reprapperMC/kangaroopaw/production_parts/electronics/chassis_assembly/AS-CB0082_revB_chassis_gnd_extension.pdf

TITLE

FILE NAME | SHEET | REV.

# Chassis GND Extension

Copyright © 2015, 2016 Aleph Objects, Inc.
Permission is granted to copy, distribute and/or modify this document under the terms of the Creative Commons Attribution 4.0 International Public License (CC BY-SA 4.0).

# Hibiscus

DRAWN BY DRAWN BY SAW | DATE 03/01/2018
CHECKED BY | DATE

12

4

14

13

## Length = 100mm

IR

Strip 5mm | Strip 4mm
AS-CB0082 | AS-CB0082_revB_chassis_gnd_extension.odg | 1

### 2x [EL-MS0141]

Term Ring Non Ins 26-22AWG #4 | 2x [EL-WR0119] – 24awg Green Wire
Strip 5mm | Strip 4mm

### 1x [PC-CN0001] Female 2pin Housing

### 2x [EL-MS0059] Female Molex Pin
