reprapperMC/kangaroopaw/production_parts/tool_head/electronics/EL-HR0190_syringe_pump_harness.pdf

TITLE

FILE NAME | SHEET | REV.

Syringe pump harness

Copyright © 2019 Aleph Objects, Inc.
Permission is granted to copy, distribute and/or modify this document under the terms of the Creative Commons Attribution 4.0 International Public License (CC BY-SA 4.0).
IR EL-HR0190_syringe_pump_harness.odg | 1

6x
[EL-MS0480]
CONN TERM MALE
20-24AWG TIN
(Micro-Fit 3.0™)

1x [PC-CN0101]
Molex-CONN PLUG 20POS
3MM VERT DUAL, BLACK

1 11

2

3 | 13
4 | 14
5 | 15
6 | 16
7 | 17
8 | 18

Pin 1

12

| 9 | 19
Length = 110mm | 10 | 20

Pin 4

Strip 2.5mm | [EL-WR0103] – 24awg Red Wire

[EL-WR0105] – 24awg Black Wire

Strip 3mm

Pin 6

[EL-WR0107] – 24awg White Wire

[EL-WR0119] – 24awg Green Wire
Pin 3

Pin 1

Pin 11

Pin 1

Pin 12

Pin 2

4x [EL-MS0564]
Molex, Conn Socket, 24-30AWG Crimp, Tin

kangaroopaw

DRAWN BY DRAWN BY Tutley | DATE 07/02/2019
CHECKED BY | DATE
Rev | Date | Changes | Change by

EL-HR0190

Pin 10
Pin 20

2x [EL-MS0142]
Conn Recept Faston 22-26AWG

Length = 205mm
Strip 6mm | Strip 3mm

1x [EL-MS0563]
Molex, Connector Receptacle, 6 position

2x [EL-WR0120] – 24awg Purple Wire

AO P/n | qty | unit | Supplier | supplier P/n
EL-WR0120 | 410 | mm | allcable allcable | HU1569247VT HU1569247RD
EL-WR0103 | 110 | mm
EL-WR0107 | 110 | mm | allcable allcable | HU1569247WE
EL-WR0119 | 110 | mm | | HU1569247GN
EL-WR0105 | 110 | mm | allcable | HU1569247BK
EL-MS0142 | 2 | pce | TTI | 7-520365-2
EL-MS0563 | 1 | pce | DigiKey Corp | 0510650600
EL-MS0564 | 4 | pce | DigiKey Corp | 0502128000
EL-MS0480 | 6 | pce | TTI | 43031-0001
PC-CN0101 | 1 | pce | TTI | 43020-2001
