reprapperMC/kangaroopaw/production_docs/BoM_7.8.19_purchasing_review.ods

Product Reference | Product Name | Quantity | Unit of Measure | BoM Reference | Manufacturer | Manufacturer Ref. | Distributor | Distributor Ref. | Distr. UOM | Price per Unit | Price per BoM Qty
AS-CB0069 | [AS-CB0069] Z brake power harness | 1 | PCE |  |  |  | CCX Corp.(DO NOT USE) |  | PCE | 15.00 USD/PCE | 15.00 USD
AS-CB0070 | [AS-CB0070] Z brake motor harness- Hibiscus | 1 | PCE |  |  |  | CCX Corp.(DO NOT USE) |  | PCE | 10.00 USD/PCE | 10.00 USD
AS-CB0071 | [AS-CB0071] Bed Harnesses- Hibiscus | 1 | PCE
AS-CB0072 | [AS-CB0072] YZ Harness- Hibiscus | 1 | PCE |  |  |  | CCX Corp.(DO NOT USE) |  | PCE | 30.00 USD/PCE | 30.00 USD
AS-CB0073 | [AS-CB0073] Mini Plug to SW Extension Harness Assembly - Hibiscus | 1 | PCE |  |  |  | CCX Corp.(DO NOT USE) |  | PCE | 40.00 USD/PCE | 40.00 USD
AS-CB0074 | [AS-CB0074] Mini PS to EinsyRetro Red Wire | 2 | PCE |  |  |  | CCX Corp.(DO NOT USE) |  | PCE | 30.00 USD/PCE | 60.00 USD
AS-CB0075 | [AS-CB0075] Earth Ground Extension Wire Harness- Hibiscus | 1 | PCE |  |  |  | CCX Corp.(DO NOT USE) |  | PCE | 10.00 USD/PCE | 10.00 USD
AS-CB0076 | [AS-CB0076] Mini SW to PS - Black Wire Extension Harness Assembly - Hibiscus | 1 | PCE |  |  |  | CCX Corp.(DO NOT USE) |  | PCE | 10.00 USD/PCE | 10.00 USD
AS-CB0077 | [AS-CB0077] Mini SW to PS - White Wire Extension Harness Assembly – Hibiscus | 1 | PCE |  |  |  | CCX Corp.(DO NOT USE) |  | PCE | 10.00 USD/PCE | 10.00 USD
AS-CB0078 | [AS-CB0078] Case Fan Harness- Hibiscus | 1 | PCE |  | Yageo | CC1206JKX7R7BB105
AS-CB0079 | [AS-CB0079] Plug to Ground Post Extension- Hibiscus | 1 | PCE |  |  |  | CCX Corp.(DO NOT USE) |  | PCE | 10.00 USD/PCE | 10.00 USD
AS-CB0080 | [AS-CB0080] PS to Ground Post Extension- Hibiscus | 1 | PCE |  |  |  | CCX Corp.(DO NOT USE) |  | PCE | 10.00 USD/PCE | 10.00 USD
AS-CB0081 | [AS-CB0081] Mini PS to EinsyRetro Black Wire | 2 | PCE |  |  |  | CCX Corp.(DO NOT USE) |  | PCE | 10.00 USD/PCE | 20.00 USD
AS-CB0082 | [AS-CB0082] Chassis Ground Extension Wire Harness | 1 | PCE |  |  |  | CCX Corp.(DO NOT USE) |  | PCE | 10.00 USD/PCE | 10.00 USD
AS-EL0003 | [AS-EL0003] Z-Motor Brake Assembled | 1 | PCE
AS-HB0005 | [AS-HB0005] Mini Etched Modular Print Bed Heater | 1 | PCE |  |  |  | TEMPCO ELECTRIC HEATER CORP | SHS80986 | PCE | 28.35 USD/PCE | 28.35 USD
DC-LB0063 | [DC-LB0063] Modification Warning Insert Modification 2.75 x 8.5 on 100 lb. Astrobright Lift Off Lemon Very Bright | 1 | PCE |  |  |  | Coren Printing Inc. |  | PCE | 0.09 USD/PCE | 0.09 USD
DC-LB0095 | [DC-LB0095] LulzBot Logo Sticker, 3 - Inch | 1 | PCE |  |  |  | Sticker Giant |  | PCE | 0.25 USD/PCE | 0.25 USD
DC-LB0121 | [DC-LB0121] Save your Mini Packaging Sticker | 1 | PCE |  | MaverickLabel |  | MaverickLabel |  | PCE | 0.09 USD/PCE | 0.09 USD
DC-LB0146 | [DC-LB0146] Mini 2 Certification Sticker | 1 | PCE |  |  |  | MyAssetTag.com | Q-MAT-P-00337 | PCE | 5.38 USD/PCE | 5.38 USD
DC-LB0150 | [DC-LB0150] Mini 2 NA Serial Number Sticker, Tamper Evident | 1 | PCE
DC-LB0153 | [DC-LB0153] Electrical Symbol Labels-On-A-Roll - Protective Earth | 1 | PCE |  |  |  | SETON | 78082 | pkg, 500 | 0.13 USD/PCE | 0.13 USD
DC-LB0156 | [DC-LB0156] Mini 2 Electric Warning Sticker | 1 | PCE
DC-LB0174 | [DC-LB0174] P65 Warning Label | 1 | PCE |  |  |  | Amazon | B07G4KF2P2 | PCE | 13.29 USD/PCE | 13.29 USD
DC-MS0066 | [DC-MS0066] Quick Start Quide, Mini 2 | 1 | PCE |  |  |  | Color Pro |  | PCE | 2.13 USD/PCE | 2.13 USD
DC-MS0069 | [DC-MS0069] EC Declaration of Conformity, Mini 2 | 1 | PCE |  |  |  | Coren Printing Inc. |  | PCE | 0.19 USD/PCE | 0.19 USD
DC-MS0070 | [DC-MS0070] Packing List, Mini 2 | 1 | PCE |  |  |  | Coren Printing Inc. |  | PCE | 0.19 USD/PCE | 0.19 USD
DC-MS0071 | [DC-MS0071] Quality Assurance Record, Mini 2 | 1 | PCE |  |  |  | Coren Printing Inc. |  | PCE | 0.31 USD/PCE | 0.31 USD
DC-MS0072 | [DC-MS0072] Safety Warning Sheet, Mini 2 | 1 | PCE |  |  |  | Coren Printing Inc. |  | PCE | 0.11 USD/PCE | 0.11 USD
EL-CA0030 | [EL-CA0030] North American - 6ft 18AWG Power Cord Cable w/ 3 Conductor PC Power Connector Socket (C13/5-15P) - Black, 5279 | 1 | PCE |  |  | 3271V86 | Linvox | 3271V86 | PCE | 1.33 USD/PCE | 1.33 USD
EL-CA0063 | [EL-CA0063] 6ft Tripp Lite - USB 2.0 A/B Gold Device Cable Ferrite Chokes A Male B Male | 1 | PCE |  |  | U023-006 | Electronics Distributors Corp. | U023-006 | PCE | 3.21 USD/PCE | 3.21 USD
EL-CA0078 | rainbow ribbon cable | 620 | mm | May need to add 150mm for noise supression
EL-FA0045 | [EL-FA0045] Pelonis FAN 80x80x15 High flow | 1 | PCE |  | Pelonis Technologies, Inc. | C8015H24BPLP1b-7 | Pelonis Technologies, Inc. | C8015H24BPLP1b-7 | PCE | 3.88 USD/PCE | 3.88 USD
EL-HR0102 | [EL-HR0102] Mini Bed Harness Assembly - revG | 1 | PCE |  | Igus, Inc. |  | Igus, Inc. |  | PCE | 29.58 USD/PCE | 29.58 USD
EL-HR0108 | [EL-HR0108] Mini X Extruder Harnesses Assembly - revG | 1 | PCE |  | Igus, Inc. |  | Igus, Inc. |  | PCE | 73.26 USD/PCE | 73.26 USD
EL-HR0109 | [EL-HR0109] Finger Guard 80mm Plastic | 1 | PCE |  | Qualtek | 09080-G | Digi-Key Corp | CR282-ND | PCE | 0.30 USD/PCE | 0.30 USD
EL-HR0130 | [EL-HR0130] Mini X Extruder Harnesses Assembly | 1 | PCE |  | Igus, Inc. |  | Igus, Inc. |  | PCE | 84.00 USD/PCE | 84.00 USD
EL-HR0135 | [EL-HR0135] Mini 2 Bed Harness Igus | 1 | PCE |  |  |  | Igus, Inc. |  | PCE | 32.00 USD/PCE | 32.00 USD
EL-HR0188 | ribbon cable1 | 1
EL-HR0189 | ribbon cable 2, split | 1
EL-HR0190 | Syringe pump Harness
EL-HR0191 | lcd ground cable | 1
EL-MS0059 | [EL-MS0059] Molex-CONN TERM FEMALE 22-24AWG TIN Reels of 20K | 29 | PCE |  | Molex | 16-02-0086 | TTI Global Distribution | 16-02-0086 | PCE | 0.02 USD/PCE | 0.03 USD
EL-MS0062 | [EL-MS0062] MOLEX-CONN HOUSING 4POS .100 W/LATCH | 5 | PCE |  |  | 050579404 | Sager Electronics | 050579404 | PCE | 0.06 USD/PCE | 0.12 USD
EL-MS0073 | [EL-MS0073] Tubing Corrugated Loom .25", Black, 3200' Box | 95 | cm |  |  | 88-00011 | Electronics Distributors Corp. | 88-00011 | ft, 200 | 0.00 USD/mm | 0.22 USD
EL-MS0141 | [EL-MS0141] Term Ring Non Ins 26-22AWG #4 Order Bulk Only | 12 | PCE |  | Panduit | P22-4R-M | TTI Global Distribution | P22-4R-M | PCE | 0.06 USD/PCE | 0.12 USD
EL-MS0142 | purple fast on connector | 2
EL-MS0143 | [EL-MS0143] Conn Fast Receptacle14-16 AWG .250 - REEL of 2200 Units | 7 | PCE |  | TE Amp | 3-350819-2 | TTI Global Distribution | 3-350820-2 | PCE | 0.07 USD/PCE | 0.28 USD
EL-MS0205 | [EL-MS0205] Molex-CONN TERM MALE 22-24AWG TIN - Reels of 20K | 2 | PCE |  | Molex | 16-02-0107 | TTI Global Distribution | 16-02-0107 | PCE | 0.02 USD/PCE | 0.04 USD
EL-MS0211 | [EL-MS0211] TE- REEL / RING TONGUE CONN 16-22 AWG #10 PIDG | 5 | PCE |  |  |  | Sager Electronics | 2-36154-2 | PCE | 0.09 USD/PCE | 0.09 USD
EL-MS0216 | [EL-MS0216] Steward-Ferrite Tubular Bead 19.00mm | 1 | PCE |  |  |  | Sager Electronics | 28B1142-100 | PCE | 0.30 USD/PCE | 0.30 USD
EL-MS0246 | [EL-MS0246] Conn Ring 16-22 AWG #4 Red PIDG - Reel 5000 | 1 | PCE |  | TE Connectivity | 2-323758-1 | TTI Global Distribution | 2-323758-1 | PCE | 0.41 USD/PCE | 0.41 USD
EL-MS0246 | [EL-MS0246] Conn Ring 16-22 AWG #4 Red PIDG - Reel 5000 | 1 | PCE |  | TE Connectivity | 2-323758-1 | TTI Global Distribution | 2-323758-1 | PCE | 0.41 USD/PCE | 0.41 USD
EL-MS0247 | [EL-MS0247] Heat Shrink Tubing – 0.19-0.09 – Black, 100' | 25 | mm |  | 3M | 88-01870 | Electronics Distributors Corp. | 88-01870 | PCE, 100' | 0.00 USD/mm | 0.02 USD
EL-MS0259 | [EL-MS0259] Heat Shrink DL WL Q53X 3/4" | 7 | cm |  | Qualtek | Q5-3X-3/4-01-QB48IN-5 | Electronics Distributors Corp. | 67-30751 | PCE ft, 4 | 0.00 USD/mm | 0.32 USD
EL-MS0343 | [EL-MS0343] Ferrite Tubular Bead 10.16MM | 1 | PCE |  | Laird Technologies | 28B0735-000 | Sager Electronics | 28B0735-000 | PCE | 0.26 USD/PCE | 0.26 USD
EL-MS0351 | [EL-MS0351] JST - CONN TERM CRIMP PH 24-30AWG - 8,000 Unit Reel | 12 | PCE |  | JST Sales America | SPH-002T-P0.5S | Future Electronics |  | PCE | 0.01 USD/PCE | 0.15 USD
EL-MS0355 | [EL-MS0355] CONN HOUSING PH 6POS 2MM WHITE | 3 | PCE |  | JST Sales America | PHR-6 | Future Electronics | PHR-6 | PCE | 0.04 USD/PCE | 0.12 USD
EL-MS0414 | [EL-MS0414] Cartridge Fuse 250V 3.15A Slo-Blo | 2 | PCE |  | Littelfuse | 02153.15MXP | TTI Global Distribution | 576-02153.15MXP | PCE | 0.39 USD/PCE | 0.77 USD
EL-MS0418 | 10 pos molex | 1
EL-MS0432 | [EL-MS0432] Clip-On EMI Shielding Gasket 150.876mm length | 1 | PCE |  | TECH-ETCH, Inc. | 187RF1C100-5.94-L-08 | Tech Etch AP | 187RF1C100-5.94-L-08 | PCE | 2.36 USD/PCE | 2.36 USD
EL-MS0434 | [EL-MS0434] Heat Shrink Tubing – 0.19-0.09 – Red, 250' | 25 | mm |  |  | 88-01872 | Electronics Distributors Corp. | 88-01872 | ft, 250 | 0.00 USD/mm | 0.02 USD
EL-MS0479 | [EL-MS0479] CONN TERM FEMALE 20-24AWG TIN (Micro-Fit 3.0™) 12K REEL | 16 | PCE |  | Molex | 43030-0001 | TTI Global Distribution | 43030-0001 | PCE | 0.02 USD/PCE | 0.27 USD
EL-MS0480 | molex microfit 3.0 male pin | 6
EL-MS0497 | [EL-MS0497] CONN SPADE TERM 16-22AWG #6 RED | 4 | PCE |  | TE Connectivity | 2-34541-1 | TTI Global Distribution | 2-34541-1 | PCE | 0.10 USD/PCE | 0.21 USD
EL-MS0502 | [EL-MS0502] CONN SPADE TERM 24-26AWG #6 YEL | 2 | PCE |  | TE Connectivity | 53115-2 | TTI Global Distribution | 53115-2 | PCE | 0.51 USD/PCE | 1.01 USD
EL-MS0559 | Lcd 4.3 inch | 1
EL-MS0563 | Molex, Connector Receptacle, 6 position | 1
EL-MS0564 | Molex, Conn Socket, 24-30AWG Crimp, Tin | 4
EL-MT0029 | [EL-MT0029] NEMA 17 Stepper Motor, Moons' - NOT INCLUDING wire harness | 4 | PCE |  |  | MS17HD6P4150-01-B | Moons' Industries (America), Inc. | MS17HD6P4150-01-B | PCE | 8.30 USD/PCE | 8.30 USD
EL-MT0063 | Nema 11 motor | 1 |  |  | needs replaced w/ kangaroopaw specific part
EL-PS0025 | [EL-PS0025] DELTA POWER SUP 150W 24V 6.25A PNL MT | 1 | PCE |  | Delta Electronics (Americas) Ltd. | PMC-24V150W1AA | Delta Electronics (Americas) Ltd. | PMC-24V150W1AA | PCE | 20.65 USD/PCE | 20.65 USD
EL-SW0022 | [EL-SW0022] SWITCH BASIC SPDT 3A .110QC 125V | 2 | PCE |  | Omron | SS-3GPT | TTI Global Distribution | SS-3GPT | PCE | 0.42 USD/PCE | 0.42 USD
EL-SW0049 | [EL-SW0049] Rocker Switch DPST 20A (AC) 125V Panel Mount, Snap-In | 1 | PCE |  | E Switch | R5BBLKREDFF2 | Heilind | R5BBLKREDFF2 | PCE | 1.45 USD/PCE | 1.45 USD
EL-WR0099 | [EL-WR0099] Shielded 22AWG UL2464 4 COND | 179.5 | cm |  |  |  | Allcable | C0762A.41.10 | ft, 1000 | 0.00 USD/mm | 0.10 USD
EL-WR0103 | [EL-WR0103] 24AWG Stranded – Red | 126 | cm |  |  |  | Allcable | HU1569247RD | ft, 1000 | 0.00 USD/mm | 0.01 USD
EL-WR0105 | [EL-WR0105] 24AWG Stranded – Black | 126 | cm |  |  |  | Allcable | HU1569247BK | ft, 1000 | 0.00 USD/mm | 0.01 USD
EL-WR0105 | Black 24 ga wire | ? | mm | need to figure out what mark wants to do here
EL-WR0106 | [EL-WR0106] 16AWG Stranded – Red | 20 | cm |  |  |  | Allcable | HU15691626RD | ft, 1000 | 0.00 USD/mm | 0.06 USD
EL-WR0107 | 24 ga white wire | 110 | mm
EL-WR0119 | [EL-WR0119] 24AWG Stranded Wire – Green | 150 | cm |  |  |  | Allcable | HU1569247GN | ft, 1000 | 0.00 USD/mm | 0.02 USD
EL-WR0120 | 24 ga purple wire | 410 | mm
EL-WR0121 | [EL-WR0121] 16AWG Stranded Wire – Black | 102 | cm |  |  |  | Allcable | HU15691626BK | ft, 1000 | 0.00 USD/mm | 0.16 USD
EL-WR0123 | [EL-WR0123] 16AWG Stranded Wire – White | 82 | cm |  |  |  | Allcable | HU15691626WE | ft, 1000 | 0.00 USD/mm | 0.16 USD
EL-WR0124 | [EL-WR0124] 16AWG Stranded – Green w/ yellow stripe | 130 | mm |  |  |  | Allcable | HU15691626GN | ft, 1000 | 0.00 USD/mm | 0.03 USD
HD-BL0033 | [HD-BL0033] 744-2P06-2MR-744-06 / GT 3 Single Sided Neoprene Belt - 744mm by 6mm belt | 4 | PCE |  |  |  | B & B Manufacturing, Inc | 744-2P06-2MR-744-06 | PCE | 2.06 USD/PCE | 2.06 USD
HD-BT0005 | M3x10mm SHCS black oxide | 3
HD-BT0012 | [HD-BT0012] M3 Set Screw (Grub Screw) | 6 | PCE |  |  | 40818 | Fastenal | 40818 | PCE | 0.03 USD/PCE | 0.05 USD
HD-BT0039 | [HD-BT0039] Metric Class 12.9 Socket Head Cap Screw, Alloy Steel, M3 Thread, 12MM Length, 0.50MM Pitch | 4 | PCE |  |  | 39505 | Hardware Speciality | DIN912-12.9-3-12 | PCE | 0.02 USD/PCE | 0.09 USD
HD-BT0082 | [HD-BT0082] Metric 18-8 SS Flat Head Socket Cap Screw M3 Size, 16mm Length, .50mm Pitch | 11 | PCE |  |  |  | Hardware Speciality | DIN7991A2-3-16 | PCE | 0.02 USD/PCE | 0.10 USD
HD-BT0104 | [HD-BT0104] M3 x 8 Bolt, BHCS, SST | 5 | PCE |  |  | MB2510008A20000 | Hardware Speciality | ISO7380-A2-3-8 | PCE | 0.02 USD/PCE | 0.02 USD
HD-BT0104 | [HD-BT0104] M3 x 8 Bolt, BHCS, SST | 4 | PCE |  |  | MB2510008A20000 | Hardware Speciality | ISO7380-A2-3-8 | PCE | 0.02 USD/PCE | 0.08 USD
HD-BT0107 | [HD-BT0107] Metric Class 12.9 Socket Head Cap Screw Alloy Steel, Black, M2 Thread, 10mm Length, 0.4mm Pitch | 8 | PCE |  |  | 0134599 | Fastenal | 0134599 | PCE | 0.02 USD/PCE | 0.09 USD
HD-BT0116 | [HD-BT0116] Black Alloy Steel Flat-Head Socket Cap Screw, Class 10.9, M3 Size, 10mm Length, .50mm Pitch | 2 | PCE |  |  |  | Hardware Speciality | DIN7991-10.9-3-10 | PCE | 0.03 USD/PCE | 0.05 USD
HD-BT0117 | [HD-BT0117] Black Alloy Steel Flat-Head Socket Cap Screw, Class 10.9, M8 Size, 40mm Length, 1.25mm Pitch | 1 | PCE |  |  | 1139965 | Fastenal | 1139965 | PCE | 0.14 USD/PCE | 0.14 USD
HD-BT0119 | M3x8mm FHCS black oxide | 2
HD-BT0128 | [HD-BT0128] M3 x 6 Bolt, FHCS Black-Oxide | 83 | PCE |  |  | 40921 | Hardware Speciality | DIN7991-10.9-3-6 | PCE | 0.03 USD/PCE | 0.10 USD
HD-BT0130 | [HD-BT0130] M3 x 8 Bolt, FHCS Black-Oxide | 2 | PCE |  |  |  | Hardware Speciality | DIN7991-10.9-3-8 | PCE | 0.03 USD/PCE | 0.06 USD
HD-BT0135 | [HD-BT0135] M3 x 25 Bolt FHCS, Black-Oxide, Partially Threaded | 4 | PCE |  |  | 40929 | Fastenal | 40929 | PCE | 0.03 USD/PCE | 0.14 USD
HD-BT0137 | [HD-BT0137] M3 x 8 Bolt, BHCS, Black-Oxide | 44 | PCE |  |  | 40868 | Hardware Speciality | ISO7380-10.9-3-8 | PCE | 0.03 USD/PCE | 0.08 USD
HD-BT0140 | [HD-BT0140] M3 x 6 Bolt, BHCS Black-Oxide | 14 | PCE |  |  | 408674 | Hardware Speciality | ISO7380-10.9-3-6 | PCE | 0.02 USD/PCE | 0.10 USD
HD-BT0146 | [HD-BT0146] M3 x 12 BHCS, Black Oxide, Class 10.9 Steel | 13 | PCE |  |  |  | Hardware Speciality | ISO7380-10.9-3-12 | PCE | 0.02 USD/PCE | 0.05 USD
HD-BT0157 | M3x8mm SHCS black oxide | 5
HD-BT0204 | [HD-BT0204] Black-Oxide Alloy Steel Hex Drive Flat Head Screw M3 x 0.5 mm Thread, 22 mm Long | 1 | PCE |  |  |  | Hardware Speciality | DIN7991-10.9-3-22 | PCE | 0.05 USD/PCE | 0.05 USD
HD-BT0206 | [HD-BT0206] Black-Oxide Alloy Steel Hex Drive Flat Head Screw M3 x 0.5 mm Thread, 25 mm Long | 2 | PCE |  |  |  | Hardware Speciality | DIN7991-10.9-3-25 | pkg, 50 | 0.00 USD/PCE | 0.00 USD
HD-BT0210 | [HD-BT0210] Blue-Dyed Zinc-Plated Alloy Steel Socket Head Screw M3 x 0.5 mm Thread, 30 mm Long | 1 | PCE |  |  |  | Hardware Speciality | DIN912-12.9-3-30ZPTBLUE | pkg, 50 | 0.00 USD/PCE | 0.00 USD
HD-BT0211 | [HD-BT0211] Blue-Dyed Zinc-Plated Alloy Steel Socket Head Screw M3 x 0.5 mm Thread, 8 mm Long | 2 | PCE |  |  |  | Hardware Speciality | DIN912-12.9-3-8ZPTBLUE | pkg, 100 | 0.00 USD/PCE | 0.00 USD
HD-BT0216 | [HD-BT0216] Black-Oxide Alloy Steel Hex Drive Flat Head Screw M5 x 0.8 mm Thread, 40 mm Long | 1 | PCE |  |  |  | Hardware Speciality |  | PCE | 0.22 USD/PCE | 0.22 USD
HD-BT0244 | M2x6mm FHCS black oxide | 4
HD-BU0046 | [HD-BU0046] Drylin® Precision, Polymer 8 mm Bearing RJMP-01-08 | 12 | PCE |  | Igus, Inc. | RJMP-01-08 | Igus, Inc. | RJMP-01-08 | PCE | 1.26 USD/PCE | 1.26 USD
HD-BU0050 | 6mm sleeve bushing JSM-0607-12.5 | 1
HD-MS0030 | [HD-MS0030] Metric Brass Heat-Set Insert for Plastics Tapered, M3-.5 Internal Thread, 3.8mm Length | 107 | PCE |  |  |  | Aero-Space Fasteners and Hardware (formerly Colorado Electronic Hardware) | PEM IUBB-M3-1 | PCE | 0.04 USD/PCE | 0.14 USD
HD-MS0033 | [HD-MS0033] GT2, 16 Teeth, timing pulley, AL | 4 | PCE |  |  |  | B & B Manufacturing, Inc | 16-2P06M6CA5 | PCE | 2.90 USD/PCE | 2.90 USD
HD-MS0054 | [HD-MS0054] Bumper Square, rubber | 4 | PCE |  |  |  | Hardware Speciality | BS-19/BLACK | PCE | 0.09 USD/PCE | 0.34 USD
HD-MS0058 | [HD-MS0058] Wire Tie, 8" Black, pk 1000 | 19 | PCE |  |  | APU-08-18-0-M | Electronics Distributors Corp. | 17-01125 | pkg, 1000 | 0.02 USD/PCE | 0.08 USD
HD-MS0211-1 | [HD-MS0211-1] Mini - Borosilicate Glass Bed 170mm x 170mm x +/-.76mm (6.693" x 6.693" +/-.030) Edges Ground and Chamfered | 1 | PCE |  |  |  | Allen Scientific Glass, Inc. | ASG3107 | PCE | 7.72 USD/PCE | 7.72 USD
HD-MS0230 | [HD-MS0230] Black Class 12.9 Socket Head Cap Screw, Alloy Steel, M2 Thread, 6mm Length, 0.4mm Pitch | 4 | PCE |  |  | 0134596 | Hardware Speciality | DIN912-12.9-2-6BL | PCE | 0.02 USD/PCE | 0.10 USD
HD-MS0230 | [HD-MS0230] Black Class 12.9 Socket Head Cap Screw, Alloy Steel, M2 Thread, 6mm Length, 0.4mm Pitch | 4 | PCE |  |  | 0134596 | Hardware Speciality | DIN912-12.9-2-6BL | PCE | 0.02 USD/PCE | 0.10 USD
HD-MS0249 | [HD-MS0249] UV-Resistant Cable Tie Holder, Adhesive Back/Screw Mount, 4-Way, for.18" Maximum Tie, Black | 4 | PCE |  |  | 56-07035 | Hardware Speciality | ABM100-AT-D0FTH-7A-RT-UVB-M | pkg, 500 | 0.00 USD/PCE | 0.00 USD
HD-MS0282 | [HD-MS0282] 608-2RS ABEC3/C3 Rubber Sealed Bearing - BLACK | 2 | PCE |  | JSB Great Bearings | 608-2RS ABEC3/C3 | JSB Great Bearings | 608-2RS ABEC3/C3 | PCE | 0.42 USD/PCE | 0.84 USD
HD-MS0287 | [HD-MS0287] Metric 18-8 Stainless Steel Unthreaded Spacer, 8mm OD, 10mm Length, M3 Screw Size | 4 | PCE |  |  |  | Hardware Speciality | M0599-3-SS | PCE | 0.46 USD/PCE | 1.84 USD
HD-MS0411 | [HD-MS0411] 625-2RS Premium Two Side Rubber Sealed Bearing ABEC3 | 2 | PCE |  |  |  | JSB Great Bearings | 625-2RS V2+ | PCE | 0.70 USD/PCE | 1.40 USD
HD-MS0412 | [HD-MS0412] Smooth Idler Pulley Wheel Kit | 2 | PCE |  |  |  | OpenBuilds Part Store | 550 | PCE | 2.81 USD/PCE | 2.81 USD
HD-MS0463 | [HD-MS0463] Insul-Fab Fujipoly Thermal Gap Filler, 70 pc sheet | 2 | PCE |  |  |  | InsulFab | ALEO HD-MS0463 | PCE | 0.62 USD/PCE | 1.24 USD
HD-MS0470 | 623 bearing | 2
HD-MS0550 | [HD-MS0550] Synthetic Felt Plain Backing, 1" Wide, 1/4" Thick - 50 ft | 600 | inch(es) |  |  |  | McMaster-Carr | 88085K311 | ft, 50 | 0.04 USD/inch(es) | 24.00 USD
HD-NT0001 | [HD-NT0001] Metric Zinc-Plated Steel Nylon-Insert Locknut, Class 8, M3 Screw sz, .5MM pitch, 5.5MM W, 4MM H | 2 | PCE |  |  | 40143 | Fastenal | 40143 | PCE | 0.01 USD/PCE | 0.02 USD
HD-NT0002 | [HD-NT0002] M8 Nyloc Nut, Zinc Plated | 14 | PCE |  |  | 40163 | Fastenal | 40163 | PCE | 0.03 USD/PCE | 0.03 USD
HD-NT0057 | [HD-NT0057] 18-8 Stainless Steel Nylon-Insert Locknut M5 x 0.8 mm Thread | 1 | PCE |  |  |  | Fastenal | 1L2540000A20000 | pkg, 100 | 0.12 USD/PCE | 0.12 USD
HD-NT0359 | leadscrew nut, standard, inch flanged, 3/16” x 0.20 | 1
HD-RD0035 | [HD-RD0035] 8mm Smooth rod, 315mm, 300 Series Stainless Steel | 8 | PCE |  | Igus, Inc. | EWMR-08-315X | Igus, Inc. | EWMR-08-315X | PCE | 5.26 USD/PCE | 10.52 USD
HD-RD0068 | [HD-RD0068] 18-8 Stainless Steel Dowel Pin 1mm Diameter, 20mm Long | 6 | PCE |  |  |  | Hardware Speciality | ISO2338-A1M6-1-20 | pkg, 50 | 0.00 USD/PCE | 0.00 USD
HD-RD0076 | 99mm Leadscrew (milled) | 1
HD-RD0077 | 90mm smooth rod (milled) | 1
HD-TB0066 | [HD-TB0066] Flexible Polyolefin Heat Shrink Tubing 1/8" ID Before, 1/16" ID After, 100' L, Black | 535 | mm |  |  |  | Electronics Distributors Corp. | 88-01250 | PCE, 100' | 0.00 USD/mm | 0.34 USD
HD-WA0006 | [HD-WA0006] M8 Washer, Steel, Zinc Plated | 3 | PCE |  |  |  | Hardware Speciality | DIN125A-ST8ZPT | PCE | 0.01 USD/PCE | 0.03 USD
HD-WA0012 | [HD-WA0012] Steel Flat Washer, DIN 125 zinc-plated class 4,M2 screw sz, 5mm OD, .25mm-.35mm thick | 16 | PCE |  |  | 40350 | Hardware Speciality | DIN125A-ST2ZPT | PCE | 0.01 USD/PCE | 0.04 USD
HD-WA0035 | [HD-WA0035] Metric 18-8 Stainless Steel External Serrated Lock Washer, M3 Screw Size, 6mm OD, 0.4mm min Thick | 6 | PCE |  |  | 11511313 | Hardware Speciality | DIN6798A-A2-3 | PCE | 0.01 USD/PCE | 0.05 USD
HD-WA0038 | [HD-WA0038] Black-Oxide 18-8 Steel Flat Washer, M3 Screw Size, 3.2mm ID, 7.0mm OD | 85 | PCE |  |  |  | Hardware Speciality | DIN125A-A2-3BL | PCE | 0.01 USD/PCE | 0.04 USD
PC-AS0054 | [PC-AS0054] Einsy Retro Board | 1 | PCE |  |  |  | Ultimachine | Einsy | PCE | 58.69 USD/PCE | 58.69 USD
PC-BD0096 | [PC-BD0096] Z Brake, Assembly | 1 | PCE |  |  |  | Ultimachine |  | PCE | 9.58 USD/PCE | 9.58 USD
PC-BD0114 | usb board | 1
PC-BD0117 | lcd board | 1
PC-CN0001 | [PC-CN0001] Molex-Conn Housing 2POS .100 W/Latch | 1 | PCE |  | Molex | 050579402 | Sager Electronics | 050579402 | PCE | 0.06 USD/PCE | 0.06 USD
PC-CN0001 | [PC-CN0001] Molex-Conn Housing 2POS .100 W/Latch | 1 | PCE |  | Molex | 050579402 | Sager Electronics | 050579402 | PCE | 0.06 USD/PCE | 0.06 USD
PC-CN0001 | [PC-CN0001] Molex-Conn Housing 2POS .100 W/Latch | 1 | PCE |  | Molex | 050579402 | Sager Electronics | 050579402 | PCE | 0.06 USD/PCE | 0.06 USD
PC-CN0003 | [PC-CN0003] Molex - CONN HOUSING 3POS .100 W/LATCH | 2 | PCE |  | Molex | 50-57-9403 | TTI Global Distribution | 0050579403 | PCE | 0.06 USD/PCE | 0.12 USD
PC-CN0003 | [PC-CN0003] Molex - CONN HOUSING 3POS .100 W/LATCH | 3 | PCE |  | Molex | 50-57-9403 | TTI Global Distribution | 0050579403 | PCE | 0.06 USD/PCE | 0.18 USD
PC-CN0003 | [PC-CN0003] Molex - CONN HOUSING 3POS .100 W/LATCH | 1 | PCE |  | Molex | 50-57-9403 | TTI Global Distribution | 0050579403 | PCE | 0.06 USD/PCE | 0.06 USD
PC-CN0010 | ribbon cable 10pos connector | 2
PC-CN0010 | ribbon cable 10pos connector | 2
PC-CN0099 | [PC-CN0099] CONN RECEPT 20POS 3MM DUAL ROW | 1 | PCE |  | Molex | 0430252000 | TTI Global Distribution | 43025-2000 | PCE | 0.36 USD/PCE | 0.36 USD
PC-CN0101 | molex microfit male housing, 20 pos | 1
PP-FP0138 | [PP-FP0138] Silk Screened Bed Mount Plate, Mini | 1 | PCE |  |  |  | Epocs Manufacturing | PP-FP0138 | PCE | 17.25 USD/PCE | 17.25 USD
PP-FP0167 | [PP-FP0167] Kangaroo Paw, Mini Electronics Case - White | 1 | PCE |  |  |  | Epocs Manufacturing |  | PCE | 21.50 USD/PCE | 21.50 USD
PP-FP0168 | [PP-FP0168] Kangaroo Paw, Mini Top Plate - White | 1 | PCE |  |  |  | Weiser Engineering, Inc. |  | PCE | 19.87 USD/PCE | 19.87 USD
PP-FP0169 | [PP-FP0169] Kangaroo Paw, Mini Right Side – White | 1 | PCE |  |  |  | Weiser Engineering, Inc. |  | PCE | 11.98 USD/PCE | 11.98 USD
PP-FP0170 | [PP-FP0170] Kangaroo Paw, Mini Left Side - White | 1 | PCE |  |  |  | Weiser Engineering, Inc. |  | PCE | 18.52 USD/PCE | 18.52 USD
PP-FP0174 | laser cut hips cover | 1
PP-FP0175 | EMI gasket | 1
PP-FP0183 | polycarb laser cut screen cover | 1
PP-MP0028 | [PP-MP0028] Bulgin-AC Power Entry Modules SC MT FUSED .25" TAB | 1 | PCE |  |  | PF0030/63 | Heilind | PF0030/63 | PCE | 3.10 USD/PCE | 3.10 USD
PP-MP0059 | [PP-MP0059] CONN HOUSING MALE 2POS .100 | 1 | PCE |  |  |  | TTI Global Distribution | 0701070001 | PCE | 0.12 USD/PCE | 0.12 USD
PP-MP0066 | [PP-MP0066] Metric Brass Heat-Set Insert for Plastics, Tapered, M2-.4 Internal Thread, 2.9MM Length | 4 | PCE |  |  |  | Aero-Space Fasteners and Hardware (formerly Colorado Electronic Hardware) | PEM ZZIUB-48213 | PCE | 0.05 USD/PCE | 0.20 USD
PP-MP0066 | [PP-MP0066] Metric Brass Heat-Set Insert for Plastics, Tapered, M2-.4 Internal Thread, 2.9MM Length | 8 | PCE |  |  |  | Aero-Space Fasteners and Hardware (formerly Colorado Electronic Hardware) | PEM ZZIUB-48213 | PCE | 0.05 USD/PCE | 0.40 USD
PP-MP0066 | [PP-MP0066] Metric Brass Heat-Set Insert for Plastics, Tapered, M2-.4 Internal Thread, 2.9MM Length | 4 | PCE |  |  |  | Aero-Space Fasteners and Hardware (formerly Colorado Electronic Hardware) | PEM ZZIUB-48213 | PCE | 0.05 USD/PCE | 0.20 USD
PP-MP0082 | [PP-MP0082] Bed Leveling Washer, 303 SST | 4 | PCE |  |  |  | Precision Metal Manufacturing, LLC |  | PCE | 0.92 USD/PCE | 3.68 USD
PP-MP0210 | [PP-MP0210] Heatsink Einsy | 1 | PCE |  |  |  | Colorado Waterjet |  | PCE | 1.10 USD/PCE | 1.10 USD
PP-MP0252 | KHK SW0 5 R2 worm gear | 1 |  |  | needs removed
PP-MP0253 | KHK BG0 5 30 R2 worm wheel | 1 |  |  | milled part
PP-MP0258 | [PP-MP0258] Kangaroo Paw, Mini Bottom Plate - White | 1 | PCE |  |  |  | Weiser Engineering, Inc. |  | PCE | 29.93 USD/PCE | 29.93 USD
PP-MP0277 | Upper Bearing Holder (milled) | 1 |  | TBD
PP-MP0278 | Lower Bearing Holder (milled) | 1 |  |  | updated KP part number
PP-MP0279 | Motor mount (milled) | 1 |  |  | assembly sub part
PP-MP0280 | Collar Mount flange (milled) | 1 |  |  | harness
PP-MP0281 | Carriage (milled) | 1
SH-BX0496 | [SH-BX0496] Mini 2 Carton 22x17x19 275# 51 ECT White Doublewall RSC Printed | 1 | PCE |  |  |  | Preferred Packaging Products, Inc. |  | PCE | 4.39 USD/PCE | 4.39 USD
SH-PG0002 | [SH-PG0002] 3 x 4" 2 Mil Reclosable Polypropylene Bags | 1 | PCE |  |  | S-1292 | Uline | S-1292 | pkg, 1000 | 0.02 USD/PCE | 0.02 USD
SH-PG0019 | [SH-PG0019] Avery® White Shipping Labels for Laser Printers with TrueBlock Technology, 2 Inches x 4 Inches (5963) | 1 | PCE |  |  | S-3845 | Amazon | B00006HP6D | pkg, 2500 | 0.02 USD/PCE | 0.02 USD
SH-PG0030 | [SH-PG0030] 8X10 2MIL RECLOSABLE BAG 1M/CT | 1 | PCE |  |  |  | Uline | S-1700 | pkg, 1000 | 0.05 USD/PCE | 0.05 USD
SH-PG0031 | [SH-PG0031] 2 x 3" No Print Reclosable Static Shielding Bags (ESD) | 2 | PCE |  |  |  | Uline | S-6509 | pkg, 100 | 0.13 USD/PCE | 0.26 USD
SH-PG0083 | [SH-PG0083] 9 x 12" 8 Mil Reclosable Bags | 1 | PCE |  |  |  | Uline | S-13440 | pkg, 500 | 0.29 USD/PCE | 0.29 USD
SH-PG0084 | [SH-PG0084] 6 x 10" 6 Mil Reclosable Bags | 1 | PCE |  |  |  | Uline | S-17767 | pkg, 1000 | 0.18 USD/PCE | 0.18 USD
SH-PG0131 | [SH-PG0131] #260 White Reinforced Gummed Tape with LulzBot Printed Logo, 10 Pack | 3600 | mm |  | Preferred Packaging Products, Inc. | 0815 | Preferred Packaging Products, Inc. | 0815 | Roll 450' - 10pk | 0.00 USD/mm | 3.46 USD
SH-PG0173 | [SH-PG0173] Mini 2 Print Head Stabilizer, 1.7# Black Polyethylene Foam | 1 | PCE |  |  |  | Preferred Packaging Products, Inc. |  | PCE | 4.15 USD/PCE | 4.15 USD
SH-PG0176 | [SH-PG0176] Mini 2 Top Foam, 1.7# Black Polyethylene | 1 | PCE |  |  |  | Preferred Packaging Products, Inc. |  | PCE | 8.10 USD/PCE | 8.10 USD
SH-PG0177 | [SH-PG0177] Mini 2 Bottom Foam, 1.7# Black Polyethylene | 1 | PCE |  |  |  | Preferred Packaging Products, Inc. |  | PCE | 8.10 USD/PCE | 8.10 USD
TL-HD0008 | [TL-HD0008] Stainless Steel Pocket Rule Semiflexible, Metric Grads, 150 mm Length | 1 | PCE |  |  |  | Image Supply Service, Inc. | 90013A | PCE | 1.99 USD/PCE | 1.99 USD
TL-HD0049 | [TL-HD0049] 6" Deluxe Bent Stainless Steel Tweezers with Serrated Teeth and Safety Cap | 1 | PCE |  |  |  | ROEDER INDUSTRIES INC. | TWE6 6'' Tweezers | PCE | 1.44 USD/PCE | 1.44 USD
TL-HD0050 | [TL-HD0050] 6" Long Nose Pliers | 1 | PCE |  |  |  | Electronics Distributors Corp. |  | PCE | 2.60 USD/PCE | 2.60 USD
TL-HD0468 | [TL-HD0468] 7 pc Long Arm Ball Hex Key Wrench Set (Metric) - Red | 1 | PCE |  | Bondhus | 03-HD468 | Electronics Distributors Corp. | 03-HD0468 | PCE | 5.49 USD/PCE | 5.49 USD
TL-HD0572 | M2x8mm SHCS black oxide | 2
TL-MS0572 | [TL-MS0572] Tool bag / Travel Organizer Case | 1 | PCE |  | Specialty Incentives, Inc | 0011-68 | Specialty Incentives, Inc | 0011-68 | PCE | 10.15 USD/PCE | 10.15 USD
 |  |  |  |  |  |  | TECH-ETCH, Inc. |  | PCE | 2.36 USD/PCE | 2.36 USD
 |  |  |  |  |  |  | Polymaker N. America |  | Reel, 3kg | 30.00 USD/Reel, 3kg | 0.22 USD
 |  |  |  |  |  |  |  |  |  | Total BoM Price: | 789.33 USD
 | LulzBot Goostruder Tool Head | 1
 | M2.5x14mm SHCS black oxide | 3
 | Thumbscrew 6/32 -1/2 knurled | 1
 | LCD Assembly
 | M3x6 SHCS SS | 4
 | M3x 16 BHCS | 5 |  | prototypes build with SHCS, will likely need BHCS for production
 | Additional Items
 | Syringe 81420 | 1 |  |  | https://www.hamiltoncompany.com/laboratory-products/syringes/81420
 | DOW Corning, high vacuum grease, 1oz | 1 |  |  | https://www.amazon.com/Corning-Vacuum-Grease-Lubricant-Container/dp/B00B3O2YW4
 | petri dishes
 | needles
 | FRESH material (life support)
 | sodium alginate powder
