reprapperMC/kangaroopaw/production_docs/BoM.ods

BoM Name | Level | Product Reference | Product Name | Quantity | Unit of Measure | BoM Reference | Manufacturer | Manufacturer Ref. | Distributor | Distributor Ref. | Distr. UOM | Price per Unit | Price per BoM Qty
LulzBot Mini v2.0, Boxed for Retail, NA |  | KT-PR0047NA | LulzBot Mini v2.0, Boxed for Retail, NA | 1 | PCE
 | > | AS-PR0093 | [AS-PR0093] Mini 2, Hibiscus, Calibrated | 1 | PCE
 | > > | AS-PR0092 | [AS-PR0092] Mini, Hibiscus, Final Electrical Assembly | 1 | PCE
 | > > > | AS-CB0069 | [AS-CB0069] Z brake power harness | 1 | PCE |  |  |  | CCX Corp.(DO NOT USE) |  | PCE | 15.00 USD/PCE | 15.00 USD
 | > > > > | EL-MS0059 | [EL-MS0059] Molex-CONN TERM FEMALE 22-24AWG TIN Reels of 20K | 2 | PCE |  | Molex | 16-02-0086 | TTI Global Distribution | 16-02-0086 | PCE | 0.02 USD/PCE | 0.03 USD
 | > > > > | EL-MS0502 | [EL-MS0502] CONN SPADE TERM 24-26AWG #6 YEL | 2 | PCE |  | TE Connectivity | 53115-2 | TTI Global Distribution | 53115-2 | PCE | 0.51 USD/PCE | 1.01 USD
 | > > > > | EL-WR0103 | [EL-WR0103] 24AWG Stranded – Red | 16 | cm |  |  |  | Allcable | HU1569247RD | ft, 1000 | 0.00 USD/mm | 0.01 USD
 | > > > > | EL-WR0105 | [EL-WR0105] 24AWG Stranded – Black | 16 | cm |  |  |  | Allcable | HU1569247BK | ft, 1000 | 0.00 USD/mm | 0.01 USD
 | > > > > | PC-CN0001 | [PC-CN0001] Molex-Conn Housing 2POS .100 W/Latch | 1 | PCE |  | Molex | 050579402 | Sager Electronics | 050579402 | PCE | 0.06 USD/PCE | 0.06 USD
 | > > > | AS-CB0070 | [AS-CB0070] Z brake motor harness- Hibiscus | 1 | PCE |  |  |  | CCX Corp.(DO NOT USE) |  | PCE | 10.00 USD/PCE | 10.00 USD
 | > > > > | EL-MS0059 | [EL-MS0059] Molex-CONN TERM FEMALE 22-24AWG TIN Reels of 20K | 8 | PCE |  | Molex | 16-02-0086 | TTI Global Distribution | 16-02-0086 | PCE | 0.02 USD/PCE | 0.13 USD
 | > > > > | EL-MS0062 | [EL-MS0062] MOLEX-CONN HOUSING 4POS .100 W/LATCH | 2 | PCE |  |  | 050579404 | Sager Electronics | 050579404 | PCE | 0.06 USD/PCE | 0.12 USD
 | > > > > | EL-WR0099 | [EL-WR0099] Shielded 22AWG UL2464 4 COND | 9.5 | cm |  |  |  | Allcable | C0762A.41.10 | ft, 1000 | 0.00 USD/mm | 0.10 USD
 | > > > | AS-CB0082 | [AS-CB0082] Chassis Ground Extension Wire Harness | 1 | PCE |  |  |  | CCX Corp.(DO NOT USE) |  | PCE | 10.00 USD/PCE | 10.00 USD
 | > > > > | EL-MS0059 | [EL-MS0059] Molex-CONN TERM FEMALE 22-24AWG TIN Reels of 20K | 2 | PCE |  | Molex | 16-02-0086 | TTI Global Distribution | 16-02-0086 | PCE | 0.02 USD/PCE | 0.03 USD
 | > > > > | EL-MS0141 | [EL-MS0141] Term Ring Non Ins 26-22AWG #4 Order Bulk Only | 2 | PCE |  | Panduit | P22-4R-M | TTI Global Distribution | P22-4R-M | PCE | 0.06 USD/PCE | 0.12 USD
 | > > > > | EL-WR0119 | [EL-WR0119] 24AWG Stranded Wire – Green | 20 | cm |  |  |  | Allcable | HU1569247GN | ft, 1000 | 0.00 USD/mm | 0.02 USD
 | > > > > | PC-CN0001 | [PC-CN0001] Molex-Conn Housing 2POS .100 W/Latch | 1 | PCE |  | Molex | 050579402 | Sager Electronics | 050579402 | PCE | 0.06 USD/PCE | 0.06 USD
 | > > > | AS-CB0083 | [AS-CB0083] Hibiscus LCD Harness One, Mini 2 | 1 | PCE |  |  |  | CCX Corp.(DO NOT USE) |  | PCE | 10.00 USD/PCE | 10.00 USD
 | > > > > | EL-CA0205 | [EL-CA0205] Flat Cables .050" 10C 10 28AWG STRANDED, BLACK | 720 | mm |  |  |  | TTI Global Distribution | 3319/10-300 | ft, 300 | 0.00 USD/mm | 3.28 USD
 | > > > > | PC-CN0010 | [PC-CN0010] Conn Socket IDC, 10POS DUAL 30AU, | 2 | PCE |  | Amphenol FCI | 71600-010LF | TTI Global Distribution | 71600-010LF | PCE | 0.53 USD/PCE | 1.06 USD
 | > > > | AS-CB0084 | [AS-CB0084] Hibiscus LCD Harness Two, Mini 2 | 1 | PCE |  |  |  | CCX Corp.(DO NOT USE) |  | PCE | 40.00 USD/PCE | 40.00 USD
 | > > > > | DC-LB0094 | [DC-LB0094] Serial number label sheets (blank) 100/pk 105 up - 1.25" x 0.375" | 2 | PCE |  |  |  | Onlinelabels.com | OL910WX | pkg, 10500 | 0.01 USD/PCE | 0.02 USD
 | > > > > | EL-CA0205 | [EL-CA0205] Flat Cables .050" 10C 10 28AWG STRANDED, BLACK | 720 | mm |  |  |  | TTI Global Distribution | 3319/10-300 | ft, 300 | 0.00 USD/mm | 3.28 USD
 | > > > > | PC-CN0010 | [PC-CN0010] Conn Socket IDC, 10POS DUAL 30AU, | 2 | PCE |  | Amphenol FCI | 71600-010LF | TTI Global Distribution | 71600-010LF | PCE | 0.53 USD/PCE | 1.06 USD
 | > > > | AS-EL0002 | [AS-EL0002] Hibiscus LCD Assembly | 1 | PCE
 | > > > > | PP-GP0089 | [PP-GP0089] LCD_spacer_v0.4 | 4 | PCE
 | > > > > > | RM-AB0105 | [RM-AB0105] Chroma Strand ABS Filament, Black 2.85mm, 5 lb reel | 0.0029 | Reel, 5lb |  |  |  | Chroma Strand Labs, LLC |  | Reel, 5lb | 45.00 USD/Reel, 5lb | 0.13 USD
 | > > > > | PP-GP0324 | [PP-GP0324] Mini LCD Bezel | 1 | PCE
 | > > > > > | RM-AB0105 | [RM-AB0105] Chroma Strand ABS Filament, Black 2.85mm, 5 lb reel | 0.0057 | Reel, 5lb |  |  |  | Chroma Strand Labs, LLC |  | Reel, 5lb | 45.00 USD/Reel, 5lb | 0.26 USD
 | > > > > | PP-GP0329 | [PP-GP0329] Mini LCD Bezel Spacer | 1 | PCE
 | > > > > > | RM-AB0105 | [RM-AB0105] Chroma Strand ABS Filament, Black 2.85mm, 5 lb reel | 0.0044 | Reel, 5lb |  |  |  | Chroma Strand Labs, LLC |  | Reel, 5lb | 45.00 USD/Reel, 5lb | 0.20 USD
 | > > > > | PP-GP0435 | [PP-GP0435] Flexy LCD Knob | 1 | PCE
 | > > > > > | RM-TE0002 | [RM-TE0002] Midnight NinjaFlex™ TPE Filament, 3mm, 0.75kg Fenner Drives | 0.01 | Reel, 0.75kg |  | Fenner Drives | 3D3011290 Midnight | Fenner Drives | 3D3011290A | Reel, 0.75kg | 104.06 USD/Reel, 5lb | 0.14 USD
 | > > > > | PP-GP0339 | [PP-GP0339] LCD cover spacer | 1 | PCE
 | > > > > > | RM-AB0105 | [RM-AB0105] Chroma Strand ABS Filament, Black 2.85mm, 5 lb reel | 0.0026 | Reel, 5lb |  |  |  | Chroma Strand Labs, LLC |  | Reel, 5lb | 45.00 USD/Reel, 5lb | 0.12 USD
 | > > > > | PP-IS0043 | [PP-IS0043] Mini LCD Bracket Right V1 with inserts | 1 | PCE
 | > > > > > | PP-GP0325 | [PP-GP0325] LCD Bracket Right V1 | 1 | PCE
 | > > > > > > | RM-AB0105 | [RM-AB0105] Chroma Strand ABS Filament, Black 2.85mm, 5 lb reel | 0.0251 | Reel, 5lb |  |  |  | Chroma Strand Labs, LLC |  | Reel, 5lb | 45.00 USD/Reel, 5lb | 1.13 USD
 | > > > > > | HD-MS0030 | [HD-MS0030] Metric Brass Heat-Set Insert for Plastics Tapered, M3-.5 Internal Thread, 3.8mm Length | 2 | PCE |  |  |  | Aero-Space Fasteners and Hardware (formerly Colorado Electronic Hardware) | PEM IUBB-M3-1 | PCE | 0.04 USD/PCE | 0.07 USD
 | > > > > | PP-IS0056 | [PP-IS0056] Mini LCD Case with inserts | 1 | PCE
 | > > > > > | PP-GP0330 | [PP-GP0330] Mini LCD Case | 1 | PCE
 | > > > > > > | RM-AB0105 | [RM-AB0105] Chroma Strand ABS Filament, Black 2.85mm, 5 lb reel | 0.0304 | Reel, 5lb |  |  |  | Chroma Strand Labs, LLC |  | Reel, 5lb | 45.00 USD/Reel, 5lb | 1.37 USD
 | > > > > > | HD-MS0030 | [HD-MS0030] Metric Brass Heat-Set Insert for Plastics Tapered, M3-.5 Internal Thread, 3.8mm Length | 11 | PCE |  |  |  | Aero-Space Fasteners and Hardware (formerly Colorado Electronic Hardware) | PEM IUBB-M3-1 | PCE | 0.04 USD/PCE | 0.39 USD
 | > > > > | HD-BT0135 | [HD-BT0135] M3 x 25 Bolt FHCS, Black-Oxide, Partially Threaded | 4 | PCE |  |  | 40929 | Fastenal | 40929 | PCE | 0.03 USD/PCE | 0.14 USD
 | > > > > | HD-BT0137 | [HD-BT0137] M3 x 8 Bolt, BHCS, Black-Oxide | 4 | PCE |  |  | 40868 | Hardware Speciality | ISO7380-10.9-3-8 | PCE | 0.03 USD/PCE | 0.10 USD
 | > > > > | HD-BT0171 | [HD-BT0171] Black Oxide Class 10.9 Steel Button-Head Socket Cap Screw M3 Size, 20 mm Length, .5 mm Pitch, pkg 100 | 3 | PCE |  |  |  | Hardware Speciality | ISO7380-10.9-3-20 | PCE | 0.04 USD/PCE | 0.11 USD
 | > > > > | HD-WA0038 | [HD-WA0038] Black-Oxide 18-8 Steel Flat Washer, M3 Screw Size, 3.2mm ID, 7.0mm OD | 7 | PCE |  |  |  | Hardware Speciality | DIN125A-A2-3BL | PCE | 0.01 USD/PCE | 0.07 USD
 | > > > > | PC-AS0056 | [PC-AS0056] LCD LB_GLCD | 1 | PCE |  |  |  | Ultimachine | LB_GLCD | PCE | 23.99 USD/PCE | 23.99 USD
 | > > > > | PC-AS0041 | [PC-AS0041] Plastic Laser Cut LCD Cover | 1 | PCE |  |  |  | Printed Solid, Inc. |  | PCE | 0.80 USD/PCE | 0.80 USD
 | > > > > | PP-MP0215 | [PP-MP0215] LCD Cover, HIPS, Mini 2 | 1 | PCE |  |  |  | Printed Solid, Inc. |  | PCE | 2.00 USD/PCE | 2.00 USD
 | > > > | AS-EL0003 | [AS-EL0003] Z-Motor Brake Assembled | 1 | PCE
 | > > > > | PP-IS0058 | [PP-IS0058] Z-Brake Mount w/ Inserts, Mini 2 | 1 | PCE
 | > > > > > | PP-GP0337 | [PP-GP0337] Z brake board mount, Mini 2 | 1 | PCE
 | > > > > > > | RM-AB0105 | [RM-AB0105] Chroma Strand ABS Filament, Black 2.85mm, 5 lb reel | 0.0026 | Reel, 5lb |  |  |  | Chroma Strand Labs, LLC |  | Reel, 5lb | 45.00 USD/Reel, 5lb | 0.12 USD
 | > > > > > | HD-MS0030 | [HD-MS0030] Metric Brass Heat-Set Insert for Plastics Tapered, M3-.5 Internal Thread, 3.8mm Length | 4 | PCE |  |  |  | Aero-Space Fasteners and Hardware (formerly Colorado Electronic Hardware) | PEM IUBB-M3-1 | PCE | 0.04 USD/PCE | 0.14 USD
 | > > > > | HD-BT0140 | [HD-BT0140] M3 x 6 Bolt, BHCS Black-Oxide | 4 | PCE |  |  | 408674 | Hardware Speciality | ISO7380-10.9-3-6 | PCE | 0.02 USD/PCE | 0.10 USD
 | > > > > | HD-WA0038 | [HD-WA0038] Black-Oxide 18-8 Steel Flat Washer, M3 Screw Size, 3.2mm ID, 7.0mm OD | 4 | PCE |  |  |  | Hardware Speciality | DIN125A-A2-3BL | PCE | 0.01 USD/PCE | 0.04 USD
 | > > > > | PC-BD0096 | [PC-BD0096] Z Brake, Assembly | 1 | PCE |  |  |  | Ultimachine |  | PCE | 9.58 USD/PCE | 9.58 USD
 | > > > | AS-PR0086 | [AS-PR0086] X Carriage Assembly, Mini 2 | 1 | PCE
 | > > > > | AS-PR0114 | [AS-PR0114] X-Axis Single Bearing Holder Assembly, Mini 2 | 1 | PCE
 | > > > > > | PP-GP0334 | [PP-GP0334] Retaining Ring | 2 | PCE
 | > > > > > > | RM-AB0105 | [RM-AB0105] Chroma Strand ABS Filament, Black 2.85mm, 5 lb reel | 0.0024 | Reel, 5lb |  |  |  | Chroma Strand Labs, LLC |  | Reel, 5lb | 45.00 USD/Reel, 5lb | 0.11 USD
 | > > > > > | HD-BU0046 | [HD-BU0046] Drylin® Precision, Polymer 8 mm Bearing RJMP-01-08 | 1 | PCE |  | Igus, Inc. | RJMP-01-08 | Igus, Inc. | RJMP-01-08 | PCE | 1.26 USD/PCE | 1.26 USD
 | > > > > > | RM-AB0105 | [RM-AB0105] Chroma Strand ABS Filament, Black 2.85mm, 5 lb reel | 0.004 | Reel, 5lb |  |  |  | Chroma Strand Labs, LLC |  | Reel, 5lb | 45.00 USD/Reel, 5lb | 0.18 USD
 | > > > > | PP-IS0046 | [PP-IS0046] X Belt Tensioner, Mini 2 with Inserts | 1 | PCE
 | > > > > > | PP-GP0317 | [PP-GP0317] X Belt Tensioner, Mini 2 | 1 | PCE
 | > > > > > > | RM-AB0105 | [RM-AB0105] Chroma Strand ABS Filament, Black 2.85mm, 5 lb reel | 0.002 | Reel, 5lb |  |  |  | Chroma Strand Labs, LLC |  | Reel, 5lb | 45.00 USD/Reel, 5lb | 0.09 USD
 | > > > > > | HD-MS0030 | [HD-MS0030] Metric Brass Heat-Set Insert for Plastics Tapered, M3-.5 Internal Thread, 3.8mm Length | 2 | PCE |  |  |  | Aero-Space Fasteners and Hardware (formerly Colorado Electronic Hardware) | PEM IUBB-M3-1 | PCE | 0.04 USD/PCE | 0.07 USD
 | > > > > | PP-IS0060 | [PP-IS0060] X-Carriage with inserts, Mini 2 | 1 | PCE
 | > > > > > | AS-PR0096 | [AS-PR0096] X Carriage with Bushing Assembly, Mini 2 | 1 | PCE
 | > > > > > > | RM-AB0105 | [RM-AB0105] Chroma Strand ABS Filament, Black 2.85mm, 5 lb reel | 0.0229 | Reel, 5lb |  |  |  | Chroma Strand Labs, LLC |  | Reel, 5lb | 45.00 USD/Reel, 5lb | 1.03 USD
 | > > > > > > | HD-BU0046 | [HD-BU0046] Drylin® Precision, Polymer 8 mm Bearing RJMP-01-08 | 2 | PCE |  | Igus, Inc. | RJMP-01-08 | Igus, Inc. | RJMP-01-08 | PCE | 1.26 USD/PCE | 2.52 USD
 | > > > > > | PP-GP0334 | [PP-GP0334] Retaining Ring | 2 | PCE
 | > > > > > > | RM-AB0105 | [RM-AB0105] Chroma Strand ABS Filament, Black 2.85mm, 5 lb reel | 0.0024 | Reel, 5lb |  |  |  | Chroma Strand Labs, LLC |  | Reel, 5lb | 45.00 USD/Reel, 5lb | 0.11 USD
 | > > > > > | HD-BT0140 | [HD-BT0140] M3 x 6 Bolt, BHCS Black-Oxide | 2 | PCE |  |  | 408674 | Hardware Speciality | ISO7380-10.9-3-6 | PCE | 0.02 USD/PCE | 0.05 USD
 | > > > > > | HD-MS0030 | [HD-MS0030] Metric Brass Heat-Set Insert for Plastics Tapered, M3-.5 Internal Thread, 3.8mm Length | 11 | PCE |  |  |  | Aero-Space Fasteners and Hardware (formerly Colorado Electronic Hardware) | PEM IUBB-M3-1 | PCE | 0.04 USD/PCE | 0.39 USD
 | > > > > | HD-BT0116 | [HD-BT0116] Black Alloy Steel Flat-Head Socket Cap Screw, Class 10.9, M3 Size, 10mm Length, .50mm Pitch | 2 | PCE |  |  |  | Hardware Speciality | DIN7991-10.9-3-10 | PCE | 0.03 USD/PCE | 0.05 USD
 | > > > > | HD-BT0137 | [HD-BT0137] M3 x 8 Bolt, BHCS, Black-Oxide | 3 | PCE |  |  | 40868 | Hardware Speciality | ISO7380-10.9-3-8 | PCE | 0.03 USD/PCE | 0.08 USD
 | > > > > | HD-WA0038 | [HD-WA0038] Black-Oxide 18-8 Steel Flat Washer, M3 Screw Size, 3.2mm ID, 7.0mm OD | 3 | PCE |  |  |  | Hardware Speciality | DIN125A-A2-3BL | PCE | 0.01 USD/PCE | 0.03 USD
 | > > > | AS-PR0089 | [AS-PR0089] Z Axis Right Assembly, Mini 2 | 1 | PCE
 | > > > > | AS-PR0087 | [AS-PR0087] X End Idler Assembly With Inserts and Bushings, Mini 2 | 1 | PCE
 | > > > > > | AS-PR0095 | [AS-PR0095] X End Idler Assembly Mini 2 | 1 | PCE
 | > > > > > > | RM-AB0105 | [RM-AB0105] Chroma Strand ABS Filament, Black 2.85mm, 5 lb reel | 0.0355 | Reel, 5lb |  |  |  | Chroma Strand Labs, LLC |  | Reel, 5lb | 45.00 USD/Reel, 5lb | 1.60 USD
 | > > > > > > | HD-BU0046 | [HD-BU0046] Drylin® Precision, Polymer 8 mm Bearing RJMP-01-08 | 3 | PCE |  | Igus, Inc. | RJMP-01-08 | Igus, Inc. | RJMP-01-08 | PCE | 1.26 USD/PCE | 3.78 USD
 | > > > > > | HD-BT0012 | [HD-BT0012] M3 Set Screw (Grub Screw) | 2 | PCE |  |  | 40818 | Fastenal | 40818 | PCE | 0.03 USD/PCE | 0.05 USD
 | > > > > > | HD-BT0140 | [HD-BT0140] M3 x 6 Bolt, BHCS Black-Oxide | 2 | PCE |  |  | 408674 | Hardware Speciality | ISO7380-10.9-3-6 | PCE | 0.02 USD/PCE | 0.05 USD
 | > > > > > | HD-BT0146 | [HD-BT0146] M3 x 12 BHCS, Black Oxide, Class 10.9 Steel | 2 | PCE |  |  |  | Hardware Speciality | ISO7380-10.9-3-12 | PCE | 0.02 USD/PCE | 0.05 USD
 | > > > > > | HD-BT0216 | [HD-BT0216] Black-Oxide Alloy Steel Hex Drive Flat Head Screw M5 x 0.8 mm Thread, 40 mm Long | 1 | PCE |  |  |  | Hardware Speciality |  | PCE | 0.22 USD/PCE | 0.22 USD
 | > > > > > | HD-MS0030 | [HD-MS0030] Metric Brass Heat-Set Insert for Plastics Tapered, M3-.5 Internal Thread, 3.8mm Length | 4 | PCE |  |  |  | Aero-Space Fasteners and Hardware (formerly Colorado Electronic Hardware) | PEM IUBB-M3-1 | PCE | 0.04 USD/PCE | 0.14 USD
 | > > > > > | HD-MS0411 | [HD-MS0411] 625-2RS Premium Two Side Rubber Sealed Bearing ABEC3 | 2 | PCE |  |  |  | JSB Great Bearings | 625-2RS V2+ | PCE | 0.70 USD/PCE | 1.40 USD
 | > > > > > | HD-NT0001 | [HD-NT0001] Metric Zinc-Plated Steel Nylon-Insert Locknut, Class 8, M3 Screw sz, .5MM pitch, 5.5MM W, 4MM H | 2 | PCE |  |  | 40143 | Fastenal | 40143 | PCE | 0.01 USD/PCE | 0.02 USD
 | > > > > > | HD-NT0057 | [HD-NT0057] 18-8 Stainless Steel Nylon-Insert Locknut M5 x 0.8 mm Thread | 1 | PCE |  |  |  | Fastenal | 1L2540000A20000 | pkg, 100 | 0.12 USD/PCE | 0.12 USD
 | > > > > > | HD-WA0038 | [HD-WA0038] Black-Oxide 18-8 Steel Flat Washer, M3 Screw Size, 3.2mm ID, 7.0mm OD | 2 | PCE |  |  |  | Hardware Speciality | DIN125A-A2-3BL | PCE | 0.01 USD/PCE | 0.02 USD
 | > > > > > | PP-GP0334 | [PP-GP0334] Retaining Ring | 2 | PCE
 | > > > > > > | RM-AB0105 | [RM-AB0105] Chroma Strand ABS Filament, Black 2.85mm, 5 lb reel | 0.0024 | Reel, 5lb |  |  |  | Chroma Strand Labs, LLC |  | Reel, 5lb | 45.00 USD/Reel, 5lb | 0.11 USD
 | > > > > > | PP-MP0066 | [PP-MP0066] Metric Brass Heat-Set Insert for Plastics, Tapered, M2-.4 Internal Thread, 2.9MM Length | 4 | PCE |  |  |  | Aero-Space Fasteners and Hardware (formerly Colorado Electronic Hardware) | PEM ZZIUB-48213 | PCE | 0.05 USD/PCE | 0.20 USD
 | > > > > > | PP-GP0348 | [PP-GP0348] Printed Threaded Spacer | 2 | PCE
 | > > > > > > | RM-AB0105 | [RM-AB0105] Chroma Strand ABS Filament, Black 2.85mm, 5 lb reel | 0.0088 | Reel, 5lb |  |  |  | Chroma Strand Labs, LLC |  | Reel, 5lb | 45.00 USD/Reel, 5lb | 0.40 USD
 | > > > > | AS-PR0088 | [AS-PR0088] Z Upper Right Assembly, Mini 2 | 1 | PCE
 | > > > > > | PP-IS0048 | [PP-IS0048] Z Upper Right With Inserts, Mini 2 | 1 | PCE
 | > > > > > > | PP-GP0312 | [PP-GP0312] Z Upper Right, Mini 2 | 1 | PCE
 | > > > > > > > | RM-AB0105 | [RM-AB0105] Chroma Strand ABS Filament, Black 2.85mm, 5 lb reel | 0.0161 | Reel, 5lb |  |  |  | Chroma Strand Labs, LLC |  | Reel, 5lb | 45.00 USD/Reel, 5lb | 0.72 USD
 | > > > > > > | HD-MS0030 | [HD-MS0030] Metric Brass Heat-Set Insert for Plastics Tapered, M3-.5 Internal Thread, 3.8mm Length | 7 | PCE |  |  |  | Aero-Space Fasteners and Hardware (formerly Colorado Electronic Hardware) | PEM IUBB-M3-1 | PCE | 0.04 USD/PCE | 0.25 USD
 | > > > > > | HD-MS0412 | [HD-MS0412] Smooth Idler Pulley Wheel Kit | 1 | PCE |  |  |  | OpenBuilds Part Store | 550 | PCE | 2.81 USD/PCE | 2.81 USD
 | > > > > | PP-GP0307 | [PP-GP0307] Belt Tensioning Collar | 1 | PCE
 | > > > > > | RM-AB0105 | [RM-AB0105] Chroma Strand ABS Filament, Black 2.85mm, 5 lb reel | 0.0002 | Reel, 5lb |  |  |  | Chroma Strand Labs, LLC |  | Reel, 5lb | 45.00 USD/Reel, 5lb | 0.01 USD
 | > > > > | PP-GP0308 | [PP-GP0308] Z Belt Clamp | 2 | PCE
 | > > > > > | RM-AB0105 | [RM-AB0105] Chroma Strand ABS Filament, Black 2.85mm, 5 lb reel | 0.0001 | Reel, 5lb |  |  |  | Chroma Strand Labs, LLC |  | Reel, 5lb | 45.00 USD/Reel, 5lb | 0.00 USD
 | > > > > | PP-IS0047 | [PP-IS0047] Z-Lower Right w/ inserts, Mini 2 | 1 | PCE
 | > > > > > | PP-GP0313 | [PP-GP0313] Z Lower Right, Mini 2 | 1 | PCE
 | > > > > > > | RM-AB0104 | [RM-AB0104] Chroma Strand ABS Filament, Lulzbot Green 2.85mm, 5 lb reel | 0.0243 | Reel, 5lb |  | Chroma Strand Labs, LLC |  | Chroma Strand Labs, LLC |  | Reel, 5lb | 45.00 USD/Reel, 5lb | 1.09 USD
 | > > > > > | HD-MS0030 | [HD-MS0030] Metric Brass Heat-Set Insert for Plastics Tapered, M3-.5 Internal Thread, 3.8mm Length | 5 | PCE |  |  |  | Aero-Space Fasteners and Hardware (formerly Colorado Electronic Hardware) | PEM IUBB-M3-1 | PCE | 0.04 USD/PCE | 0.18 USD
 | > > > > > | HD-RD0068 | [HD-RD0068] 18-8 Stainless Steel Dowel Pin 1mm Diameter, 20mm Long | 2 | PCE |  |  |  | Hardware Speciality | ISO2338-A1M6-1-20 | pkg, 50 | 0.00 USD/PCE | 0.00 USD
 | > > > > | EL-MT0029 | [EL-MT0029] NEMA 17 Stepper Motor, Moons' - NOT INCLUDING wire harness | 1 | PCE |  |  | MS17HD6P4150-01-B | Moons' Industries (America), Inc. | MS17HD6P4150-01-B | PCE | 8.30 USD/PCE | 8.30 USD
 | > > > > | HD-BL0033 | [HD-BL0033] 744-2P06-2MR-744-06 / GT 3 Single Sided Neoprene Belt - 744mm by 6mm belt | 1 | PCE |  |  |  | B & B Manufacturing, Inc | 744-2P06-2MR-744-06 | PCE | 2.06 USD/PCE | 2.06 USD
 | > > > > | HD-BT0012 | [HD-BT0012] M3 Set Screw (Grub Screw) | 2 | PCE |  |  | 40818 | Fastenal | 40818 | PCE | 0.03 USD/PCE | 0.05 USD
 | > > > > | HD-BT0146 | [HD-BT0146] M3 x 12 BHCS, Black Oxide, Class 10.9 Steel | 4 | PCE |  |  |  | Hardware Speciality | ISO7380-10.9-3-12 | PCE | 0.02 USD/PCE | 0.09 USD
 | > > > > | HD-MS0033 | [HD-MS0033] GT2, 16 Teeth, timing pulley, AL | 1 | PCE |  |  |  | B & B Manufacturing, Inc | 16-2P06M6CA5 | PCE | 2.90 USD/PCE | 2.90 USD
 | > > > > | HD-MS0230 | [HD-MS0230] Black Class 12.9 Socket Head Cap Screw, Alloy Steel, M2 Thread, 6mm Length, 0.4mm Pitch | 4 | PCE |  |  | 0134596 | Hardware Speciality | DIN912-12.9-2-6BL | PCE | 0.02 USD/PCE | 0.10 USD
 | > > > > | HD-RD0035 | [HD-RD0035] 8mm Smooth rod, 315mm, 300 Series Stainless Steel | 2 | PCE |  | Igus, Inc. | EWMR-08-315X | Igus, Inc. | EWMR-08-315X | PCE | 5.26 USD/PCE | 10.52 USD
 | > > > > | HD-WA0012 | [HD-WA0012] Steel Flat Washer, DIN 125 zinc-plated class 4,M2 screw sz, 5mm OD, .25mm-.35mm thick | 4 | PCE |  |  | 40350 | Hardware Speciality | DIN125A-ST2ZPT | PCE | 0.01 USD/PCE | 0.04 USD
 | > > > > | HD-WA0038 | [HD-WA0038] Black-Oxide 18-8 Steel Flat Washer, M3 Screw Size, 3.2mm ID, 7.0mm OD | 4 | PCE |  |  |  | Hardware Speciality | DIN125A-A2-3BL | PCE | 0.01 USD/PCE | 0.04 USD
 | > > > | AS-PR0099 | [AS-PR0099] Z Axis Left Assembly, Mini 2 | 1 | PCE
 | > > > > | AS-PR0090 | [AS-PR0090] X end motor assembly with inserts and bushings, Mini 2 | 1 | PCE
 | > > > > > | AS-PR0094 | [AS-PR0094] X End Motor Assembly, Mini 2 | 1 | PCE
 | > > > > > > | HD-BU0046 | [HD-BU0046] Drylin® Precision, Polymer 8 mm Bearing RJMP-01-08 | 3 | PCE |  | Igus, Inc. | RJMP-01-08 | Igus, Inc. | RJMP-01-08 | PCE | 1.26 USD/PCE | 3.78 USD
 | > > > > > > | RM-AB0105 | [RM-AB0105] Chroma Strand ABS Filament, Black 2.85mm, 5 lb reel | 0.0384 | Reel, 5lb |  |  |  | Chroma Strand Labs, LLC |  | Reel, 5lb | 45.00 USD/Reel, 5lb | 1.73 USD
 | > > > > > | HD-BT0140 | [HD-BT0140] M3 x 6 Bolt, BHCS Black-Oxide | 2 | PCE |  |  | 408674 | Hardware Speciality | ISO7380-10.9-3-6 | PCE | 0.02 USD/PCE | 0.05 USD
 | > > > > > | HD-BT0146 | [HD-BT0146] M3 x 12 BHCS, Black Oxide, Class 10.9 Steel | 2 | PCE |  |  |  | Hardware Speciality | ISO7380-10.9-3-12 | PCE | 0.02 USD/PCE | 0.05 USD
 | > > > > > | HD-MS0030 | [HD-MS0030] Metric Brass Heat-Set Insert for Plastics Tapered, M3-.5 Internal Thread, 3.8mm Length | 6 | PCE |  |  |  | Aero-Space Fasteners and Hardware (formerly Colorado Electronic Hardware) | PEM IUBB-M3-1 | PCE | 0.04 USD/PCE | 0.21 USD
 | > > > > > | HD-NT0001 | [HD-NT0001] Metric Zinc-Plated Steel Nylon-Insert Locknut, Class 8, M3 Screw sz, .5MM pitch, 5.5MM W, 4MM H | 2 | PCE |  |  | 40143 | Fastenal | 40143 | PCE | 0.01 USD/PCE | 0.02 USD
 | > > > > > | HD-WA0038 | [HD-WA0038] Black-Oxide 18-8 Steel Flat Washer, M3 Screw Size, 3.2mm ID, 7.0mm OD | 2 | PCE |  |  |  | Hardware Speciality | DIN125A-A2-3BL | PCE | 0.01 USD/PCE | 0.02 USD
 | > > > > > | PP-GP0334 | [PP-GP0334] Retaining Ring | 2 | PCE
 | > > > > > > | RM-AB0105 | [RM-AB0105] Chroma Strand ABS Filament, Black 2.85mm, 5 lb reel | 0.0024 | Reel, 5lb |  |  |  | Chroma Strand Labs, LLC |  | Reel, 5lb | 45.00 USD/Reel, 5lb | 0.11 USD
 | > > > > > | PP-MP0066 | [PP-MP0066] Metric Brass Heat-Set Insert for Plastics, Tapered, M2-.4 Internal Thread, 2.9MM Length | 8 | PCE |  |  |  | Aero-Space Fasteners and Hardware (formerly Colorado Electronic Hardware) | PEM ZZIUB-48213 | PCE | 0.05 USD/PCE | 0.40 USD
 | > > > > | AS-PR0091 | [AS-PR0091] Z Upper Left Assembly, Mini 2 | 1 | PCE
 | > > > > > | PP-IS0050 | [PP-IS0050] Z Upper Left with Inserts, Mini 2 | 1 | PCE
 | > > > > > > | PP-GP0309 | [PP-GP0309] Z Upper Left, Mini 2 | 1 | PCE
 | > > > > > > > | RM-AB0105 | [RM-AB0105] Chroma Strand ABS Filament, Black 2.85mm, 5 lb reel | 0.0165 | Reel, 5lb |  |  |  | Chroma Strand Labs, LLC |  | Reel, 5lb | 45.00 USD/Reel, 5lb | 0.74 USD
 | > > > > > > | HD-MS0030 | [HD-MS0030] Metric Brass Heat-Set Insert for Plastics Tapered, M3-.5 Internal Thread, 3.8mm Length | 7 | PCE |  |  |  | Aero-Space Fasteners and Hardware (formerly Colorado Electronic Hardware) | PEM IUBB-M3-1 | PCE | 0.04 USD/PCE | 0.25 USD
 | > > > > > | HD-MS0412 | [HD-MS0412] Smooth Idler Pulley Wheel Kit | 1 | PCE |  |  |  | OpenBuilds Part Store | 550 | PCE | 2.81 USD/PCE | 2.81 USD
 | > > > > | PP-GP0307 | [PP-GP0307] Belt Tensioning Collar | 1 | PCE
 | > > > > > | RM-AB0105 | [RM-AB0105] Chroma Strand ABS Filament, Black 2.85mm, 5 lb reel | 0.0002 | Reel, 5lb |  |  |  | Chroma Strand Labs, LLC |  | Reel, 5lb | 45.00 USD/Reel, 5lb | 0.01 USD
 | > > > > | PP-GP0308 | [PP-GP0308] Z Belt Clamp | 2 | PCE
 | > > > > > | RM-AB0105 | [RM-AB0105] Chroma Strand ABS Filament, Black 2.85mm, 5 lb reel | 0.0001 | Reel, 5lb |  |  |  | Chroma Strand Labs, LLC |  | Reel, 5lb | 45.00 USD/Reel, 5lb | 0.00 USD
 | > > > > | PP-GP0332 | [PP-GP0332] Bump Stop | 1 | PCE
 | > > > > > | RM-TE0002 | [RM-TE0002] Midnight NinjaFlex™ TPE Filament, 3mm, 0.75kg Fenner Drives | 0.01 | Reel, 0.75kg |  | Fenner Drives | 3D3011290 Midnight | Fenner Drives | 3D3011290A | Reel, 0.75kg | 0.05 USD/g | 0.07 USD
 | > > > > | PP-IS0049 | [PP-IS0049] Z Lower Left With Inserts, Mini 2 | 1 | PCE
 | > > > > > | PP-GP0310 | [PP-GP0310] Z Lower Left, Mini 2 | 1 | PCE
 | > > > > > > | RM-AB0104 | [RM-AB0104] Chroma Strand ABS Filament, Lulzbot Green 2.85mm, 5 lb reel | 0.0159 | Reel, 5lb |  | Chroma Strand Labs, LLC |  | Chroma Strand Labs, LLC |  | Reel, 5lb | 45.00 USD/Reel, 5lb | 0.72 USD
 | > > > > > | HD-MS0030 | [HD-MS0030] Metric Brass Heat-Set Insert for Plastics Tapered, M3-.5 Internal Thread, 3.8mm Length | 5 | PCE |  |  |  | Aero-Space Fasteners and Hardware (formerly Colorado Electronic Hardware) | PEM IUBB-M3-1 | PCE | 0.04 USD/PCE | 0.18 USD
 | > > > > > | HD-RD0068 | [HD-RD0068] 18-8 Stainless Steel Dowel Pin 1mm Diameter, 20mm Long | 2 | PCE |  |  |  | Hardware Speciality | ISO2338-A1M6-1-20 | pkg, 50 | 0.00 USD/PCE | 0.00 USD
 | > > > > | EL-HR0130 | [EL-HR0130] Mini X Extruder Harnesses Assembly | 1 | PCE |  | Igus, Inc. |  | Igus, Inc. |  | PCE | 84.00 USD/PCE | 84.00 USD
 | > > > > > | EL-HR0108 | [EL-HR0108] Mini X Extruder Harnesses Assembly - revG | 1 | PCE |  | Igus, Inc. |  | Igus, Inc. |  | PCE | 73.26 USD/PCE | 73.26 USD
 | > > > > > | EL-MS0479 | [EL-MS0479] CONN TERM FEMALE 20-24AWG TIN (Micro-Fit 3.0™) 12K REEL | 16 | PCE |  | Molex | 43030-0001 | TTI Global Distribution | 43030-0001 | PCE | 0.02 USD/PCE | 0.27 USD
 | > > > > > | PC-CN0003 | [PC-CN0003] Molex - CONN HOUSING 3POS .100 W/LATCH | 2 | PCE |  | Molex | 50-57-9403 | TTI Global Distribution | 0050579403 | PCE | 0.06 USD/PCE | 0.12 USD
 | > > > > > | PC-CN0099 | [PC-CN0099] CONN RECEPT 20POS 3MM DUAL ROW | 1 | PCE |  | Molex | 0430252000 | TTI Global Distribution | 43025-2000 | PCE | 0.36 USD/PCE | 0.36 USD
 | > > > > | DC-LB0154 | [DC-LB0154] Caution Hot Sticker | 1 | PCE
 | > > > > | EL-MT0029 | [EL-MT0029] NEMA 17 Stepper Motor, Moons' - NOT INCLUDING wire harness | 2 | PCE |  |  | MS17HD6P4150-01-B | Moons' Industries (America), Inc. | MS17HD6P4150-01-B | PCE | 8.30 USD/PCE | 16.60 USD
 | > > > > | EL-SW0022 | [EL-SW0022] SWITCH BASIC SPDT 3A .110QC 125V | 1 | PCE |  | Omron | SS-3GPT | TTI Global Distribution | SS-3GPT | PCE | 0.42 USD/PCE | 0.42 USD
 | > > > > | HD-BL0033 | [HD-BL0033] 744-2P06-2MR-744-06 / GT 3 Single Sided Neoprene Belt - 744mm by 6mm belt | 1 | PCE |  |  |  | B & B Manufacturing, Inc | 744-2P06-2MR-744-06 | PCE | 2.06 USD/PCE | 2.06 USD
 | > > > > | HD-BT0012 | [HD-BT0012] M3 Set Screw (Grub Screw) | 2 | PCE |  |  | 40818 | Fastenal | 40818 | PCE | 0.03 USD/PCE | 0.05 USD
 | > > > > | HD-BT0039 | [HD-BT0039] Metric Class 12.9 Socket Head Cap Screw, Alloy Steel, M3 Thread, 12MM Length, 0.50MM Pitch | 4 | PCE |  |  | 39505 | Hardware Speciality | DIN912-12.9-3-12 | PCE | 0.02 USD/PCE | 0.09 USD
 | > > > > | HD-BT0107 | [HD-BT0107] Metric Class 12.9 Socket Head Cap Screw Alloy Steel, Black, M2 Thread, 10mm Length, 0.4mm Pitch | 4 | PCE |  |  | 0134599 | Fastenal | 0134599 | PCE | 0.02 USD/PCE | 0.09 USD
 | > > > > | HD-BT0128 | [HD-BT0128] M3 x 6 Bolt, FHCS Black-Oxide | 4 | PCE |  |  | 40921 | Hardware Speciality | DIN7991-10.9-3-6 | PCE | 0.03 USD/PCE | 0.10 USD
 | > > > > | HD-BT0146 | [HD-BT0146] M3 x 12 BHCS, Black Oxide, Class 10.9 Steel | 4 | PCE |  |  |  | Hardware Speciality | ISO7380-10.9-3-12 | PCE | 0.02 USD/PCE | 0.09 USD
 | > > > > | HD-MS0033 | [HD-MS0033] GT2, 16 Teeth, timing pulley, AL | 2 | PCE |  |  |  | B & B Manufacturing, Inc | 16-2P06M6CA5 | PCE | 2.90 USD/PCE | 5.80 USD
 | > > > > | HD-MS0058 | [HD-MS0058] Wire Tie, 8" Black, pk 1000 | 4 | PCE |  |  | APU-08-18-0-M | Electronics Distributors Corp. | 17-01125 | pkg, 1000 | 0.02 USD/PCE | 0.08 USD
 | > > > > | HD-MS0230 | [HD-MS0230] Black Class 12.9 Socket Head Cap Screw, Alloy Steel, M2 Thread, 6mm Length, 0.4mm Pitch | 4 | PCE |  |  | 0134596 | Hardware Speciality | DIN912-12.9-2-6BL | PCE | 0.02 USD/PCE | 0.10 USD
 | > > > > | HD-RD0035 | [HD-RD0035] 8mm Smooth rod, 315mm, 300 Series Stainless Steel | 2 | PCE |  | Igus, Inc. | EWMR-08-315X | Igus, Inc. | EWMR-08-315X | PCE | 5.26 USD/PCE | 10.52 USD
 | > > > > | HD-WA0012 | [HD-WA0012] Steel Flat Washer, DIN 125 zinc-plated class 4,M2 screw sz, 5mm OD, .25mm-.35mm thick | 8 | PCE |  |  | 40350 | Hardware Speciality | DIN125A-ST2ZPT | PCE | 0.01 USD/PCE | 0.08 USD
 | > > > > | HD-WA0038 | [HD-WA0038] Black-Oxide 18-8 Steel Flat Washer, M3 Screw Size, 3.2mm ID, 7.0mm OD | 8 | PCE |  |  |  | Hardware Speciality | DIN125A-A2-3BL | PCE | 0.01 USD/PCE | 0.08 USD
 | > > > | AS-PR0101 | [AS-PR0101] Mini 2 Final Frame Assembly | 1 | PCE
 | > > > > | AS-CB0071 | [AS-CB0071] Bed Harnesses- Hibiscus | 1 | PCE
 | > > > > > | AS-CB0072 | [AS-CB0072] YZ Harness- Hibiscus | 1 | PCE |  |  |  | CCX Corp.(DO NOT USE) |  | PCE | 30.00 USD/PCE | 30.00 USD
 | > > > > > > | EL-MS0059 | [EL-MS0059] Molex-CONN TERM FEMALE 22-24AWG TIN Reels of 20K | 12 | PCE |  | Molex | 16-02-0086 | TTI Global Distribution | 16-02-0086 | PCE | 0.02 USD/PCE | 0.19 USD
 | > > > > > > | EL-MS0141 | [EL-MS0141] Term Ring Non Ins 26-22AWG #4 Order Bulk Only | 6 | PCE |  | Panduit | P22-4R-M | TTI Global Distribution | P22-4R-M | PCE | 0.06 USD/PCE | 0.35 USD
 | > > > > > > | EL-MS0351 | [EL-MS0351] JST - CONN TERM CRIMP PH 24-30AWG - 8,000 Unit Reel | 12 | PCE |  | JST Sales America | SPH-002T-P0.5S | Future Electronics |  | PCE | 0.01 USD/PCE | 0.15 USD
 | > > > > > > | EL-MS0355 | [EL-MS0355] CONN HOUSING PH 6POS 2MM WHITE | 3 | PCE |  | JST Sales America | PHR-6 | Future Electronics | PHR-6 | PCE | 0.04 USD/PCE | 0.12 USD
 | > > > > > > | EL-WR0099 | [EL-WR0099] Shielded 22AWG UL2464 4 COND | 170 | cm |  |  |  | Allcable | C0762A.41.10 | ft, 1000 | 0.00 USD/mm | 1.72 USD
 | > > > > > > | HD-TB0066 | [HD-TB0066] Flexible Polyolefin Heat Shrink Tubing 1/8" ID Before, 1/16" ID After, 100' L, Black | 535 | mm |  |  |  | Electronics Distributors Corp. | 88-01250 | PCE, 100' | 0.00 USD/mm | 0.34 USD
 | > > > > > | EL-HR0135 | [EL-HR0135] Mini 2 Bed Harness Igus | 1 | PCE |  |  |  | Igus, Inc. |  | PCE | 32.00 USD/PCE | 32.00 USD
 | > > > > > > | EL-HR0102 | [EL-HR0102] Mini Bed Harness Assembly - revG | 1 | PCE |  | Igus, Inc. |  | Igus, Inc. |  | PCE | 29.58 USD/PCE | 29.58 USD
 | > > > > > > | EL-MS0497 | [EL-MS0497] CONN SPADE TERM 16-22AWG #6 RED | 2 | PCE |  | TE Connectivity | 2-34541-1 | TTI Global Distribution | 2-34541-1 | PCE | 0.10 USD/PCE | 0.21 USD
 | > > > > > | EL-MS0062 | [EL-MS0062] MOLEX-CONN HOUSING 4POS .100 W/LATCH | 3 | PCE |  |  | 050579404 | Sager Electronics | 050579404 | PCE | 0.06 USD/PCE | 0.18 USD
 | > > > > > | EL-MS0073 | [EL-MS0073] Tubing Corrugated Loom .25", Black, 3200' Box | 95 | cm |  |  | 88-00011 | Electronics Distributors Corp. | 88-00011 | ft, 200 | 0.00 USD/mm | 0.22 USD
 | > > > > > | EL-MS0247 | [EL-MS0247] Heat Shrink Tubing – 0.19-0.09 – Black, 100' | 25 | mm |  | 3M | 88-01870 | Electronics Distributors Corp. | 88-01870 | PCE, 100' | 0.00 USD/mm | 0.02 USD
 | > > > > > | EL-MS0259 | [EL-MS0259] Heat Shrink DL WL Q53X 3/4" | 7 | cm |  | Qualtek | Q5-3X-3/4-01-QB48IN-5 | Electronics Distributors Corp. | 67-30751 | PCE ft, 4 | 0.00 USD/mm | 0.32 USD
 | > > > > > | EL-MS0343 | [EL-MS0343] Ferrite Tubular Bead 10.16MM | 1 | PCE |  | Laird Technologies | 28B0735-000 | Sager Electronics | 28B0735-000 | PCE | 0.26 USD/PCE | 0.26 USD
 | > > > > > | EL-MS0434 | [EL-MS0434] Heat Shrink Tubing – 0.19-0.09 – Red, 250' | 25 | mm |  |  | 88-01872 | Electronics Distributors Corp. | 88-01872 | ft, 250 | 0.00 USD/mm | 0.02 USD
 | > > > > > | PC-CN0001 | [PC-CN0001] Molex-Conn Housing 2POS .100 W/Latch | 1 | PCE |  | Molex | 050579402 | Sager Electronics | 050579402 | PCE | 0.06 USD/PCE | 0.06 USD
 | > > > > > | PC-CN0003 | [PC-CN0003] Molex - CONN HOUSING 3POS .100 W/LATCH | 3 | PCE |  | Molex | 50-57-9403 | TTI Global Distribution | 0050579403 | PCE | 0.06 USD/PCE | 0.18 USD
 | > > > > | AS-PR0102 | [AS-PR0102] Mini 2 Y-axis Assembly | 1 | PCE
 | > > > > > | AS-PR0023 | [AS-PR0023] 90mm Cut wiper pad | 1 | PCE, 90mm
 | > > > > > > | HD-MS0550 | [HD-MS0550] Synthetic Felt Plain Backing, 1" Wide, 1/4" Thick - 50 ft | 600 | inch(es) |  |  |  | McMaster-Carr | 88085K311 | ft, 50 | 0.04 USD/inch(es) | 24.00 USD
 | > > > > > > | RM-AB0105 | [RM-AB0105] Chroma Strand ABS Filament, Black 2.85mm, 5 lb reel | 0.0529 | Reel, 5lb |  |  |  | Chroma Strand Labs, LLC |  | Reel, 5lb | 45.00 USD/Reel, 5lb | 2.38 USD
 | > > > > > | AS-PR0069 | [AS-PR0069] Mini 2, Y Axis Mount Idler Insert Assembly | 1 | PCE
 | > > > > > > | PP-GP0264 | [PP-GP0264] y-idler-mini_black_v1.4 | 1 | PCE
 | > > > > > > > | RM-AB0105 | [RM-AB0105] Chroma Strand ABS Filament, Black 2.85mm, 5 lb reel | 0.0121 | Reel, 5lb |  |  |  | Chroma Strand Labs, LLC |  | Reel, 5lb | 45.00 USD/Reel, 5lb | 0.54 USD
 | > > > > > > | HD-BT0117 | [HD-BT0117] Black Alloy Steel Flat-Head Socket Cap Screw, Class 10.9, M8 Size, 40mm Length, 1.25mm Pitch | 1 | PCE |  |  | 1139965 | Fastenal | 1139965 | PCE | 0.14 USD/PCE | 0.14 USD
 | > > > > > > | HD-MS0030 | [HD-MS0030] Metric Brass Heat-Set Insert for Plastics Tapered, M3-.5 Internal Thread, 3.8mm Length | 4 | PCE |  |  |  | Aero-Space Fasteners and Hardware (formerly Colorado Electronic Hardware) | PEM IUBB-M3-1 | PCE | 0.04 USD/PCE | 0.14 USD
 | > > > > > > | HD-MS0282 | [HD-MS0282] 608-2RS ABEC3/C3 Rubber Sealed Bearing - BLACK | 2 | PCE |  | JSB Great Bearings | 608-2RS ABEC3/C3 | JSB Great Bearings | 608-2RS ABEC3/C3 | PCE | 0.42 USD/PCE | 0.84 USD
 | > > > > > > | HD-NT0002 | [HD-NT0002] M8 Nyloc Nut, Zinc Plated | 1 | PCE |  |  | 40163 | Fastenal | 40163 | PCE | 0.03 USD/PCE | 0.03 USD
 | > > > > > > | HD-WA0006 | [HD-WA0006] M8 Washer, Steel, Zinc Plated | 3 | PCE |  |  |  | Hardware Speciality | DIN125A-ST8ZPT | PCE | 0.01 USD/PCE | 0.03 USD
 | > > > > > | PP-GP0231 | [PP-GP0231] Wiper Mount, v1.1 | 1 | PCE
 | > > > > > > | RM-AB0105 | [RM-AB0105] Chroma Strand ABS Filament, Black 2.85mm, 5 lb reel | 0.0054 | Reel, 5lb |  |  |  | Chroma Strand Labs, LLC |  | Reel, 5lb | 45.00 USD/Reel, 5lb | 0.24 USD
 | > > > > > | PP-GP0277 | [PP-GP0277] Belt-clamp Black v1.2 | 1 | PCE
 | > > > > > > | RM-AB0105 | [RM-AB0105] Chroma Strand ABS Filament, Black 2.85mm, 5 lb reel | 0.0004 | Reel, 5lb |  |  |  | Chroma Strand Labs, LLC |  | Reel, 5lb | 45.00 USD/Reel, 5lb | 0.02 USD
 | > > > > > | PP-GP0332 | [PP-GP0332] Bump Stop | 2 | PCE
 | > > > > > > | RM-TE0002 | [RM-TE0002] Midnight NinjaFlex™ TPE Filament, 3mm, 0.75kg Fenner Drives | 0.01 | Reel, 0.75kg |  | Fenner Drives | 3D3011290 Midnight | Fenner Drives | 3D3011290A | Reel, 0.75kg | 0.05 USD/g | 0.07 USD
 | > > > > > | PP-GP0335 | [PP-GP0335] Flexy Bed Corner Mini 1.04+ 2pc Bed v2 | 4 | PCE
 | > > > > > > | RM-TE0002 | [RM-TE0002] Midnight NinjaFlex™ TPE Filament, 3mm, 0.75kg Fenner Drives | 0.01 | Reel, 0.75kg |  | Fenner Drives | 3D3011290 Midnight | Fenner Drives | 3D3011290A | Reel, 0.75kg | 0.05 USD/g | 0.11 USD
 | > > > > > | PP-IS0063 | [PP-IS0063] Printed belt clamp assembly, Mini 2 | 1 | PCE
 | > > > > > > | PP-GP0278 | [PP-GP0278] belt-mount black v1.2 | 1 | PCE
 | > > > > > > > | RM-AB0105 | [RM-AB0105] Chroma Strand ABS Filament, Black 2.85mm, 5 lb reel | 0.0041 | Reel, 5lb |  |  |  | Chroma Strand Labs, LLC |  | Reel, 5lb | 45.00 USD/Reel, 5lb | 0.18 USD
 | > > > > > > | HD-MS0030 | [HD-MS0030] Metric Brass Heat-Set Insert for Plastics Tapered, M3-.5 Internal Thread, 3.8mm Length | 5 | PCE |  |  |  | Aero-Space Fasteners and Hardware (formerly Colorado Electronic Hardware) | PEM IUBB-M3-1 | PCE | 0.04 USD/PCE | 0.18 USD
 | > > > > > | PP-IS0064 | [PP-IS0064] Y Axis Rod Mount, Motor side, Mini 2 | 1 | PCE
 | > > > > > > | PP-GP0263 | [PP-GP0263] y-motor-mount_black_v1.4 | 1 | PCE
 | > > > > > > > | RM-AB0105 | [RM-AB0105] Chroma Strand ABS Filament, Black 2.85mm, 5 lb reel | 0.012 | Reel, 5lb |  |  |  | Chroma Strand Labs, LLC |  | Reel, 5lb | 45.00 USD/Reel, 5lb | 0.54 USD
 | > > > > > > | HD-MS0030 | [HD-MS0030] Metric Brass Heat-Set Insert for Plastics Tapered, M3-.5 Internal Thread, 3.8mm Length | 4 | PCE |  |  |  | Aero-Space Fasteners and Hardware (formerly Colorado Electronic Hardware) | PEM IUBB-M3-1 | PCE | 0.04 USD/PCE | 0.14 USD
 | > > > > > | PP-IS0066 | [PP-IS0066] Double Bearing Holder Non-Switch Side Insert Assembly, Mini 2 | 1 | PCE
 | > > > > > > | AS-PR0104 | [AS-PR0104] Double Bearing Holder, Mini 2 | 1 | PCE
 | > > > > > > > | HD-BU0046 | [HD-BU0046] Drylin® Precision, Polymer 8 mm Bearing RJMP-01-08 | 2 | PCE |  | Igus, Inc. | RJMP-01-08 | Igus, Inc. | RJMP-01-08 | PCE | 1.26 USD/PCE | 2.52 USD
 | > > > > > > > | RM-AB0105 | [RM-AB0105] Chroma Strand ABS Filament, Black 2.85mm, 5 lb reel | 0.0104 | Reel, 5lb |  |  |  | Chroma Strand Labs, LLC |  | Reel, 5lb | 45.00 USD/Reel, 5lb | 0.47 USD
 | > > > > > > | PP-GP0334 | [PP-GP0334] Retaining Ring | 2 | PCE
 | > > > > > > > | RM-AB0105 | [RM-AB0105] Chroma Strand ABS Filament, Black 2.85mm, 5 lb reel | 0.0024 | Reel, 5lb |  |  |  | Chroma Strand Labs, LLC |  | Reel, 5lb | 45.00 USD/Reel, 5lb | 0.11 USD
 | > > > > > > | HD-BT0137 | [HD-BT0137] M3 x 8 Bolt, BHCS, Black-Oxide | 2 | PCE |  |  | 40868 | Hardware Speciality | ISO7380-10.9-3-8 | PCE | 0.03 USD/PCE | 0.05 USD
 | > > > > > > | HD-MS0030 | [HD-MS0030] Metric Brass Heat-Set Insert for Plastics Tapered, M3-.5 Internal Thread, 3.8mm Length | 6 | PCE |  |  |  | Aero-Space Fasteners and Hardware (formerly Colorado Electronic Hardware) | PEM IUBB-M3-1 | PCE | 0.04 USD/PCE | 0.21 USD
 | > > > > > | PP-IS0073 | [PP-IS0073] Single Bearing Holder with Inserts, Mini 2 | 1 | PCE
 | > > > > > > | AS-PR0113 | [AS-PR0113] Single Bearing Holder, Mini 2 | 1 | PCE
 | > > > > > > > | HD-BU0046 | [HD-BU0046] Drylin® Precision, Polymer 8 mm Bearing RJMP-01-08 | 1 | PCE |  | Igus, Inc. | RJMP-01-08 | Igus, Inc. | RJMP-01-08 | PCE | 1.26 USD/PCE | 1.26 USD
 | > > > > > > > | RM-AB0105 | [RM-AB0105] Chroma Strand ABS Filament, Black 2.85mm, 5 lb reel | 0.0095 | Reel, 5lb |  |  |  | Chroma Strand Labs, LLC |  | Reel, 5lb | 45.00 USD/Reel, 5lb | 0.43 USD
 | > > > > > > | HD-MS0030 | [HD-MS0030] Metric Brass Heat-Set Insert for Plastics Tapered, M3-.5 Internal Thread, 3.8mm Length | 4 | PCE |  |  |  | Aero-Space Fasteners and Hardware (formerly Colorado Electronic Hardware) | PEM IUBB-M3-1 | PCE | 0.04 USD/PCE | 0.14 USD
 | > > > > > > | PP-MP0066 | [PP-MP0066] Metric Brass Heat-Set Insert for Plastics, Tapered, M2-.4 Internal Thread, 2.9MM Length | 4 | PCE |  |  |  | Aero-Space Fasteners and Hardware (formerly Colorado Electronic Hardware) | PEM ZZIUB-48213 | PCE | 0.05 USD/PCE | 0.20 USD
 | > > > > > > | PP-GP0334 | [PP-GP0334] Retaining Ring | 1 | PCE
 | > > > > > > > | RM-AB0105 | [RM-AB0105] Chroma Strand ABS Filament, Black 2.85mm, 5 lb reel | 0.0024 | Reel, 5lb |  |  |  | Chroma Strand Labs, LLC |  | Reel, 5lb | 45.00 USD/Reel, 5lb | 0.11 USD
 | > > > > > | PP-FP0138 | [PP-FP0138] Silk Screened Bed Mount Plate, Mini | 1 | PCE |  |  |  | Epocs Manufacturing | PP-FP0138 | PCE | 17.25 USD/PCE | 17.25 USD
 | > > > > > | HD-BT0039 | [HD-BT0039] Metric Class 12.9 Socket Head Cap Screw, Alloy Steel, M3 Thread, 12MM Length, 0.50MM Pitch | 4 | PCE |  |  | 39505 | Hardware Speciality | DIN912-12.9-3-12 | PCE | 0.02 USD/PCE | 0.09 USD
 | > > > > > | HD-BT0104 | [HD-BT0104] M3 x 8 Bolt, BHCS, SST | 1 | PCE |  |  | MB2510008A20000 | Hardware Speciality | ISO7380-A2-3-8 | PCE | 0.02 USD/PCE | 0.02 USD
 | > > > > > | HD-BT0107 | [HD-BT0107] Metric Class 12.9 Socket Head Cap Screw Alloy Steel, Black, M2 Thread, 10mm Length, 0.4mm Pitch | 4 | PCE |  |  | 0134599 | Fastenal | 0134599 | PCE | 0.02 USD/PCE | 0.09 USD
 | > > > > > | HD-BT0128 | [HD-BT0128] M3 x 6 Bolt, FHCS Black-Oxide | 2 | PCE |  |  | 40921 | Hardware Speciality | DIN7991-10.9-3-6 | PCE | 0.03 USD/PCE | 0.05 USD
 | > > > > > | HD-BT0137 | [HD-BT0137] M3 x 8 Bolt, BHCS, Black-Oxide | 19 | PCE |  |  | 40868 | Hardware Speciality | ISO7380-10.9-3-8 | PCE | 0.03 USD/PCE | 0.48 USD
 | > > > > > | HD-NT0001 | [HD-NT0001] Metric Zinc-Plated Steel Nylon-Insert Locknut, Class 8, M3 Screw sz, .5MM pitch, 5.5MM W, 4MM H | 2 | PCE |  |  | 40143 | Fastenal | 40143 | PCE | 0.01 USD/PCE | 0.02 USD
 | > > > > > | HD-RD0035 | [HD-RD0035] 8mm Smooth rod, 315mm, 300 Series Stainless Steel | 2 | PCE |  | Igus, Inc. | EWMR-08-315X | Igus, Inc. | EWMR-08-315X | PCE | 5.26 USD/PCE | 10.52 USD
 | > > > > > | HD-WA0012 | [HD-WA0012] Steel Flat Washer, DIN 125 zinc-plated class 4,M2 screw sz, 5mm OD, .25mm-.35mm thick | 4 | PCE |  |  | 40350 | Hardware Speciality | DIN125A-ST2ZPT | PCE | 0.01 USD/PCE | 0.04 USD
 | > > > > > | HD-WA0038 | [HD-WA0038] Black-Oxide 18-8 Steel Flat Washer, M3 Screw Size, 3.2mm ID, 7.0mm OD | 23 | PCE |  |  |  | Hardware Speciality | DIN125A-A2-3BL | PCE | 0.01 USD/PCE | 0.23 USD
 | > > > > | PP-GP0249 | [PP-GP0249] bed clip v3 | 1 | PCE
 | > > > > > | RM-AB0105 | [RM-AB0105] Chroma Strand ABS Filament, Black 2.85mm, 5 lb reel | 0.0013 | Reel, 5lb |  |  |  | Chroma Strand Labs, LLC |  | Reel, 5lb | 45.00 USD/Reel, 5lb | 0.06 USD
 | > > > > | PP-GP0265 | [PP-GP0265] strain-relief-lower_black_1.2 | 1 | PCE
 | > > > > > | RM-AB0105 | [RM-AB0105] Chroma Strand ABS Filament, Black 2.85mm, 5 lb reel | 0.0012 | Reel, 5lb |  |  |  | Chroma Strand Labs, LLC |  | Reel, 5lb | 45.00 USD/Reel, 5lb | 0.05 USD
 | > > > > | PP-IS0061 | [PP-IS0061] Handle, Mini 2 | 1 | PCE
 | > > > > > | PP-GP0259 | [PP-GP0259] handle-bar_black_v2.5 | 1 | PCE
 | > > > > > > | RM-AB0105 | [RM-AB0105] Chroma Strand ABS Filament, Black 2.85mm, 5 lb reel | 0.0183 | Reel, 5lb |  |  |  | Chroma Strand Labs, LLC |  | Reel, 5lb | 45.00 USD/Reel, 5lb | 0.82 USD
 | > > > > > | HD-MS0030 | [HD-MS0030] Metric Brass Heat-Set Insert for Plastics Tapered, M3-.5 Internal Thread, 3.8mm Length | 3 | PCE |  |  |  | Aero-Space Fasteners and Hardware (formerly Colorado Electronic Hardware) | PEM IUBB-M3-1 | PCE | 0.04 USD/PCE | 0.11 USD
 | > > > > | PP-IS0062 | [PP-IS0062] Upper Relief Mount Assembly, Mini 2 | 1 | PCE
 | > > > > > | PP-GP0266 | [PP-GP0266] strain-relief-upper_black_v3.0 | 1 | PCE
 | > > > > > > | RM-AB0105 | [RM-AB0105] Chroma Strand ABS Filament, Black 2.85mm, 5 lb reel | 0.0064 | Reel, 5lb |  |  |  | Chroma Strand Labs, LLC |  | Reel, 5lb | 45.00 USD/Reel, 5lb | 0.29 USD
 | > > > > > | HD-MS0030 | [HD-MS0030] Metric Brass Heat-Set Insert for Plastics Tapered, M3-.5 Internal Thread, 3.8mm Length | 2 | PCE |  |  |  | Aero-Space Fasteners and Hardware (formerly Colorado Electronic Hardware) | PEM IUBB-M3-1 | PCE | 0.04 USD/PCE | 0.07 USD
 | > > > > | EL-MT0029 | [EL-MT0029] NEMA 17 Stepper Motor, Moons' - NOT INCLUDING wire harness | 1 | PCE |  |  | MS17HD6P4150-01-B | Moons' Industries (America), Inc. | MS17HD6P4150-01-B | PCE | 8.30 USD/PCE | 8.30 USD
 | > > > > | HD-BT0104 | [HD-BT0104] M3 x 8 Bolt, BHCS, SST | 4 | PCE |  |  | MB2510008A20000 | Hardware Speciality | ISO7380-A2-3-8 | PCE | 0.02 USD/PCE | 0.08 USD
 | > > > > | HD-BT0128 | [HD-BT0128] M3 x 6 Bolt, FHCS Black-Oxide | 35 | PCE |  |  | 40921 | Hardware Speciality | DIN7991-10.9-3-6 | PCE | 0.03 USD/PCE | 0.91 USD
 | > > > > | HD-BT0137 | [HD-BT0137] M3 x 8 Bolt, BHCS, Black-Oxide | 12 | PCE |  |  | 40868 | Hardware Speciality | ISO7380-10.9-3-8 | PCE | 0.03 USD/PCE | 0.30 USD
 | > > > > | HD-BT0140 | [HD-BT0140] M3 x 6 Bolt, BHCS Black-Oxide | 4 | PCE |  |  | 408674 | Hardware Speciality | ISO7380-10.9-3-6 | PCE | 0.02 USD/PCE | 0.10 USD
 | > > > > | HD-BT0146 | [HD-BT0146] M3 x 12 BHCS, Black Oxide, Class 10.9 Steel | 1 | PCE |  |  |  | Hardware Speciality | ISO7380-10.9-3-12 | PCE | 0.02 USD/PCE | 0.02 USD
 | > > > > | HD-MS0033 | [HD-MS0033] GT2, 16 Teeth, timing pulley, AL | 1 | PCE |  |  |  | B & B Manufacturing, Inc | 16-2P06M6CA5 | PCE | 2.90 USD/PCE | 2.90 USD
 | > > > > | HD-MS0054 | [HD-MS0054] Bumper Square, rubber | 4 | PCE |  |  |  | Hardware Speciality | BS-19/BLACK | PCE | 0.09 USD/PCE | 0.34 USD
 | > > > > | HD-MS0058 | [HD-MS0058] Wire Tie, 8" Black, pk 1000 | 2 | PCE |  |  | APU-08-18-0-M | Electronics Distributors Corp. | 17-01125 | pkg, 1000 | 0.02 USD/PCE | 0.04 USD
 | > > > > | HD-NT0001 | [HD-NT0001] Metric Zinc-Plated Steel Nylon-Insert Locknut, Class 8, M3 Screw sz, .5MM pitch, 5.5MM W, 4MM H | 1 | PCE |  |  | 40143 | Fastenal | 40143 | PCE | 0.01 USD/PCE | 0.01 USD
 | > > > > | HD-WA0035 | [HD-WA0035] Metric 18-8 Stainless Steel External Serrated Lock Washer, M3 Screw Size, 6mm OD, 0.4mm min Thick | 4 | PCE |  |  | 11511313 | Hardware Speciality | DIN6798A-A2-3 | PCE | 0.01 USD/PCE | 0.05 USD
 | > > > > | HD-WA0038 | [HD-WA0038] Black-Oxide 18-8 Steel Flat Washer, M3 Screw Size, 3.2mm ID, 7.0mm OD | 17 | PCE |  |  |  | Hardware Speciality | DIN125A-A2-3BL | PCE | 0.01 USD/PCE | 0.17 USD
 | > > > > | PP-FP0051 | [PP-FP0051] Top-Plate-Mini_PP-FP0051 | 1 | PCE |  |  |  | Weiser Engineering, Inc. |  | PCE | 19.87 USD/PCE | 19.87 USD
 | > > > > | PP-FP0052 | [PP-FP0052] Right-Side-Mini_PP-FP0052 | 1 | PCE |  |  |  | Weiser Engineering, Inc. |  | PCE | 11.98 USD/PCE | 11.98 USD
 | > > > > | PP-FP0055 | [PP-FP0055] Left-Side-Mini_PP-FP0055 | 1 | PCE |  |  |  | Weiser Engineering, Inc. |  | PCE | 18.52 USD/PCE | 18.52 USD
 | > > > > | PP-MP0149 | [PP-MP0149] Bottom-Plate-Mini_PP-MP0149 | 1 | PCE |  |  |  | Weiser Engineering, Inc. |  | PCE | 29.93 USD/PCE | 29.93 USD
 | > > > | AS-PR0107 | [AS-PR0107] Mini Spool Arm Assembly, v2 | 1 | PCE
 | > > > > | PP-IS0044 | [PP-IS0044] Spool mount A with inserts | 1 | PCE
 | > > > > > | PP-GP0319 | [PP-GP0319] Spool Mount A | 1 | PCE
 | > > > > > > | RM-AB0105 | [RM-AB0105] Chroma Strand ABS Filament, Black 2.85mm, 5 lb reel | 0.0168 | Reel, 5lb |  |  |  | Chroma Strand Labs, LLC |  | Reel, 5lb | 45.00 USD/Reel, 5lb | 0.76 USD
 | > > > > > | HD-MS0158 | [HD-MS0158] Metric Brass Heat-Set Insert For Plastics Tapered, M5-.8 Internal Thread, 6.7mm Length | 2 | PCE |  |  |  | Aero-Space Fasteners and Hardware (formerly Colorado Electronic Hardware) | PEM IUBB-M5-1 | PCE | 0.07 USD/PCE | 0.15 USD
 | > > > > | PP-IS0045 | [PP-IS0045] Spool Mount B with inserts | 1 | PCE
 | > > > > > | PP-GP0318 | [PP-GP0318] Spool Mount B | 1 | PCE
 | > > > > > > | RM-AB0105 | [RM-AB0105] Chroma Strand ABS Filament, Black 2.85mm, 5 lb reel | 0.0141 | Reel, 5lb |  |  |  | Chroma Strand Labs, LLC |  | Reel, 5lb | 45.00 USD/Reel, 5lb | 0.63 USD
 | > > > > > | HD-MS0158 | [HD-MS0158] Metric Brass Heat-Set Insert For Plastics Tapered, M5-.8 Internal Thread, 6.7mm Length | 4 | PCE |  |  |  | Aero-Space Fasteners and Hardware (formerly Colorado Electronic Hardware) | PEM IUBB-M5-1 | PCE | 0.07 USD/PCE | 0.30 USD
 | > > > > | PP-IS0067 | [PP-IS0067] Spool Hinge, Mini 2 | 1 | PCE
 | > > > > > | PP-GP0253 | [PP-GP0253] spool-arm-bracket_black_v1.0 | 1 | PCE
 | > > > > > > | RM-AB0105 | [RM-AB0105] Chroma Strand ABS Filament, Black 2.85mm, 5 lb reel | 0.0047 | Reel, 5lb |  |  |  | Chroma Strand Labs, LLC |  | Reel, 5lb | 45.00 USD/Reel, 5lb | 0.21 USD
 | > > > > > | HD-MS0030 | [HD-MS0030] Metric Brass Heat-Set Insert for Plastics Tapered, M3-.5 Internal Thread, 3.8mm Length | 4 | PCE |  |  |  | Aero-Space Fasteners and Hardware (formerly Colorado Electronic Hardware) | PEM IUBB-M3-1 | PCE | 0.04 USD/PCE | 0.14 USD
 | > > > > | PP-GP0255 | [PP-GP0255] spool-arm_black_v1.4 | 1 | PCE
 | > > > > > | RM-AB0105 | [RM-AB0105] Chroma Strand ABS Filament, Black 2.85mm, 5 lb reel | 0.0072 | Reel, 5lb |  |  |  | Chroma Strand Labs, LLC |  | Reel, 5lb | 45.00 USD/Reel, 5lb | 0.32 USD
 | > > > > | HD-BT0049 | [HD-BT0049] Metric Class 12.9 Socket Head Cap Screw, Alloy Steel, M5 thread, 14MM length, 0.80MM pitch | 2 | PCE |  |  | 1139539 | Fastenal | 1139539 | PCE | 0.02 USD/PCE | 0.05 USD
 | > > > > | HD-BT0120 | [HD-BT0120] Alloy Steel Shoulder Screw, 6mm Diameter x 10mm Long Shoulder, M5 Thread | 2 | PCE |  |  | 40000 | Fastenal | 40000 | PCE | 0.59 USD/PCE | 1.18 USD
 | > > > > | HD-BT0151 | [HD-BT0151] M5 x 20mm SCHS, Black Oxide | 2 | PCE |  |  |  | Hardware Speciality | DIN912-12.9-5-20BL | pkg, 100 | 0.00 USD/PCE | 0.01 USD
 | > > > > | HD-WA0040 | [HD-WA0040] Black-Oxide 18-8 Stainless Steel Flat Washer, M5 Screw Size, 5.3mm ID, 10.0mm OD | 4 | PCE |  |  |  | Hardware Speciality | DIN125A-A2-5BL | PCE | 0.01 USD/PCE | 0.05 USD
 | > > > | AS-PR0112 | [AS-PR0112] Mini 2, Electrical Cover Assembly | 1 | PCE
 | > > > > | AS-CB0073 | [AS-CB0073] Mini Plug to SW Extension Harness Assembly - Hibiscus | 1 | PCE |  |  |  | CCX Corp.(DO NOT USE) |  | PCE | 40.00 USD/PCE | 40.00 USD
 | > > > > > | HD-MS0058 | [HD-MS0058] Wire Tie, 8" Black, pk 1000 | 2 | PCE |  |  | APU-08-18-0-M | Electronics Distributors Corp. | 17-01125 | pkg, 1000 | 0.02 USD/PCE | 0.04 USD
 | > > > > > | EL-MS0143 | [EL-MS0143] Conn Fast Receptacle14-16 AWG .250 - REEL of 2200 Units | 4 | PCE |  | TE Amp | 3-350819-2 | TTI Global Distribution | 3-350820-2 | PCE | 0.07 USD/PCE | 0.28 USD
 | > > > > > | EL-MS0216 | [EL-MS0216] Steward-Ferrite Tubular Bead 19.00mm | 1 | PCE |  |  |  | Sager Electronics | 28B1142-100 | PCE | 0.30 USD/PCE | 0.30 USD
 | > > > > > | EL-WR0121 | [EL-WR0121] 16AWG Stranded Wire – Black | 56 | cm |  |  |  | Allcable | HU15691626BK | ft, 1000 | 0.00 USD/mm | 0.16 USD
 | > > > > > | EL-WR0123 | [EL-WR0123] 16AWG Stranded Wire – White | 56 | cm |  |  |  | Allcable | HU15691626WE | ft, 1000 | 0.00 USD/mm | 0.16 USD
 | > > > > | AS-CB0074 | [AS-CB0074] Mini PS to EinsyRetro Red Wire | 2 | PCE |  |  |  | CCX Corp.(DO NOT USE) |  | PCE | 30.00 USD/PCE | 60.00 USD
 | > > > > > | EL-MS0211 | [EL-MS0211] TE- REEL / RING TONGUE CONN 16-22 AWG #10 PIDG | 1 | PCE |  |  |  | Sager Electronics | 2-36154-2 | PCE | 0.09 USD/PCE | 0.09 USD
 | > > > > > | EL-MS0497 | [EL-MS0497] CONN SPADE TERM 16-22AWG #6 RED | 1 | PCE |  | TE Connectivity | 2-34541-1 | TTI Global Distribution | 2-34541-1 | PCE | 0.10 USD/PCE | 0.10 USD
 | > > > > > | EL-WR0106 | [EL-WR0106] 16AWG Stranded – Red | 20 | cm |  |  |  | Allcable | HU15691626RD | ft, 1000 | 0.00 USD/mm | 0.06 USD
 | > > > > | AS-CB0075 | [AS-CB0075] Earth Ground Extension Wire Harness- Hibiscus | 1 | PCE |  |  |  | CCX Corp.(DO NOT USE) |  | PCE | 10.00 USD/PCE | 10.00 USD
 | > > > > > | EL-MS0141 | [EL-MS0141] Term Ring Non Ins 26-22AWG #4 Order Bulk Only | 2 | PCE |  | Panduit | P22-4R-M | TTI Global Distribution | P22-4R-M | PCE | 0.06 USD/PCE | 0.12 USD
 | > > > > > | EL-MS0205 | [EL-MS0205] Molex-CONN TERM MALE 22-24AWG TIN - Reels of 20K | 2 | PCE |  | Molex | 16-02-0107 | TTI Global Distribution | 16-02-0107 | PCE | 0.02 USD/PCE | 0.04 USD
 | > > > > > | EL-WR0119 | [EL-WR0119] 24AWG Stranded Wire – Green | 20 | cm |  |  |  | Allcable | HU1569247GN | ft, 1000 | 0.00 USD/mm | 0.02 USD
 | > > > > > | PP-MP0059 | [PP-MP0059] CONN HOUSING MALE 2POS .100 | 1 | PCE |  |  |  | TTI Global Distribution | 0701070001 | PCE | 0.12 USD/PCE | 0.12 USD
 | > > > > | AS-CB0076 | [AS-CB0076] Mini SW to PS - Black Wire Extension Harness Assembly - Hibiscus | 1 | PCE |  |  |  | CCX Corp.(DO NOT USE) |  | PCE | 10.00 USD/PCE | 10.00 USD
 | > > > > > | EL-MS0143 | [EL-MS0143] Conn Fast Receptacle14-16 AWG .250 - REEL of 2200 Units | 1 | PCE |  | TE Amp | 3-350819-2 | TTI Global Distribution | 3-350820-2 | PCE | 0.07 USD/PCE | 0.07 USD
 | > > > > > | EL-MS0211 | [EL-MS0211] TE- REEL / RING TONGUE CONN 16-22 AWG #10 PIDG | 1 | PCE |  |  |  | Sager Electronics | 2-36154-2 | PCE | 0.09 USD/PCE | 0.09 USD
 | > > > > > | EL-WR0121 | [EL-WR0121] 16AWG Stranded Wire – Black | 26 | cm |  |  |  | Allcable | HU15691626BK | ft, 1000 | 0.00 USD/mm | 0.08 USD
 | > > > > | AS-CB0077 | [AS-CB0077] Mini SW to PS - White Wire Extension Harness Assembly – Hibiscus | 1 | PCE |  |  |  | CCX Corp.(DO NOT USE) |  | PCE | 10.00 USD/PCE | 10.00 USD
 | > > > > > | EL-MS0143 | [EL-MS0143] Conn Fast Receptacle14-16 AWG .250 - REEL of 2200 Units | 1 | PCE |  | TE Amp | 3-350819-2 | TTI Global Distribution | 3-350820-2 | PCE | 0.07 USD/PCE | 0.07 USD
 | > > > > > | EL-MS0211 | [EL-MS0211] TE- REEL / RING TONGUE CONN 16-22 AWG #10 PIDG | 1 | PCE |  |  |  | Sager Electronics | 2-36154-2 | PCE | 0.09 USD/PCE | 0.09 USD
 | > > > > > | EL-WR0123 | [EL-WR0123] 16AWG Stranded Wire – White | 26 | cm |  |  |  | Allcable | HU15691626WE | ft, 1000 | 0.00 USD/mm | 0.08 USD
 | > > > > | AS-CB0078 | [AS-CB0078] Case Fan Harness- Hibiscus | 1 | PCE |  | Yageo | CC1206JKX7R7BB105
 | > > > > > | EL-FA0045 | [EL-FA0045] Pelonis FAN 80x80x15 High flow | 1 | PCE |  | Pelonis Technologies, Inc. | C8015H24BPLP1b-7 | Pelonis Technologies, Inc. | C8015H24BPLP1b-7 | PCE | 3.88 USD/PCE | 3.88 USD
 | > > > > > | EL-MS0059 | [EL-MS0059] Molex-CONN TERM FEMALE 22-24AWG TIN Reels of 20K | 2 | PCE |  | Molex | 16-02-0086 | TTI Global Distribution | 16-02-0086 | PCE | 0.02 USD/PCE | 0.03 USD
 | > > > > > | PC-CN0003 | [PC-CN0003] Molex - CONN HOUSING 3POS .100 W/LATCH | 1 | PCE |  | Molex | 50-57-9403 | TTI Global Distribution | 0050579403 | PCE | 0.06 USD/PCE | 0.06 USD
 | > > > > | AS-CB0079 | [AS-CB0079] Plug to Ground Post Extension- Hibiscus | 1 | PCE |  |  |  | CCX Corp.(DO NOT USE) |  | PCE | 10.00 USD/PCE | 10.00 USD
 | > > > > > | EL-MS0143 | [EL-MS0143] Conn Fast Receptacle14-16 AWG .250 - REEL of 2200 Units | 1 | PCE |  | TE Amp | 3-350819-2 | TTI Global Distribution | 3-350820-2 | PCE | 0.07 USD/PCE | 0.07 USD
 | > > > > > | EL-MS0246 | [EL-MS0246] Conn Ring 16-22 AWG #4 Red PIDG - Reel 5000 | 1 | PCE |  | TE Connectivity | 2-323758-1 | TTI Global Distribution | 2-323758-1 | PCE | 0.41 USD/PCE | 0.41 USD
 | > > > > > | EL-WR0124 | [EL-WR0124] 16AWG Stranded – Green w/ yellow stripe | 80 | mm |  |  |  | Allcable | HU15691626GN | ft, 1000 | 0.00 USD/mm | 0.03 USD
 | > > > > | AS-CB0080 | [AS-CB0080] PS to Ground Post Extension- Hibiscus | 1 | PCE |  |  |  | CCX Corp.(DO NOT USE) |  | PCE | 10.00 USD/PCE | 10.00 USD
 | > > > > > | EL-MS0211 | [EL-MS0211] TE- REEL / RING TONGUE CONN 16-22 AWG #10 PIDG | 1 | PCE |  |  |  | Sager Electronics | 2-36154-2 | PCE | 0.09 USD/PCE | 0.09 USD
 | > > > > > | EL-MS0246 | [EL-MS0246] Conn Ring 16-22 AWG #4 Red PIDG - Reel 5000 | 1 | PCE |  | TE Connectivity | 2-323758-1 | TTI Global Distribution | 2-323758-1 | PCE | 0.41 USD/PCE | 0.41 USD
 | > > > > > | EL-WR0124 | [EL-WR0124] 16AWG Stranded – Green w/ yellow stripe | 50 | mm |  |  |  | Allcable | HU15691626GN | ft, 1000 | 0.00 USD/mm | 0.02 USD
 | > > > > | AS-CB0081 | [AS-CB0081] Mini PS to EinsyRetro Black Wire | 2 | PCE |  |  |  | CCX Corp.(DO NOT USE) |  | PCE | 10.00 USD/PCE | 20.00 USD
 | > > > > > | EL-MS0211 | [EL-MS0211] TE- REEL / RING TONGUE CONN 16-22 AWG #10 PIDG | 1 | PCE |  |  |  | Sager Electronics | 2-36154-2 | PCE | 0.09 USD/PCE | 0.09 USD
 | > > > > > | EL-MS0497 | [EL-MS0497] CONN SPADE TERM 16-22AWG #6 RED | 1 | PCE |  | TE Connectivity | 2-34541-1 | TTI Global Distribution | 2-34541-1 | PCE | 0.10 USD/PCE | 0.10 USD
 | > > > > > | EL-WR0121 | [EL-WR0121] 16AWG Stranded Wire – Black | 20 | cm |  |  |  | Allcable | HU15691626BK | ft, 1000 | 0.00 USD/mm | 0.06 USD
 | > > > > | DC-LB0153 | [DC-LB0153] Electrical Symbol Labels-On-A-Roll - Protective Earth | 1 | PCE |  |  |  | SETON | 78082 | pkg, 500 | 0.13 USD/PCE | 0.13 USD
 | > > > > | DC-LB0156 | [DC-LB0156] Mini 2 Electric Warning Sticker | 1 | PCE
 | > > > > | EL-HR0109 | [EL-HR0109] Finger Guard 80mm Plastic | 1 | PCE |  | Qualtek | 09080-G | Digi-Key Corp | CR282-ND | PCE | 0.30 USD/PCE | 0.30 USD
 | > > > > | EL-MS0414 | [EL-MS0414] Cartridge Fuse 250V 3.15A Slo-Blo | 2 | PCE |  | Littelfuse | 02153.15MXP | TTI Global Distribution | 576-02153.15MXP | PCE | 0.39 USD/PCE | 0.77 USD
 | > > > > | EL-MS0432 | [EL-MS0432] Clip-On EMI Shielding Gasket 150.876mm length | 1 | PCE |  | TECH-ETCH, Inc. | 187RF1C100-5.94-L-08 | Tech Etch AP | 187RF1C100-5.94-L-08 | PCE | 2.36 USD/PCE | 2.36 USD
 |  |  |  |  |  |  |  |  | TECH-ETCH, Inc. |  | PCE | 2.36 USD/PCE | 2.36 USD
 | > > > > | EL-PS0025 | [EL-PS0025] DELTA POWER SUP 150W 24V 6.25A PNL MT | 1 | PCE |  | Delta Electronics (Americas) Ltd. | PMC-24V150W1AA | Delta Electronics (Americas) Ltd. | PMC-24V150W1AA | PCE | 20.65 USD/PCE | 20.65 USD
 | > > > > | EL-SW0023 | [EL-SW0023] SWITCH ROCKER DPST 20A 250V, Illuminated Red | 1 | PCE |  | E Switch | R5BBLKREDFF2 | Heilind | R5BBLKREDFF2 | PCE | 1.45 USD/PCE | 1.45 USD
 | > > > > | HD-BT0128 | [HD-BT0128] M3 x 6 Bolt, FHCS Black-Oxide | 4 | PCE |  |  | 40921 | Hardware Speciality | DIN7991-10.9-3-6 | PCE | 0.03 USD/PCE | 0.10 USD
 | > > > > | HD-BT0130 | [HD-BT0130] M3 x 8 Bolt, FHCS Black-Oxide | 2 | PCE |  |  |  | Hardware Speciality | DIN7991-10.9-3-8 | PCE | 0.03 USD/PCE | 0.06 USD
 | > > > > | HD-BT0135 | [HD-BT0135] M3 x 25 Bolt FHCS, Black-Oxide, Partially Threaded | 4 | PCE |  |  | 40929 | Fastenal | 40929 | PCE | 0.03 USD/PCE | 0.14 USD
 | > > > > | HD-MS0058 | [HD-MS0058] Wire Tie, 8" Black, pk 1000 | 2 | PCE |  |  | APU-08-18-0-M | Electronics Distributors Corp. | 17-01125 | pkg, 1000 | 0.02 USD/PCE | 0.04 USD
 | > > > > | HD-MS0249 | [HD-MS0249] UV-Resistant Cable Tie Holder, Adhesive Back/Screw Mount, 4-Way, for.18" Maximum Tie, Black | 2 | PCE |  |  | 56-07035 | Hardware Speciality | ABM100-AT-D0FTH-7A-RT-UVB-M | pkg, 500 | 0.00 USD/PCE | 0.00 USD
 | > > > > | HD-NT0001 | [HD-NT0001] Metric Zinc-Plated Steel Nylon-Insert Locknut, Class 8, M3 Screw sz, .5MM pitch, 5.5MM W, 4MM H | 5 | PCE |  |  | 40143 | Fastenal | 40143 | PCE | 0.01 USD/PCE | 0.06 USD
 | > > > > | HD-WA0035 | [HD-WA0035] Metric 18-8 Stainless Steel External Serrated Lock Washer, M3 Screw Size, 6mm OD, 0.4mm min Thick | 1 | PCE |  |  | 11511313 | Hardware Speciality | DIN6798A-A2-3 | PCE | 0.01 USD/PCE | 0.01 USD
 | > > > > | HD-WA0038 | [HD-WA0038] Black-Oxide 18-8 Steel Flat Washer, M3 Screw Size, 3.2mm ID, 7.0mm OD | 4 | PCE |  |  |  | Hardware Speciality | DIN125A-A2-3BL | PCE | 0.01 USD/PCE | 0.04 USD
 | > > > > | PP-FP0147 | [PP-FP0147] Electronics Case, Mini (without back screening) | 1 | PCE |  |  |  | Epocs Manufacturing |  | PCE | 21.50 USD/PCE | 21.50 USD
 | > > > > | PP-MP0028 | [PP-MP0028] Bulgin-AC Power Entry Modules SC MT FUSED .25" TAB | 1 | PCE |  |  | PF0030/63 | Heilind | PF0030/63 | PCE | 3.10 USD/PCE | 3.10 USD
 |  |  |  |  |  |  |  |  | Heilind Electronics | PF0030/63 | PCE | 3.10 USD/PCE | 3.10 USD
 | > > > | AS-TH0066 | [AS-TH0066] Titan Aero Assembly, Mini 2 | 1 | PCE
 | > > > > | AS-CB0061 | [AS-CB0061] Extruder Motor Harness v2Aero | 1 | PCE |  |  |  | CCX Corp.(DO NOT USE) |  | PCE | 10.00 USD/PCE | 10.00 USD
 | > > > > > | EL-MS0351 | [EL-MS0351] JST - CONN TERM CRIMP PH 24-30AWG - 8,000 Unit Reel | 4 | PCE |  | JST Sales America | SPH-002T-P0.5S | Future Electronics |  | PCE | 0.01 USD/PCE | 0.05 USD
 | > > > > > | EL-MS0355 | [EL-MS0355] CONN HOUSING PH 6POS 2MM WHITE | 1 | PCE |  | JST Sales America | PHR-6 | Future Electronics | PHR-6 | PCE | 0.04 USD/PCE | 0.04 USD
 | > > > > > | EL-MS0480 | [EL-MS0480] CONN TERM MALE 20-24AWG TIN (Micro-Fit 3.0™) 12K REEL | 4 | PCE |  | Molex | 0430310001 | TTI Global Distribution | 43031-0001 | PCE | 0.02 USD/PCE | 0.07 USD
 | > > > > > | EL-WR0103 | [EL-WR0103] 24AWG Stranded – Red | 18 | cm |  |  |  | Allcable | HU1569247RD | ft, 1000 | 0.00 USD/mm | 0.01 USD
 | > > > > > | EL-WR0105 | [EL-WR0105] 24AWG Stranded – Black | 18 | cm |  |  |  | Allcable | HU1569247BK | ft, 1000 | 0.00 USD/mm | 0.01 USD
 | > > > > > | EL-WR0107 | [EL-WR0107] 24AWG Stranded – White | 18 | cm |  |  |  | Allcable | HU1569247WE | ft, 1000 | 0.00 USD/mm | 0.01 USD
 | > > > > > | EL-WR0119 | [EL-WR0119] 24AWG Stranded Wire – Green | 18 | cm |  |  |  | Allcable | HU1569247GN | ft, 1000 | 0.00 USD/mm | 0.01 USD
 | > > > > > | PC-CN0101 | [PC-CN0101] CONN PLUG 20POS 3MM VERT DUAL | 1 | PCE |  | Molex | 43020-2001 | TTI Global Distribution | 43020-2001 | PCE | 0.59 USD/PCE | 0.59 USD
 | > > > > | AS-CB0062 | [AS-CB0062] v2Aero Extruder Blower Harness | 1 | PCE |  |  |  | CCX Corp.(DO NOT USE) |  | PCE | 40.00 USD/PCE | 40.00 USD
 | > > > > > | EL-FA0047 | [EL-FA0047] RB5015 Series DC Blower, 51 x 51 x 15mm, 24V | 1 | PCE |  | Pelonis Technologies, Inc. | RBH5015B2 | Pelonis Technologies, Inc. | RBH5015B2 | PCE | 6.45 USD/PCE | 6.45 USD
 | > > > > > | EL-MS0480 | [EL-MS0480] CONN TERM MALE 20-24AWG TIN (Micro-Fit 3.0™) 12K REEL | 2 | PCE |  | Molex | 0430310001 | TTI Global Distribution | 43031-0001 | PCE | 0.02 USD/PCE | 0.04 USD
 | > > > > | AS-CB0063 | [AS-CB0063] v2 Aero Zero Sense Harness | 1 | PCE |  |  |  | CCX Corp.(DO NOT USE) |  | PCE | 10.00 USD/PCE | 10.00 USD
 | > > > > > | EL-MS0480 | [EL-MS0480] CONN TERM MALE 20-24AWG TIN (Micro-Fit 3.0™) 12K REEL | 1 | PCE |  | Molex | 0430310001 | TTI Global Distribution | 43031-0001 | PCE | 0.02 USD/PCE | 0.02 USD
 | > > > > > | EL-MS0141 | [EL-MS0141] Term Ring Non Ins 26-22AWG #4 Order Bulk Only | 1 | PCE |  | Panduit | P22-4R-M | TTI Global Distribution | P22-4R-M | PCE | 0.06 USD/PCE | 0.06 USD
 | > > > > > | EL-WR0040 | [EL-WR0040] Wire - Single Conductor 20AWG SOLID PTFE, RED | 24 | cm |  | Thermax | M16878/4BGA-2 | Hardware Speciality |  | ft, 500 | 0.00 USD/mm | 0.24 USD
 | > > > > | AS-CB0064 | [AS-CB0064] v2Aero Heatsink Fan Harness | 1 | PCE |  |  |  | CCX Corp.(DO NOT USE) |  | PCE | 20.00 USD/PCE | 20.00 USD
 | > > > > > | EL-FA0034 | [EL-FA0034] Pelonis FAN 5V 40x40x10mm Low flow | 1 | PCE |  | Pelonis Technologies, Inc. | C4010L05BPLB1b-7 | Pelonis Technologies, Inc. | C4010L05BPLB1b-7 | PCE | 3.92 USD/PCE | 3.92 USD
 | > > > > > | EL-MS0480 | [EL-MS0480] CONN TERM MALE 20-24AWG TIN (Micro-Fit 3.0™) 12K REEL | 2 | PCE |  | Molex | 0430310001 | TTI Global Distribution | 43031-0001 | PCE | 0.02 USD/PCE | 0.04 USD
 | > > > > | AS-CB0066 | [AS-CB0066] v2Aero Thermistor Harness | 1 | PCE |  |  |  | CCX Corp.(DO NOT USE) |  | PCE | 10.00 USD/PCE | 10.00 USD
 | > > > > > | EL-MS0059 | [EL-MS0059] Molex-CONN TERM FEMALE 22-24AWG TIN Reels of 20K | 2 | PCE |  | Molex | 16-02-0086 | TTI Global Distribution | 16-02-0086 | PCE | 0.02 USD/PCE | 0.03 USD
 | > > > > > | EL-MS0480 | [EL-MS0480] CONN TERM MALE 20-24AWG TIN (Micro-Fit 3.0™) 12K REEL | 2 | PCE |  | Molex | 0430310001 | TTI Global Distribution | 43031-0001 | PCE | 0.02 USD/PCE | 0.04 USD
 | > > > > > | EL-WR0103 | [EL-WR0103] 24AWG Stranded – Red | 12 | cm |  |  |  | Allcable | HU1569247RD | ft, 1000 | 0.00 USD/mm | 0.01 USD
 | > > > > > | EL-WR0105 | [EL-WR0105] 24AWG Stranded – Black | 12 | cm |  |  |  | Allcable | HU1569247BK | ft, 1000 | 0.00 USD/mm | 0.01 USD
 | > > > > > | PC-CN0001 | [PC-CN0001] Molex-Conn Housing 2POS .100 W/Latch | 1 | PCE |  | Molex | 050579402 | Sager Electronics | 050579402 | PCE | 0.06 USD/PCE | 0.06 USD
 | > > > > | AS-HE0025 | [AS-HE0025] v2Aero Hotend Assembly | 1 | PCE
 | > > > > > | AS-HE0026 | [AS-HE0026] Universal E3D Aero Hot End 3.0mm, 0.5mm Nozzle, Hot-Tightened, Pre-Assembled | 1 | PCE |  | E3D-online | CC-AO-TITAN-AERO-UNI-500-AS | E3D-online | CC-AO-TITAN-AERO-UNI-500-AS | PCE | 42.89 USD/PCE | 42.89 USD
 | > > > > > | EL-MS0480 | [EL-MS0480] CONN TERM MALE 20-24AWG TIN (Micro-Fit 3.0™) 12K REEL | 2 | PCE |  | Molex | 0430310001 | TTI Global Distribution | 43031-0001 | PCE | 0.02 USD/PCE | 0.04 USD
 | > > > > | PP-IS0053 | [PP-IS0053] Extruder Mount With Inserts, Mini 2 | 1 | PCE
 | > > > > > | PP-GP0341 | [PP-GP0341] Extruder Mount, Mini 2 | 1 | PCE
 | > > > > > > | RM-AB0104 | [RM-AB0104] Chroma Strand ABS Filament, Lulzbot Green 2.85mm, 5 lb reel | 0.0137 | Reel, 5lb |  | Chroma Strand Labs, LLC |  | Chroma Strand Labs, LLC |  | Reel, 5lb | 45.00 USD/Reel, 5lb | 0.62 USD
 | > > > > > | HD-MS0030 | [HD-MS0030] Metric Brass Heat-Set Insert for Plastics Tapered, M3-.5 Internal Thread, 3.8mm Length | 3 | PCE |  |  |  | Aero-Space Fasteners and Hardware (formerly Colorado Electronic Hardware) | PEM IUBB-M3-1 | PCE | 0.04 USD/PCE | 0.11 USD
 | > > > > | PP-IS0057 | [PP-IS0057] Universal Blower shroud w/ inserts | 1 | PCE
 | > > > > > | PP-GP0342 | [PP-GP0342] Universal Blower Duct | 1 | PCE
 | > > > > > > | RM-AB0105 | [RM-AB0105] Chroma Strand ABS Filament, Black 2.85mm, 5 lb reel | 0.0121 | Reel, 5lb |  |  |  | Chroma Strand Labs, LLC |  | Reel, 5lb | 45.00 USD/Reel, 5lb | 0.54 USD
 | > > > > > | HD-MS0030 | [HD-MS0030] Metric Brass Heat-Set Insert for Plastics Tapered, M3-.5 Internal Thread, 3.8mm Length | 1 | PCE |  |  |  | Aero-Space Fasteners and Hardware (formerly Colorado Electronic Hardware) | PEM IUBB-M3-1 | PCE | 0.04 USD/PCE | 0.04 USD
 | > > > > | DC-LB0155 | [DC-LB0155] Caution Hot Symbol Size, 0.5mm | 1 | PCE
 | > > > > | EL-MT0040 | [EL-MT0040] NEMA 17 Half Height Stepper Motor, Moons | 1 | PCE |  | Moons' Industries (America), Inc. | MS17HD4P4150-07 | Moons' Industries (America), Inc. |  | PCE | 7.74 USD/PCE | 7.74 USD
 | > > > > | HD-BT0039 | [HD-BT0039] Metric Class 12.9 Socket Head Cap Screw, Alloy Steel, M3 Thread, 12MM Length, 0.50MM Pitch | 4 | PCE |  |  | 39505 | Hardware Speciality | DIN912-12.9-3-12 | PCE | 0.02 USD/PCE | 0.09 USD
 | > > > > | HD-BT0042 | [HD-BT0042] Metric Class 12.9 Socket Head Cap Screw, Alloy Steel, M3 Thread, 30MM Length, 0.50MM Pitch | 1 | PCE |  |  |  | Hardware Speciality | DIN912-12.9-3-30 | PCE | 0.03 USD/PCE | 0.03 USD
 | > > > > | HD-BT0043 | [HD-BT0043] Metric Class 12.9 Socket Head Cap Screw, Alloy Steel, M3 Thread, 35MM Length, 0.50MM Pitch | 3 | PCE |  |  |  | Hardware Speciality | DIN912-12.9-3-35 | PCE | 0.04 USD/PCE | 0.13 USD
 | > > > > | HD-BT0146 | [HD-BT0146] M3 x 12 BHCS, Black Oxide, Class 10.9 Steel | 2 | PCE |  |  |  | Hardware Speciality | ISO7380-10.9-3-12 | PCE | 0.02 USD/PCE | 0.05 USD
 | > > > > | HD-BT0171 | [HD-BT0171] Black Oxide Class 10.9 Steel Button-Head Socket Cap Screw M3 Size, 20 mm Length, .5 mm Pitch, pkg 100 | 2 | PCE |  |  |  | Hardware Speciality | ISO7380-10.9-3-20 | PCE | 0.04 USD/PCE | 0.08 USD
 | > > > > | HD-BT0197 | [HD-BT0197] M4 Thumb Screw for Aero | 1 | PCE |  | E3D-online | TITAN-THUMBWHEEL | E3D-online | TITAN-THUMBWHEEL | PCE | 1.82 USD/PCE | 1.82 USD
 | > > > > | HD-MS0430 | [HD-MS0430] E3D, Idler Spring for Aero | 1 | PCE |  | E3D-online | TITAN-Spring | E3D-online | TITAN-SPRING | PCE | 0.25 USD/PCE | 0.25 USD
 | > > > > | HD-MS0446 | [HD-MS0446] MR95-2RS Radial Ball Bearing Double Sealed Bore Dia. 5mm OD 9mm Width 3mm | 2 | PCE |  |  |  | JSB Great Bearings |  | PCE | 0.45 USD/PCE | 0.90 USD
 | > > > > | HD-NT0011 | [HD-NT0011] M4 Nut, Steel, Zinc Plated | 1 | PCE |  |  | 40303 | Fastenal | 40303 | PCE | 0.01 USD/PCE | 0.01 USD
 | > > > > | HD-WA0027 | [HD-WA0027] Metric 18-8 Stainless Steel Internal-Tooth Lock Washer, M3 Screw Size, 6MM OD, .4MM Min Thick | 1 | PCE |  |  | WF6330000A20000 | Fastenal | WF6330000A20000 | PCE | 0.01 USD/PCE | 0.01 USD
 | > > > > | HD-WA0038 | [HD-WA0038] Black-Oxide 18-8 Steel Flat Washer, M3 Screw Size, 3.2mm ID, 7.0mm OD | 2 | PCE |  |  |  | Hardware Speciality | DIN125A-A2-3BL | PCE | 0.01 USD/PCE | 0.02 USD
 | > > > > | PP-FP0135 | [PP-FP0135] E3D Mirrored Aero Idler Lever | 1 | PCE |  | E3D-online | TITAN-IDLER-2.2 | E3D-online | TITAN-IDLER-LH | PCE | 4.36 USD/PCE | 4.36 USD
 | > > > > | PP-FP0136 | [PP-FP0136] E3D Mirrored Aero 2.85mm Filament Guide | 1 | PCE |  | E3D-online | TITAN-PTFE-HOLDER-300-LH | E3D-online | TITAN-PTFE-HOLDER-300-LH | PCE | 0.16 USD/PCE | 0.16 USD
 | > > > > | PP-FP0137 | [PP-FP0137] E3D Aero Acetal Gear w/ Filament Drive Shaft - Shiny | 1 | PCE |  | E3D-online | TITAN-HOBB-SS | E3D-online | TITAN-HOBB-SS | PCE | 8.22 USD/PCE | 8.22 USD
 | > > > > | PP-MP0204 | [PP-MP0204] Aero Mirrored Body w/ Threaded Insert | 1 | PCE |  | E3D-online | TITAN-BODY-LH | E3D-online | TITAN-BODY-LH | PCE | 0.74 USD/PCE | 0.74 USD
 | > > > > | PP-MP0205 | [PP-MP0205] E3D Aero Steel Pinion Gear w/ set screw | 1 | PCE |  | E3D-online | TITAN-GEAR-SMALL | E3D-online | TITAN-GEAR-SMALL | PCE | 0.98 USD/PCE | 0.98 USD
 | > > > | PP-GP0247 | [PP-GP0247] USB support mini v1.5 | 1 | PCE
 | > > > > | RM-AB0105 | [RM-AB0105] Chroma Strand ABS Filament, Black 2.85mm, 5 lb reel | 0.0009 | Reel, 5lb |  |  |  | Chroma Strand Labs, LLC |  | Reel, 5lb | 45.00 USD/Reel, 5lb | 0.04 USD
 | > > > | PP-GP0307 | [PP-GP0307] Belt Tensioning Collar | 2 | PCE
 | > > > > | RM-AB0105 | [RM-AB0105] Chroma Strand ABS Filament, Black 2.85mm, 5 lb reel | 0.0002 | Reel, 5lb |  |  |  | Chroma Strand Labs, LLC |  | Reel, 5lb | 45.00 USD/Reel, 5lb | 0.01 USD
 | > > > | PP-GP0320 | [PP-GP0320] X Carriage Cap, Mini 2 | 1 | PCE
 | > > > > | RM-AB0105 | [RM-AB0105] Chroma Strand ABS Filament, Black 2.85mm, 5 lb reel | 0.0123 | Reel, 5lb |  |  |  | Chroma Strand Labs, LLC |  | Reel, 5lb | 45.00 USD/Reel, 5lb | 0.55 USD
 | > > > | PP-GP0333 | [PP-GP0333] X Belt Tensioner Post | 1 | PCE
 | > > > > | RM-AB0105 | [RM-AB0105] Chroma Strand ABS Filament, Black 2.85mm, 5 lb reel | 0.0004 | Reel, 5lb |  |  |  | Chroma Strand Labs, LLC |  | Reel, 5lb | 45.00 USD/Reel, 5lb | 0.02 USD
 | > > > | PP-GP0338 | [PP-GP0338] Heatsink frame, einsy | 1 | PCE
 | > > > > | RM-AB0105 | [RM-AB0105] Chroma Strand ABS Filament, Black 2.85mm, 5 lb reel | 0.0007 | Reel, 5lb |  |  |  | Chroma Strand Labs, LLC |  | Reel, 5lb | 45.00 USD/Reel, 5lb | 0.03 USD
 | > > > | PP-IS0054 | [PP-IS0054] Top Cable Bracket with inserts, Mini 2 | 2 | PCE
 | > > > > | PP-GP0326 | [PP-GP0326] Top Cable Bracket | 1 | PCE
 | > > > > > | RM-AB0105 | [RM-AB0105] Chroma Strand ABS Filament, Black 2.85mm, 5 lb reel | 0.0018 | Reel, 5lb |  |  |  | Chroma Strand Labs, LLC |  | Reel, 5lb | 45.00 USD/Reel, 5lb | 0.08 USD
 | > > > > | HD-MS0030 | [HD-MS0030] Metric Brass Heat-Set Insert for Plastics Tapered, M3-.5 Internal Thread, 3.8mm Length | 2 | PCE |  |  |  | Aero-Space Fasteners and Hardware (formerly Colorado Electronic Hardware) | PEM IUBB-M3-1 | PCE | 0.04 USD/PCE | 0.07 USD
 | > > > | PP-IS0055 | [PP-IS0055] Side Cable Bracket with inserts, Mini 2 | 1 | PCE
 | > > > > | PP-GP0327 | [PP-GP0327] Side Cable Bracket | 1 | PCE
 | > > > > > | RM-AB0105 | [RM-AB0105] Chroma Strand ABS Filament, Black 2.85mm, 5 lb reel | 0.0018 | Reel, 5lb |  |  |  | Chroma Strand Labs, LLC |  | Reel, 5lb | 45.00 USD/Reel, 5lb | 0.08 USD
 | > > > > | HD-MS0030 | [HD-MS0030] Metric Brass Heat-Set Insert for Plastics Tapered, M3-.5 Internal Thread, 3.8mm Length | 2 | PCE |  |  |  | Aero-Space Fasteners and Hardware (formerly Colorado Electronic Hardware) | PEM IUBB-M3-1 | PCE | 0.04 USD/PCE | 0.07 USD
 | > > > | HD-BL0033 | [HD-BL0033] 744-2P06-2MR-744-06 / GT 3 Single Sided Neoprene Belt - 744mm by 6mm belt | 2 | PCE |  |  |  | B & B Manufacturing, Inc | 744-2P06-2MR-744-06 | PCE | 2.06 USD/PCE | 4.12 USD
 | > > > | HD-BT0039 | [HD-BT0039] Metric Class 12.9 Socket Head Cap Screw, Alloy Steel, M3 Thread, 12MM Length, 0.50MM Pitch | 3 | PCE |  |  | 39505 | Hardware Speciality | DIN912-12.9-3-12 | PCE | 0.02 USD/PCE | 0.07 USD
 | > > > | HD-BT0104 | [HD-BT0104] M3 x 8 Bolt, BHCS, SST | 4 | PCE |  |  | MB2510008A20000 | Hardware Speciality | ISO7380-A2-3-8 | PCE | 0.02 USD/PCE | 0.08 USD
 | > > > | HD-BT0128 | [HD-BT0128] M3 x 6 Bolt, FHCS Black-Oxide | 36 | PCE |  |  | 40921 | Hardware Speciality | DIN7991-10.9-3-6 | PCE | 0.03 USD/PCE | 0.94 USD
 | > > > | HD-BT0137 | [HD-BT0137] M3 x 8 Bolt, BHCS, Black-Oxide | 4 | PCE |  |  | 40868 | Hardware Speciality | ISO7380-10.9-3-8 | PCE | 0.03 USD/PCE | 0.10 USD
 | > > > | HD-BT0204 | [HD-BT0204] Black-Oxide Alloy Steel Hex Drive Flat Head Screw M3 x 0.5 mm Thread, 22 mm Long | 1 | PCE |  |  |  | Hardware Speciality | DIN7991-10.9-3-22 | PCE | 0.05 USD/PCE | 0.05 USD
 | > > > | HD-BT0206 | [HD-BT0206] Black-Oxide Alloy Steel Hex Drive Flat Head Screw M3 x 0.5 mm Thread, 25 mm Long | 2 | PCE |  |  |  | Hardware Speciality | DIN7991-10.9-3-25 | pkg, 50 | 0.00 USD/PCE | 0.00 USD
 | > > > | HD-BT0210 | [HD-BT0210] Blue-Dyed Zinc-Plated Alloy Steel Socket Head Screw M3 x 0.5 mm Thread, 30 mm Long | 1 | PCE |  |  |  | Hardware Speciality | DIN912-12.9-3-30ZPTBLUE | pkg, 50 | 0.00 USD/PCE | 0.00 USD
 | > > > | HD-BT0211 | [HD-BT0211] Blue-Dyed Zinc-Plated Alloy Steel Socket Head Screw M3 x 0.5 mm Thread, 8 mm Long | 2 | PCE |  |  |  | Hardware Speciality | DIN912-12.9-3-8ZPTBLUE | pkg, 100 | 0.00 USD/PCE | 0.00 USD
 | > > > | HD-MS0058 | [HD-MS0058] Wire Tie, 8" Black, pk 1000 | 9 | PCE |  |  | APU-08-18-0-M | Electronics Distributors Corp. | 17-01125 | pkg, 1000 | 0.02 USD/PCE | 0.17 USD
 | > > > | HD-MS0249 | [HD-MS0249] UV-Resistant Cable Tie Holder, Adhesive Back/Screw Mount, 4-Way, for.18" Maximum Tie, Black | 2 | PCE |  |  | 56-07035 | Hardware Speciality | ABM100-AT-D0FTH-7A-RT-UVB-M | pkg, 500 | 0.00 USD/PCE | 0.00 USD
 | > > > | HD-MS0463 | [HD-MS0463] Insul-Fab Fujipoly Thermal Gap Filler, 70 pc sheet | 2 | PCE |  |  |  | InsulFab | ALEO HD-MS0463 | PCE | 0.62 USD/PCE | 1.24 USD
 | > > > | HD-NT0001 | [HD-NT0001] Metric Zinc-Plated Steel Nylon-Insert Locknut, Class 8, M3 Screw sz, .5MM pitch, 5.5MM W, 4MM H | 2 | PCE |  |  | 40143 | Fastenal | 40143 | PCE | 0.01 USD/PCE | 0.02 USD
 | > > > | HD-RD0035 | [HD-RD0035] 8mm Smooth rod, 315mm, 300 Series Stainless Steel | 2 | PCE |  | Igus, Inc. | EWMR-08-315X | Igus, Inc. | EWMR-08-315X | PCE | 5.26 USD/PCE | 10.52 USD
 | > > > | HD-WA0035 | [HD-WA0035] Metric 18-8 Stainless Steel External Serrated Lock Washer, M3 Screw Size, 6mm OD, 0.4mm min Thick | 1 | PCE |  |  | 11511313 | Hardware Speciality | DIN6798A-A2-3 | PCE | 0.01 USD/PCE | 0.01 USD
 | > > > | HD-WA0038 | [HD-WA0038] Black-Oxide 18-8 Steel Flat Washer, M3 Screw Size, 3.2mm ID, 7.0mm OD | 8 | PCE |  |  |  | Hardware Speciality | DIN125A-A2-3BL | PCE | 0.01 USD/PCE | 0.08 USD
 | > > > | PC-AS0054 | [PC-AS0054] Einsy Retro Board | 1 | PCE |  |  |  | Ultimachine | Einsy | PCE | 58.69 USD/PCE | 58.69 USD
 | > > > | PP-MP0210 | [PP-MP0210] Heatsink Einsy | 1 | PCE |  |  |  | Colorado Waterjet |  | PCE | 1.10 USD/PCE | 1.10 USD
 | > > | AS-HB0001 | [AS-HB0001] Mini Glass/PEI Print Surface | 1 | PCE
 | > > > | HD-MS0350 | [HD-MS0350] PEI (10mil) with 3M 468 adhesive attached, heat-treated, Mini | 1 | PCE
 | > > > > | HD-MS0310 | [HD-MS0310] TAPE3M468MP.005X26.000X60YD .005" THK 3M ADHESIVE 468MP 26" WIDE X 60 YARDS | 420.25 | cm² |  |  |  | HBM Supply | 3M 468MP | Roll, 26" x 2160" | 0.00 USD/cm² | 0.53 USD
 | > > > > | HD-MS0311 | [HD-MS0311] SULT1000NA.010X26.000X90FT - 0.010 X 26.000 WIDE X 90 FT NAT ULTEM 1000 FILM | 420.25 | cm² |  |  |  | Polymershapes LLC | 70325327 | Roll, 26" x 1080" | 0.00 USD/cm² | 2.00 USD
 | > > > | HD-MS0211-1 | [HD-MS0211-1] Mini - Borosilicate Glass Bed 170mm x 170mm x +/-.76mm (6.693" x 6.693" +/-.030) Edges Ground and Chamfered | 1 | PCE |  |  |  | Allen Scientific Glass, Inc. | ASG3107 | PCE | 7.72 USD/PCE | 7.72 USD
 | > > | AS-HB0005 | [AS-HB0005] Mini Etched Modular Print Bed Heater | 1 | PCE |  |  |  | TEMPCO ELECTRIC HEATER CORP | SHS80986 | PCE | 28.35 USD/PCE | 28.35 USD
 | > > | DC-LB0146 | [DC-LB0146] Mini 2 Certification Sticker | 1 | PCE |  |  |  | MyAssetTag.com | Q-MAT-P-00337 | PCE | 5.38 USD/PCE | 5.38 USD
 | > > | DC-MS0071 | [DC-MS0071] Quality Assurance Record, Mini 2 | 1 | PCE |  |  |  | Coren Printing Inc. |  | PCE | 0.31 USD/PCE | 0.31 USD
 | > > | EL-CA0030 | [EL-CA0030] North American - 6ft 18AWG Power Cord Cable w/ 3 Conductor PC Power Connector Socket (C13/5-15P) - Black, 5279 | 1 | PCE |  |  | 3271V86 | Linvox | 3271V86 | PCE | 1.33 USD/PCE | 1.33 USD
 | > > | EL-CA0063 | [EL-CA0063] 6ft Tripp Lite - USB 2.0 A/B Gold Device Cable Ferrite Chokes A Male B Male | 1 | PCE |  |  | U023-006 | Electronics Distributors Corp. | U023-006 | PCE | 3.21 USD/PCE | 3.21 USD
 | > > | EL-MS0385 | [EL-MS0385] Verbatim 8GB SDHC Class 10 UHS-I / Bulk | 1 | PCE |  |  | 99197 – 8GB SDHC Memory Card Class 10 UHS-1 | Verbatim Americas, LLC | 99197 | PCE | 4.45 USD/PCE | 4.45 USD
 | > > | HD-BT0082 | [HD-BT0082] Metric 18-8 SS Flat Head Socket Cap Screw M3 Size, 16mm Length, .50mm Pitch | 4 | PCE |  |  |  | Hardware Speciality | DIN7991A2-3-16 | PCE | 0.02 USD/PCE | 0.10 USD
 | > > | HD-MS0287 | [HD-MS0287] Metric 18-8 Stainless Steel Unthreaded Spacer, 8mm OD, 10mm Length, M3 Screw Size | 4 | PCE |  |  |  | Hardware Speciality | M0599-3-SS | PCE | 0.46 USD/PCE | 1.84 USD
 | > > | PP-MP0082 | [PP-MP0082] Bed Leveling Washer, 303 SST | 4 | PCE |  |  |  | Precision Metal Manufacturing, LLC |  | PCE | 0.92 USD/PCE | 3.68 USD
 | > | DC-LB0174 | [DC-LB0174] P65 Warning Label | 1 | PCE |  |  |  | Amazon | B07G4KF2P2 | PCE | 13.29 USD/PCE | 13.29 USD
 | > | AS-PK0028 | [AS-PK0028] Mini 2 Documentation Bag | 1 | PCE
 | > > | AS-PK0032 | [AS-PK0032] Polylite Sample Filament Kit, Mini 2 | 1 | PCE
 | > > > | DC-LB0111 | [DC-LB0111] Filament Samples Bag Label - Mini | 1 | PCE |  |  |  | Sticker Giant |  | PCE | 0.13 USD/PCE | 0.13 USD
 | > > > | RM-PL0134 | [RM-PL0134] PolyLite PLA LulzBot Green, 2.85mm 3kg Reel – Polymaker | 0.01 | Reel, 3kg |  | JF Polymers (Suzhou) Co. Ltd |  | JF Polymers (Suzhou) Co. Ltd |  | Reel, 3kg | 30.00 USD/Reel, 3kg | 0.22 USD
 |  |  |  |  |  |  |  |  | Polymaker N. America |  | Reel, 3kg | 30.00 USD/Reel, 3kg | 0.22 USD
 | > > > | SH-PG0030 | [SH-PG0030] 8X10 2MIL RECLOSABLE BAG 1M/CT | 1 | PCE |  |  |  | Uline | S-1700 | pkg, 1000 | 0.05 USD/PCE | 0.05 USD
 | > > | DC-LB0095 | [DC-LB0095] LulzBot Logo Sticker, 3 - Inch | 1 | PCE |  |  |  | Sticker Giant |  | PCE | 0.25 USD/PCE | 0.25 USD
 | > > | DC-MS0066 | [DC-MS0066] Quick Start Quide, Mini 2 | 1 | PCE |  |  |  | Color Pro |  | PCE | 2.13 USD/PCE | 2.13 USD
 | > > | SH-PG0083 | [SH-PG0083] 9 x 12" 8 Mil Reclosable Bags | 1 | PCE |  |  |  | Uline | S-13440 | pkg, 500 | 0.29 USD/PCE | 0.29 USD
 | > | AS-PK0029 | [AS-PK0029] Universal Tool Kit | 1 | PCE
 | > > | AS-PK0010 | [AS-PK0010] 90 mm wiper pad set | 1 | PCE, 90mm, 5 pack
 | > > > | AS-PR0023 | [AS-PR0023] 90mm Cut wiper pad | 5 | PCE, 90mm
 | > > > > | HD-MS0550 | [HD-MS0550] Synthetic Felt Plain Backing, 1" Wide, 1/4" Thick - 50 ft | 600 | inch(es) |  |  |  | McMaster-Carr | 88085K311 | ft, 50 | 0.04 USD/inch(es) | 24.00 USD
 | > > > > | RM-AB0105 | [RM-AB0105] Chroma Strand ABS Filament, Black 2.85mm, 5 lb reel | 0.0529 | Reel, 5lb |  |  |  | Chroma Strand Labs, LLC |  | Reel, 5lb | 45.00 USD/Reel, 5lb | 2.38 USD
 | > > > | SH-PG0002 | [SH-PG0002] 3 x 4" 2 Mil Reclosable Polypropylene Bags | 1 | PCE |  |  | S-1292 | Uline | S-1292 | pkg, 1000 | 0.02 USD/PCE | 0.02 USD
 | > > | AS-PK0027 | [AS-PK0027] Clam knife with label | 1 | PCE
 | > > > | DC-LB0062 | [DC-LB0062] Clam Knife Sheath Sticker - Caution Sharp Blade! (1"x2.5" Rectangle) | 1 | PCE |  |  |  | Sticker Giant |  | PCE | 0.04 USD/PCE | 0.04 USD
 | > > > | TL-HD0359 | [TL-HD0359] 7 1/2" Nylon Handle Clam Knife - Laser Etched with "Sharp" Icon | 1 | PCE |  |  |  | Printed Solid, Inc. |  | PCE | 0.65 USD/PCE | 0.65 USD
 | > > > > | SR-MN0010 | [SR-MN0010] Laser Etching Service for Clam Knive, TL-HD0009 | 1 | PCE |  |  |  | Laser Engraving Design |  | PCE | 0.51 USD/PCE | 0.51 USD
 | > > > > | TL-HD0009 | [TL-HD0009] 7 1/2" Nylon Handle Clam Knife | 1 | PCE |  |  |  | WEBstaurant Store | 35340592 | PCE | 2.03 USD/PCE | 2.03 USD
 | > > | AS-PK0030 | [AS-PK0030] Tool Sub Kit, Universal | 1 | PCE
 | > > > | TL-HD0008 | [TL-HD0008] Stainless Steel Pocket Rule Semiflexible, Metric Grads, 150 mm Length | 1 | PCE |  |  |  | Image Supply Service, Inc. | 90013A | PCE | 1.99 USD/PCE | 1.99 USD
 | > > > | TL-HD0046 | [TL-HD0046] PRO DENTAL PICK (PROBE) (DP-19) M S V - in a protective sleeve or with a safety cap | 1 | PCE |  |  |  | PRECISION PRODUCTS.US | J1031S | PCE | 1.19 USD/PCE | 1.19 USD
 | > > > | TL-HD0049 | [TL-HD0049] 6" Deluxe Bent Stainless Steel Tweezers with Serrated Teeth and Safety Cap | 1 | PCE |  |  |  | ROEDER INDUSTRIES INC. | TWE6 6'' Tweezers | PCE | 1.44 USD/PCE | 1.44 USD
 | > > | TL-CS0117 | [TL-CS0117] Elmer's Glue Sticks, .77oz | 1 | PCE |  |  |  | Amazon | B000U6FJQE | PCE | 0.66 USD/PCE | 0.66 USD
 | > > | TL-CS0255 | [TL-CS0255] Scotch Brite Maroon Pad, 2"X 3" | 2 | PCE
 | > > > | TL-MS0568 | [TL-MS0568] Abrasive Roll, 2" W x 30 ft. L Roll - Maroon | 76.2 | mm |  |  |  | Zoro Tools | G1446654 | ft, 30 | 0.00 USD/mm | 0.25 USD
 | > > | TL-HD0048 | [TL-HD0048] Elmer's X-Acto No. 1 Precision Knife - Aluminum | 1 | PCE |  |  |  | Amazon |  | PCE | 2.00 USD/PCE | 2.00 USD
 | > > | TL-HD0050 | [TL-HD0050] 6" Long Nose Pliers | 1 | PCE |  |  |  | Electronics Distributors Corp. |  | PCE | 2.60 USD/PCE | 2.60 USD
 | > > | TL-HD0468 | [TL-HD0468] 7 pc Long Arm Ball Hex Key Wrench Set (Metric) - Red | 1 | PCE |  | Bondhus | 03-HD468 | Electronics Distributors Corp. | 03-HD0468 | PCE | 5.49 USD/PCE | 5.49 USD
 | > > | TL-MS0572 | [TL-MS0572] Tool bag / Travel Organizer Case | 1 | PCE |  | Specialty Incentives, Inc | 0011-68 | Specialty Incentives, Inc | 0011-68 | PCE | 10.15 USD/PCE | 10.15 USD
 | > | DC-LB0063 | [DC-LB0063] Modification Warning Insert Modification 2.75 x 8.5 on 100 lb. Astrobright Lift Off Lemon Very Bright | 1 | PCE |  |  |  | Coren Printing Inc. |  | PCE | 0.09 USD/PCE | 0.09 USD
 | > | DC-LB0121 | [DC-LB0121] Save your Mini Packaging Sticker | 1 | PCE |  | MaverickLabel |  | MaverickLabel |  | PCE | 0.09 USD/PCE | 0.09 USD
 | > | DC-LB0150 | [DC-LB0150] Mini 2 NA Serial Number Sticker, Tamper Evident | 1 | PCE
 | > | DC-MS0069 | [DC-MS0069] EC Declaration of Conformity, Mini 2 | 1 | PCE |  |  |  | Coren Printing Inc. |  | PCE | 0.19 USD/PCE | 0.19 USD
 | > | DC-MS0070 | [DC-MS0070] Packing List, Mini 2 | 1 | PCE |  |  |  | Coren Printing Inc. |  | PCE | 0.19 USD/PCE | 0.19 USD
 | > | DC-MS0072 | [DC-MS0072] Safety Warning Sheet, Mini 2 | 1 | PCE |  |  |  | Coren Printing Inc. |  | PCE | 0.11 USD/PCE | 0.11 USD
 | > | SH-BX0496 | [SH-BX0496] Mini 2 Carton 22x17x19 275# 51 ECT White Doublewall RSC Printed | 1 | PCE |  |  |  | Preferred Packaging Products, Inc. |  | PCE | 4.39 USD/PCE | 4.39 USD
 | > | SH-PG0019 | [SH-PG0019] Avery® White Shipping Labels for Laser Printers with TrueBlock Technology, 2 Inches x 4 Inches (5963) | 1 | PCE |  |  | S-3845 | Amazon | B00006HP6D | pkg, 2500 | 0.02 USD/PCE | 0.02 USD
 | > | SH-PG0031 | [SH-PG0031] 2 x 3" No Print Reclosable Static Shielding Bags (ESD) | 2 | PCE |  |  |  | Uline | S-6509 | pkg, 100 | 0.13 USD/PCE | 0.26 USD
 | > | SH-PG0084 | [SH-PG0084] 6 x 10" 6 Mil Reclosable Bags | 1 | PCE |  |  |  | Uline | S-17767 | pkg, 1000 | 0.18 USD/PCE | 0.18 USD
 | > | SH-PG0131 | [SH-PG0131] #260 White Reinforced Gummed Tape with LulzBot Printed Logo, 10 Pack | 3600 | mm |  | Preferred Packaging Products, Inc. | 0815 | Preferred Packaging Products, Inc. | 0815 | Roll 450' - 10pk | 0.00 USD/mm | 3.46 USD
 | > | SH-PG0173 | [SH-PG0173] Mini 2 Print Head Stabilizer, 1.7# Black Polyethylene Foam | 1 | PCE |  |  |  | Preferred Packaging Products, Inc. |  | PCE | 4.15 USD/PCE | 4.15 USD
 | > | SH-PG0176 | [SH-PG0176] Mini 2 Top Foam, 1.7# Black Polyethylene | 1 | PCE |  |  |  | Preferred Packaging Products, Inc. |  | PCE | 8.10 USD/PCE | 8.10 USD
 | > | SH-PG0177 | [SH-PG0177] Mini 2 Bottom Foam, 1.7# Black Polyethylene | 1 | PCE |  |  |  | Preferred Packaging Products, Inc. |  | PCE | 8.10 USD/PCE | 8.10 USD
 |  |  |  |  |  |  |  |  |  |  |  | Total BoM Price: | 789.33 USD
 | NEW FOR KANGAROOPAW
 |  |  | LulzBot Goostruder Tool Head | 1
 |  | EL-MT0063 | Nema 11 motor | 1 |  |  | needs replaced w/ kangaroopaw specific part
 |  | PP-MP0252 | KHK SW0 5 R2 worm gear | 1 |  |  | needs removed
 |  | PP-MP0253 | KHK BG0 5 30 R2 worm wheel | 1 |  |  | milled part
 |  | EL-SW0022 | Endstop Switch | 1 |  |  | printed part
 |  | PP-MP0279 | Motor mount (milled) | 1 |  |  | assembly sub part
 |  | PP-MP0280 | Collar Mount flange (milled) | 1 |  |  | harness
 |  | PP-MP0277 | Upper Bearing Holder (milled) | 1
 |  | PP-MP0278 | Lower Bearing Holder (milled) | 1
 |  | PP-MP0281 | Carriage (milled) | 1
 |  | HD-BU0050 | 6mm sleeve bushing JSM-0607-12.5 | 1
 |  | HD-NT0359 | leadscrew nut, standard, inch flanged, 3/16” x 0.20 | 1
 |  | HD-RD0076 | 99mm Leadscrew (milled) | 1
 |  | HD-RD0077 | 90mm smooth rod (milled) | 1
 |  | PP-GP0453 | syringe collar mount (printed) | 1
 |  | PP-GP0454 | syringe collar 81420 (printed) | 1
 |  | PP-GP0455 | syringe collar 81520 (printed) | 1
 |  | PP-GP0456 | syringe collar 81620 (printed) | 1
 |  | PP-GP0451 | extruder mount (printed) | 1
 |  | HD-MS0030 | M3 brass insert | 4
 |  | PP-GP0457 | carriage cover (printed) | 1
 |  | PP-GP0452 | cover (printed) | 1
 |  | HD-MS0030 | M3 brass insert | 2
 |  | HD-MS0470 | 623 bearing | 2
 |  | HD-BT0255 | M2.5x14mm SHCS black oxide | 3
 |  | HD-BT0005 | M3x10mm SHCS black oxide | 3
 |  | TL-HD0572 | M2x8mm SHCS black oxide | 2
 |  | HD-BT0244 | M2x6mm FHCS black oxide | 4
 |  | HD-WA0038 | M3 washer | 3
 |  | HD-BT0157 | M3x8mm SHCS black oxide | 5
 |  | HD-BT0119 | M3x8mm FHCS black oxide | 2
 |  | HD-BT0137 | M3x8mm BHCS black oxide | 2
 |  | EL-HR0190 | Syringe pump Harness
 |  | EL-WR0120 | 24 ga purple wire | 410 | mm
 |  | EL-MS0142 | purple fast on connector | 2
 |  | EL-WR0103 | 24 ga red wire | 110 | mm
 |  | EL-WR0107 | 24 ga white wire | 110 | mm
 |  | EL-WR0119 | 24ga green wire | 110 | mm
 |  | EL-WR0105 | 24 ga black wire | 110 | mm
 |  | EL-MS0564 | Molex, Conn Socket, 24-30AWG Crimp, Tin | 4
 |  | EL-MS0563 | Molex, Connector Receptacle, 6 position | 1
 |  | EL-MS0480 | molex microfit 3.0 male pin | 6
 |  | PC-CN0101 | molex microfit male housing, 20 pos | 1
 |  | HD-BT0258 | Thumbscrew 6/32 -1/2 knurled | 1
 |  |  | LCD Assembly
 |  | PP-FP0183 | polycarb laser cut screen cover | 1
 |  | PC-BD0114 | usb board | 1
 |  |  | M3x6 SHCS SS | 4
 |  | PC-BD0117 | lcd board | 1
 |  | EL-MS0559 | Lcd 4.3 inch | 1
 |  | PP-FP0175 | EMI gasket | 1
 |  | PP-GP0458 | case (printed) | 1
 |  | HD-MS0030 | M3 brass insert | 14
 |  | HD-BT0128 | M3X6 FHCS | 2
 |  | HD-BT0137 | M3X8 BHCS | 2
 |  | HD-WA0038 | M3 WASHER, black oxide | 7
 |  | PP-GP0459 | usb cover (printed) | 1
 |  | HD-BT0082 | M3X 16 FHCS SS | 4
 |  | PP-GP0460 | lcd center (printed) | 1
 |  | HD-MS0030 | M3 brass insert | 4
 |  | PP-FP0174 | laser cut hips cover | 1
 |  |  | M3x 16 BHCS | 5 |  | prototypes build with SHCS, will likely need BHCS for production
 |  | EL-HR0188 | ribbon cable1 | 1
 |  | EL-CA0078 | rainbow ribbon cable | 290 | mm | May need to add 150mm for noise supression
 |  | PC-CN0010 | ribbon cable 10pos connector | 2
 |  | EL-HR0189 | ribbon cable 2, split | 1
 |  | EL-CA0078 | rainbow ribbon cable | 330 | mm
 |  | PC-CN0010 | ribbon cable 10pos connector | 2
 |  | EL-MS0418 | 10 pos molex | 1
 |  | EL-MS0059 | molex pin female | 3
 |  | EL-HR0191 | lcd ground cable | 1
 |  | EL-MS0141 | ring terminal | 2
 |  | EL-WR0105 | Black 24 ga wire | ? | mm | need to figure out what mark wants to do here
 |  |  | Additional Items
 |  |  | Syringe 81420 | 1 |  |  | https://www.hamiltoncompany.com/laboratory-products/syringes/81420
 |  |  | DOW Corning, high vacuum grease, 1oz | 1 |  |  | https://www.amazon.com/Corning-Vacuum-Grease-Lubricant-Container/dp/B00B3O2YW4
 |  |  | petri dishes
 |  |  | needles
 |  |  | FRESH material (life support)
 |  |  | sodium alginate powder
