reprapperMC/kangaroopaw/production_parts/assembly/assembly_subs/kpaw_frame_assembled.fcstd

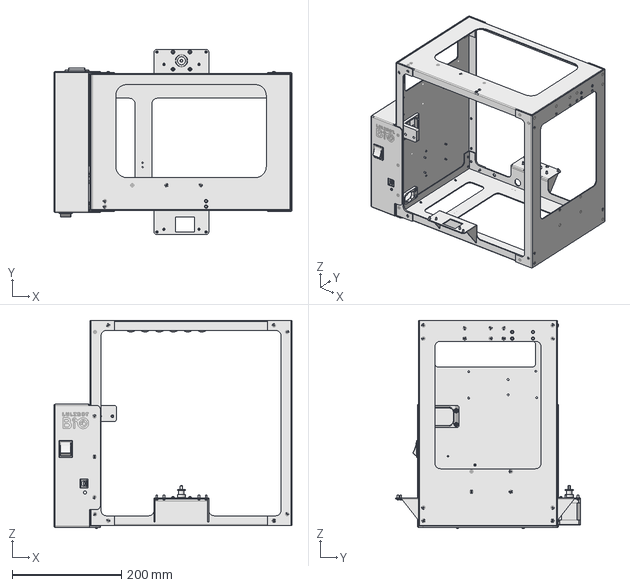
[picture p1: CAD file, 2019-07-19]
production_parts/assembly/assembly_subs/kpaw_frame_assembled.fcstd
435.0 x 339.0 x 380.2 mm
