reprapperMC/kangaroopaw/production_parts/assembly/LCD_assembly/LCD_assembly.fcstd

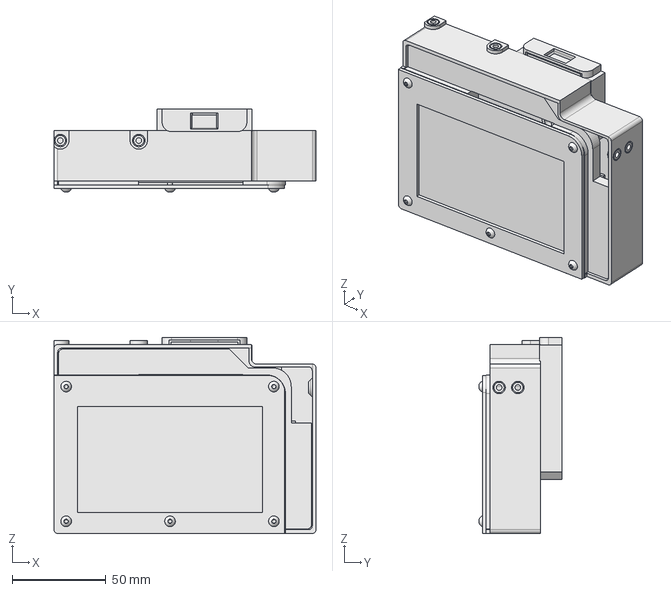
[picture p2: CAD file, 2019-07-19]
production_parts/assembly/LCD_assembly/LCD_assembly.fcstd
140.0 x 44.2 x 104.8 mm
