reprapperMC/kangaroopaw/production_parts/tooling/syringe-pump_test-stand/assembly/assembly.fcstd

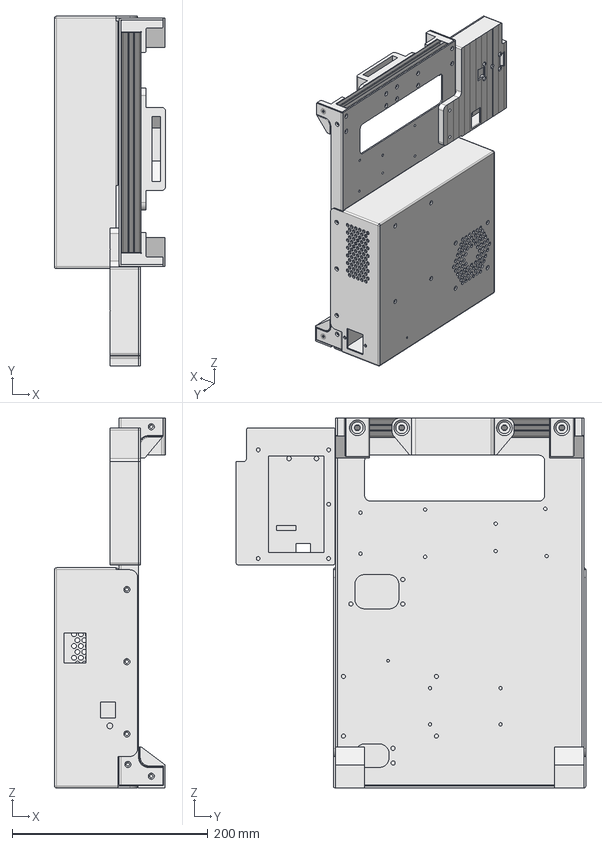
[picture p3: CAD file, 2019-09-04]
production_parts/tooling/syringe-pump_test-stand/assembly/assembly.fcstd
113.5 x 357.2 x 378.0 mm
left_side_mini
electronics_case_mini
top_right_corner
top_left_corner
225mm_extrusion_01
syringe-pump-hanger
bottom_left_corner
bottom_right_corner
touchscreen_case_for_stand_01
touchscreen_center_for_stand
touchscreen_cover_for_stand
