reprapperMC/kangaroopaw/production_parts/assembly/assembly_parts/80MM_FAN.fcstd

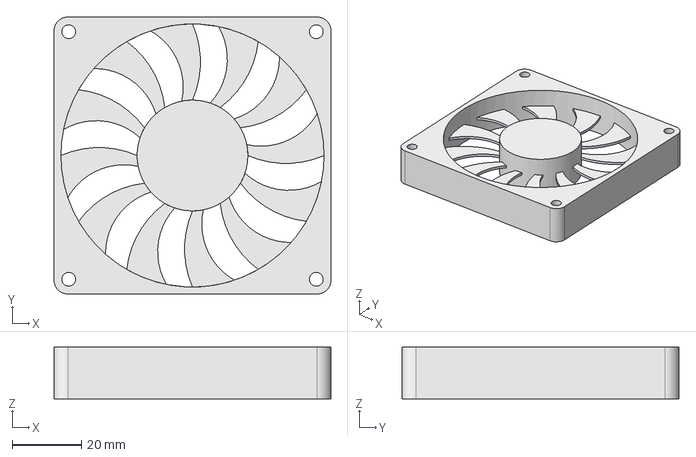
[picture p4: CAD file, 2019-07-19]
production_parts/assembly/assembly_parts/80MM_FAN.fcstd
80.0 x 80.0 x 15.0 mm
