reprapperMC/kangaroopaw/production_parts/assembly/assembly_subs/PEM/PEM_assem.fcstd

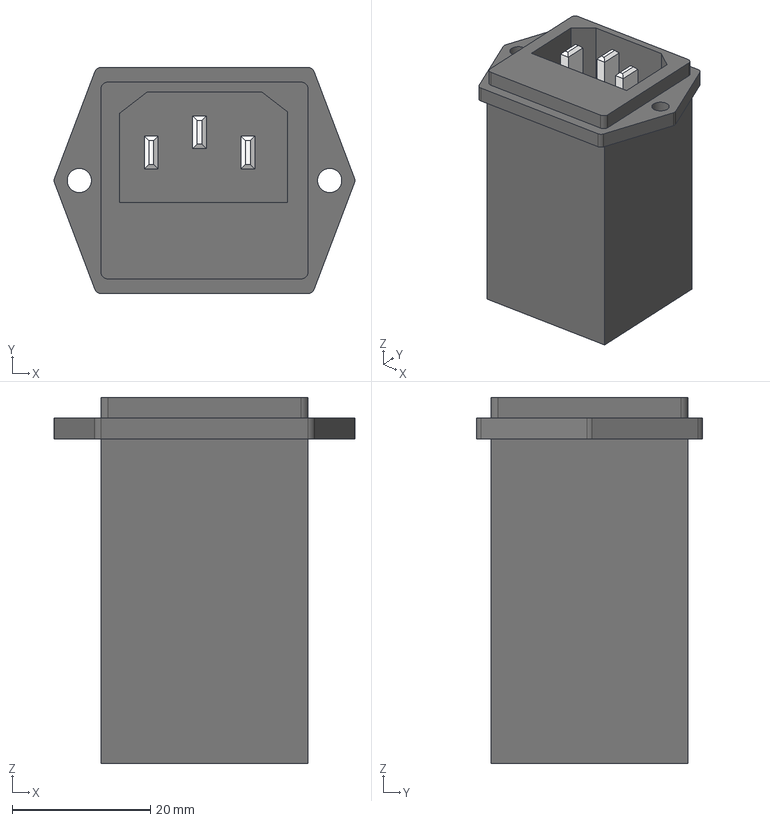
[picture p5: CAD file, 2019-07-19]
production_parts/assembly/assembly_subs/PEM/PEM_assem.fcstd
43.6 x 32.8 x 53.0 mm
pem_case_01
pem_pins_01
