reprapperMC/kangaroopaw/production_parts/assembly/assembly_subs/RAMBO/USB.fcstd

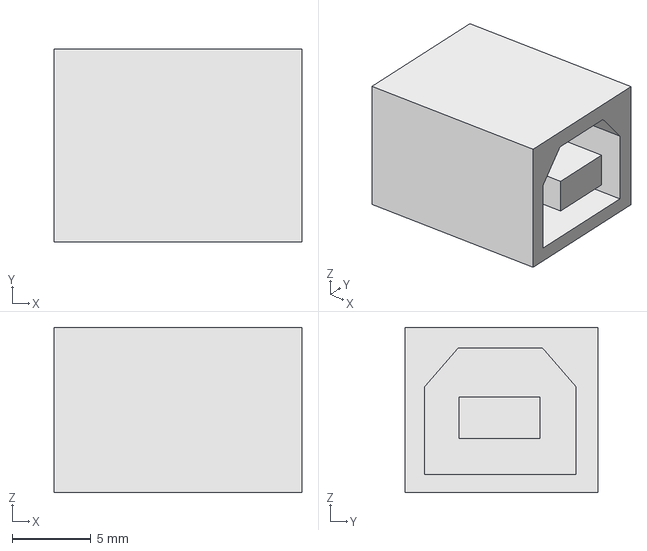
[picture p6: CAD file, 2019-07-19]
production_parts/assembly/assembly_subs/RAMBO/USB.fcstd
15.8 x 12.2 x 10.5 mm
