reprapperMC/kangaroopaw/production_parts/assembly/inserts_assemblies/y_belt_mount_inserts.fcstd

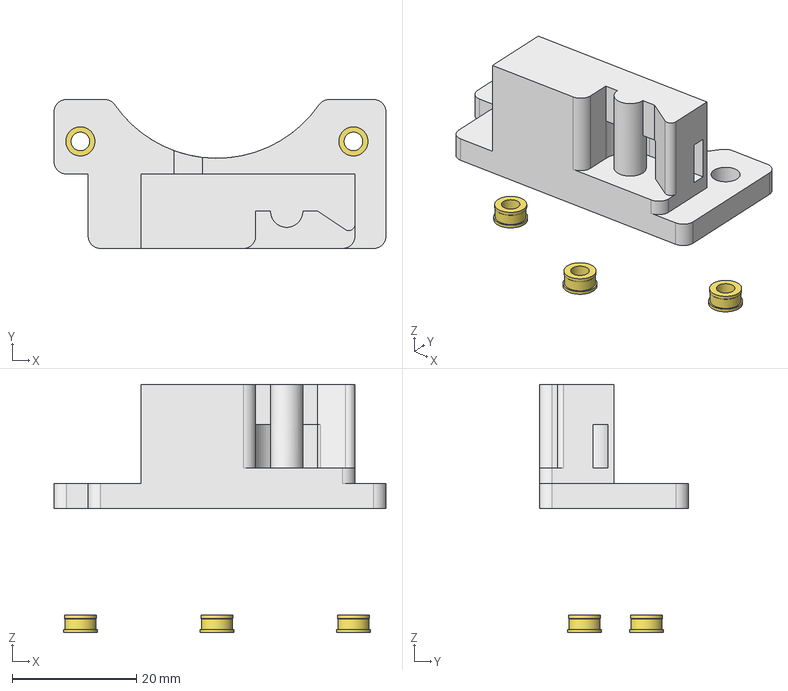
[picture p7: CAD file, 2019-10-07]
production_parts/assembly/inserts_assemblies/y_belt_mount_inserts.fcstd
53.5 x 24.0 x 40.0 mm
y_belt_mount_v6_1_01
M3_insert_01
M3_insert_02
M3_insert_03
