reprapperMC/kangaroopaw/production_parts/assembly/LCD_assembly/touchscreen.fcstd

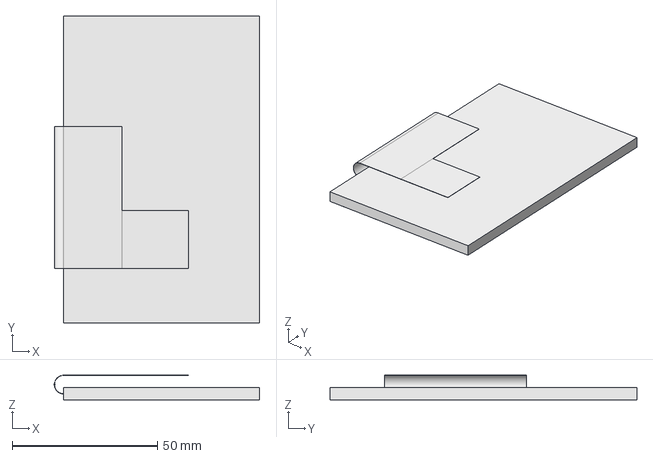
[picture p8: CAD file, 2019-07-19]
production_parts/assembly/LCD_assembly/touchscreen.fcstd
70.8 x 105.8 x 8.50 mm
