reprapperMC/kangaroopaw/production_parts/assembly/lulzbio.fcstd

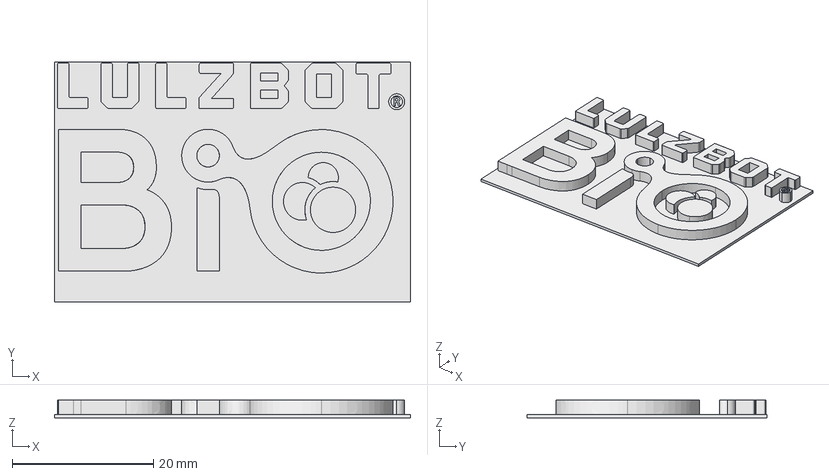
[picture p9: CAD file, 2019-07-19]
production_parts/assembly/lulzbio.fcstd
50.4 x 33.9 x 2.50 mm
