reprapperMC/kangaroopaw/production_parts/machined_parts/35mmx6_dish_plate/35mmx6_dish_plate.step

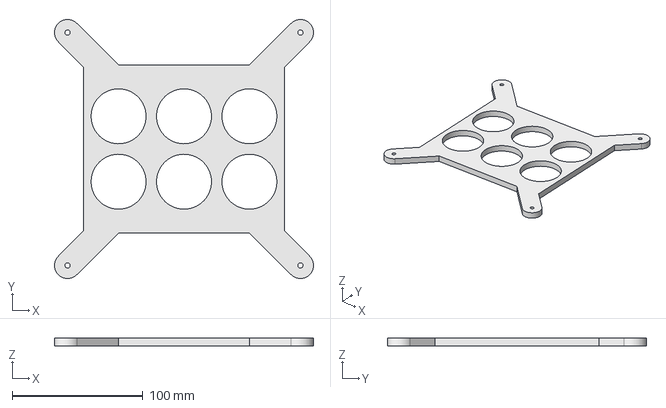
[picture p10: CAD file, 2019-04-22]
production_parts/machined_parts/35mmx6_dish_plate/35mmx6_dish_plate.step
198.0 x 198.0 x 6.35 mm
