reprapperMC/kangaroopaw/production_parts/machined_parts/55mmx4_dish_plate/55mmx4_dish_plate.step

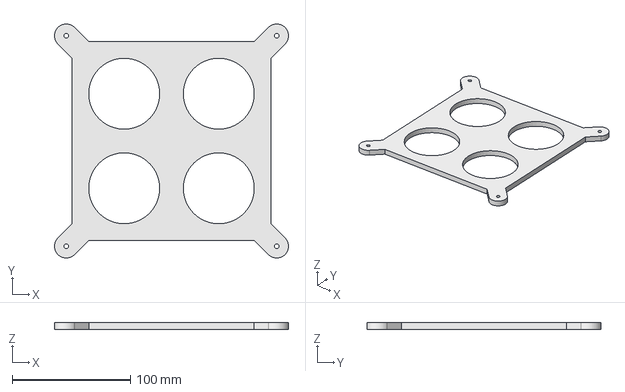
[picture p11: CAD file, 2019-05-09]
production_parts/machined_parts/55mmx4_dish_plate/55mmx4_dish_plate.step
198.0 x 198.0 x 6.00 mm
