reprapperMC/kangaroopaw/production_parts/machined_parts/bed_mount_plate/bed-mount-plate-mini-white_PP-FP0171_revB.fcstd

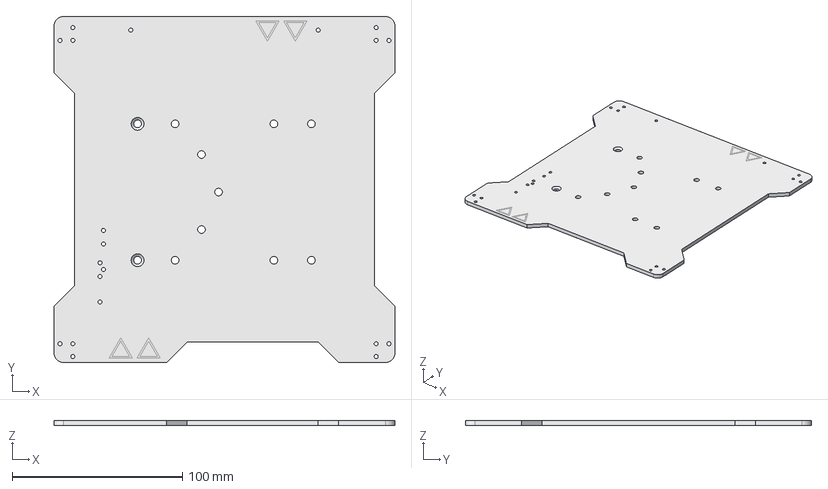
[picture p12: CAD file, 2019-07-09]
production_parts/machined_parts/bed_mount_plate/bed-mount-plate-mini-white_PP-FP0171_revB.fcstd
200.0 x 203.0 x 3.17 mm
