reprapperMC/kangaroopaw/production_parts/machined_parts/bed_standoff/bed_standoff.step

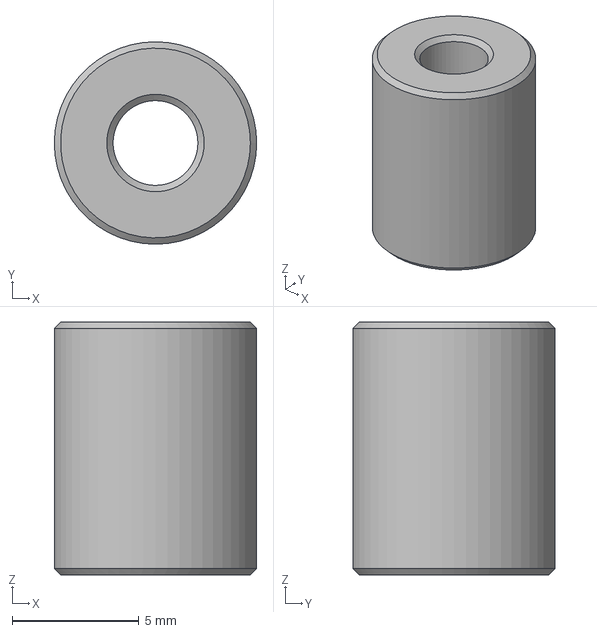
[picture p13: CAD file, 2019-03-19]
production_parts/machined_parts/bed_standoff/bed_standoff.step
8.00 x 8.00 x 10.0 mm
