reprapperMC/kangaroopaw/production_parts/machined_parts/blank_dish_plate/PP-FP00185_blank_dish_plate.step

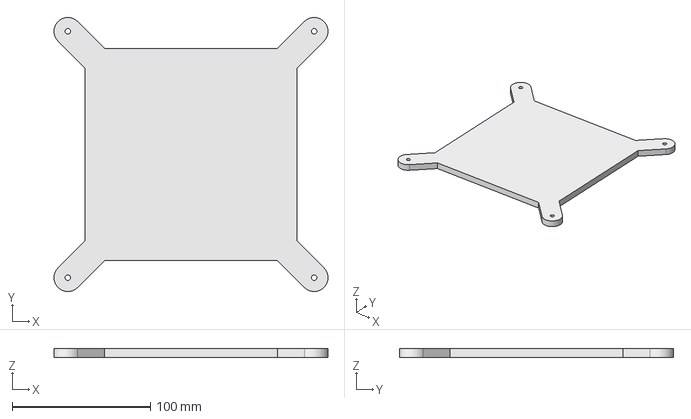
[picture p14: CAD file, 2019-06-18]
production_parts/machined_parts/blank_dish_plate/PP-FP00185_blank_dish_plate.step
198.0 x 198.0 x 6.35 mm
