reprapperMC/kangaroopaw/production_parts/machined_parts/bottom_plate_mini/bottom-plate-mini-white_PP-MP0258_revA.fcstd

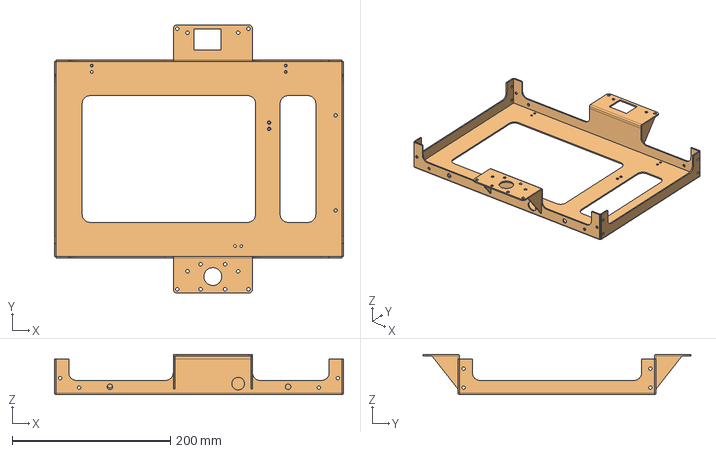
[picture p15: CAD file, 2019-07-08]
production_parts/machined_parts/bottom_plate_mini/bottom-plate-mini-white_PP-MP0258_revA.fcstd
365.0 x 339.0 x 51.0 mm
