reprapperMC/kangaroopaw/production_parts/machined_parts/electronics_case/electronics-case-mini-white_PP-FP0167_revD.fcstd

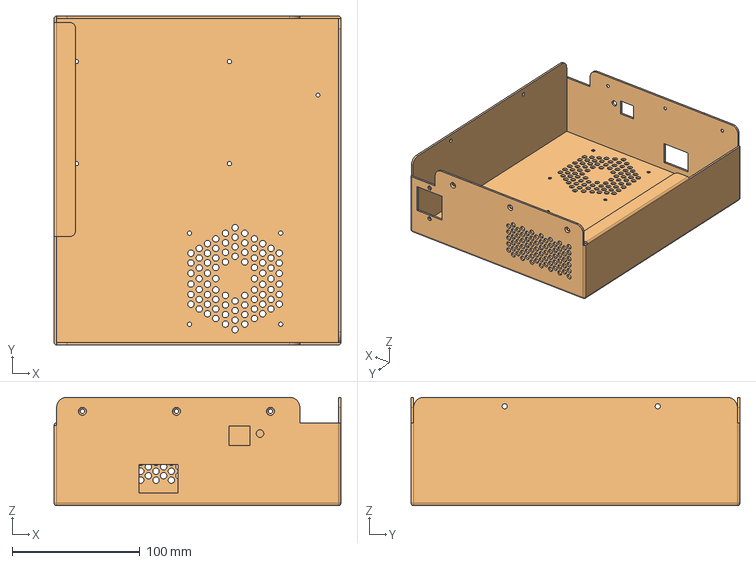
[picture p16: CAD file, 2019-09-30]
production_parts/machined_parts/electronics_case/electronics-case-mini-white_PP-FP0167_revD.fcstd
225.0 x 258.0 x 85.0 mm
