reprapperMC/kangaroopaw/production_parts/machined_parts/heatsink_einsy/heatsink_einsy_PP-MP0210.step

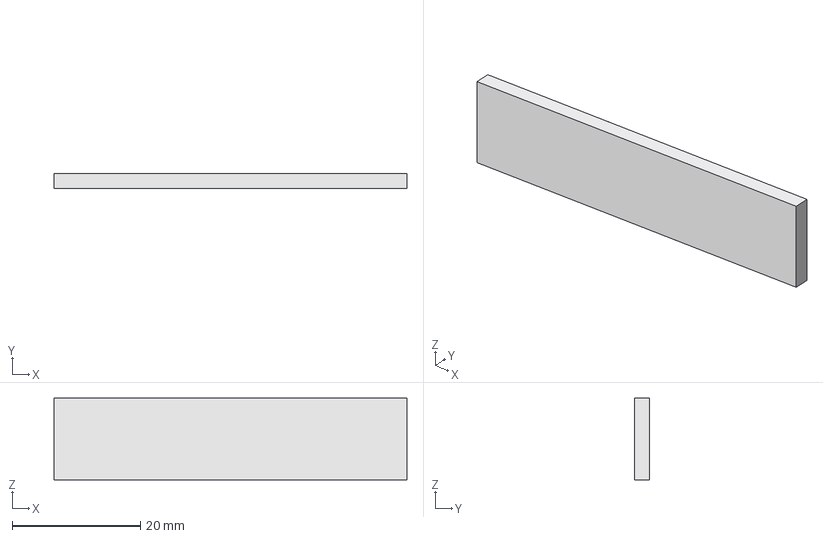
[picture p17: CAD file, 2019-03-19]
production_parts/machined_parts/heatsink_einsy/heatsink_einsy_PP-MP0210.step
55.0 x 2.38 x 12.7 mm
