reprapperMC/kangaroopaw/production_parts/machined_parts/left_side/left-side-mini-white_PP-FP0170_revA.fcstd

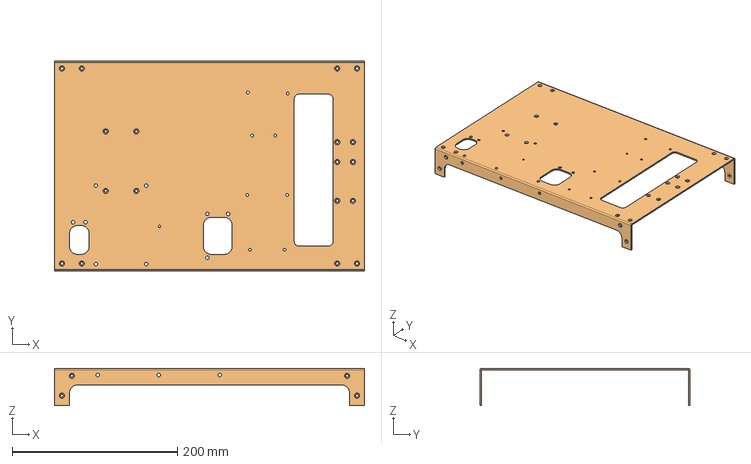
[picture p18: CAD file, 2019-07-09]
production_parts/machined_parts/left_side/left-side-mini-white_PP-FP0170_revA.fcstd
375.0 x 254.0 x 45.0 mm
