reprapperMC/kangaroopaw/production_parts/machined_parts/polycarb_LCD_cover/PP-FP0183_polycarb_LCD_cover_revA.fcstd

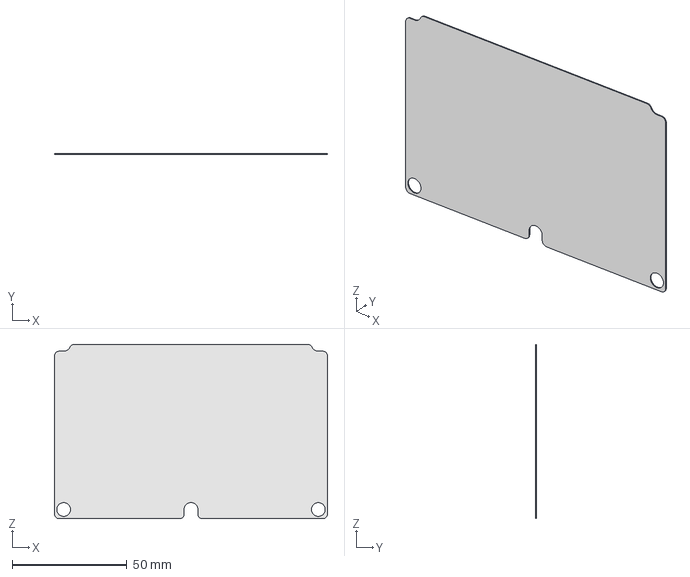
[picture p19: CAD file, 2019-09-30]
production_parts/machined_parts/polycarb_LCD_cover/PP-FP0183_polycarb_LCD_cover_revA.fcstd
119.0 x 0.381 x 76.0 mm
