reprapperMC/kangaroopaw/production_parts/machined_parts/pulley/pulley.fcstd

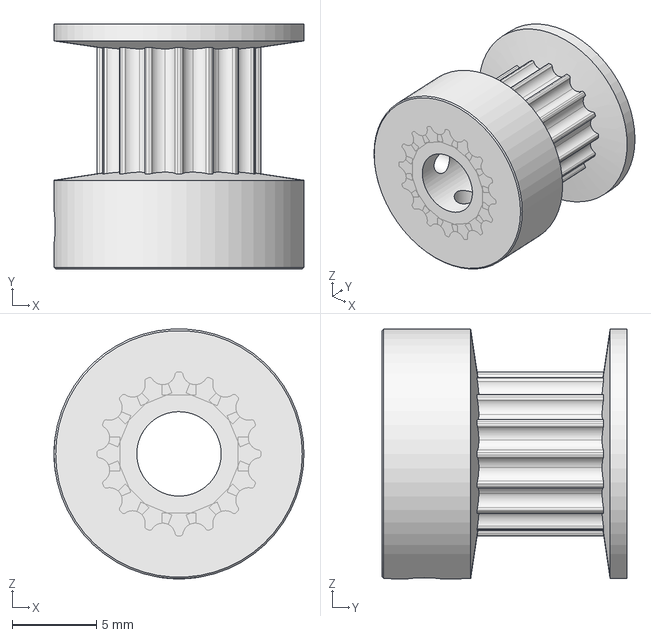
[picture p20: CAD file, 2019-03-19]
production_parts/machined_parts/pulley/pulley.fcstd
14.8 x 14.5 x 14.8 mm
