reprapperMC/kangaroopaw/production_parts/machined_parts/right_side/right-side-mini-white_PP-FP0169.step

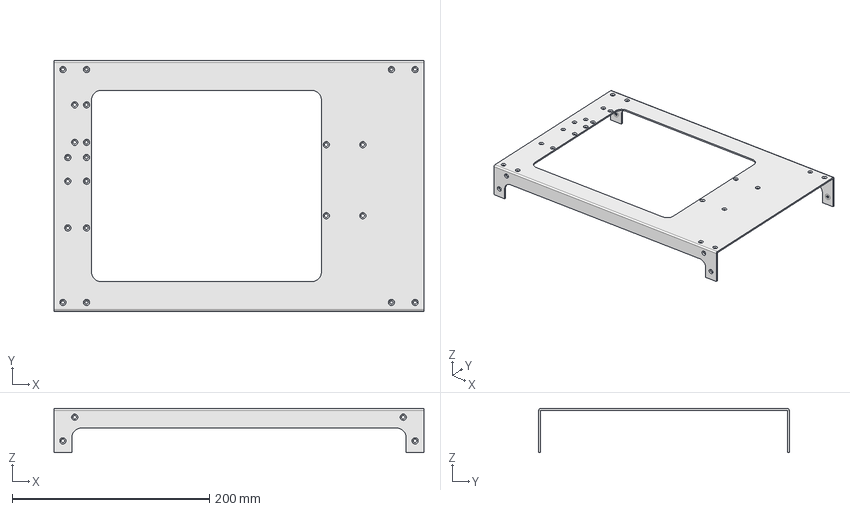
[picture p21: CAD file, 2019-03-19]
production_parts/machined_parts/right_side/right-side-mini-white_PP-FP0169.step
375.0 x 254.0 x 45.0 mm
