reprapperMC/kangaroopaw/production_parts/machined_parts/smooth_idler_pully_wheel/smooth_idler_pully_wheel_HD-MS0412.fcstd

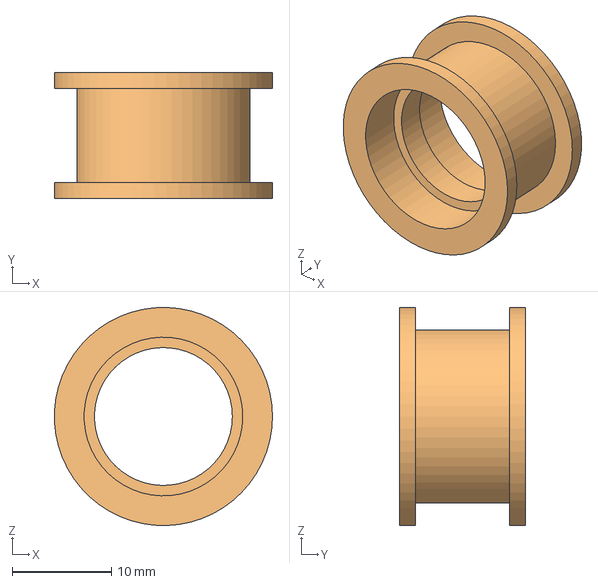
[picture p22: CAD file, 2019-03-19]
production_parts/machined_parts/smooth_idler_pully_wheel/smooth_idler_pully_wheel_HD-MS0412.fcstd
22.0 x 12.7 x 22.0 mm
