reprapperMC/kangaroopaw/production_parts/machined_parts/smooth_rod_mini/8mmx315_rod_v1.0_revA.step

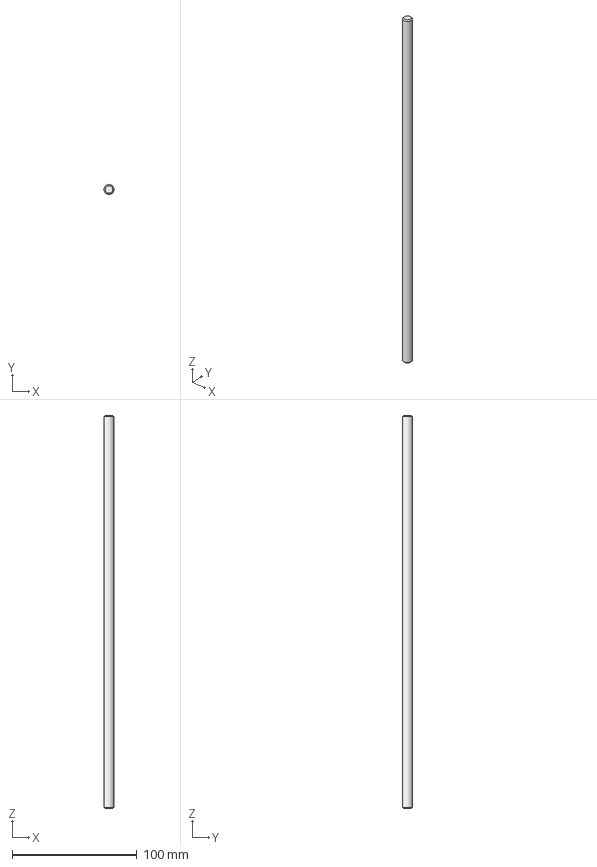
[picture p23: CAD file, 2019-03-19]
production_parts/machined_parts/smooth_rod_mini/8mmx315_rod_v1.0_revA.step
7.99 x 8.00 x 315.0 mm
