reprapperMC/kangaroopaw/production_parts/machined_parts/touchscreen_bezel/PP-FP0174_touchscreen_bezel_revB.fcstd

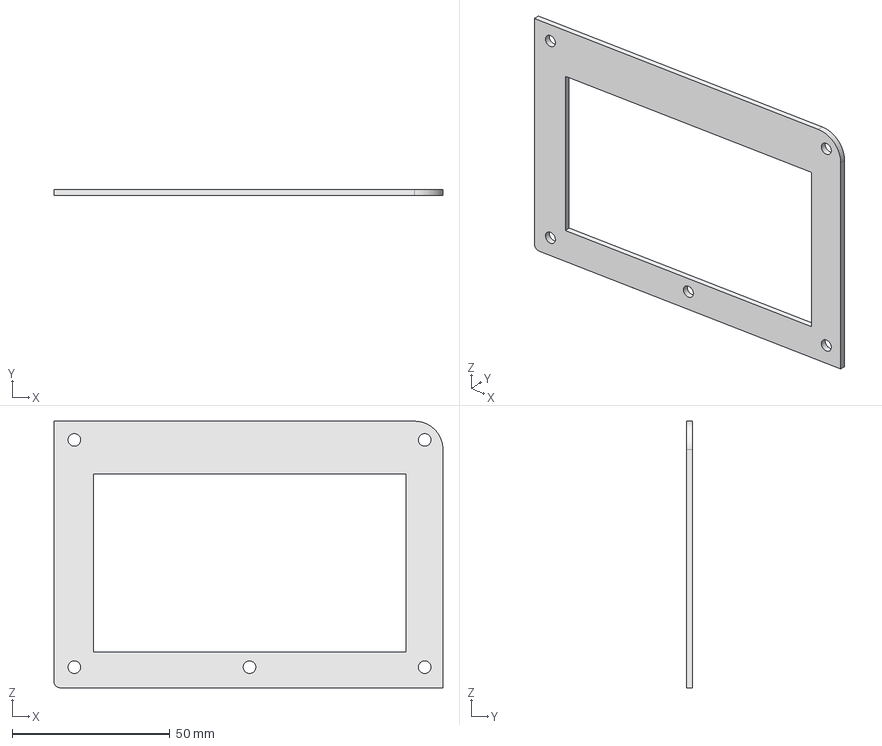
[picture p24: CAD file, 2019-08-12]
production_parts/machined_parts/touchscreen_bezel/PP-FP0174_touchscreen_bezel_revB.fcstd
123.2 x 2.00 x 84.5 mm
