reprapperMC/kangaroopaw/production_parts/machined_parts/touchscreen_pad/touchscreen_pad.fcstd

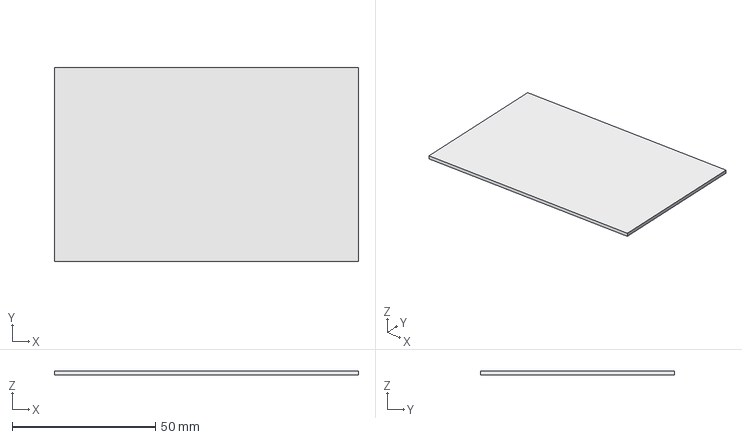
[picture p25: CAD file, 2019-04-15]
production_parts/machined_parts/touchscreen_pad/touchscreen_pad.fcstd
106.0 x 67.5 x 1.50 mm
