reprapperMC/kangaroopaw/production_parts/parts/fsr_cover_05.step

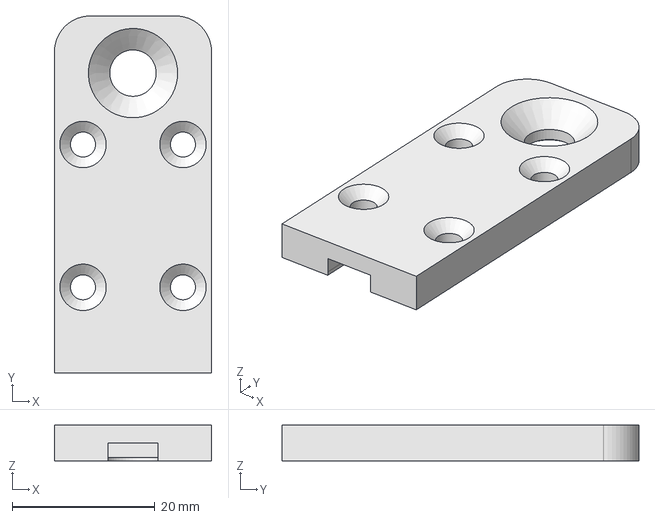
[picture p26: CAD file, 2019-05-16]
production_parts/parts/fsr_cover_05.step
22.0 x 50.0 x 5.00 mm
