reprapperMC/kangaroopaw/production_parts/printed_parts/adjustable_belt_tensioner/adjustable-belt-tensioner_v2.3.fcstd

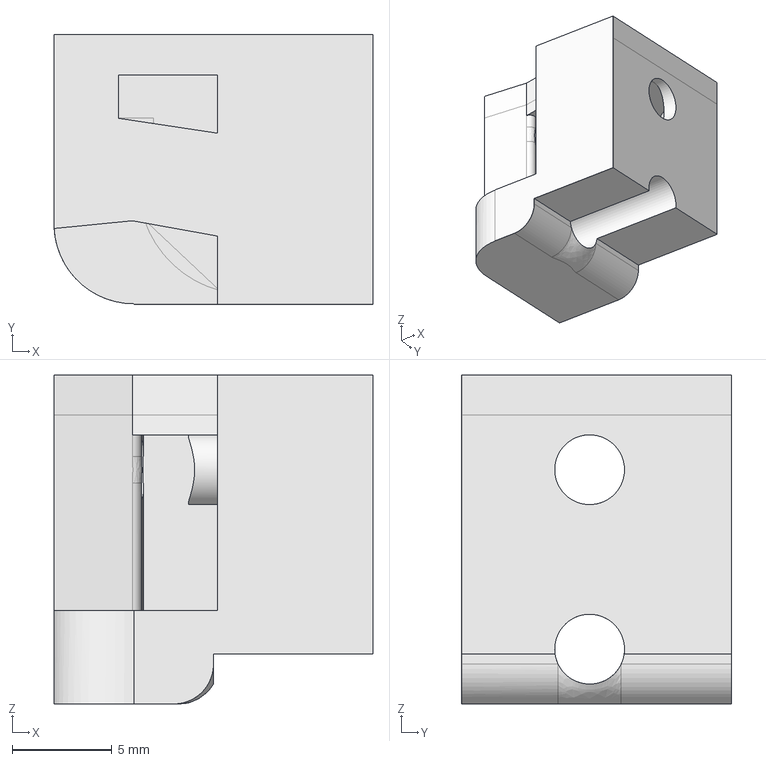
[picture p27: CAD file, 2019-09-13]
production_parts/printed_parts/adjustable_belt_tensioner/adjustable-belt-tensioner_v2.3.fcstd
16.0 x 13.5 x 16.5 mm
