reprapperMC/kangaroopaw/production_parts/printed_parts/bed_clip/bed_clip_v3.step

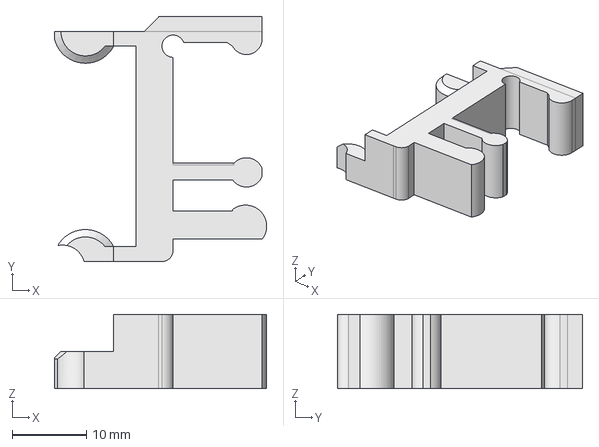
[picture p28: CAD file, 2019-07-19]
production_parts/printed_parts/bed_clip/bed_clip_v3.step
28.6 x 33.0 x 10.0 mm
