reprapperMC/kangaroopaw/production_parts/printed_parts/bed_corner/bed_corner_v2.2.4.fcstd

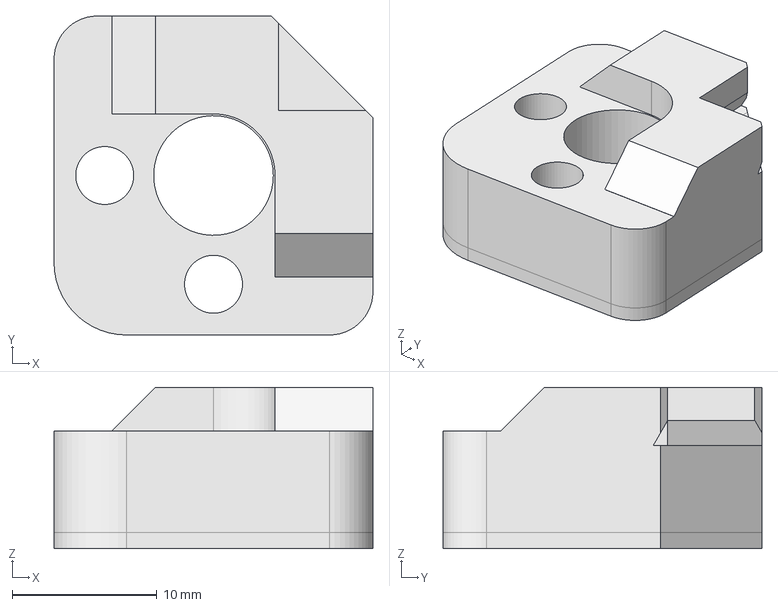
[picture p29: CAD file, 2019-09-13]
production_parts/printed_parts/bed_corner/bed_corner_v2.2.4.fcstd
22.0 x 22.0 x 11.1 mm
