reprapperMC/kangaroopaw/production_parts/printed_parts/belt_tensioning_collar/belt_tensioner_v1.2.stl

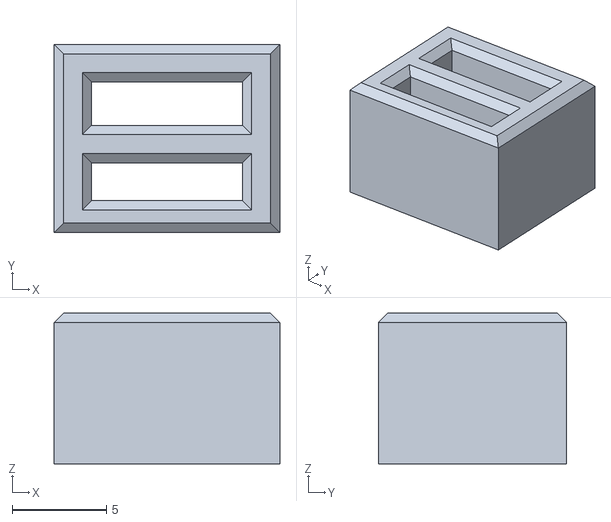
[picture p30: CAD file, 2019-07-19]
production_parts/printed_parts/belt_tensioning_collar/belt_tensioner_v1.2.stl
12.0 x 10.0 x 8.00
