reprapperMC/kangaroopaw/production_parts/printed_parts/bump_stop/bump_stop.fcstd

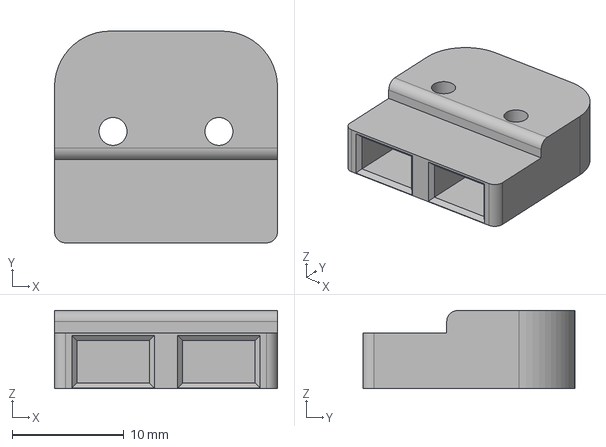
[picture p31: CAD file, 2019-07-19]
production_parts/printed_parts/bump_stop/bump_stop.fcstd
20.0 x 19.0 x 7.00 mm
