reprapperMC/kangaroopaw/production_parts/printed_parts/double-bearing-holder/double-bearing-holder_black_v1.8.2.fcstd

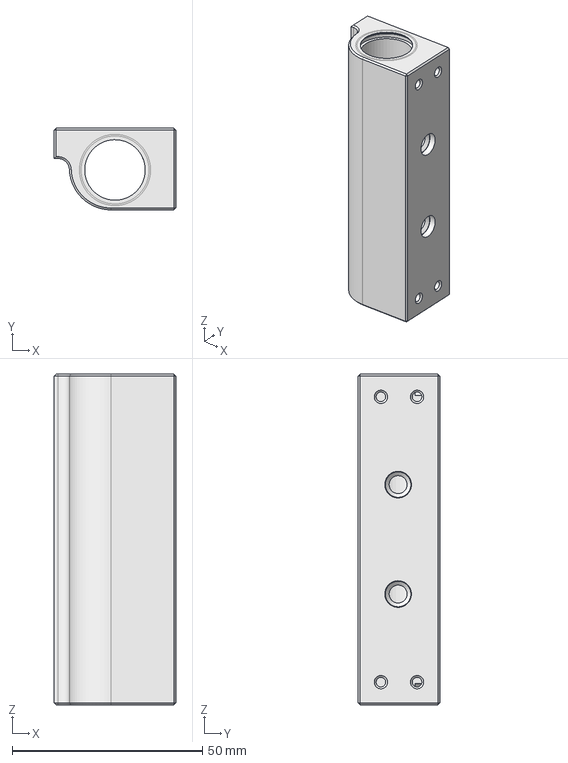
[picture p32: CAD file, 2019-07-19]
production_parts/printed_parts/double-bearing-holder/double-bearing-holder_black_v1.8.2.fcstd
32.0 x 21.5 x 87.0 mm
