reprapperMC/kangaroopaw/production_parts/printed_parts/Heatsink_frame/einsy_heatsink_frame.fcstd

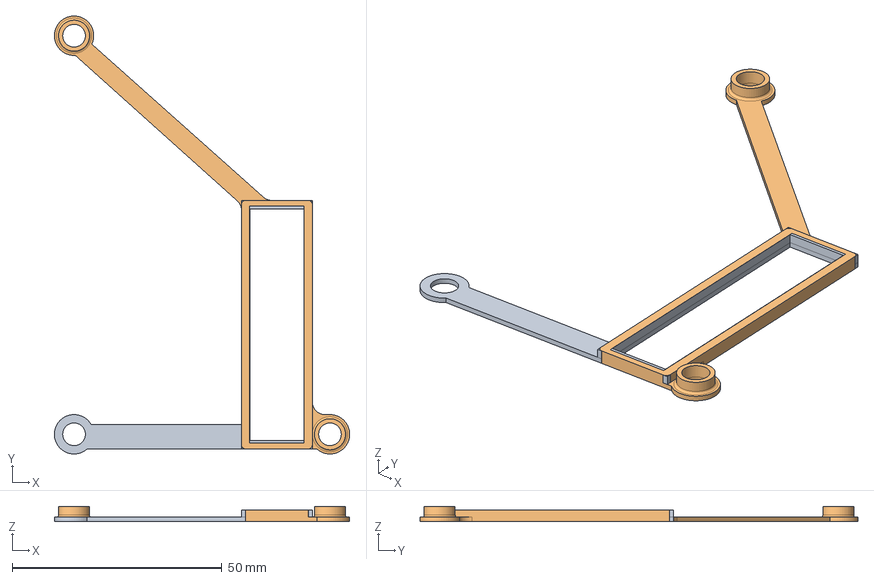
[picture p34: CAD file, 2019-07-19]
production_parts/printed_parts/Heatsink_frame/einsy_heatsink_frame.fcstd
70.4 x 104.4 x 3.50 mm
