reprapperMC/kangaroopaw/production_parts/printed_parts/retaining_ring/retaining-ring_v2.fcstd

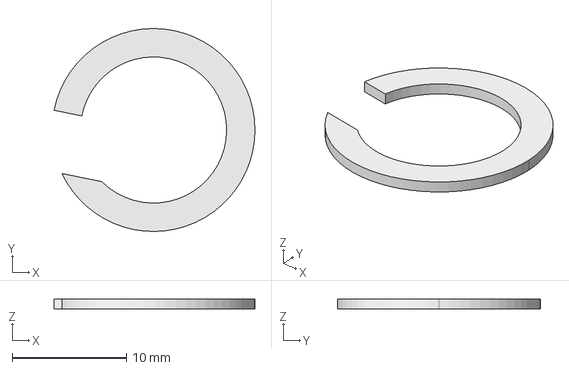
[picture p35: CAD file, 2019-07-19]
production_parts/printed_parts/retaining_ring/retaining-ring_v2.fcstd
17.6 x 17.8 x 0.9 mm
