reprapperMC/kangaroopaw/production_parts/printed_parts/sd_mount/sd_mount.fcstd

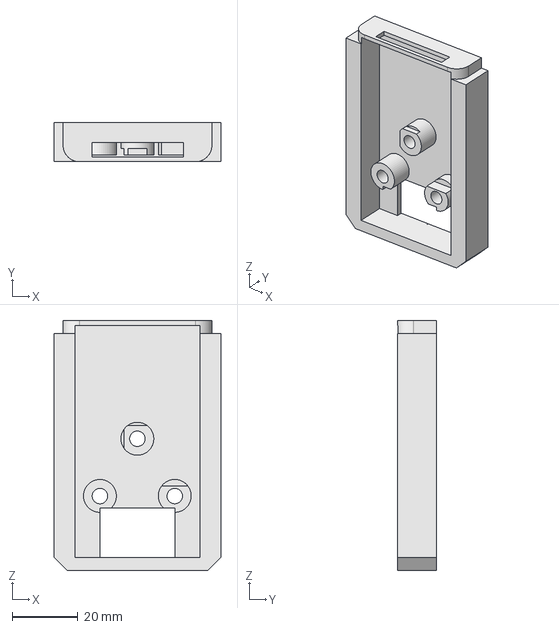
[picture p36: CAD file, 2019-08-19]
production_parts/printed_parts/sd_mount/sd_mount.fcstd
50.8 x 12.0 x 76.0 mm
