reprapperMC/kangaroopaw/production_parts/printed_parts/strain-relief-lower/strain-relief-lower_black_1.3.step

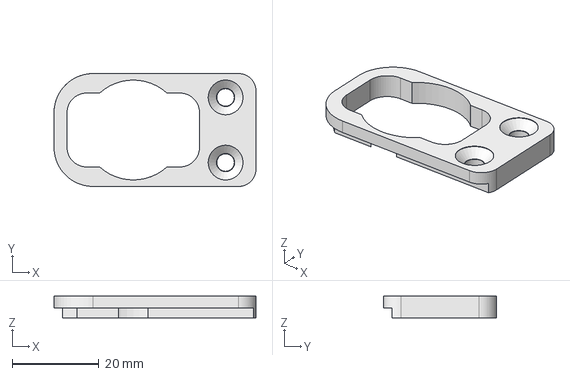
[picture p37: CAD file, 2019-07-19]
production_parts/printed_parts/strain-relief-lower/strain-relief-lower_black_1.3.step
46.5 x 26.0 x 5.00 mm
