reprapperMC/kangaroopaw/production_parts/printed_parts/strain-relief-upper/strain-relief-upper_black_v3.0.step

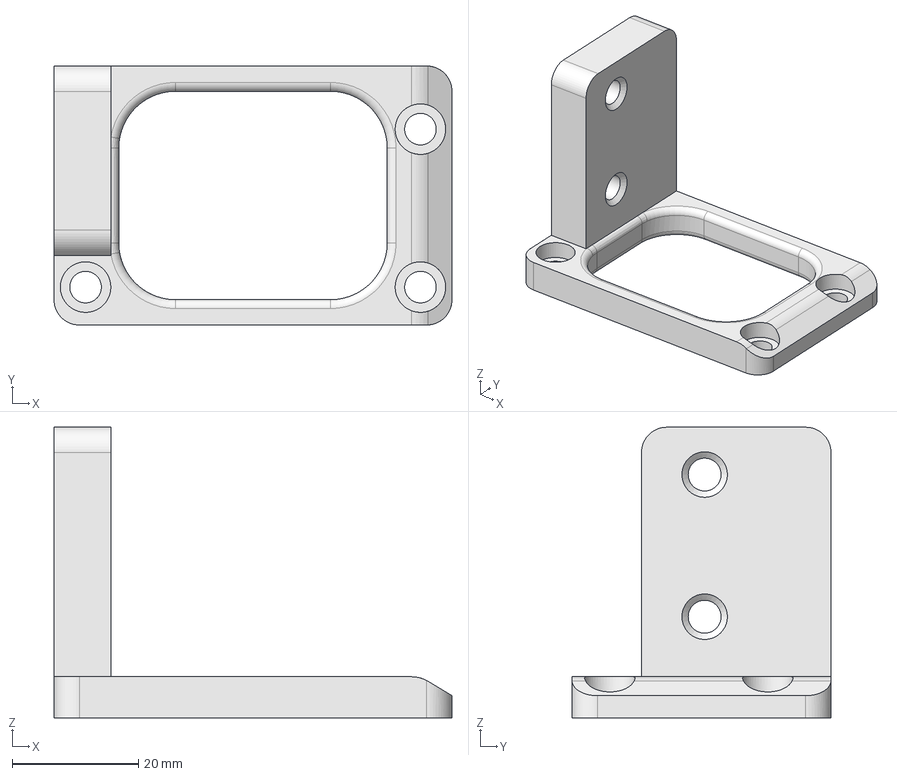
[picture p38: CAD file, 2019-07-19]
production_parts/printed_parts/strain-relief-upper/strain-relief-upper_black_v3.0.step
63.0 x 41.0 x 46.0 mm
