reprapperMC/kangaroopaw/production_parts/printed_parts/touchscreen_case/touchscreen_case_v1.5.fcstd

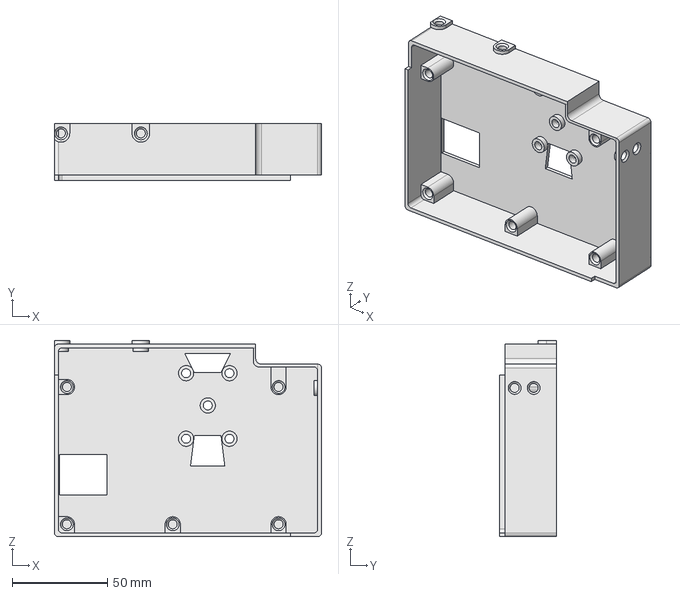
[picture p39: CAD file, 2019-09-30]
production_parts/printed_parts/touchscreen_case/touchscreen_case_v1.5.fcstd
140.0 x 30.0 x 103.0 mm
