reprapperMC/kangaroopaw/production_parts/printed_parts/touchscreen_center/touchscreen_center_v1.3.4.fcstd

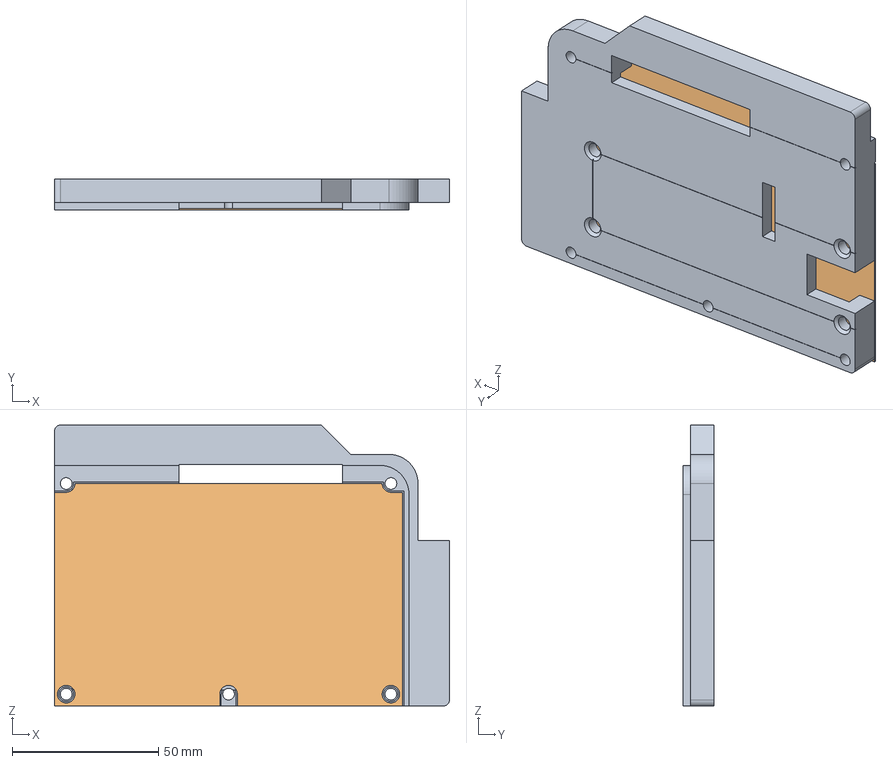
[picture p40: CAD file, 2019-09-30]
production_parts/printed_parts/touchscreen_center/touchscreen_center_v1.3.4.fcstd
135.0 x 10.5 x 96.0 mm
LCD_polycarb_cover_01
