reprapperMC/kangaroopaw/production_parts/printed_parts/unthreaded_spacer/unthreaded_spacer.fcstd

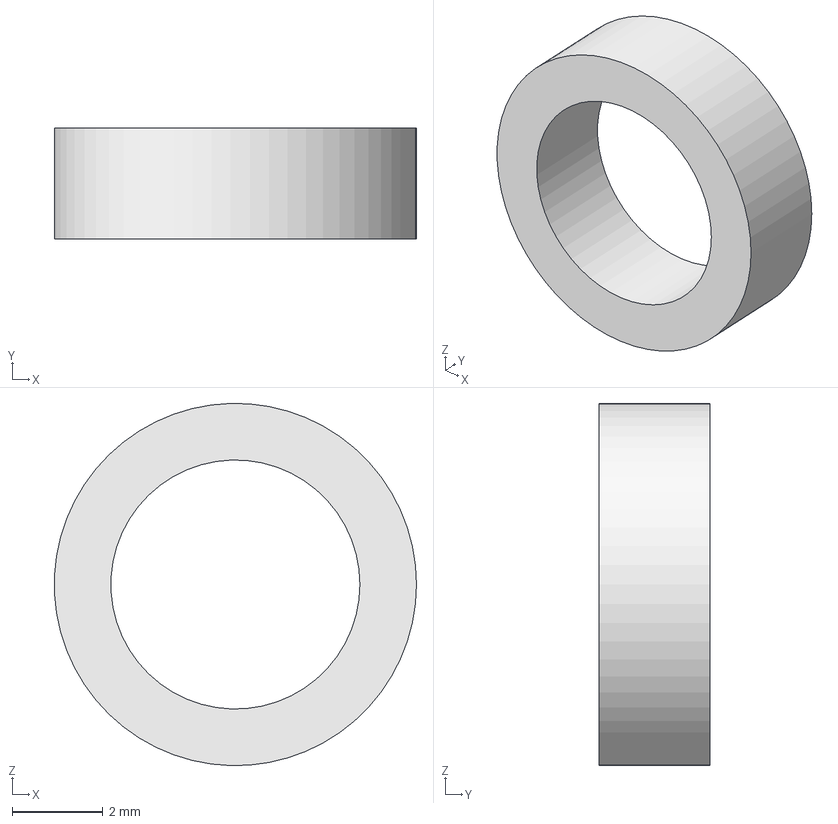
[picture p41: CAD file, 2019-07-19]
production_parts/printed_parts/unthreaded_spacer/unthreaded_spacer.fcstd
7.99 x 2.45 x 8.00 mm
