reprapperMC/kangaroopaw/production_parts/printed_parts/usb_support/usb_support_mini_v1.5.fcstd

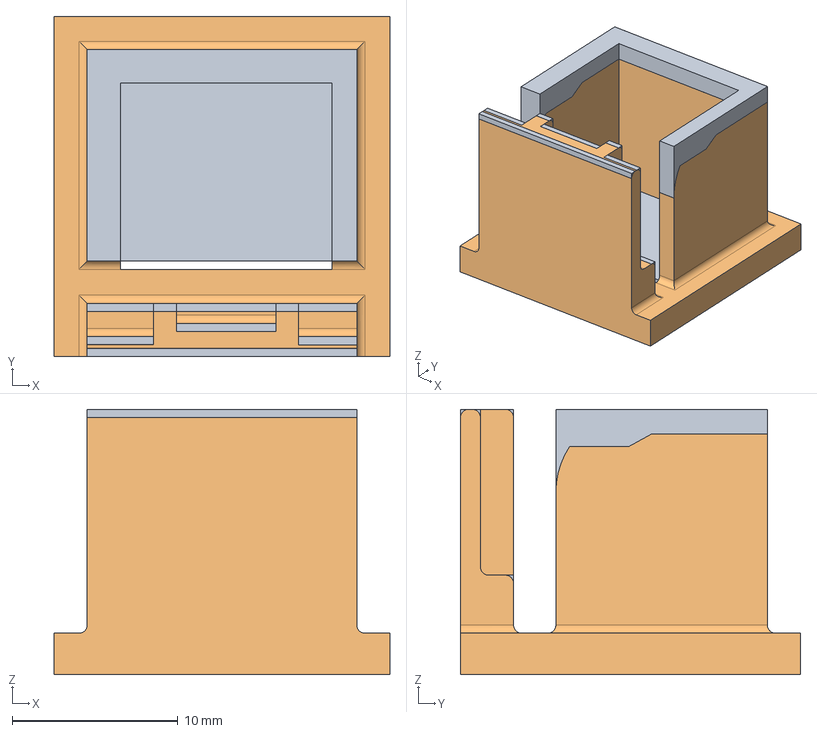
[picture p42: CAD file, 2019-07-19]
production_parts/printed_parts/usb_support/usb_support_mini_v1.5.fcstd
20.2 x 20.5 x 16.0 mm
Pocket003Body
Fillet002Body
