reprapperMC/kangaroopaw/production_parts/printed_parts/x-belt_mount/mini2_x-belt_mount_v0.6.fcstd

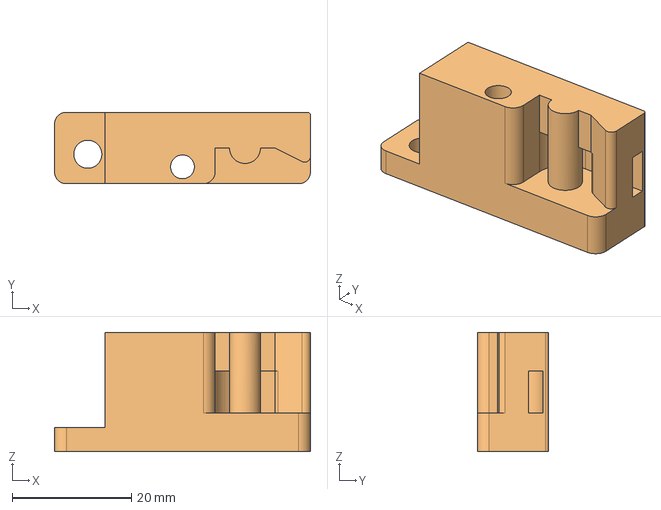
[picture p43: CAD file, 2019-09-13]
production_parts/printed_parts/x-belt_mount/mini2_x-belt_mount_v0.6.fcstd
43.0 x 12.0 x 20.0 mm
SubtractiveLoft001
