reprapperMC/kangaroopaw/production_parts/printed_parts/x_bearing_holder/x_bearing_holder_v3.8.1.stl

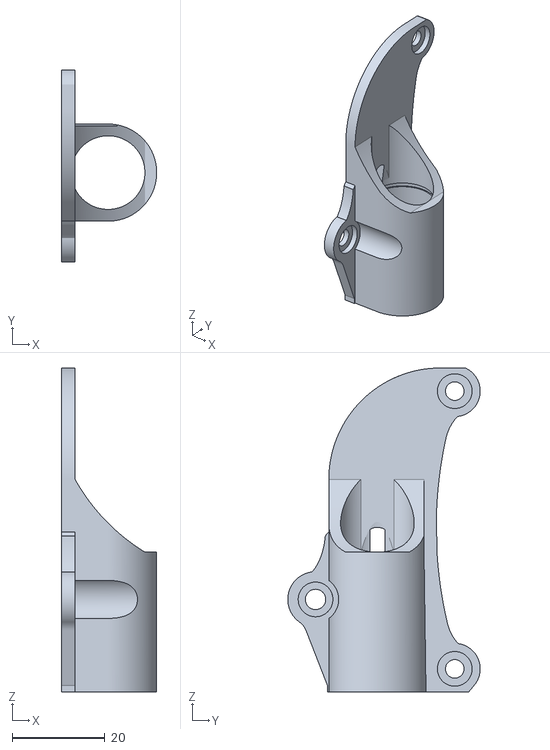
[picture p44: CAD file, 2019-07-19]
production_parts/printed_parts/x_bearing_holder/x_bearing_holder_v3.8.1.stl
20.6 x 41.6 x 70.0
