reprapperMC/kangaroopaw/production_parts/printed_parts/x_carriage_mini2/Minii_x_carriage_V2.1.fcstd

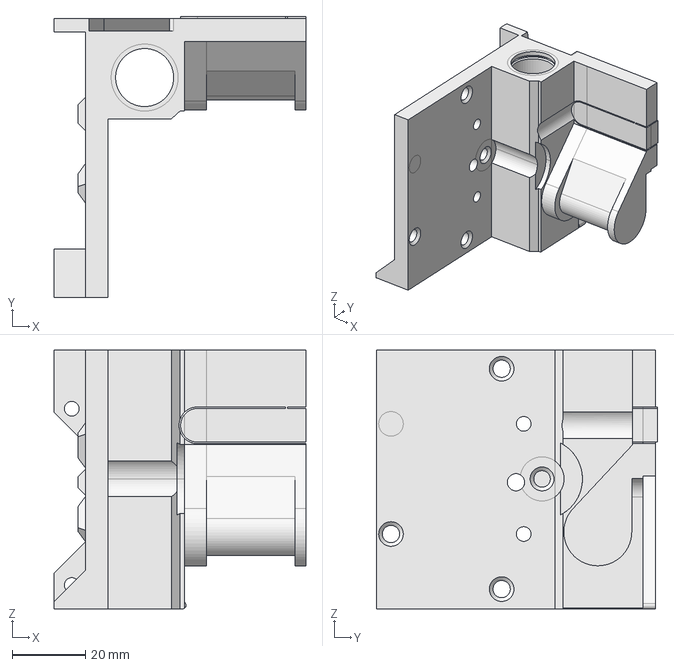
[picture p45: CAD file, 2019-04-02]
production_parts/printed_parts/x_carriage_mini2/Minii_x_carriage_V2.1.fcstd
68.5 x 76.5 x 70.5 mm
