reprapperMC/kangaroopaw/production_parts/printed_parts/x_end_idler_mini2/x_end_idler_v2.8.6_mini2.stl

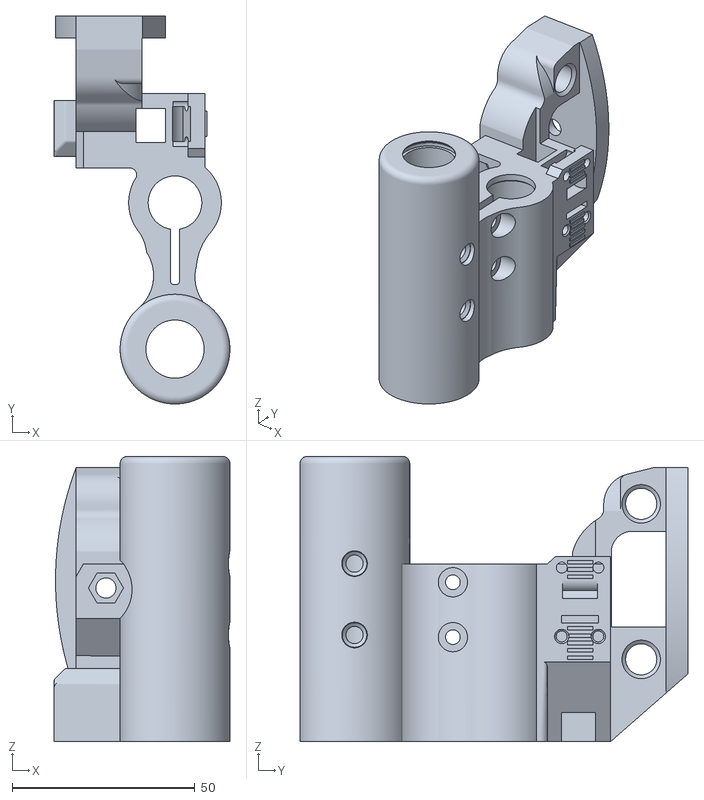
[picture p46: CAD file, 2019-07-19]
production_parts/printed_parts/x_end_idler_mini2/x_end_idler_v2.8.6_mini2.stl
48.0 x 106.0 x 78.0
