reprapperMC/kangaroopaw/production_parts/printed_parts/x_end_motor_mini2/x_end_motor_v2.5.3_mini2.stl

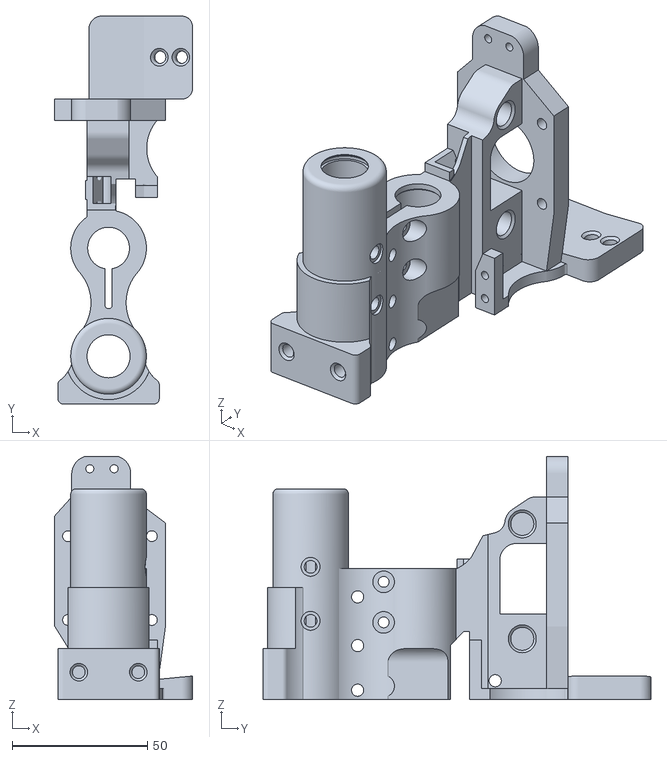
[picture p47: CAD file, 2019-07-19]
production_parts/printed_parts/x_end_motor_mini2/x_end_motor_v2.5.3_mini2.stl
51.1 x 143.5 x 90.0
