reprapperMC/kangaroopaw/production_parts/printed_parts/y-belt_mount/y_belt_mount_v6.1.fcstd

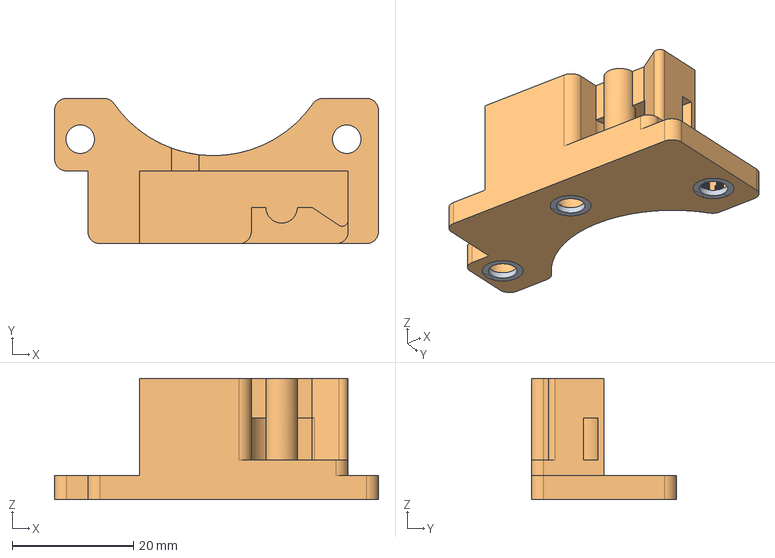
[picture p48: CAD file, 2019-09-13]
production_parts/printed_parts/y-belt_mount/y_belt_mount_v6.1.fcstd
53.5 x 24.0 x 20.0 mm
