reprapperMC/kangaroopaw/production_parts/printed_parts/y-idler/y-idler-mini_black_v1.6.step

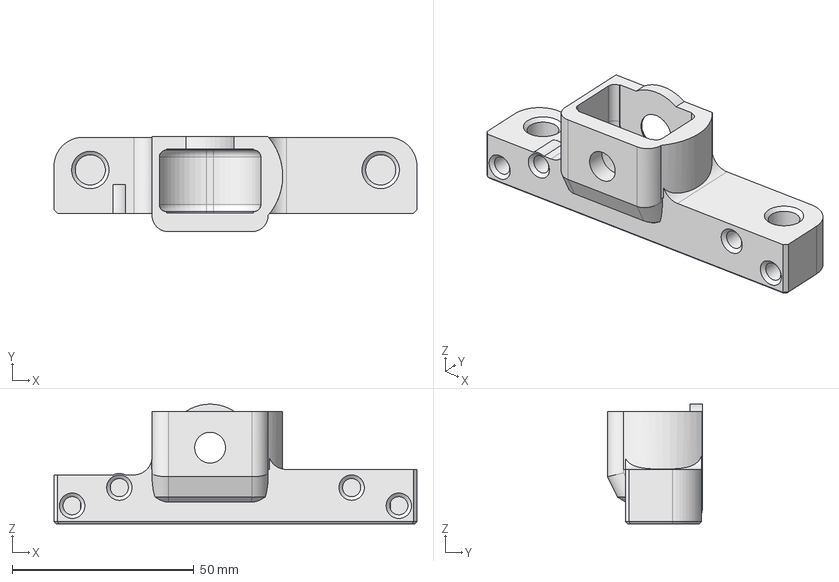
[picture p49: CAD file, 2019-07-19]
production_parts/printed_parts/y-idler/y-idler-mini_black_v1.6.step
100.0 x 26.3 x 33.0 mm
