reprapperMC/kangaroopaw/production_parts/printed_parts/y-single-bearing-holder/Y_single_bearing_holder_v0.3.fcstd

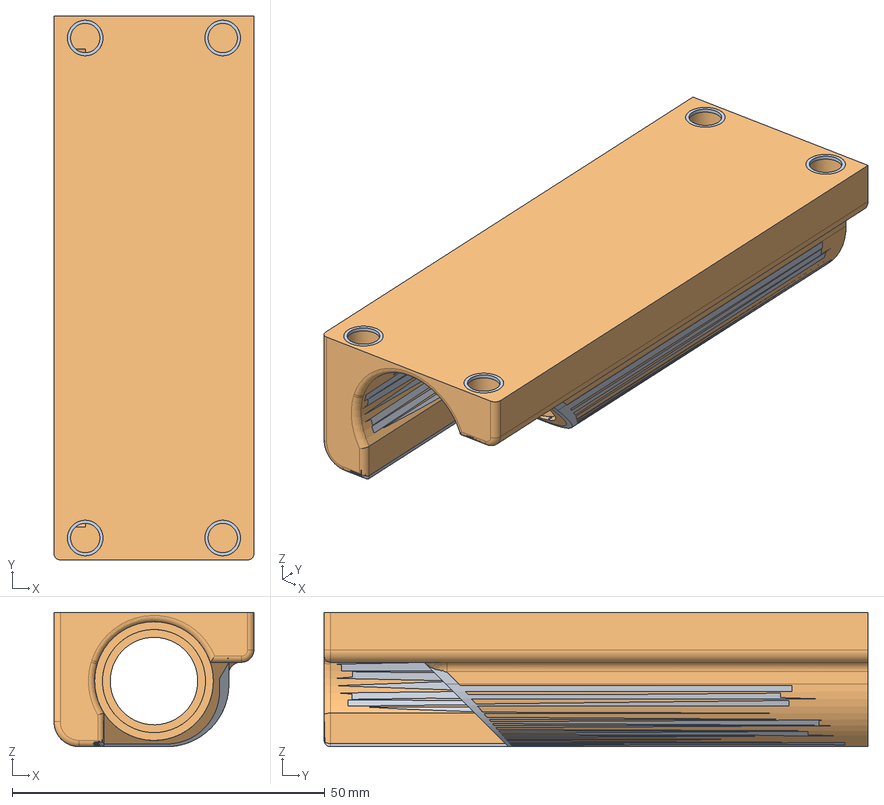
[picture p51: CAD file, 2019-07-19]
production_parts/printed_parts/y-single-bearing-holder/Y_single_bearing_holder_v0.3.fcstd
32.0 x 87.0 x 21.5 mm
