reprapperMC/kangaroopaw/production_parts/printed_parts/z_belt_clamp/z_belt_clamp_v1.3.fcstd

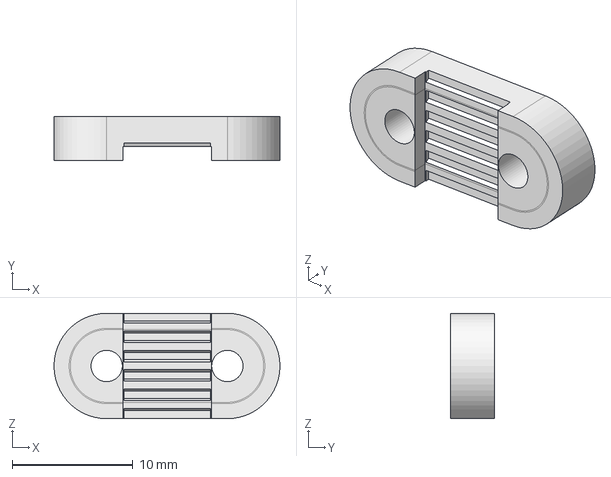
[picture p52: CAD file, 2019-07-19]
production_parts/printed_parts/z_belt_clamp/z_belt_clamp_v1.3.fcstd
18.8 x 3.65 x 8.74 mm
