reprapperMC/kangaroopaw/production_parts/printed_parts/z_brake_mount/z_brake_mount.fcstd

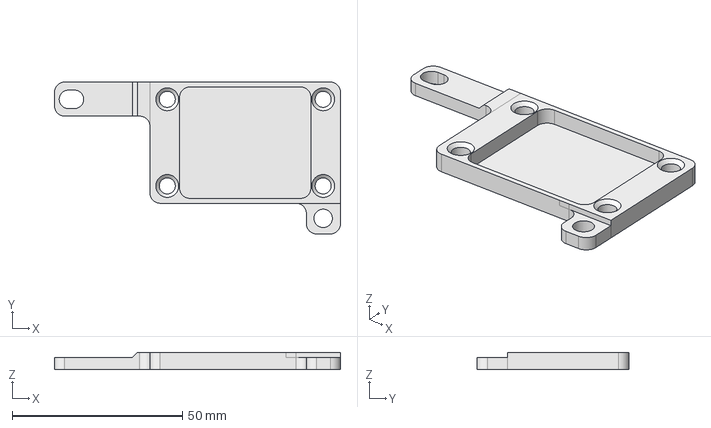
[picture p53: CAD file, 2019-07-19]
production_parts/printed_parts/z_brake_mount/z_brake_mount.fcstd
83.9 x 44.6 x 5.00 mm
