reprapperMC/kangaroopaw/production_parts/printed_parts/z_lower_left_mini2/Z-Lower_Left_Mini2_v1.7.1.stl

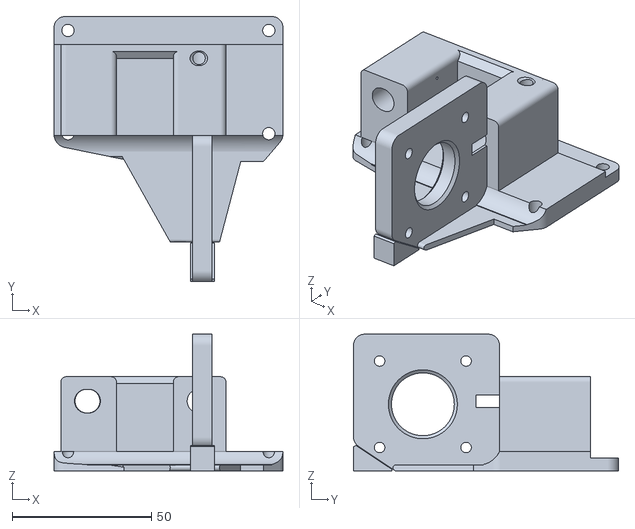
[picture p54: CAD file, 2019-07-19]
production_parts/printed_parts/z_lower_left_mini2/Z-Lower_Left_Mini2_v1.7.1.stl
82.1 x 95.0 x 49.0
