reprapperMC/kangaroopaw/production_parts/printed_parts/z_upper_right_mini2/Z-Upper_Right_Mini2_v1.4.fcstd

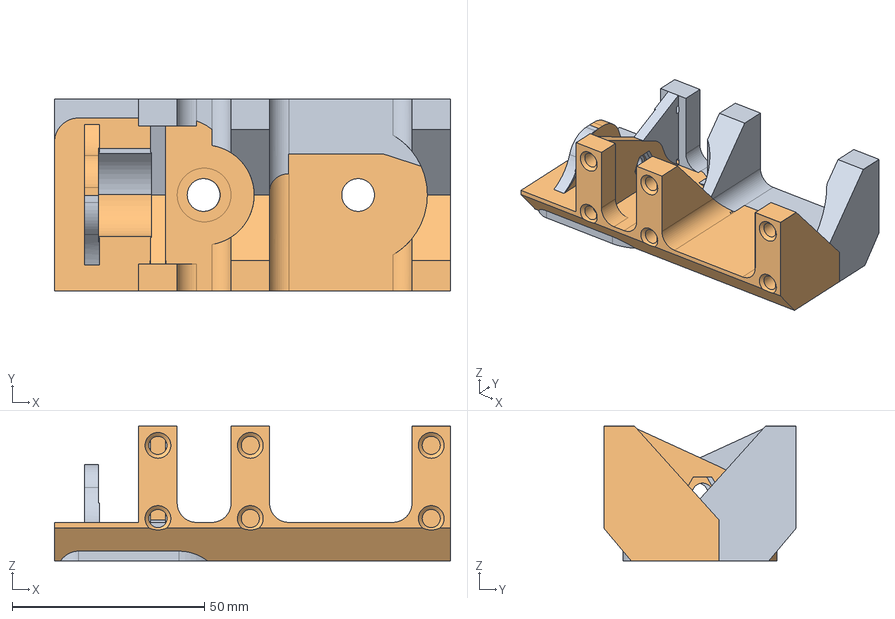
[picture p56: CAD file, 2019-07-19]
production_parts/printed_parts/z_upper_right_mini2/Z-Upper_Right_Mini2_v1.4.fcstd
102.9 x 50.0 x 35.0 mm
Pocket (Mirror #1)
