reprapperMC/kangaroopaw/production_parts/tool_head/hamilton_10ml_barrel_81620.fcstd

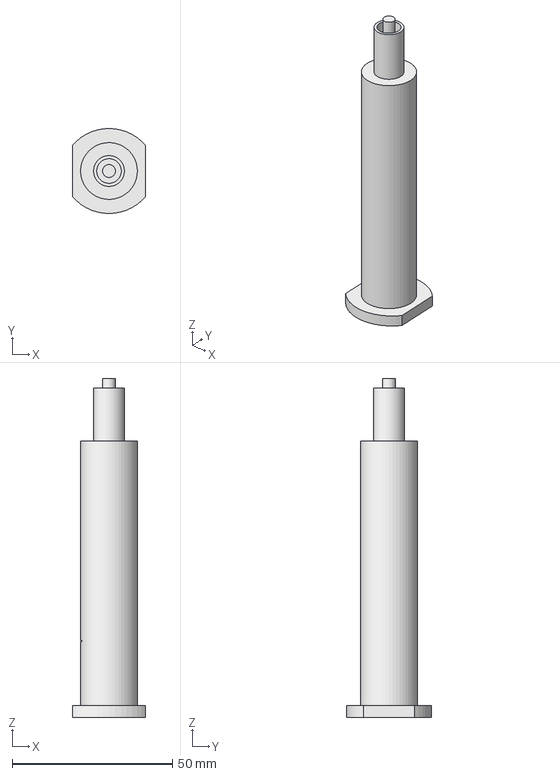
[picture p57: CAD file, 2019-05-06]
production_parts/tool_head/hamilton_10ml_barrel_81620.fcstd
22.9 x 26.5 x 105.7 mm
