reprapperMC/kangaroopaw/production_parts/tool_head/machined_parts/path/motor_mount_v2.step

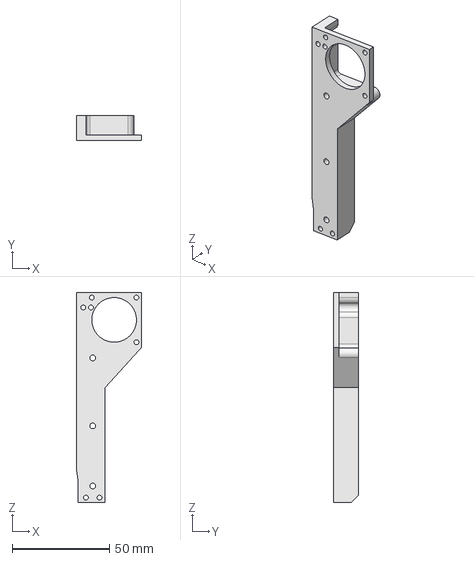
[picture p58: CAD file, 2019-06-07]
production_parts/tool_head/machined_parts/path/motor_mount_v2.step
33.6 x 13.0 x 108.2 mm
