reprapperMC/kangaroopaw/production_parts/tool_head/machined_parts/PP-MP0279_motor_mount_revB.fcstd

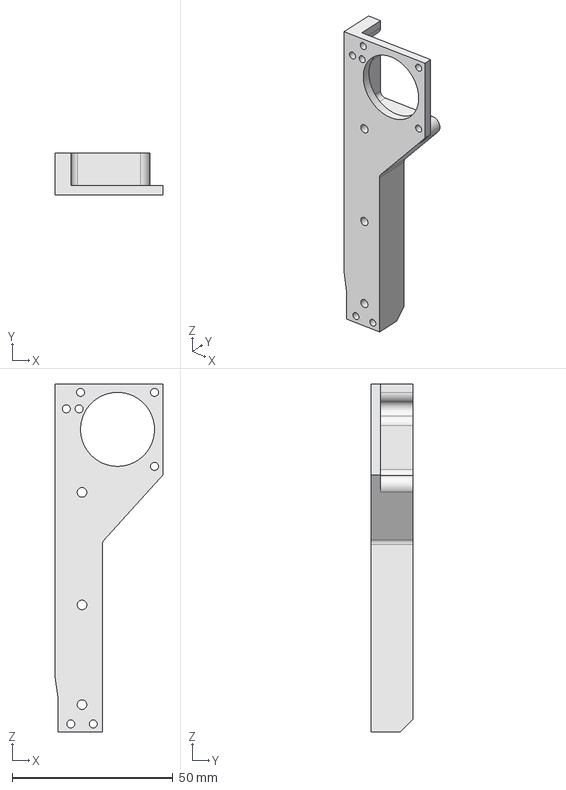
[picture p59: CAD file, 2019-08-26]
production_parts/tool_head/machined_parts/PP-MP0279_motor_mount_revB.fcstd
33.6 x 13.0 x 108.2 mm
