reprapperMC/kangaroopaw/production_parts/tool_head/printed_parts/PP-GP0451_Syringe_Pump_Mount/Syringe_pump_mount_v2.2.fcstd

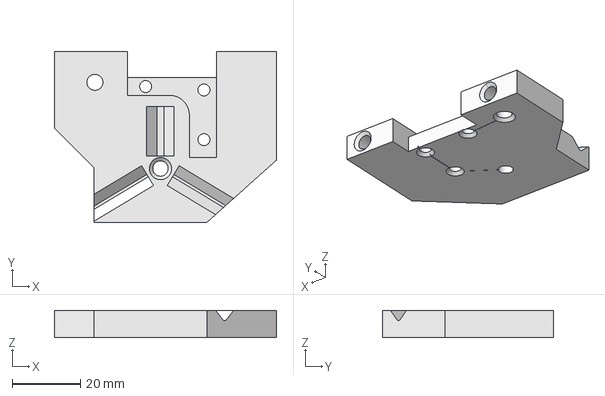
[picture p60: CAD file, 2019-08-07]
production_parts/tool_head/printed_parts/PP-GP0451_Syringe_Pump_Mount/Syringe_pump_mount_v2.2.fcstd
65.0 x 50.0 x 8.00 mm
