reprapperMC/kangaroopaw/production_parts/tool_head/printed_parts/PP-GP0452_Syringe_Pump_Cover/syringe_pump_cover_v2.fcstd

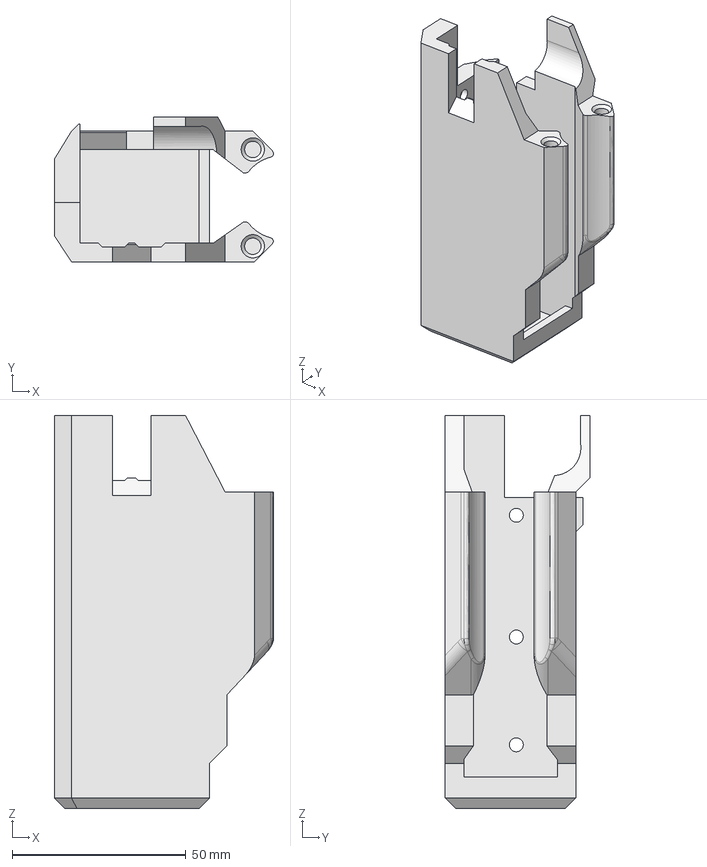
[picture p61: CAD file, 2019-07-19]
production_parts/tool_head/printed_parts/PP-GP0452_Syringe_Pump_Cover/syringe_pump_cover_v2.fcstd
63.0 x 41.6 x 113.0 mm
