reprapperMC/kangaroopaw/production_parts/tool_head/printed_parts/PP-GP0453_Syringe_Collar_Mount/Syringe_collar_mount.fcstd

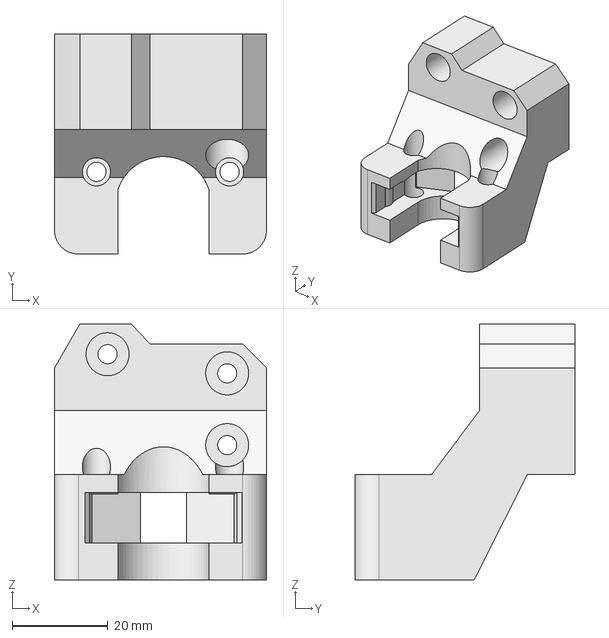
[picture p62: CAD file, 2019-05-21]
production_parts/tool_head/printed_parts/PP-GP0453_Syringe_Collar_Mount/Syringe_collar_mount.fcstd
44.3 x 46.0 x 53.5 mm
