reprapperMC/kangaroopaw/production_parts/tool_head/printed_parts/PP-GP0456_Syringe_Collar_81620/syringe_collar_81620.fcstd

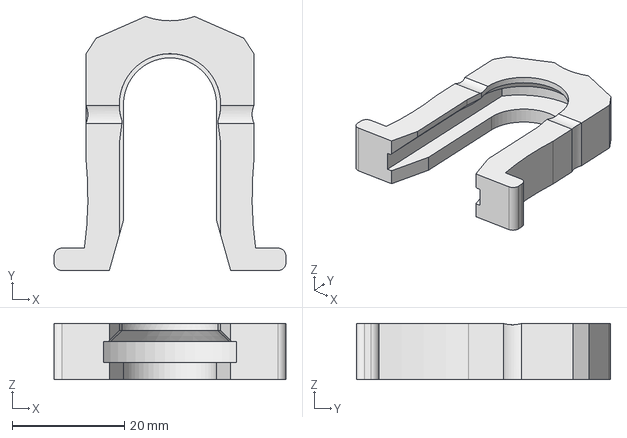
[picture p63: CAD file, 2019-05-06]
production_parts/tool_head/printed_parts/PP-GP0456_Syringe_Collar_81620/syringe_collar_81620.fcstd
41.4 x 45.3 x 10.0 mm
