reprapperMC/kangaroopaw/production_parts/tool_head/printed_parts/PP-GP0457_Cable_Cover/cable_cover.fcstd

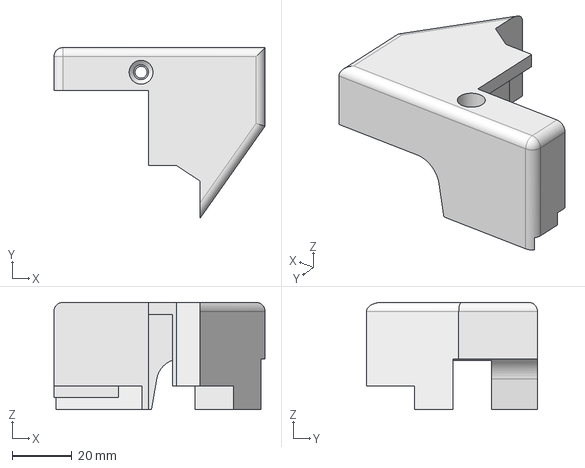
[picture p64: CAD file, 2019-07-03]
production_parts/tool_head/printed_parts/PP-GP0457_Cable_Cover/cable_cover.fcstd
70.8 x 57.3 x 36.0 mm
