reprapperMC/kangaroopaw/production_parts/tool_head/printed_parts/Sryinge_plunger_coupler_10ml_BD/syringe_plunger_coupler_10ml_BD.fcstd

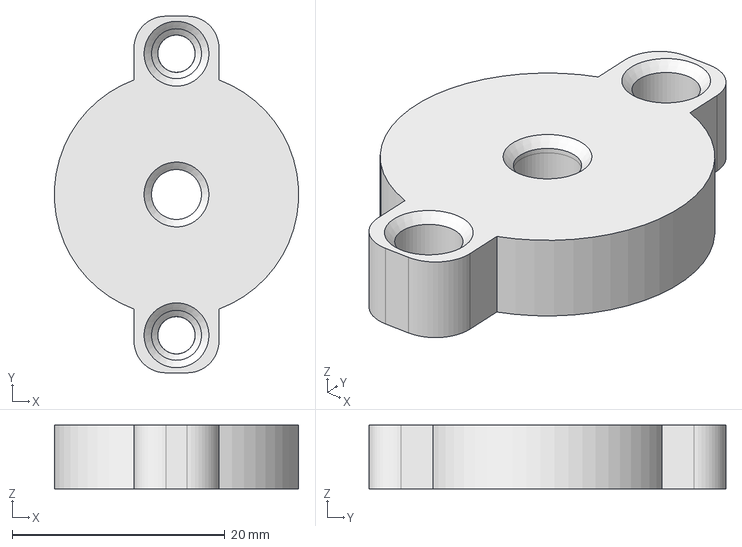
[picture p65: CAD file, 2019-09-13]
production_parts/tool_head/printed_parts/Sryinge_plunger_coupler_10ml_BD/syringe_plunger_coupler_10ml_BD.fcstd
23.0 x 33.6 x 6.00 mm
