reprapperMC/kangaroopaw/production_parts/tool_head/printed_parts/syringe_collar.fcstd

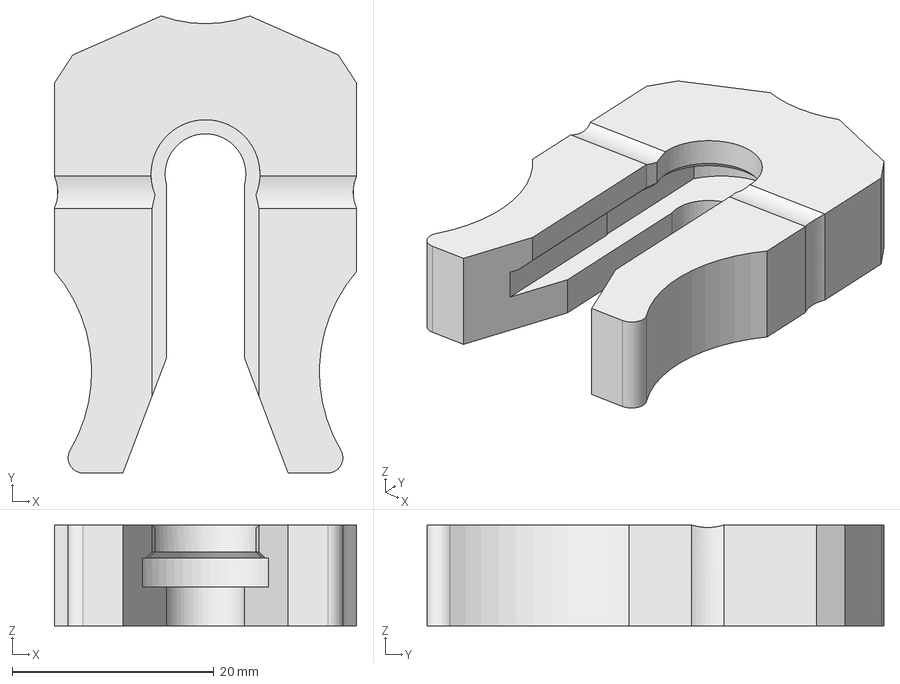
[picture p66: CAD file, 2019-05-06]
production_parts/tool_head/printed_parts/syringe_collar.fcstd
30.0 x 45.3 x 10.0 mm
