reprapperMC/kangaroopaw/production_parts/tool_head/printed_parts/Syringe_Collar_10ml_BD/Syringe_Collar_10ml_BD.fcstd

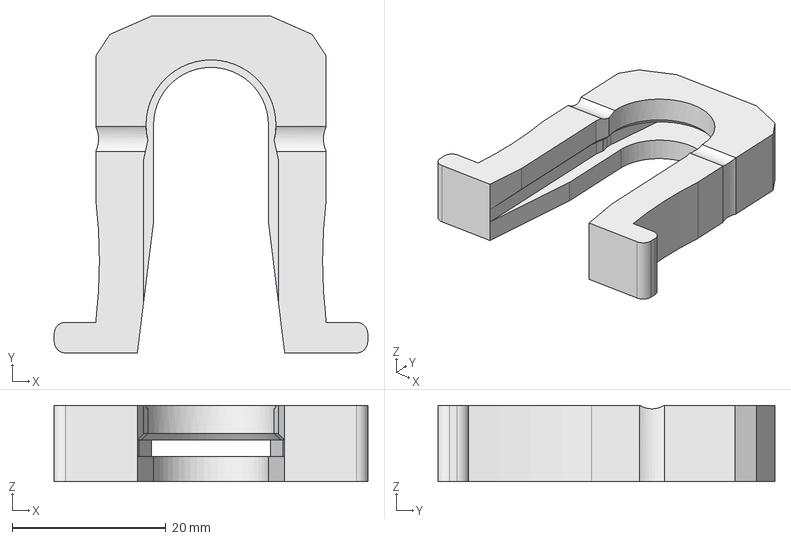
[picture p67: CAD file, 2019-09-13]
production_parts/tool_head/printed_parts/Syringe_Collar_10ml_BD/Syringe_Collar_10ml_BD.fcstd
40.8 x 43.8 x 9.90 mm
