reprapperMC/kangaroopaw/production_parts/tool_head/printed_parts/Syringe_plunger_coupler_lock_10ml_BD/syringe_plunger_coupler_lock_10ml_BD.fcstd

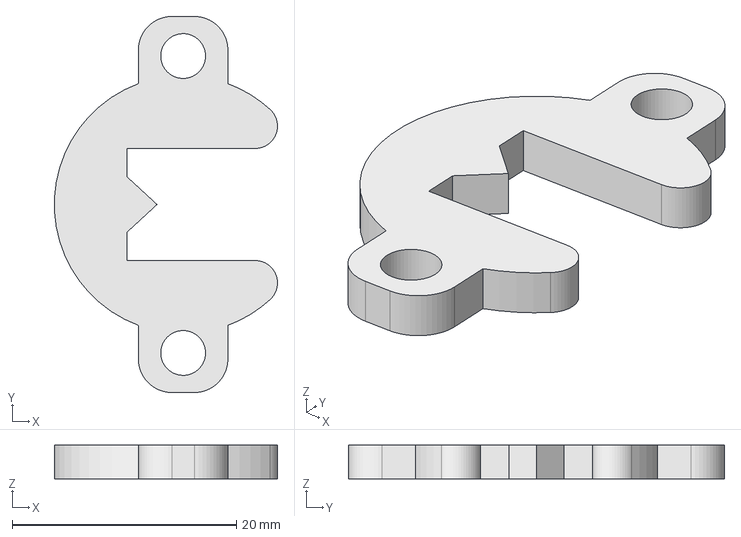
[picture p68: CAD file, 2019-09-13]
production_parts/tool_head/printed_parts/Syringe_plunger_coupler_lock_10ml_BD/syringe_plunger_coupler_lock_10ml_BD.fcstd
19.9 x 33.6 x 3.00 mm
