reprapperMC/kangaroopaw/production_parts/tooling/motor-spacers/pump-motor.fcstd

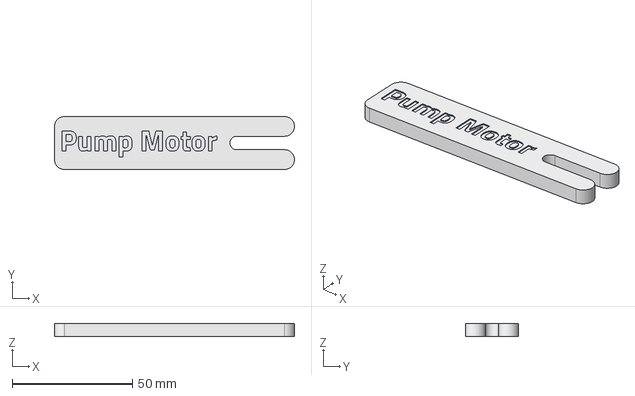
[picture p69: CAD file, 2019-09-13]
production_parts/tooling/motor-spacers/pump-motor.fcstd
100.0 x 22.0 x 5.60 mm
