reprapperMC/kangaroopaw/production_parts/tooling/syringe-pump_test-stand/assembly/225mm-extrusion.fcstd

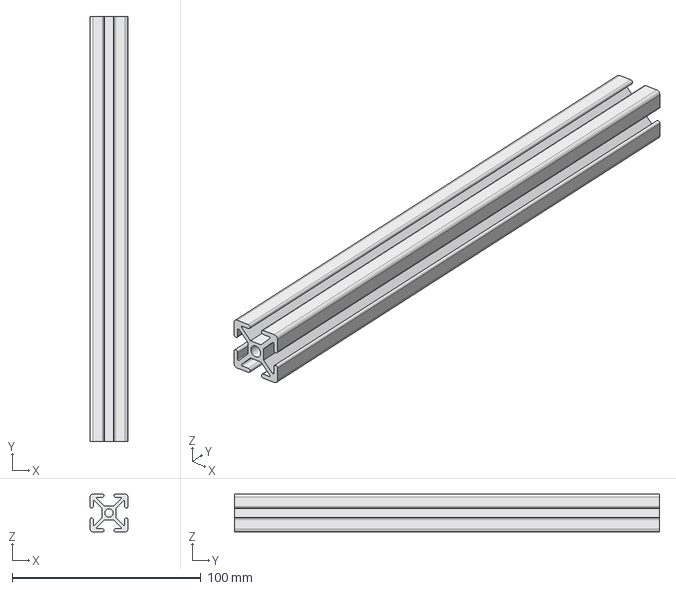
[picture p70: CAD file, 2019-09-04]
production_parts/tooling/syringe-pump_test-stand/assembly/225mm-extrusion.fcstd
20.0 x 225.0 x 20.0 mm
