reprapperMC/kangaroopaw/production_parts/tooling/syringe-pump_test-stand/syringe-pump_hanger.fcstd

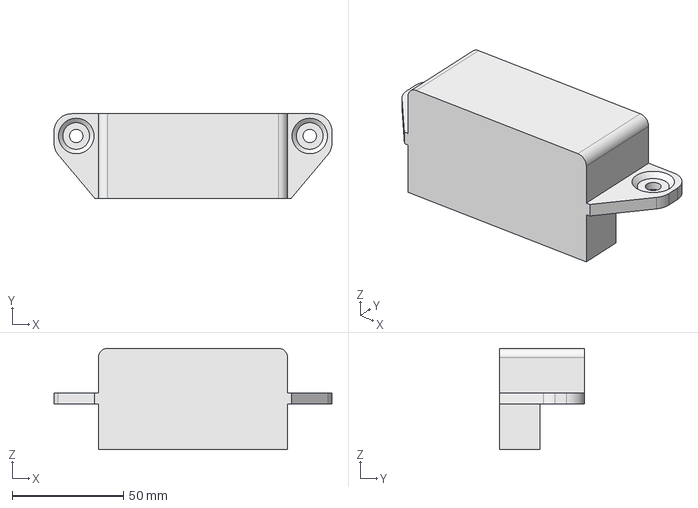
[picture p71: CAD file, 2019-09-04]
production_parts/tooling/syringe-pump_test-stand/syringe-pump_hanger.fcstd
125.0 x 38.0 x 45.5 mm
