reprapperMC/kangaroopaw/sample_prints/artery_small_perfusion_test.stl

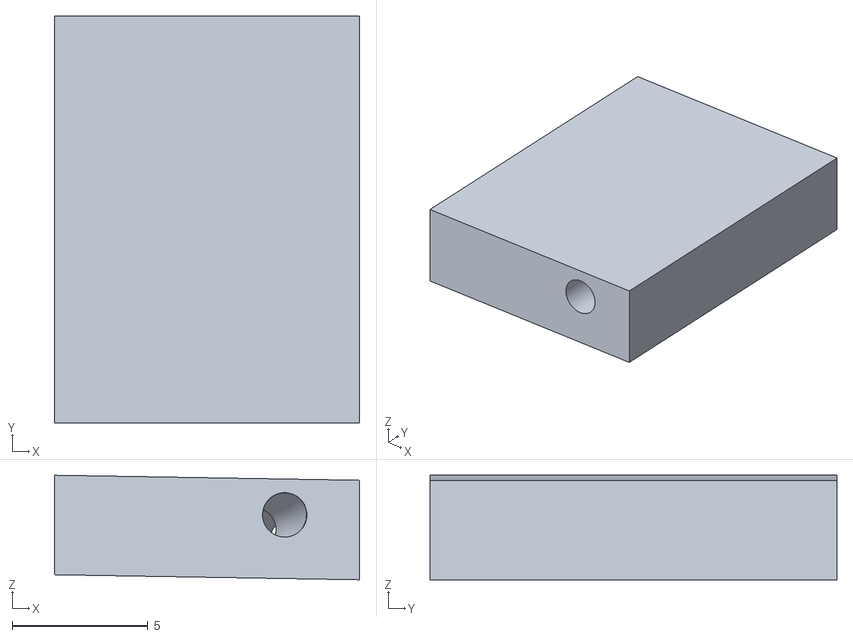
[picture p72: CAD file, 2019-09-30]
sample_prints/artery_small_perfusion_test.stl
11.3 x 15.0 x 3.86
