reprapperMC/kangaroopaw/production_parts/assembly/assembly_parts/M5_insert.fcstd

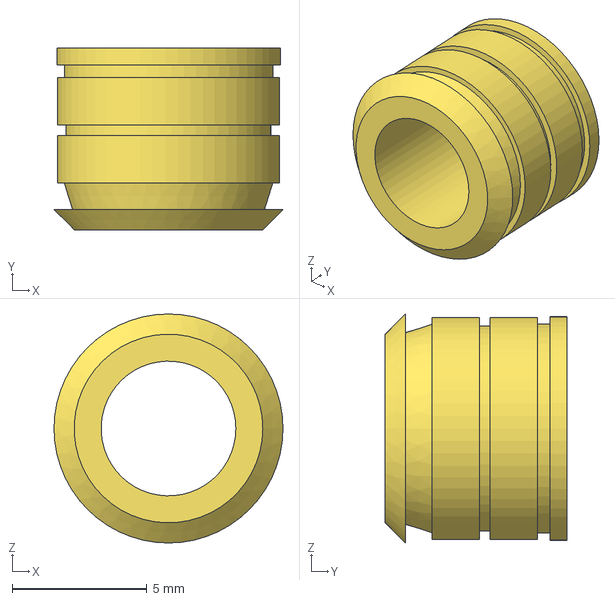
[picture p73: CAD file, 2019-07-19]
production_parts/assembly/assembly_parts/M5_insert.fcstd
8.50 x 6.75 x 8.50 mm
