reprapperMC/kangaroopaw/production_parts/assembly/assembly_subs/kpaw_y_axis_guide.step

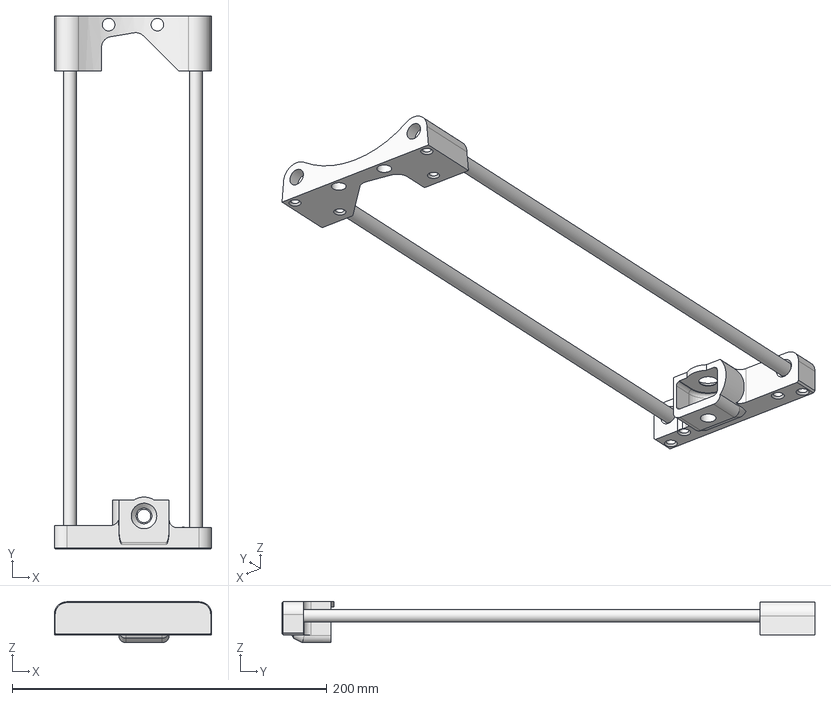
[picture p74: CAD file, 2019-07-19]
production_parts/assembly/assembly_subs/kpaw_y_axis_guide.step
100.0 x 338.6 x 26.2 mm
