reprapperMC/kangaroopaw/production_parts/assembly/assembly_subs/PEM/pem_pins.fcstd

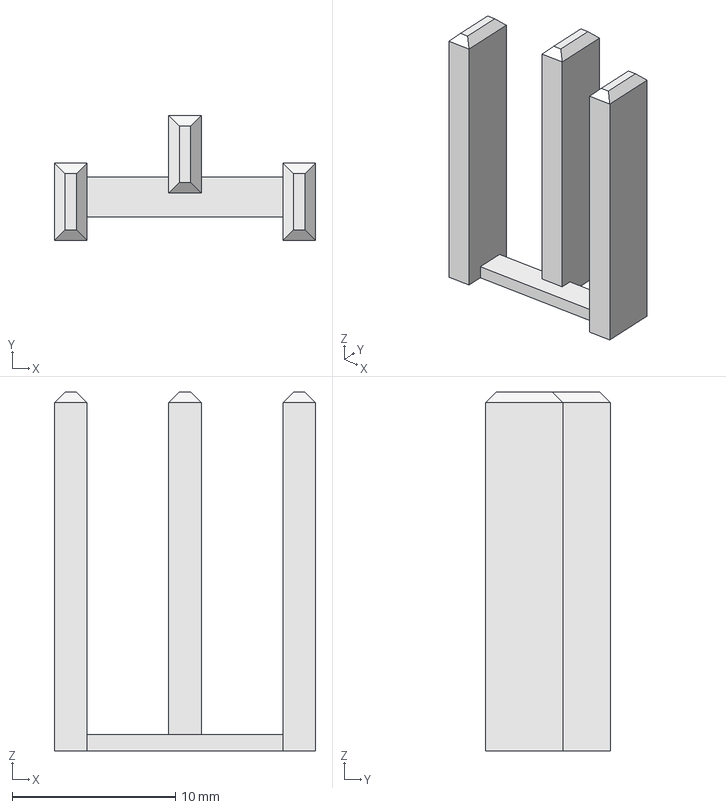
[picture p75: CAD file, 2019-07-19]
production_parts/assembly/assembly_subs/PEM/pem_pins.fcstd
16.0 x 7.66 x 22.0 mm
