reprapperMC/kangaroopaw/production_parts/assembly/inserts_assemblies/x_belt_mount_inserts.fcstd

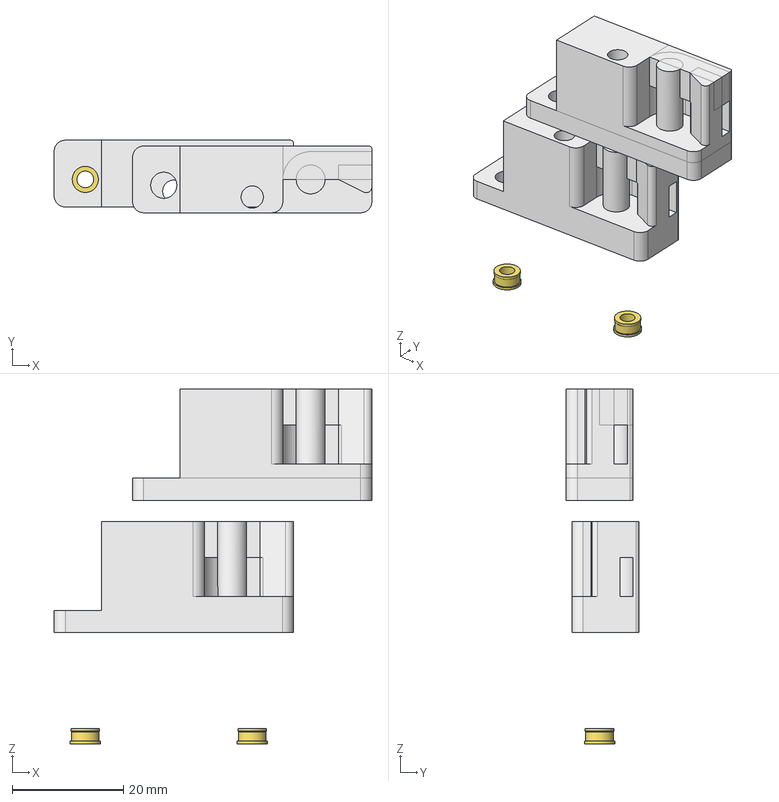
[picture p77: CAD file, 2019-10-07]
production_parts/assembly/inserts_assemblies/x_belt_mount_inserts.fcstd
57.1 x 13.1 x 63.8 mm
SubtractiveLoft001
M3_insert_01
M3_insert_02
