reprapperMC/kangaroopaw/production_parts/assembly/LCD_assembly/USB_board.fcstd

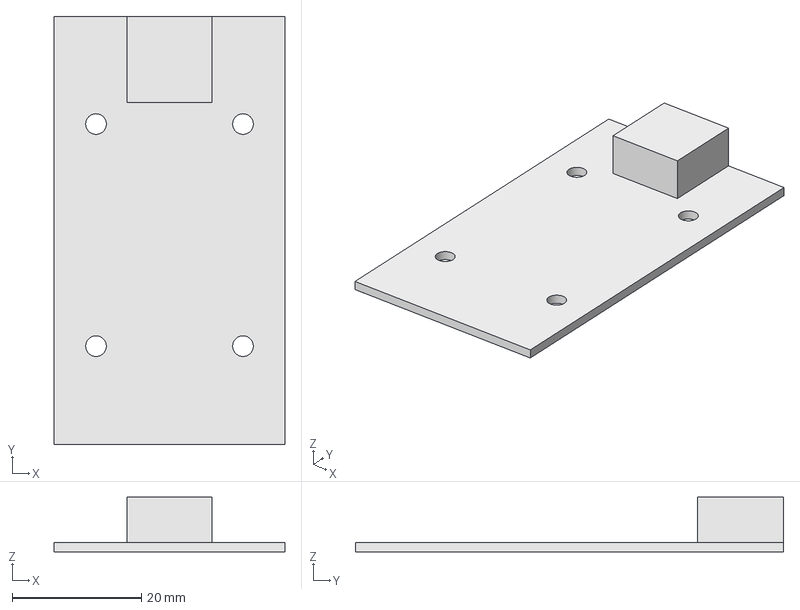
[picture p78: CAD file, 2019-07-19]
production_parts/assembly/LCD_assembly/USB_board.fcstd
35.8 x 66.2 x 8.50 mm
