reprapperMC/kangaroopaw/production_parts/machined_parts/electronics_case/electronics-case-mini-white_PP-FP0167.step

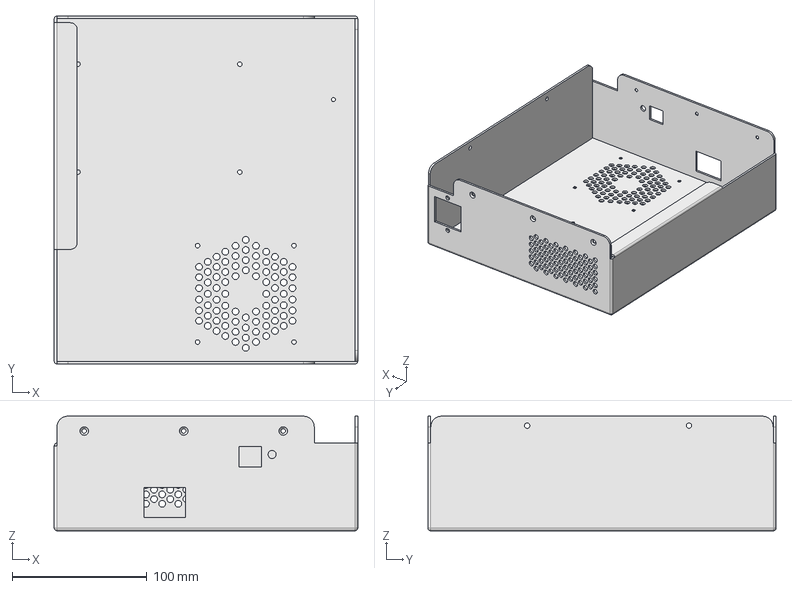
[picture p79: CAD file, 2019-03-19]
production_parts/machined_parts/electronics_case/electronics-case-mini-white_PP-FP0167.step
225.0 x 258.0 x 85.0 mm
