reprapperMC/kangaroopaw/production_parts/parts/fsr07.fcstd

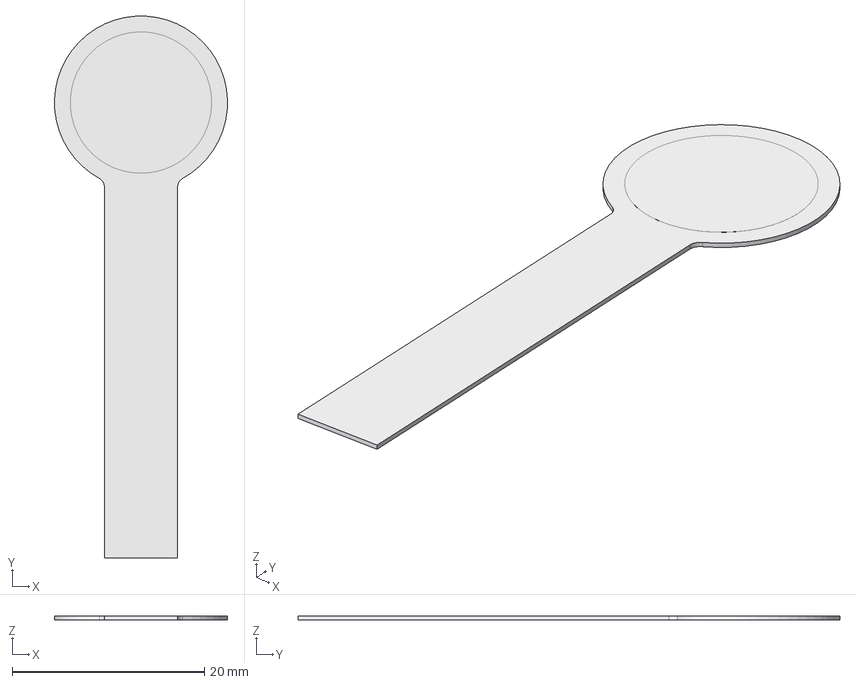
[picture p80: CAD file, 2019-05-09]
production_parts/parts/fsr07.fcstd
18.0 x 56.3 x 0.385 mm
