reprapperMC/kangaroopaw/production_parts/tool_head/hamilton_10ml_plunger_81620.fcstd

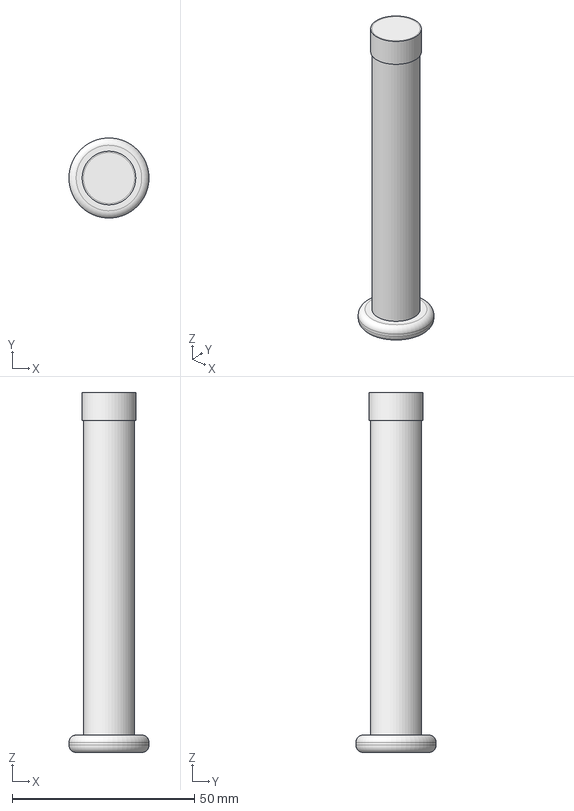
[picture p82: CAD file, 2019-05-06]
production_parts/tool_head/hamilton_10ml_plunger_81620.fcstd
22.0 x 22.0 x 98.8 mm
