reprapperMC/kangaroopaw/production_parts/tool_head/machined_parts/path/collar_mount_flange.step

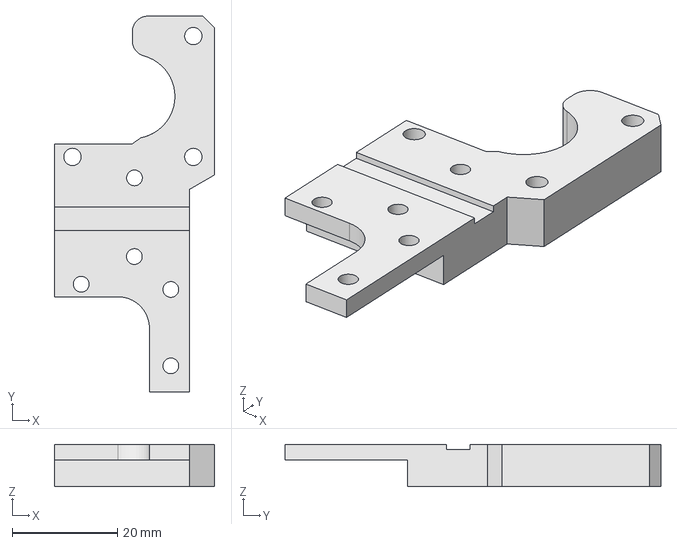
[picture p83: CAD file, 2019-06-07]
production_parts/tool_head/machined_parts/path/collar_mount_flange.step
30.5 x 71.6 x 8.00 mm
