reprapperMC/kangaroopaw/production_parts/tooling/syringe-pump_test-stand/touchscreen_cover_for-stand.fcstd

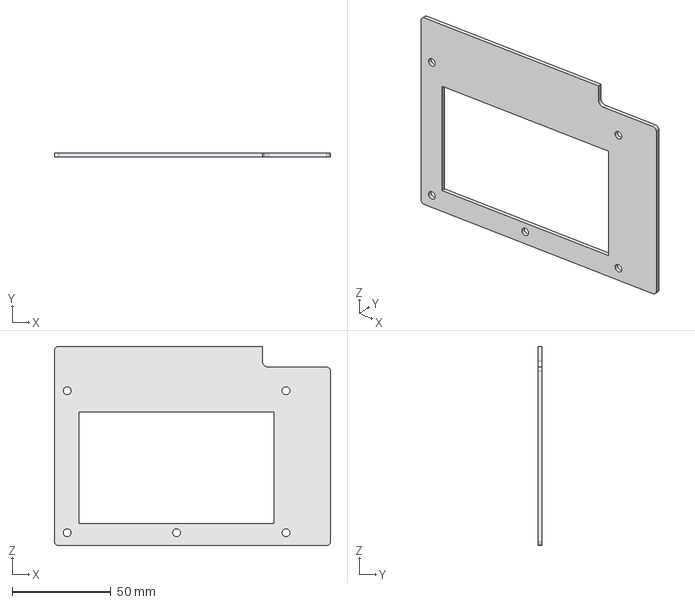
[picture p84: CAD file, 2019-09-04]
production_parts/tooling/syringe-pump_test-stand/touchscreen_cover_for-stand.fcstd
140.0 x 2.00 x 101.0 mm
