reprapperMC/kangaroopaw/sample_prints/Perfusion_Tube.stl

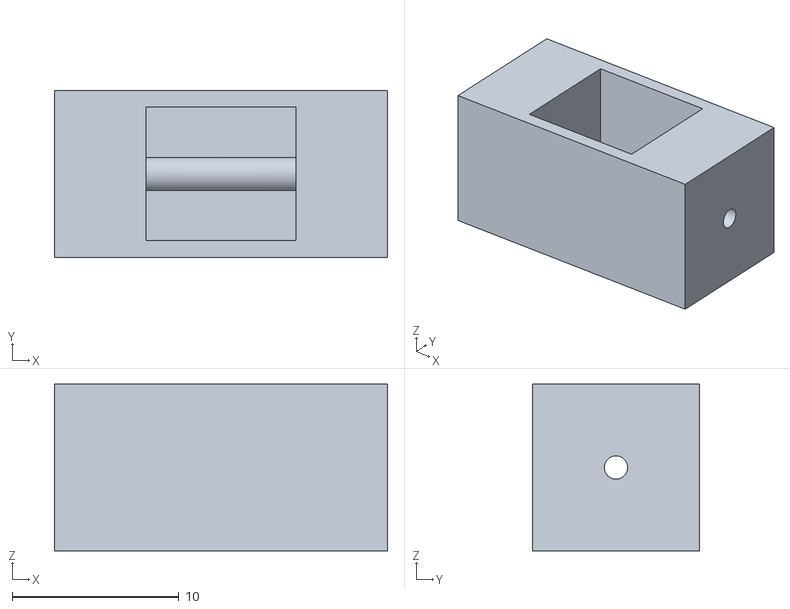
[picture p85: CAD file, 2019-08-29]
sample_prints/Perfusion_Tube.stl
20.0 x 10.0 x 10.0
