reprapperMC/kangaroopaw/production_parts/assembly/assembly_parts/1mmx20mm_dowel_pin.fcstd

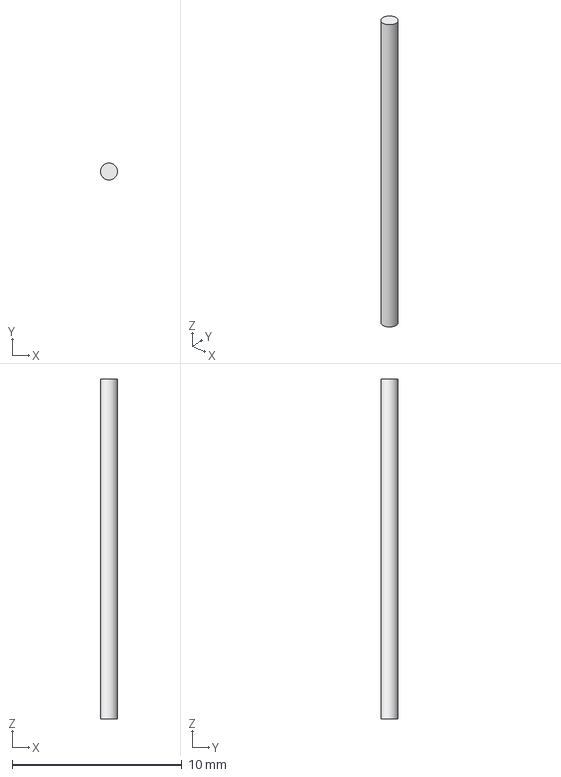
[picture p86: CAD file, 2019-07-19]
production_parts/assembly/assembly_parts/1mmx20mm_dowel_pin.fcstd
0.999 x 1 x 20.0 mm
