reprapperMC/kangaroopaw/production_parts/assembly/assembly_subs/PEM/pem_case.fcstd

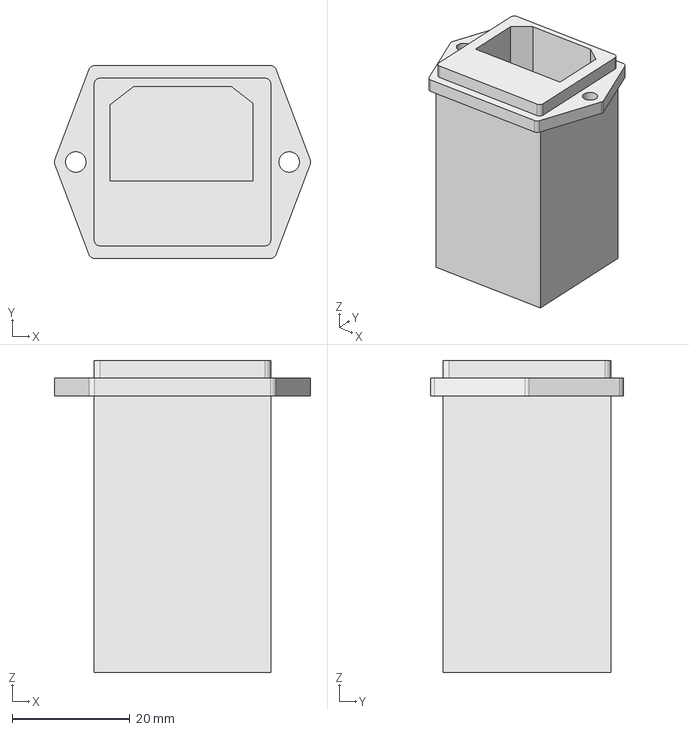
[picture p87: CAD file, 2019-07-19]
production_parts/assembly/assembly_subs/PEM/pem_case.fcstd
43.6 x 32.8 x 53.0 mm
