reprapperMC/kangaroopaw/production_parts/assembly/assembly_subs/RAMBO/PCB.fcstd

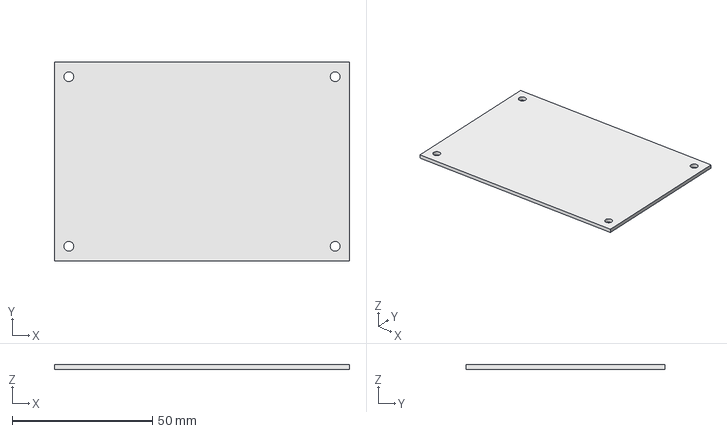
[picture p88: CAD file, 2019-07-19]
production_parts/assembly/assembly_subs/RAMBO/PCB.fcstd
105.2 x 71.2 x 1.65 mm
