reprapperMC/kangaroopaw/production_parts/assembly/assembly_subs/x_chain_assem.fcstd

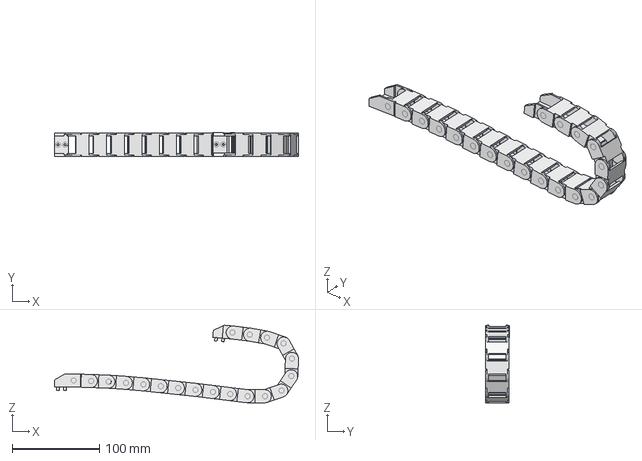
[picture p89: CAD file, 2019-07-19]
production_parts/assembly/assembly_subs/x_chain_assem.fcstd
279.4 x 27.3 x 88.8 mm
