reprapperMC/kangaroopaw/production_parts/assembly/inserts_assemblies/Syringe_plunger_coupler_10mL_BD_inserts.fcstd

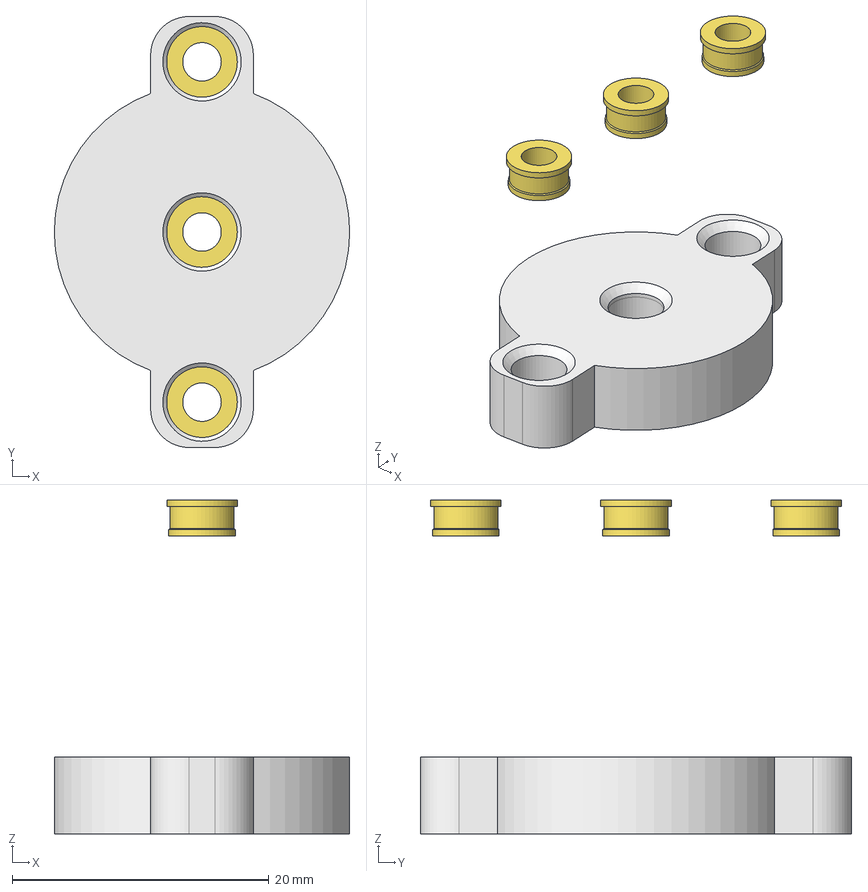
[picture p90: CAD file, 2019-09-13]
production_parts/assembly/inserts_assemblies/Syringe_plunger_coupler_10mL_BD_inserts.fcstd
23.0 x 33.6 x 26.0 mm
syringe_plunger_coupler_10ml_BD_01
M3_insert_01
M3_insert_02
M3_insert_03
