reprapperMC/kangaroopaw/production_parts/parts/fsr05.fcstd

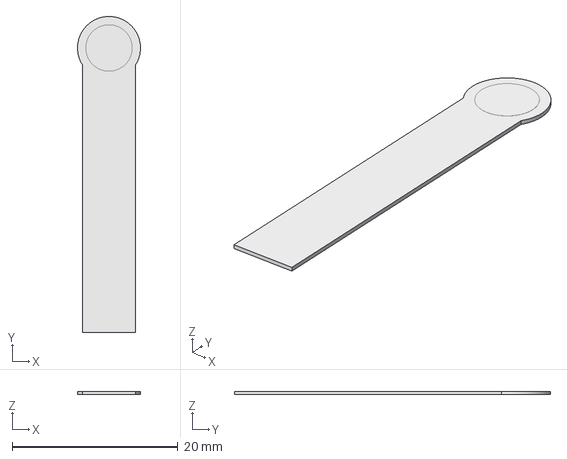
[picture p91: CAD file, 2019-05-09]
production_parts/parts/fsr05.fcstd
7.60 x 38.1 x 0.385 mm
