reprapperMC/kangaroopaw/production_parts/tool_head/hamilton_5ml_barrel_81520.fcstd

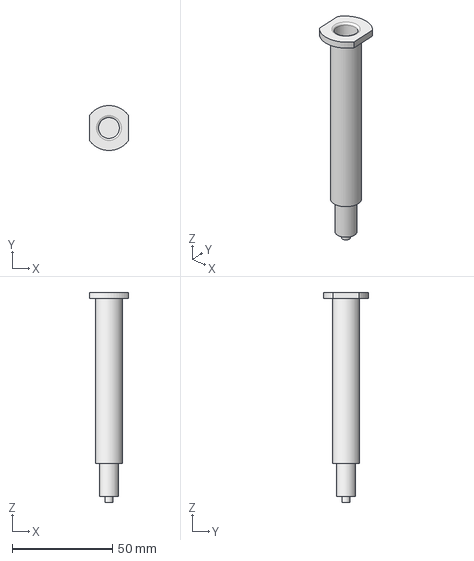
[picture p92: CAD file, 2019-05-06]
production_parts/tool_head/hamilton_5ml_barrel_81520.fcstd
19.2 x 22.5 x 105.0 mm
