reprapperMC/kangaroopaw/production_parts/tooling/syringe-pump_test-stand/bottom-left-corner.fcstd

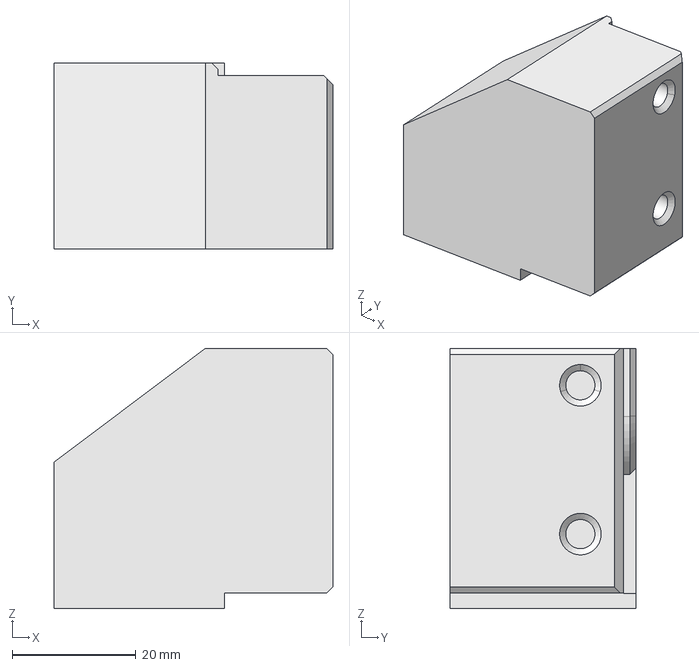
[picture p93: CAD file, 2019-09-04]
production_parts/tooling/syringe-pump_test-stand/bottom-left-corner.fcstd
45.0 x 30.0 x 42.0 mm
