reprapperMC/kangaroopaw/sample_prints/Elliptical_calibration_window.STL

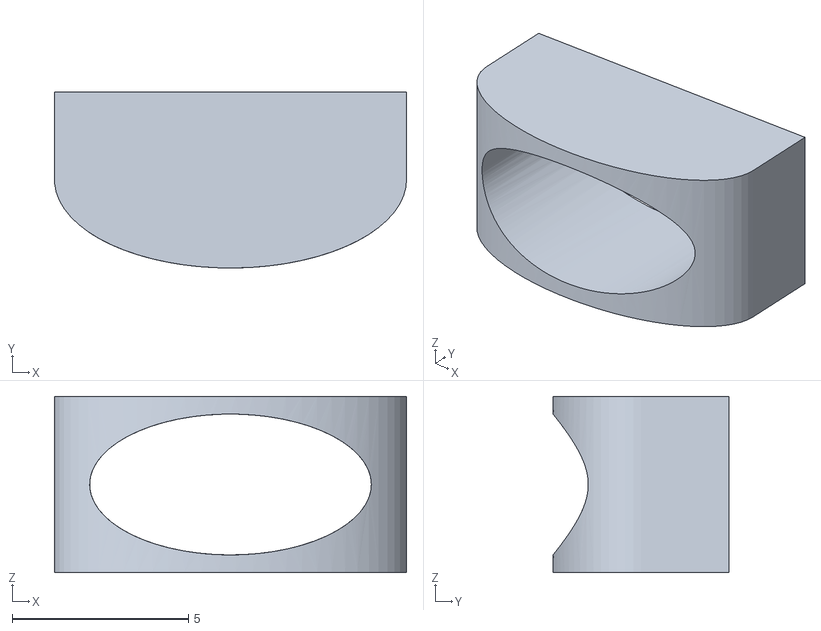
[picture p94: CAD file, 2019-08-29]
sample_prints/Elliptical_calibration_window.STL
10.0 x 5.00 x 5.00
