reprapperMC/kangaroopaw/production_parts/assembly/assembly_parts/y_belt.fcstd

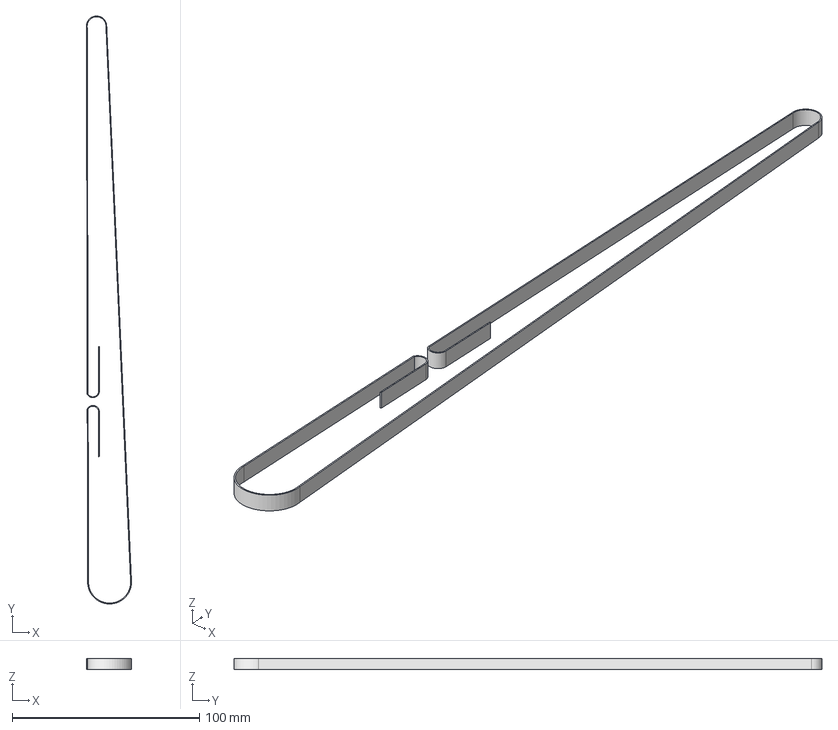
[picture p95: CAD file, 2019-07-19]
production_parts/assembly/assembly_parts/y_belt.fcstd
24.1 x 314.2 x 6.00 mm
