reprapperMC/kangaroopaw/production_parts/assembly/assembly_subs/x_gantry.fcstd

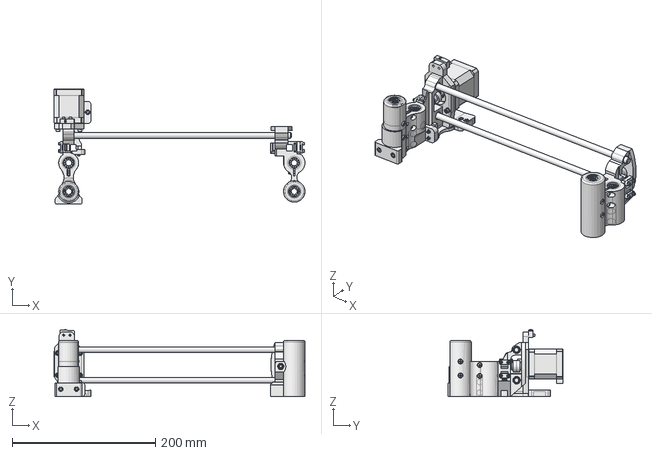
[picture p96: CAD file, 2019-07-19]
production_parts/assembly/assembly_subs/x_gantry.fcstd
350.4 x 160.9 x 94.1 mm
