reprapperMC/kangaroopaw/production_parts/assembly/LCD_assembly/lcd_board.fcstd

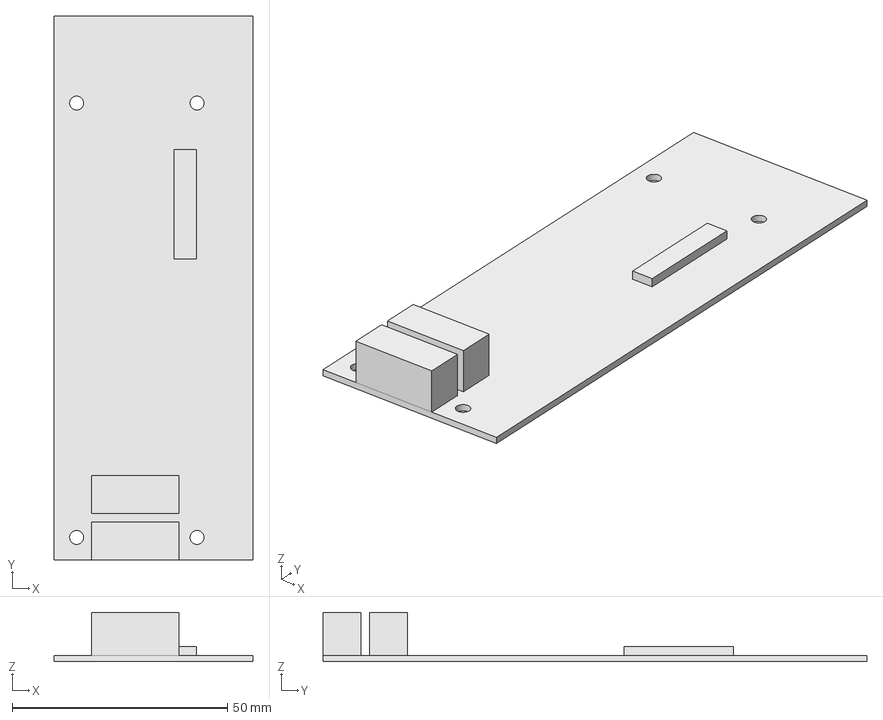
[picture p97: CAD file, 2019-07-19]
production_parts/assembly/LCD_assembly/lcd_board.fcstd
46.2 x 126.5 x 11.5 mm
