reprapperMC/kangaroopaw/production_parts/tool_head/hamilton_5ml_plunger_81520.fcstd

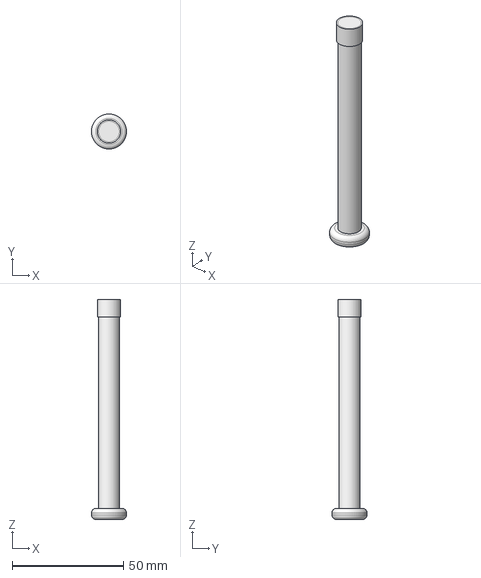
[picture p98: CAD file, 2019-05-06]
production_parts/tool_head/hamilton_5ml_plunger_81520.fcstd
15.8 x 15.8 x 99.0 mm
