reprapperMC/kangaroopaw/production_parts/tooling/syringe-pump_test-stand/assembly/left-side-mini.fcstd

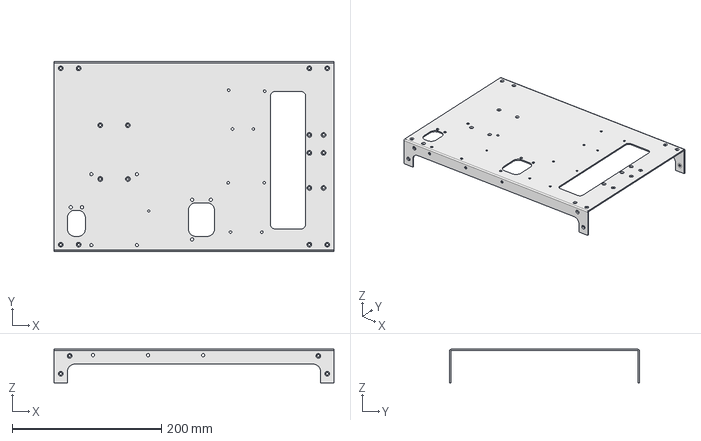
[picture p99: CAD file, 2019-09-04]
production_parts/tooling/syringe-pump_test-stand/assembly/left-side-mini.fcstd
375.0 x 254.0 x 45.0 mm
