reprapperMC/kangaroopaw/production_parts/tooling/syringe-pump_test-stand/top-right-corner.fcstd

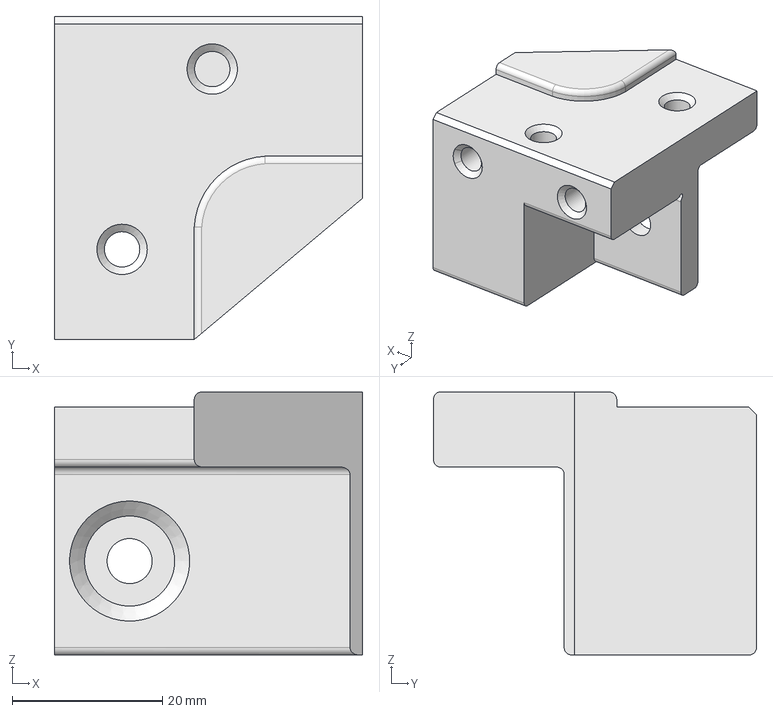
[picture p100: CAD file, 2019-09-04]
production_parts/tooling/syringe-pump_test-stand/top-right-corner.fcstd
41.0 x 43.0 x 35.0 mm
