reprapperMC/kangaroopaw/production_parts/assembly/assembly_parts/z_chain_end.stp

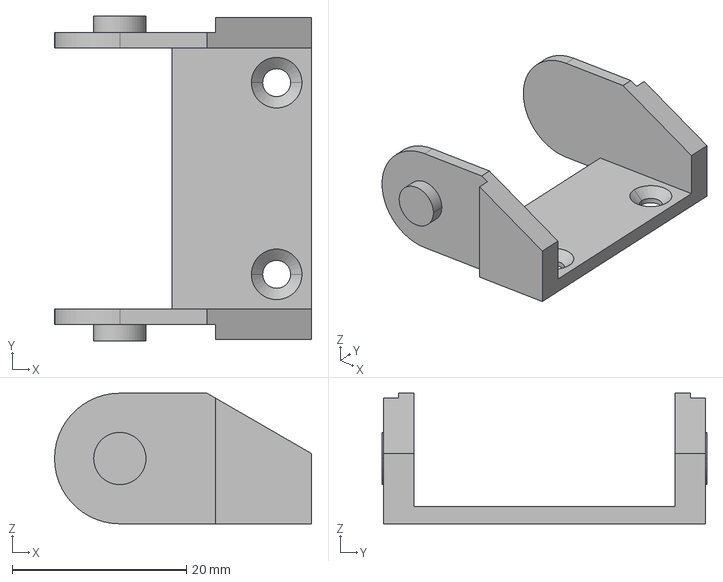
[picture p101: CAD file, 2019-07-19]
production_parts/assembly/assembly_parts/z_chain_end.stp
29.5 x 37.3 x 15.0 mm
