reprapperMC/kangaroopaw/production_parts/assembly/assembly_subs/z_axis_left.fcstd

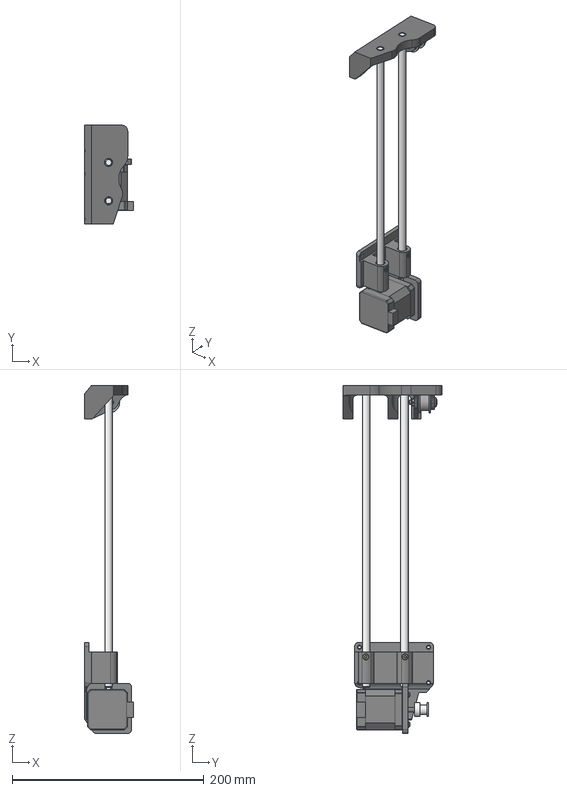
[picture p102: CAD file, 2019-07-19]
production_parts/assembly/assembly_subs/z_axis_left.fcstd
50.9 x 102.9 x 363.0 mm
z_lower_left_mini2_NG_01
_mmx315_rod_v1_0_step1_01
_mmx315_rod_v1_0_step1_02
z_upper_left_mini2_01
NEMA17_step1_01
pulley_01
idler_pulley_openbuilds_01
M3_insert_01
M3_insert_02
M3_insert_03
M3_insert_04
M3_insert_05
M3_insert_06
M3_insert_07
M3_insert_08
M3_insert_09
M3_insert_10
M3_insert_11
M3_insert_12
M3_washer_01
M3_washer_02
M3_washer_03
M3_washer_04
M3x12BHCS_01
M3x12BHCS_02
M3x12BHCS_03
M3x12BHCS_04
m3_setscrew_01
m3_setscrew_02
m5x25_pan_head_01
M5_washer_01
m5_nylock_nut_01
