reprapperMC/kangaroopaw/production_parts/assembly/inserts_assemblies/touchscreen_center_inserts.fcstd

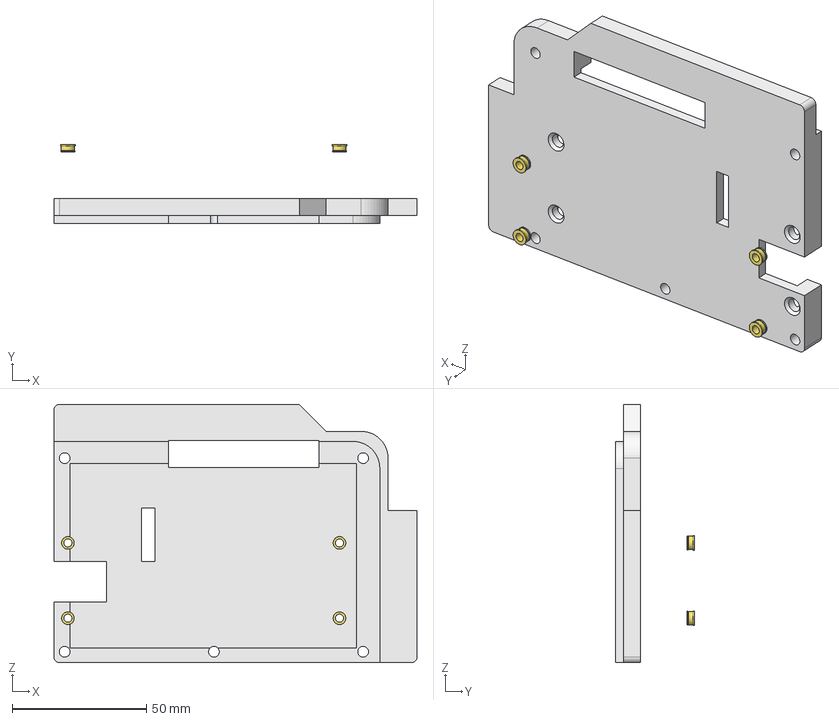
[picture p103: CAD file, 2019-07-19]
production_parts/assembly/inserts_assemblies/touchscreen_center_inserts.fcstd
135.0 x 29.3 x 96.0 mm
touchscreen_center_v1_1_01
M3_insert_01
M3_insert_02
M3_insert_03
M3_insert_04
