reprapperMC/kangaroopaw/production_parts/tool_head/machined_parts/PP-MP0281_carriage_revE.step

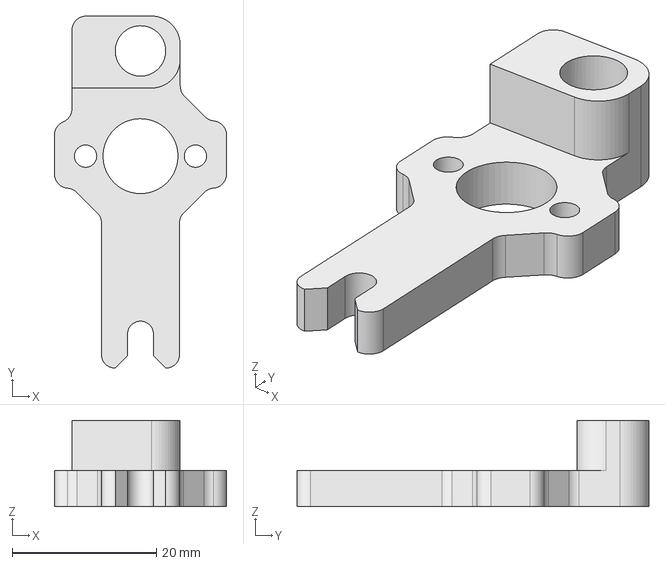
[picture p104: CAD file, 2019-08-15]
production_parts/tool_head/machined_parts/PP-MP0281_carriage_revE.step
23.9 x 48.8 x 12.0 mm
