reprapperMC/kangaroopaw/production_parts/tool_head/toolhead_assem.fcstd

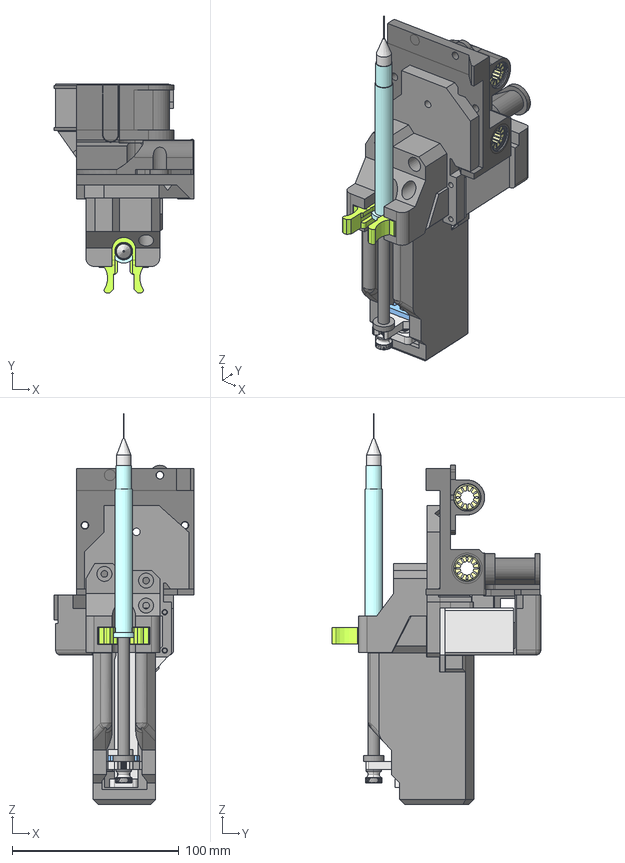
[picture p105: CAD file, 2019-04-11]
production_parts/tool_head/toolhead_assem.fcstd
83.9 x 125.2 x 234.7 mm
syringe_barrel_step1_01
syringe_plunger_step1_01
syringe_mount_01
leadnut_step1_01
KHK_US_SW0_5_R2_stp1_01
KHK_US_BG0_5_30R2_stp1_01
_mm_rod_01
nema_11_01
carriage_01
sleeve_bushing_01
_9607A120_18_8_STAINLESS_STEEL_KNURLED_HEAD_THUMB_SCREW_STEP1_01
_23_bearing_01
_23_bearing_02
limit_switch_01
limit_switch_02
Lower_bearing_holder_01
motor_flange_01
extruder_mount_01
Minii_x_carriage_V2_1_01
x_bearing_holder_v3_8_1_01
upper_bearing_01
rear_flange_mount_01
needle_01
Syringe_insert_mount_01
cover_01
leadscrew_assem_01
x_chain_end1_stp1_01
cable_cover_01
RJM_01_08_1_stp1_01
RJM_01_08_1_stp1_02
RJM_01_08_1_stp1_03
