reprapperMC/kangaroopaw/production_parts/assembly/assembly_parts/PS.fcstd

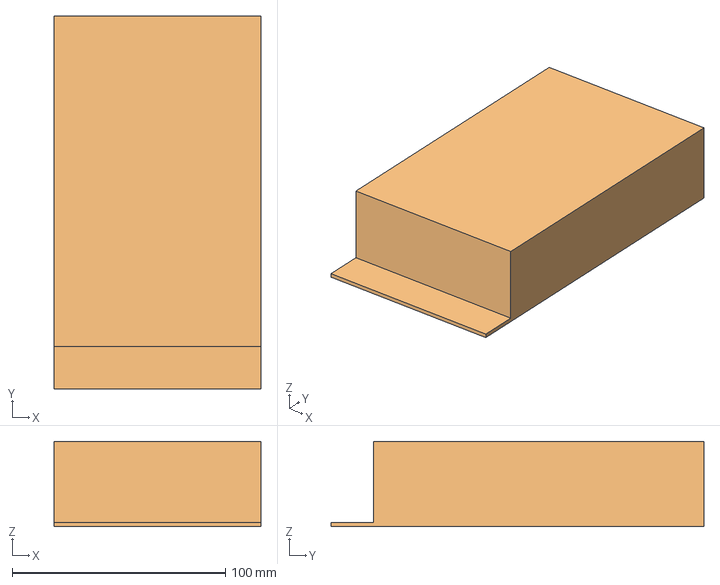
[picture p106: CAD file, 2019-07-19]
production_parts/assembly/assembly_parts/PS.fcstd
97.0 x 175.0 x 40.0 mm
