reprapperMC/kangaroopaw/production_parts/assembly/assembly_subs/x_carriage.fcstd

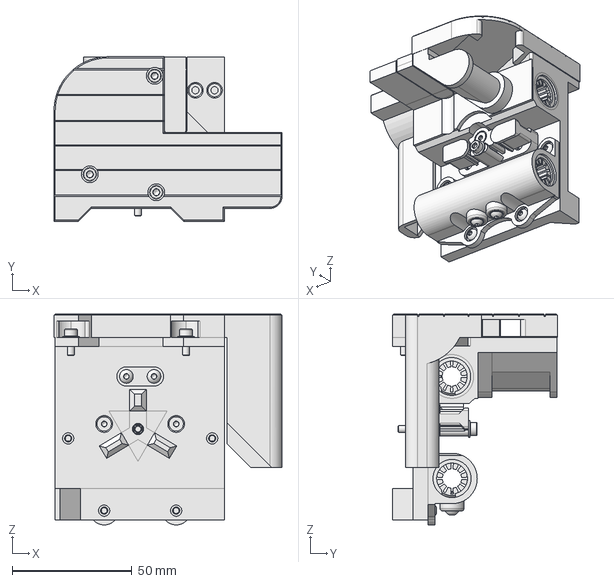
[picture p107: CAD file, 2019-07-19]
production_parts/assembly/assembly_subs/x_carriage.fcstd
95.0 x 68.6 x 87.9 mm
