reprapperMC/kangaroopaw/production_parts/assembly/inserts_assemblies/touchscreen_case_inserts.fcstd

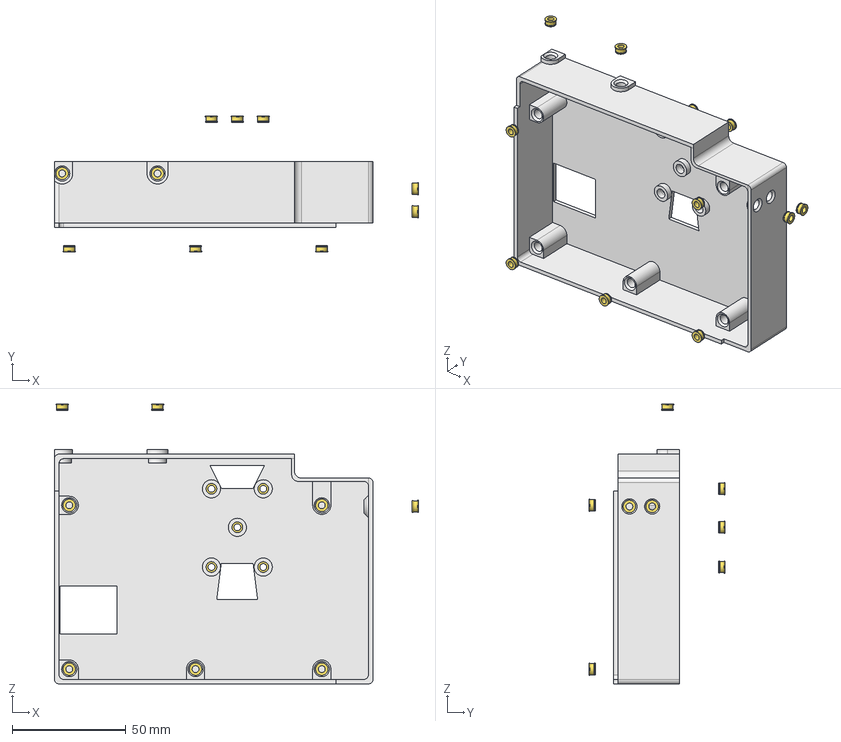
[picture p108: CAD file, 2019-07-19]
production_parts/assembly/inserts_assemblies/touchscreen_case_inserts.fcstd
160.0 x 59.8 x 123.0 mm
touchscreen_case_step1_01
M3_insert_01
M3_insert_02
M3_insert_03
M3_insert_04
M3_insert_05
M3_insert_06
M3_insert_07
M3_insert_08
M3_insert_09
M3_insert_10
M3_insert_11
M3_insert_12
M3_insert_13
M3_insert_14
