reprapperMC/kangaroopaw/production_parts/tool_head/leadnut.step

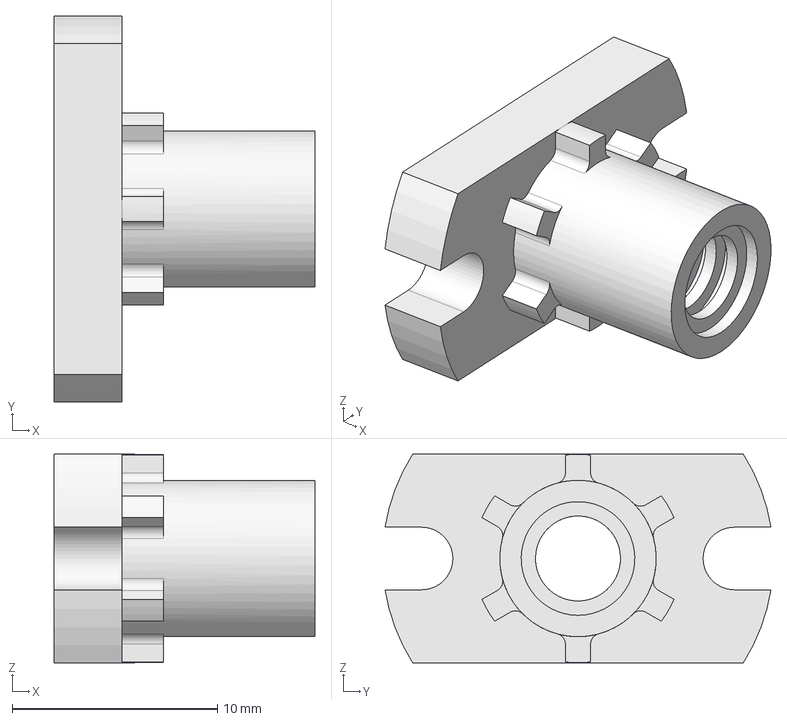
[picture p109: CAD file, 2019-04-02]
production_parts/tool_head/leadnut.step
12.7 x 18.8 x 10.2 mm
