reprapperMC/kangaroopaw/production_parts/tool_head/machined_parts/PP-MP0278_lower_bearing_holder.step

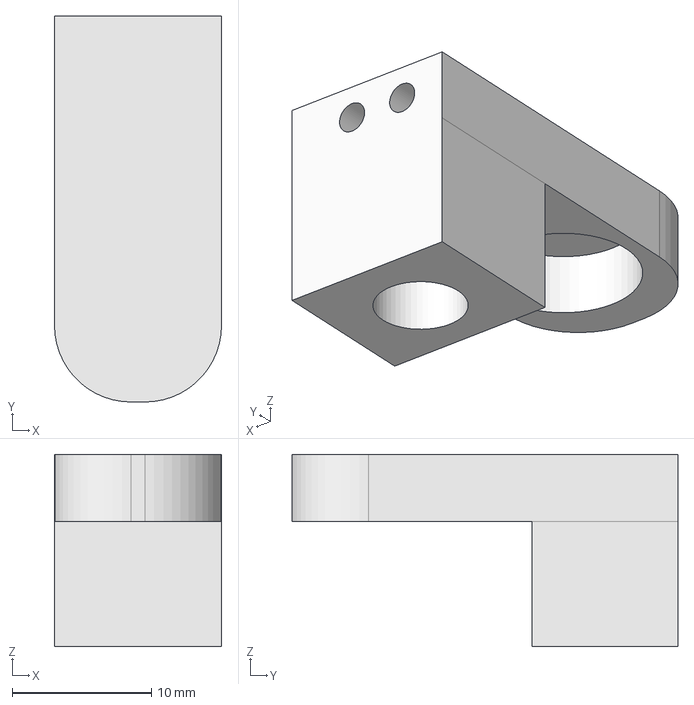
[picture p110: CAD file, 2019-06-18]
production_parts/tool_head/machined_parts/PP-MP0278_lower_bearing_holder.step
12.0 x 27.7 x 13.8 mm
