reprapperMC/kangaroopaw/production_parts/tooling/syringe-pump_test-stand/touchscreen_center_for-stand.fcstd

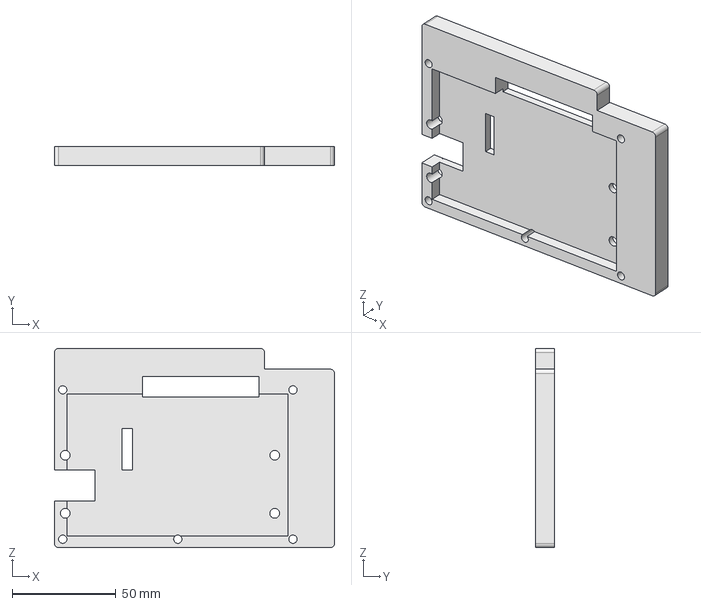
[picture p111: CAD file, 2019-09-04]
production_parts/tooling/syringe-pump_test-stand/touchscreen_center_for-stand.fcstd
135.0 x 9.25 x 96.0 mm
