reprapperMC/kangaroopaw/production_parts/tooling/syringe_collar_go_no_go_gauges/syringe_collar_mount_go_no_go_path1.fcstd

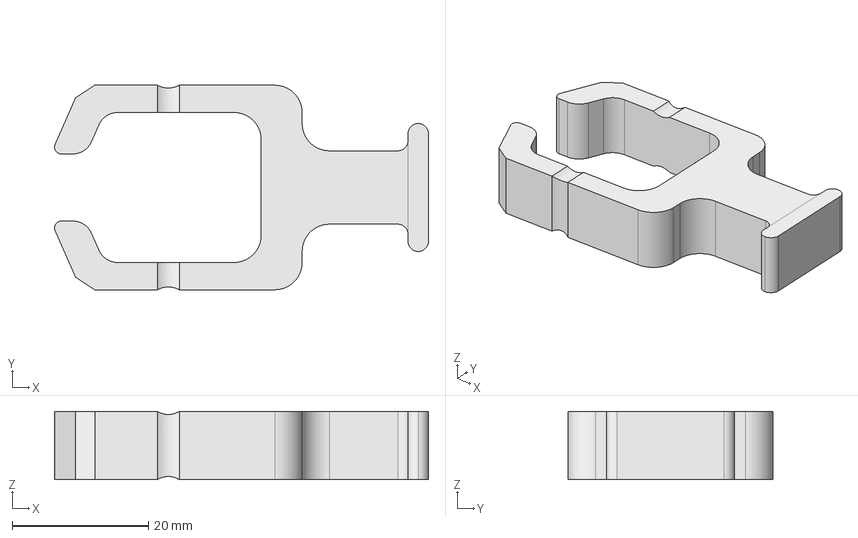
[picture p112: CAD file, 2019-09-30]
production_parts/tooling/syringe_collar_go_no_go_gauges/syringe_collar_mount_go_no_go_path1.fcstd
54.8 x 30.0 x 10.0 mm
