reprapperMC/kangaroopaw/production_parts/assembly/assembly_parts/x_chain_link.stp

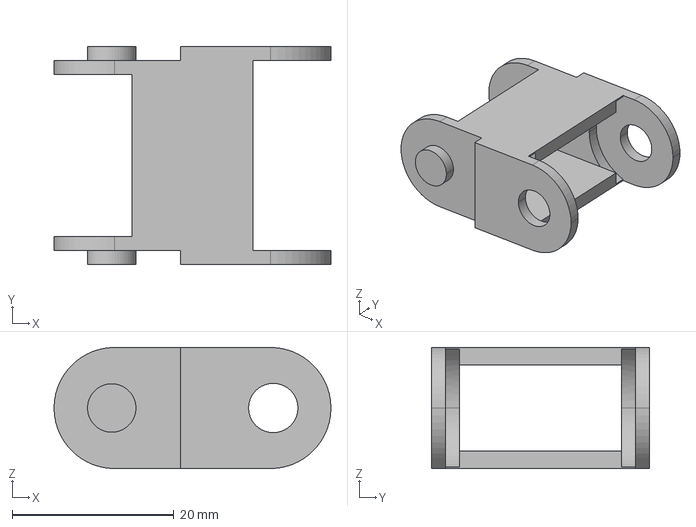
[picture p113: CAD file, 2019-07-19]
production_parts/assembly/assembly_parts/x_chain_link.stp
34.3 x 27.0 x 15.0 mm
