reprapperMC/kangaroopaw/production_parts/assembly/inserts_assemblies/syringe_pump_mount_inserts.fcstd

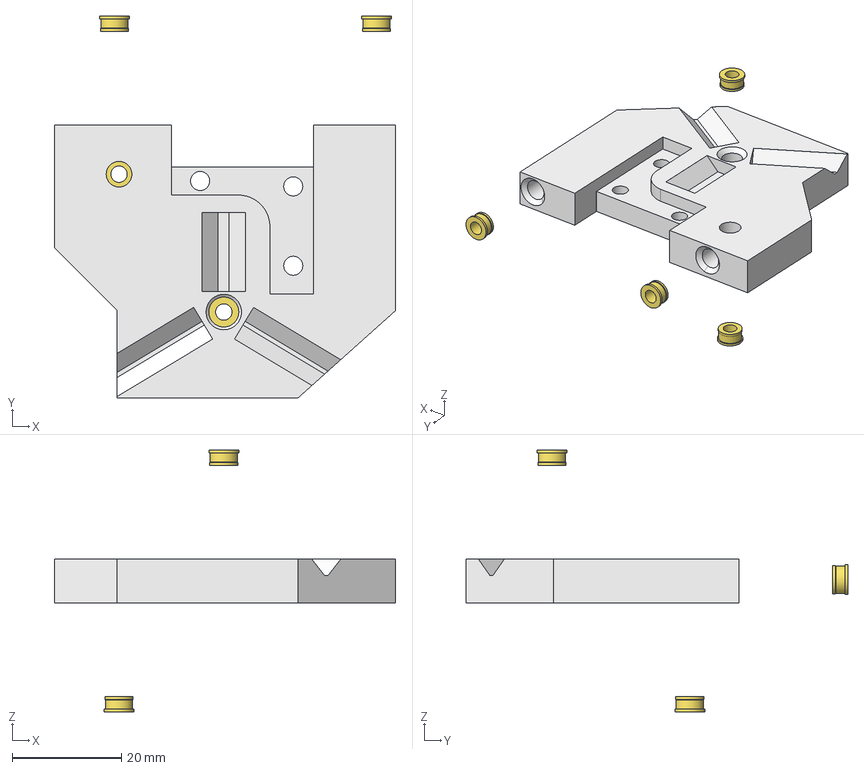
[picture p114: CAD file, 2019-07-19]
production_parts/assembly/inserts_assemblies/syringe_pump_mount_inserts.fcstd
62.5 x 70.0 x 48.0 mm
extruder_mount_v2_01
M3_insert_01
M3_insert_02
M3_insert_03
M3_insert_04
