reprapperMC/kangaroopaw/production_parts/tool_head/machined_parts/path/upper_bearing_v2_path3.fcstd

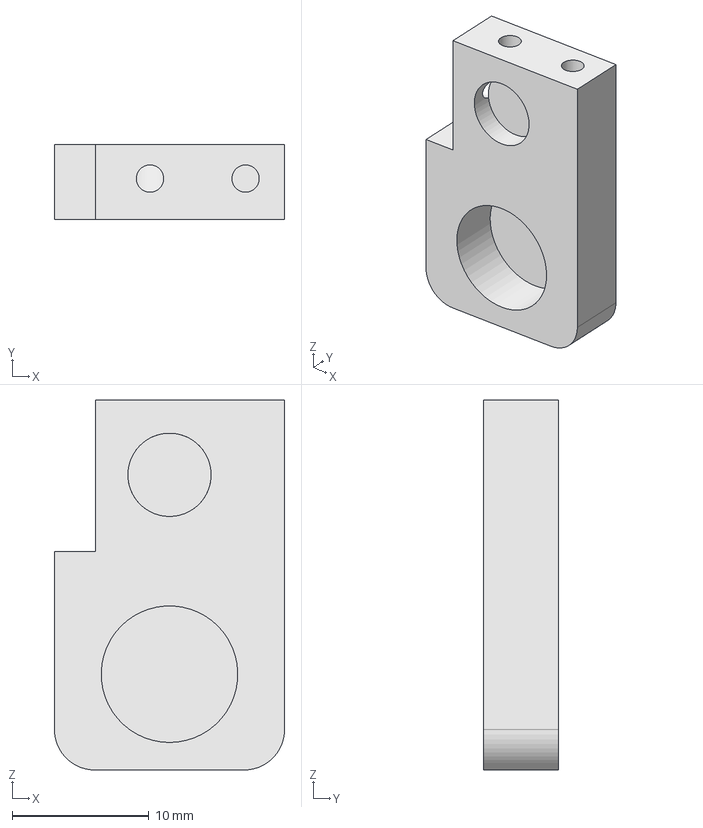
[picture p115: CAD file, 2019-05-06]
production_parts/tool_head/machined_parts/path/upper_bearing_v2_path3.fcstd
16.9 x 5.50 x 27.1 mm
