reprapperMC/kangaroopaw/production_parts/tool_head/nema_11.fcstd

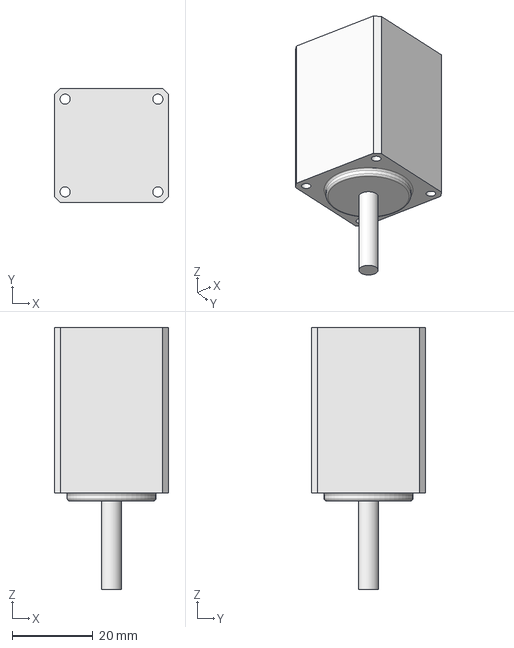
[picture p116: CAD file, 2019-04-02]
production_parts/tool_head/nema_11.fcstd
28.3 x 28.3 x 65.0 mm
