reprapperMC/kangaroopaw/production_parts/assembly/assembly_parts/625_bearing.fcstd

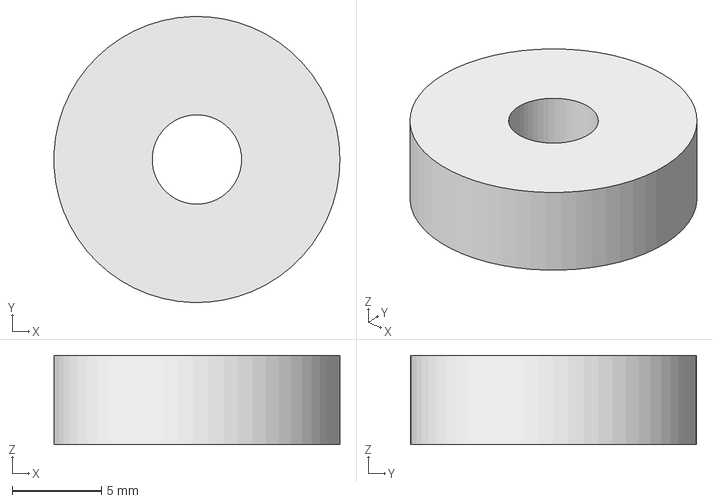
[picture p117: CAD file, 2019-07-19]
production_parts/assembly/assembly_parts/625_bearing.fcstd
16.0 x 16.0 x 5.00 mm
