reprapperMC/kangaroopaw/production_parts/assembly/assembly_subs/kpaw_y_axis.step

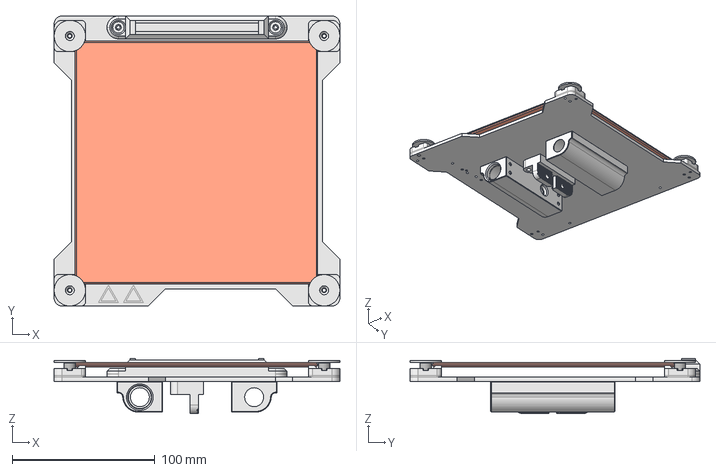
[picture p118: CAD file, 2019-07-19]
production_parts/assembly/assembly_subs/kpaw_y_axis.step
200.0 x 203.0 x 38.7 mm
