reprapperMC/kangaroopaw/production_parts/assembly/inserts_assemblies/z_upper_left_inserts.fcstd

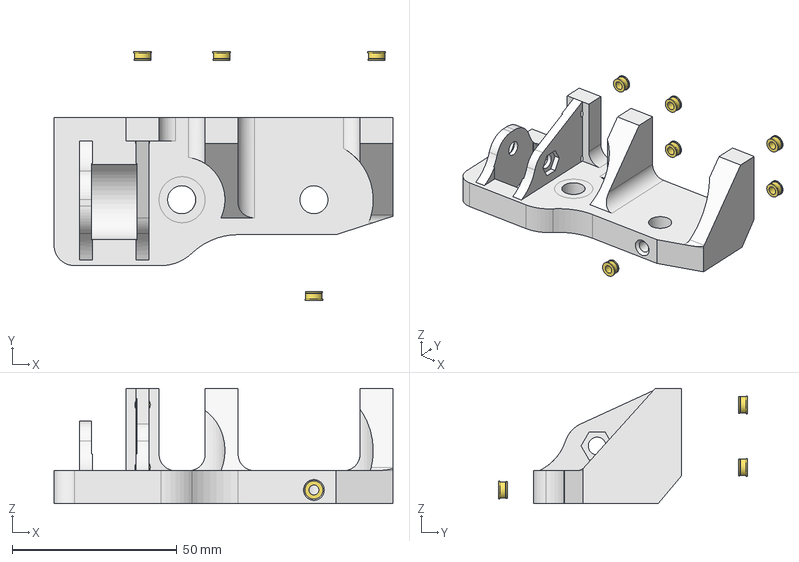
[picture p119: CAD file, 2019-07-19]
production_parts/assembly/inserts_assemblies/z_upper_left_inserts.fcstd
102.9 x 75.6 x 35.0 mm
Z_Upper_Left_Mini2_v1_4_01
M3_insert_01
M3_insert_02
M3_insert_03
M3_insert_04
M3_insert_05
M3_insert_06
M3_insert_07
