reprapperMC/kangaroopaw/production_parts/tool_head/machined_parts/HD-RD0077_90mm_guide_rod.fcstd

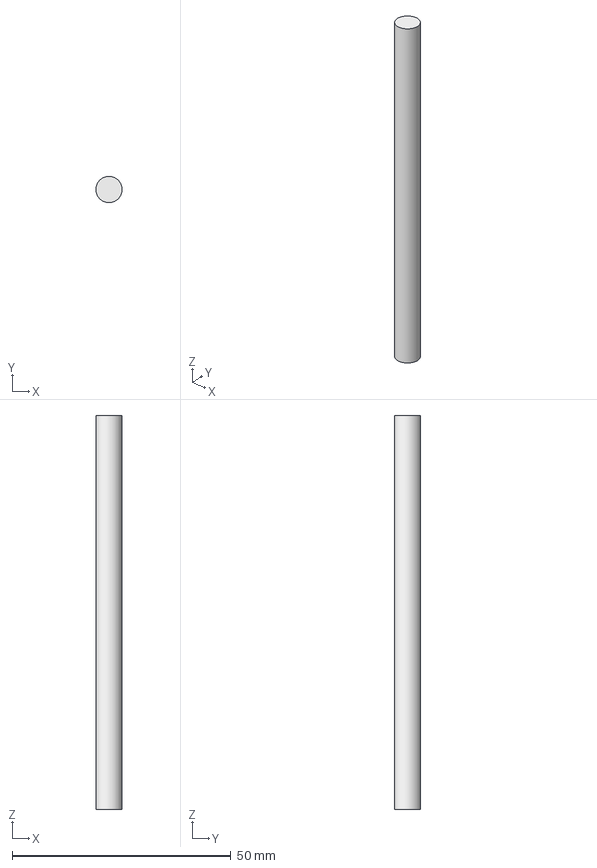
[picture p120: CAD file, 2019-05-06]
production_parts/tool_head/machined_parts/HD-RD0077_90mm_guide_rod.fcstd
5.99 x 6.00 x 90.0 mm
