reprapperMC/kangaroopaw/production_parts/tool_head/needle.fcstd

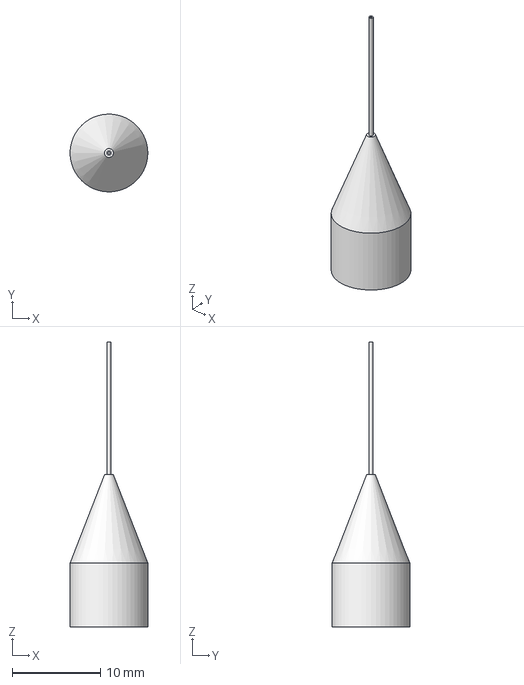
[picture p121: CAD file, 2019-04-02]
production_parts/tool_head/needle.fcstd
8.79 x 8.80 x 32.2 mm
