reprapperMC/kangaroopaw/production_parts/tooling/syringe-pump_test-stand/touchscreen_case_for-stand.fcstd

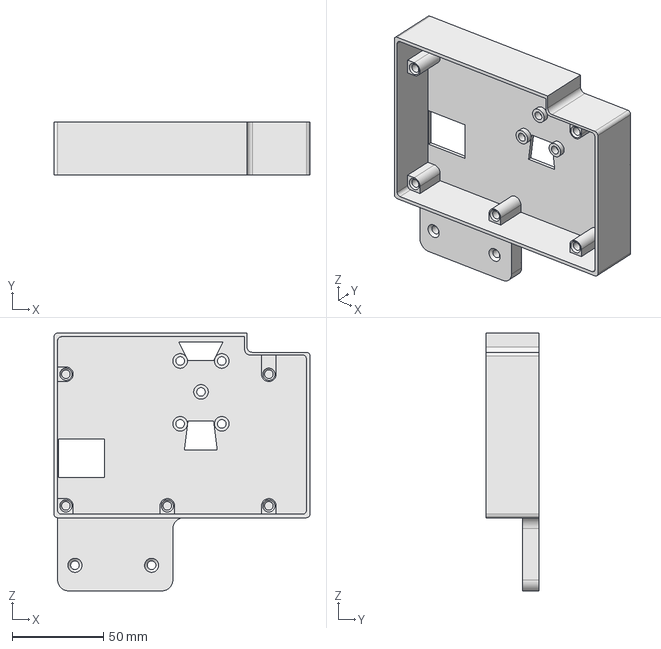
[picture p122: CAD file, 2019-09-04]
production_parts/tooling/syringe-pump_test-stand/touchscreen_case_for-stand.fcstd
140.0 x 29.0 x 141.0 mm
