reprapperMC/kangaroopaw/production_parts/assembly/assembly_parts/x_belt.fcstd

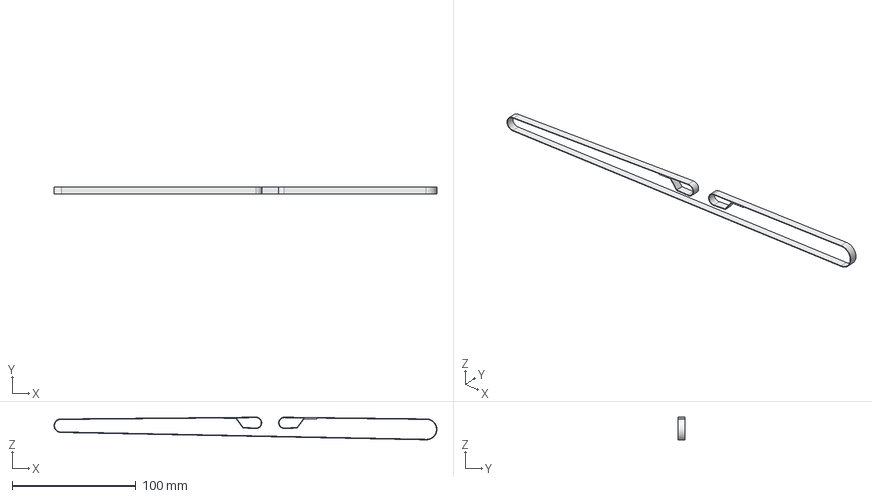
[picture p123: CAD file, 2019-07-19]
production_parts/assembly/assembly_parts/x_belt.fcstd
309.5 x 6.00 x 18.4 mm
