reprapperMC/kangaroopaw/production_parts/assembly/assembly_subs/y_chain_assem.fcstd

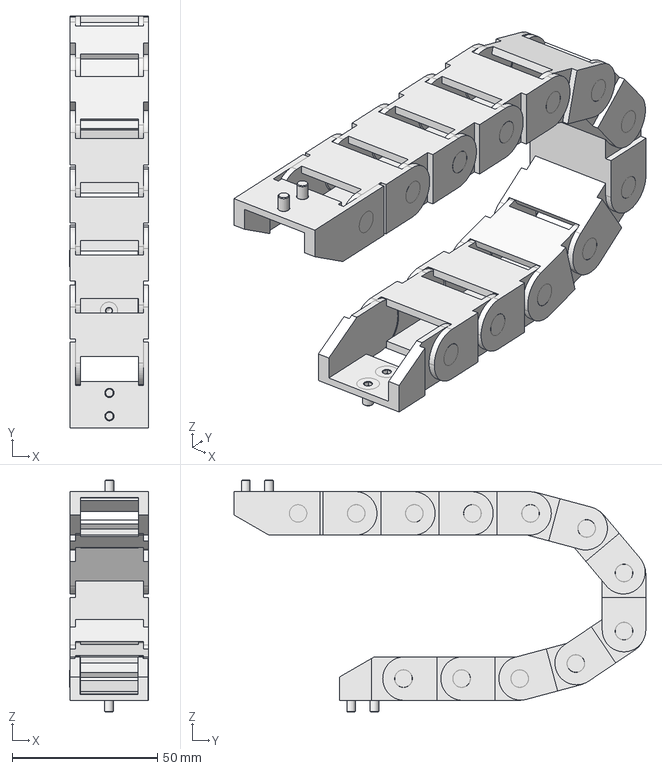
[picture p124: CAD file, 2019-07-19]
production_parts/assembly/assembly_subs/y_chain_assem.fcstd
27.3 x 141.7 x 79.9 mm
