reprapperMC/kangaroopaw/production_parts/assembly/inserts_assemblies/upper_strain_relief_inserts.fcstd

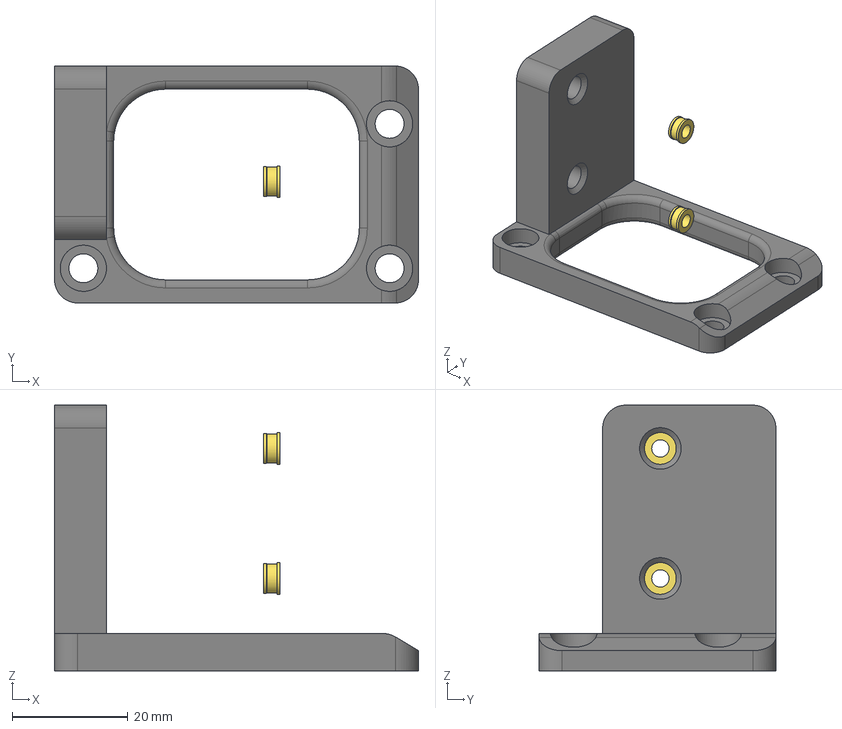
[picture p125: CAD file, 2019-07-19]
production_parts/assembly/inserts_assemblies/upper_strain_relief_inserts.fcstd
63.0 x 41.0 x 46.0 mm
strain_relief_upper_black_v3_0_01
M3_insert_01
M3_insert_02
