reprapperMC/kangaroopaw/(list of files, cad)

Other CAD files:
production_parts/printed_parts/z_lower_right_mini2/Z-Lower_Right_Mini2_v1.7.1.stl
production_parts/machined_parts/bed_mount_plate/bed-mount-plate-mini-white_PP-FP0171.step
production_parts/machined_parts/blank_dish_plate/PP-FP0185_blank_dish_plate.fcstd
production_parts/machined_parts/polycarb_LCD_cover/PP-FP0183_polycarb_LCD_cover.step
production_parts/machined_parts/touchscreen_bezel/PP-FP0174_touchscreen_bezel.step
production_parts/printed_parts/belt_tensioning_collar/belt_tensioning_collar_v1.2.fcstd
production_parts/tool_head/machined_parts/PP-MP0279_motor_mount.step
production_parts/tooling/syringe-pump_test-stand/assembly/electronics-case.fcstd
production_parts/machined_parts/blank_dish_plate/blank_dish_plate.step
production_parts/tool_head/machined_parts/path/motor_flange_v2_path1.fcstd
production_parts/tool_head/machined_parts/PP-MP0280_collar_mount_flange_revA.fcstd
production_parts/assembly/inserts_assemblies/syringe_pump_cover_inserts.fcstd
production_parts/tool_head/machined_parts/path/collar_mount_flange_path2.fcstd
production_parts/tool_head/machined_parts/PP-MP0280_collar_mount_flange.step
production_parts/tool_head/machined_parts/path/motor_flange_v2_path2.fcstd
production_parts/tooling/syringe-pump_test-stand/bottom-right-corner.fcstd
production_parts/tool_head/machined_parts/path/collar_mount_flange_path1.fcstd
production_parts/assembly/assembly_subs/z_axis_right.fcstd
production_parts/tool_head/machined_parts/PP-MP0277_upper_bearing_holder.step
production_parts/tooling/syringe-pump_test-stand/top-left-corner.fcstd
production_parts/tool_head/machined_parts/path/lower_bearing_holder_v2.step
production_parts/tooling/syringe_collar_go_no_go_gauges/syringe_collar_mount_go_no_go.step
production_parts/assembly/assembly_fasteners/M2X10SHCS.fcstd
production_parts/assembly/assembly_fasteners/M2X6SHCS.fcstd
production_parts/assembly/assembly_fasteners/M2_washer.fcstd
production_parts/assembly/assembly_fasteners/M2x6FHCS.fcstd
production_parts/assembly/assembly_fasteners/M2x8shcs.fcstd
production_parts/assembly/assembly_fasteners/M3_washer.fcstd
production_parts/assembly/assembly_fasteners/M3x10FHCS.fcstd
production_parts/assembly/assembly_fasteners/M3x10SHCS.fcstd
production_parts/assembly/assembly_fasteners/M3x12BHCS.fcstd
production_parts/assembly/assembly_fasteners/M3x12SHCS.fcstd
production_parts/assembly/assembly_fasteners/M3x6SHCS.fcstd
production_parts/assembly/assembly_fasteners/M3x8BHCS.fcstd
production_parts/assembly/assembly_fasteners/M3x8FHCS.fcstd
production_parts/assembly/assembly_fasteners/M5_shoulder_bolt.fcstd
production_parts/assembly/assembly_fasteners/M5_washer.fcstd
production_parts/assembly/assembly_fasteners/M8x40FHCS.fcstd
production_parts/assembly/assembly_fasteners/m2.5x14SHCS.fcstd
production_parts/assembly/assembly_fasteners/m3_lock_washer.fcstd
production_parts/assembly/assembly_fasteners/m3_nut.fcstd
production_parts/assembly/assembly_fasteners/m3_nylock_nut.fcstd
production_parts/assembly/assembly_fasteners/m3_setscrew.fcstd
production_parts/assembly/assembly_fasteners/m3x16BHCS.fcstd
production_parts/assembly/assembly_fasteners/m3x16FHCS.fcstd
production_parts/assembly/assembly_fasteners/m3x20BHCS.fcstd
production_parts/assembly/assembly_fasteners/m3x20FHCS.fcstd
production_parts/assembly/assembly_fasteners/m3x25FHCS.fcstd
production_parts/assembly/assembly_fasteners/m3x30BHCS.fcstd
production_parts/assembly/assembly_fasteners/m3x30SHCS.fcstd
production_parts/assembly/assembly_fasteners/m3x35BHCS.fcstd
production_parts/assembly/assembly_fasteners/m3x35SHCS.fcstd
production_parts/assembly/assembly_fasteners/m3x6BHCS.fcstd
production_parts/assembly/assembly_fasteners/m3x6FHCS.fcstd
production_parts/assembly/assembly_fasteners/m3x8SHCS.fcstd
production_parts/assembly/assembly_fasteners/m5_nut.fcstd
production_parts/assembly/assembly_fasteners/m5_nylock_nut.fcstd
production_parts/assembly/assembly_fasteners/m5x14shcs.fcstd
production_parts/assembly/assembly_fasteners/m5x20shcs.fcstd
production_parts/assembly/assembly_fasteners/m5x25_pan_head.fcstd
production_parts/assembly/assembly_fasteners/m5x40FHCS.fcstd
production_parts/assembly/assembly_parts/40mm_fan.fcstd
production_parts/assembly/assembly_parts/40mm_fan.step
production_parts/assembly/assembly_parts/50mm_blower.fcstd
production_parts/assembly/assembly_parts/608_bearing.fcstd
production_parts/assembly/assembly_parts/608_bearing.step
production_parts/assembly/assembly_parts/Idler_spacers.fcstd
production_parts/assembly/assembly_parts/M2_insert.fcstd
production_parts/assembly/assembly_parts/M3_insert.fcstd
production_parts/assembly/assembly_parts/NEMA17.step
production_parts/assembly/assembly_parts/NEMA17_half_size.fcstd
production_parts/assembly/assembly_parts/RJM_01_08_1.stp
production_parts/assembly/assembly_parts/idler_pulley_openbuilds.fcstd
production_parts/assembly/assembly_parts/limit_switch.fcstd
production_parts/assembly/assembly_parts/m8_nut.step
production_parts/assembly/assembly_parts/m8_washer.step
production_parts/assembly/assembly_parts/power_switch.fcstd
production_parts/assembly/assembly_parts/pulley.fcstd
production_parts/assembly/assembly_parts/x_chain_end1.stp
production_parts/assembly/assembly_parts/x_chain_end2.stp
production_parts/assembly/assembly_parts/z_belt_l.fcstd
production_parts/assembly/assembly_parts/z_belt_r.fcstd
production_parts/assembly/assembly_parts/z_brake_board.fcstd
production_parts/assembly/assembly_parts/z_chain_end2.stp
production_parts/assembly/assembly_parts/z_chain_link.stp
production_parts/assembly/assembly_subs/kpaw_y_axis.fcstd
production_parts/assembly/assembly_subs/kpaw_y_axis_guide.fcstd
production_parts/assembly/assembly_subs/z_chain_assem.fcstd
production_parts/assembly/inserts_assemblies/Y_single_bearing_holder_inserts.fcstd
production_parts/assembly/inserts_assemblies/double_bearing_holder_inserts_nonswitch_side.fcstd
production_parts/assembly/inserts_assemblies/double_bearing_holder_inserts_switch_side.fcstd
production_parts/assembly/inserts_assemblies/handle_bar_inserts.fcstd
production_parts/assembly/inserts_assemblies/x_carriage_inserts.fcstd
production_parts/assembly/inserts_assemblies/x_end_idler_inserts.fcstd
production_parts/assembly/inserts_assemblies/x_end_motor_inserts.fcstd
production_parts/assembly/inserts_assemblies/y_axis_rod_mount_inserts.fcstd
production_parts/assembly/inserts_assemblies/y_idler_inserts.fcstd
production_parts/assembly/inserts_assemblies/z_brake_mount_inserts.fcstd
production_parts/assembly/inserts_assemblies/z_lower_left_inserts.fcstd
production_parts/assembly/inserts_assemblies/z_lower_right_inserts.fcstd
production_parts/assembly/inserts_assemblies/z_upper_right_inserts.fcstd
production_parts/machined_parts/35mmx6_dish_plate/35mmx6_dish_plate.fcstd
production_parts/machined_parts/55mmx4_dish_plate/55mmx4_dish_plate.fcstd
production_parts/machined_parts/bed_standoff/bed_standoff.fcstd
production_parts/machined_parts/heatsink_einsy/heatsink_einsy_PP-MP0210.fcstd
production_parts/machined_parts/polycarb_LCD_cover/PP-FP0183_polycarb_LCD_cover.dxf
production_parts/machined_parts/right_side/right-side-mini-white_PP-FP0169.fcstd
production_parts/machined_parts/smooth_rod_mini/8mmx315_rod_v1.0_revA.fcstd
production_parts/machined_parts/top_plate_mini/top-plate-mini-white_PP-FP0168.fcstd
production_parts/machined_parts/touchscreen_bezel/PP-FP0174_touchscreen_bezel.dxf
production_parts/printed_parts/Heatsink_frame/einsy_heatsink_frame.stl
production_parts/printed_parts/adjustable_belt_tensioner/adjustable-belt-tensioner_v2.3.stl
production_parts/printed_parts/bed_clip/bed_clip_v3.fcstd
production_parts/printed_parts/bed_clip/bed_clip_v3.stl
production_parts/printed_parts/bed_corner/bed_corner_v2.2.4.stl
production_parts/printed_parts/bump_stop/bump_stop.stl
production_parts/printed_parts/double-bearing-holder/double-bearing-holder_black_v1.8.2.stl
production_parts/printed_parts/handle/handle-bar_black_v2.7.fcstd
production_parts/printed_parts/handle/handle-bar_black_v2.7.stl
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
