reprapperMC/kangaroopaw/production_parts/electronics/chassis_assembly/AS-CB0074_Mini_PS_to_EinsyRetro_Red_Wire.pdf

TITLE

FILE NAME | SHEET | REV.

# Mini PS to EinsyRetro Red Wire

Copyright © 2018 Aleph Objects, Inc.
Permission is granted to copy, distribute and/or modify this document under the terms of the Creative Commons Attribution 4.0 International Public License (CC BY-SA 4.0).

4

### 1 IR

[EL-WR0106] – 16awg RED Wire

## (Strip 7mm)

## [EL-MS0497]

### Conn spade term 16-22AWG

Length = 200mm | (Strip 7mm)

## [EL-MS0211]

| TE- REEL / RING TONGUE CONN 16-22 AWG #10 PIDG

# Hibiscus

DRAWN BY DRAWN BY SAW | DATE 02/09/2018
CHECKED BY | DATE
AS-CB0074 | AS-CB0074_Mini_PS_to_EinsyRetro_Red_
| Wire.odg
