reprapperMC/kangaroopaw/production_parts/electronics/chassis_assembly/AS-CB0075_earth_gnd_extension_revA.pdf

DRAWN BY
SAW | 03/02/2018
TITLE
FILE NAME | SHEET | REV.

# Earth GND Extension

Copyright © 2015, 2016 Aleph Objects, Inc.
Permission is granted to copy, distribute and/or modify this document under the terms of the Creative Commons Attribution 4.0 International Public License (CC BY-SA 4.0).

# Hibiscus

12

4

14

13

## Length = 100mm

DATE

CHECKED BY | DATE

DRAWN BY

A

Strip 5mm | Strip 4mm
AS-CB0075 | AS-CB0075_earth_gnd_extension_revA.odg | 1

### 2x [EL-MS0141]

Term Ring Non Ins 26-22AWG #4 | 2x [EL-MS0205]
| Male Molex Pin
Strip 5mm | Strip 4mm

### 1x [PP-MP0059] Male 2pin Housing

## 2x [EL-WR0119] – 24awg Green Wire

Rev | Date | Changes | Change By
A | 6/11/19 | Update rev letter in file name and update layout for readability | KJ
