reprapperMC/kangaroopaw/production_parts/electronics/chassis_assembly/AS-CB0076_Mini_SW_to_PS_Black_Wire_Extension_Harness.pdf

TITLE

FILE NAME | SHEET | REV.

## Mini SW to PS - Black Wire Extension

Copyright © 2015, 2016 Aleph Objects, Inc.
Permission is granted to copy, distribute and/or modify this document under the terms of the Creative Commons Attribution 4.0 International Public License (CC BY-SA 4.0).

# Hibiscus

DRAWN BY DRAWN BY SAW | DATE 03/02/2018
CHECKED BY | DATE

## Cut Length 260mm +/- 2mm

## 1x [EL-MS0143]

## Conn Fast Receptacle 14-16 AWG .250

IR

Strip 7mm | Strip 7mm

AS-CB0076_Mini_SW_to_PS_
Black_Wire_Extension_Harness.odg

1

## [EL-WR0121]

## 16awg Black Wire

## 1x [EL-MS0211]

## RING TONGUE CONN 16-22 AWG #10 PIDG

# AS-CB0076
