reprapperMC/kangaroopaw/production_parts/electronics/chassis_assembly/AS-CB0077_Mini_SW_to_PS_White_Wire_Extension_Harness.pdf

TITLE

FILE NAME | SHEET | REV.

## Mini SW to PS White Wire Extension

Copyright © 2015, 2016 Aleph Objects, Inc.
Permission is granted to copy, distribute and/or modify this document under the terms of the Creative Commons Attribution 4.0 International Public License (CC BY-SA 4.0).

# Hibiscus

DRAWN BY DRAWN BY SAW | DATE 03/02/2018
CHECKED BY | DATE

IR AS-CB0077_Mini_SW_to_PS_ White_Wire_Extension_Harness.odg

1

## Cut Length 260mm

## [EL-WR0123]

16awg White Wire Strip 7mm | Strip 7mm

# AS-CB0077

## 1x [EL-MS0143]

## Conn Fast Receptacle 14-16 AWG .250

## 1x [EL-MS0211]

## RING TONGUE CONN 16-22 AWG #10 PIDG
