reprapperMC/kangaroopaw/production_parts/electronics/chassis_assembly/AS-CB0079_Mini_Plug_to_Ground_Post_Extension.pdf

TITLE

FILE NAME | SHEET | REV.

# Mini Plug to Ground Post Extension

Copyright © 2015, 2016 Aleph Objects, Inc.
Permission is granted to copy, distribute and/or modify this document under the terms of the Creative Commons Attribution 4.0 International Public License (CC BY-SA 4.0).

# Hibiscus

DRAWN BY DRAWN BY SAW | DATE 03/02/2018
CHECKED BY | DATE

12

4

14

13

## Cut Length= 80mm +/-2mm

## 1x [EL-MS0143]

## Conn Fast Receptacle 14-16 AWG .250

IR

Strip 7mm | Strip 7mm

AS-CB0079_Mini_Plug_to_Ground_
Post_Extension.odg | 1

## [EL-WR0124]

## 16awg Green w/ yellow stripe

## 1x [EL-MS0246]

## Conn Ring 16-22 AWG #4 Red PIDG

# AS-CB0079
