reprapperMC/kangaroopaw/production_parts/electronics/chassis_assembly/AS-CB0080_Mini_PS_to_Ground_Post_Extension.pdf

TITLE

FILE NAME | SHEET | REV.

# PS to Ground Post Extension

Copyright © 2015, 2016 Aleph Objects, Inc.
Permission is granted to copy, distribute and/or modify this document under the terms of the Creative Commons Attribution 4.0 International Public License (CC BY-SA 4.0).

12

4

14

## 13 1x- [EL-MS0211]

## RING TONGUE CONN 16-22 AWG #10 PIDG

IR

Strip 7mm | Strip 7mm

AS-CB0080_Mini_PS_to_Ground_
Post_Extension.odg | 1

## 1x- [EL-MS0246]

## Conn Ring 16-22 AWG

Cut Length= 50mm +/- 2mm | #4 Red PIDG

# Hibiscus

DRAWN BY DRAWN BY SAW | DATE 03/02/2018
CHECKED BY | DATE

# AS-CB0080

## [EL-WR0124]

## 16awg Green w/ yellow stripe
