reprapperMC/kangaroopaw/production_parts/electronics/chassis_assembly/AS-CB0081_Mini_PS_to_EinsyRetro_Black_Wire.pdf

TITLE

FILE NAME | SHEET | REV.

# Mini PS to EinsyRetro Black Wire

Copyright © 2018 Aleph Objects, Inc.
Permission is granted to copy, distribute and/or modify this document under the terms of the Creative Commons Attribution 4.0 International Public License (CC BY-SA 4.0).

4

### 1 IR

(Strip 7mm) | Length = 200mm
| [EL-WR0121] – 16awg BLACK Wire

## (Strip 7mm)

## [EL-MS0211]

## TE- REEL / RING TONGUE CONN 16-22 AWG #10 PIDG

# Hibiscus

DRAWN BY DRAWN BY SAW | DATE 02/09/2018
CHECKED BY | DATE

## [EL-MS0497]

### Conn spade term 16-22AWG

AS-CB0081 | AS-CB0081_Mini_PS_to_EinsyRetro_Black_
| Wire.odg
