reprapperMC/kangaroopaw/production_parts/electronics/AS-CB0070_Brake_board_motor_jumper.pdf

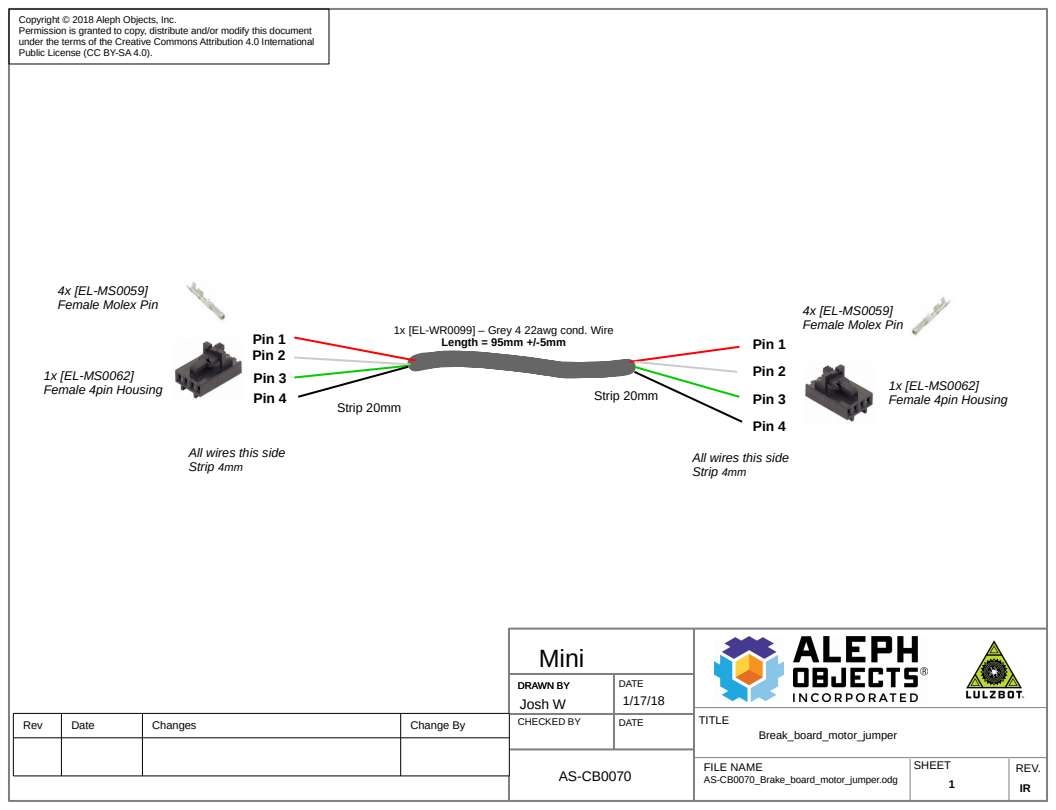
[picture p126: page 1]
TITLE; FILE NAME; SHEET; REV.; Female Molex Pin; 1x [EL-WR0099] – Grey 4 22awg cond. Wire Pin 1; Length = 95mm +/-5mm; Pin 3 Pin 4; Pin 2; Pin 1; Strip 20mm; Pin 3 Strip 20mm; Pin 4; 1x [EL-MS0062] Female 4pin Housing; Break_board_motor_jumper; AS-CB0070_Brake_board_motor_jumper.odg

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

Female Molex Pin

All wires this side
Strip 4mm

Mini

DRAWN BY DRAWN BY Josh W | DATE 1/17/18

Rev | Date | Changes | Change By | CHECKED BY | DATE
