reprapperMC/kangaroopaw/production_parts/electronics/AS-CB0072_mini2_yz_harness.pdf

# 12x [EL-MS0351] }Female JST Pin

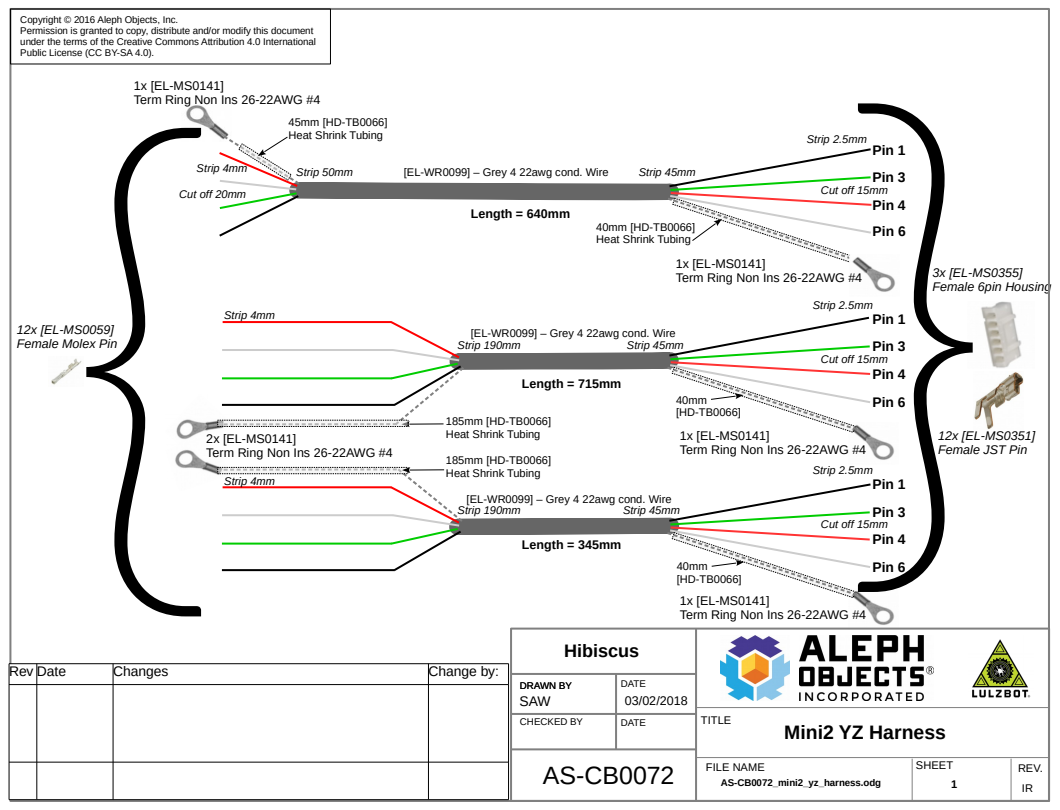
[picture p127: page 1]
3x [EL-MS0355] Female 6pin Housing; Pin 3; Pin 1; Pin 4; Pin 6; Strip 2.5mm; Pin 6 {; Length = 640mm; Length = 715mm; Length = 345mm; TITLE; FILE NAME; SHEET; REV.; Mini2 YZ Harness; IR AS-CB0072_mini2_yz_harness.odg; Strip 45mm; Strip 50mm; Strip 4mm; Cut off 20mm; Cut off 15mm; Rev Date; Changes; Change by:

Copyright © 2016 Aleph Objects, Inc.
Permission is granted to copy, distribute and/or modify this document
under the terms of the Creative Commons Attribution 4.0 International
Public License (CC BY-SA 4.0).

Term Ring Non Ins 26-22AWG #4

Heat Shrink Tubing

[EL-WR0099] – Grey 4 22awg cond. Wire

Female Molex Pin

Strip 190mm

Hibiscus

DRAWN BY DRAWN BY SAW | DATE 03/02/2018

CHECKED BY | DATE
