reprapperMC/kangaroopaw/production_parts/electronics/EL-HR0130_x_extruder_harnesses_revC.pdf

{

}

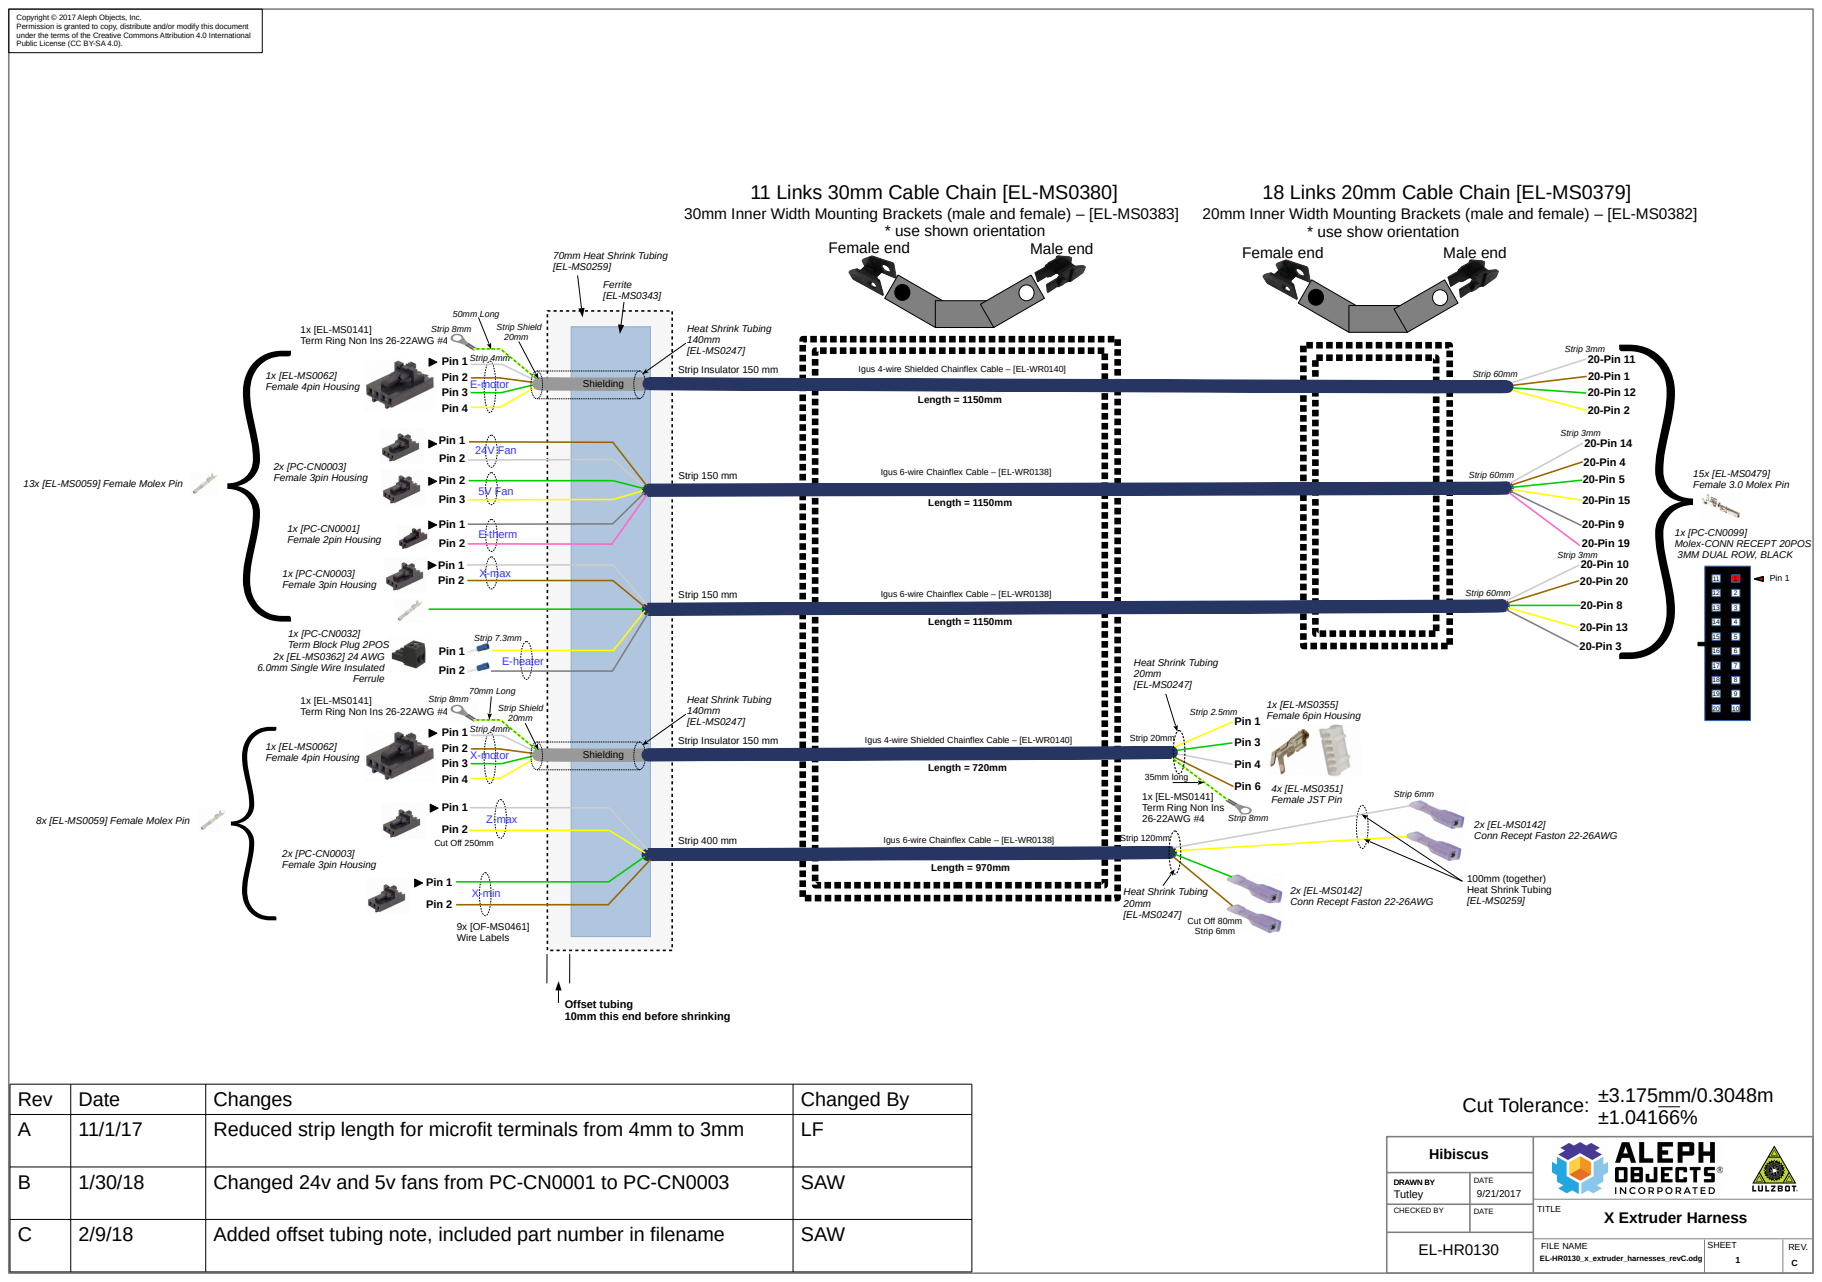
[picture p128: page 1]
Length = 1150mm; Strip 20mm; 20-Pin 14; 2x [PC-CN0003] Female 3pin Housing; Pin 1; Pin 2; Strip 2.5mm; Pin 3 `; Pin 4; Strip 4mm; 20-Pin 1; 20-Pin 11; 20-Pin 12 20-Pin 2; 1x [EL-MS0355] Female 6pin Housing; Pin 3; Pin 6; Ferrule; Female 4pin Housing {; 1x [PC-CN0001] Female 2pin Housing; Strip 3mm; Strip 60mm; Ferrite [EL-MS0343]; 1x [PC-CN0003] Female 3pin Housing; Length = 720mm; Length = 970mm; Strip 400 mm; Strip 120mm; TITLE; X Extruder Harness; Cut Tolerance:; 20-Pin 9; 20-Pin 19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

Copyright © 2017 Aleph Objects, Inc.
Permission is granted to copy, distribute and/or modify this document
under the terms of the Creative Commons Attribution 4.0 International
Public License (CC BY-SA 4.0).

11 Links 30mm Cable Chain [EL-MS0380]

18 Links 20mm Cable Chain [EL-MS0379]

30mm Inner Width Mounting Brackets (male and female) – [EL-MS0383]

20mm Inner Width Mounting Brackets (male and female) – [EL-MS0382]

* use shown orientation

* use show orientation

70mm Heat Shrink Tubing

Term Ring Non Ins 26-22AWG #4

Heat Shrink Tubing
Strip Insulator 150 mm

Igus 4-wire Shielded Chainflex Cable – [EL-WR0140]

Igus 6-wire Chainflex Cable – [EL-WR0138]

Female 3.0 Molex Pin

13x [EL-MS0059] Female Molex Pin

Molex-CONN RECEPT 20POS
3MM DUAL ROW, BLACK

Term Block Plug 2POS
2x [EL-MS0362] 24 AWG
6.0mm Single Wire Insulated

35mm long
Term Ring Non Ins
26-22AWG #4

Female JST Pin

8x [EL-MS0059] Female Molex Pin

Conn Recept Faston 22-26AWG

100mm (together)

Offset tubing
10mm this end before shrinking

Rev | Date | Changes | Changed By
A | 11/1/17 | Reduced strip length for microfit terminals from 4mm to 3mm | LF

Hibiscus

B | 1/30/18 | Changed 24v and 5v fans from PC-CN0001 to PC-CN0003 | SAW

DRAWN BY DRAWN BY Tutley | DATE 9/21/2017

CHECKED BY | DATE

C | 2/9/18 | Added offset tubing note, included part number in filename | SAW

FILE NAME EL-HR0130_x_extruder_harnesses_revC.odg | SHEET 1 | REV. C
