reprapperMC/kangaroopaw/production_parts/electronics/EL-HR0188_lcd_harness.pdf

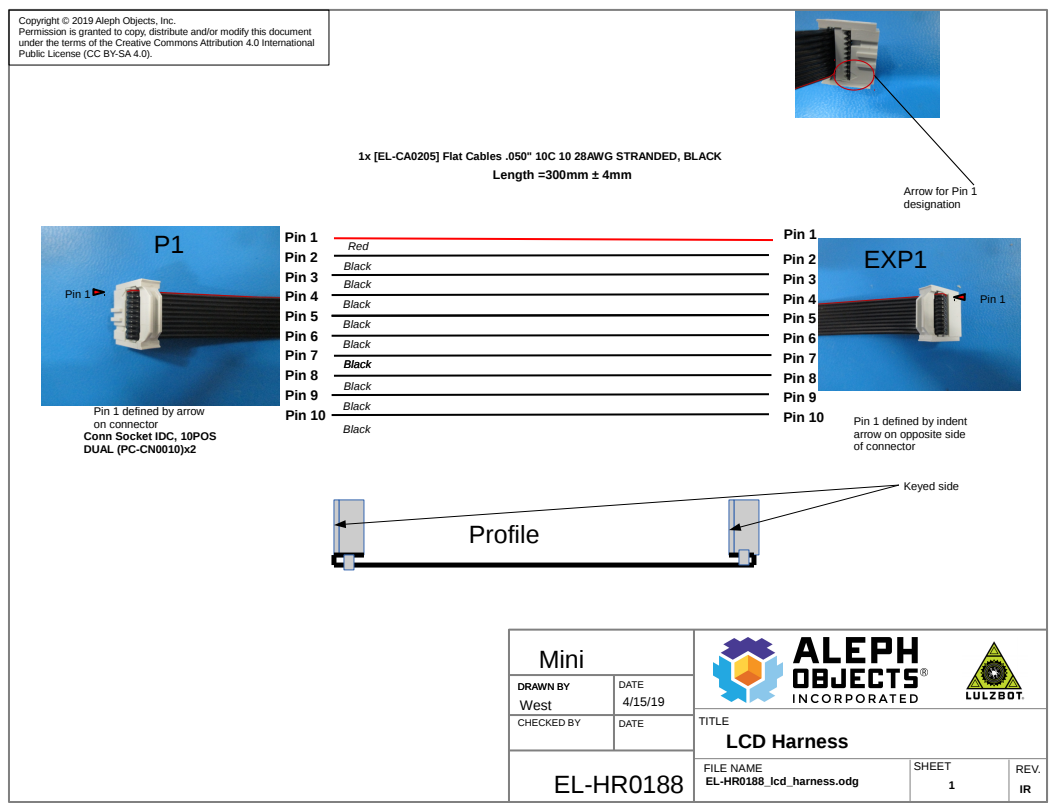
[picture p129: page 1]
TITLE; FILE NAME; SHEET; REV.; LCD Harness; Length =300mm ± 4mm; Pin 1 Pin 2 Pin 3 Pin 4 Pin 5 Pin 6 Pin 7 Pin 8 Pin 9 Pin 10; Black; Red; EXP1; Pin 1; Pin 2 Pin 3 Pin 4 Pin 5 Pin 6 Pin 7 Pin 8 Pin 9 Pin 10; on connector; Pin 1 defined by indent; Profile; Keyed side; Arrow for Pin 1 designation; EL-HR0188_lcd_harness.odg

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

1x [EL-CA0205] Flat Cables .050" 10C 10 28AWG STRANDED, BLACK

Pin 1 defined by arrow
Conn Socket IDC, 10POS
DUAL (PC-CN0010)x2

arrow on opposite side
of connector

Mini

DRAWN BY DRAWN BY West | DATE 4/15/19

CHECKED BY | DATE

AO part number | qty | UoM | Suppli er | supplier pn
EL-CA0205 | 350 | mm | TTI global | 3319/10-300
PC-CN0010 | 2 | pce | TTI global | 71600-010LF
