reprapperMC/kangaroopaw/production_parts/electronics/EL-HR0189_sd_harness.pdf

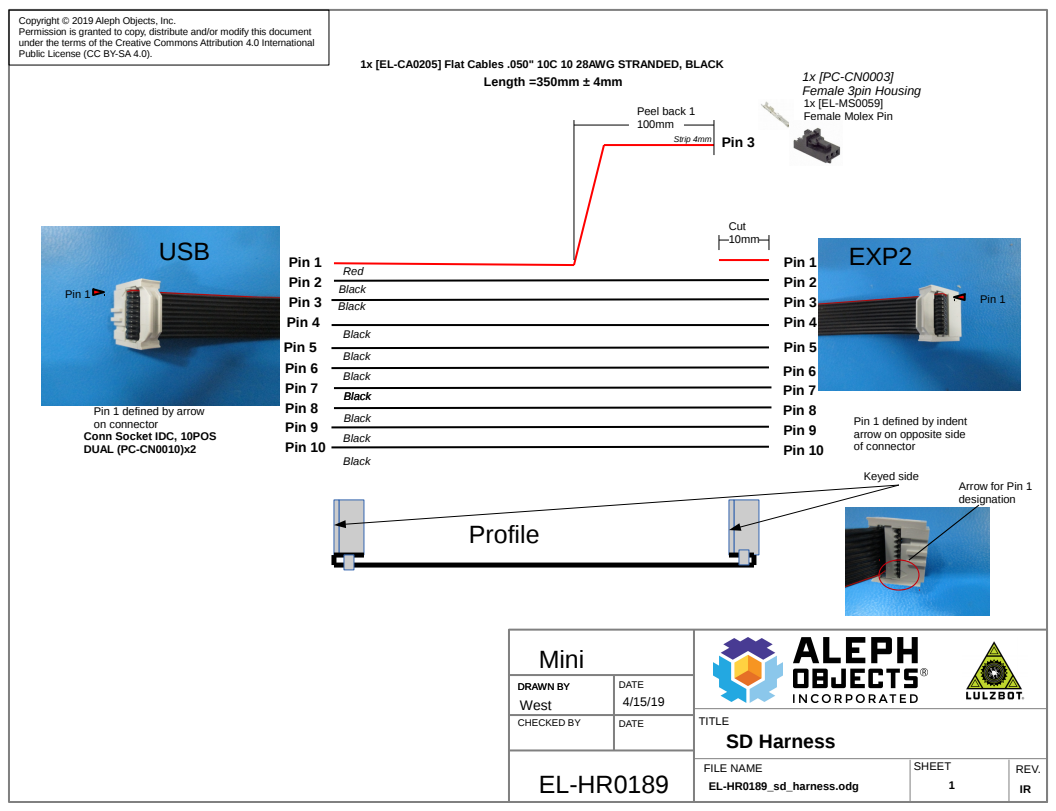
[picture p130: page 1]
TITLE; FILE NAME; SHEET; REV.; SD Harness; Length =350mm ± 4mm; Pin 1 Pin 2 Pin 3 Pin 4; Pin 5 Pin 6 Pin 7 Pin 8 Pin 9 Pin 10; Black; Red; EXP2; Pin 3; Pin 2 Pin 3 Pin 4; Pin 5; Pin 6 Pin 7 Pin 8 Pin 9 Pin 10; on connector; Pin 1 defined by indent; Pin 1; Profile; Keyed side; USB; Cut 10mm; Strip 4mm; 1x [PC-CN0003] Female 3pin Housing; EL-HR0189_sd_harness.odg

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

1x [EL-CA0205] Flat Cables .050" 10C 10 28AWG STRANDED, BLACK

Female Molex Pin Peel back 1

Pin 1 defined by arrow
Conn Socket IDC, 10POS
DUAL (PC-CN0010)x2

arrow on opposite side
of connector

Arrow for Pin 1
designation

Mini

DRAWN BY DRAWN BY West | DATE 4/15/19

CHECKED BY | DATE

AO part number | qty | UoM | Supplier | supplier pn
EL-CA0205 | 350 | mm | TTI global | 3319/10-300
PC-CN0003 | 1 | pce | TTI global | 50579403
EL-MS0059 | 1 | pce | TTI global | 16-02-0086
PC-CN0010 | 2 | pce | TTI global | 71600-010LF
