reprapperMC/kangaroopaw/production_parts/assembly/inserts_assemblies/x_belt_mount_inserts.pdf

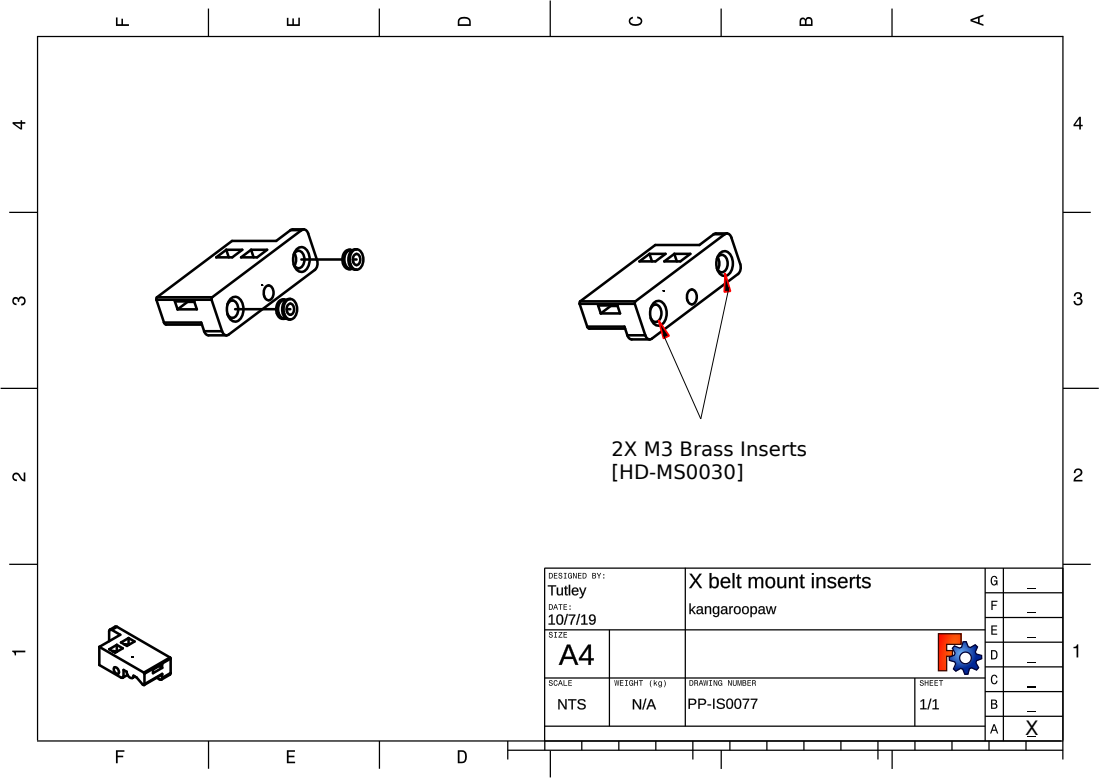
[picture p131: page 1]
2X M3 Brass Inserts [HD-MS0030]
