reprapperMC/kangaroopaw/production_parts/assembly/inserts_assemblies/y_belt_mount_inserts.pdf

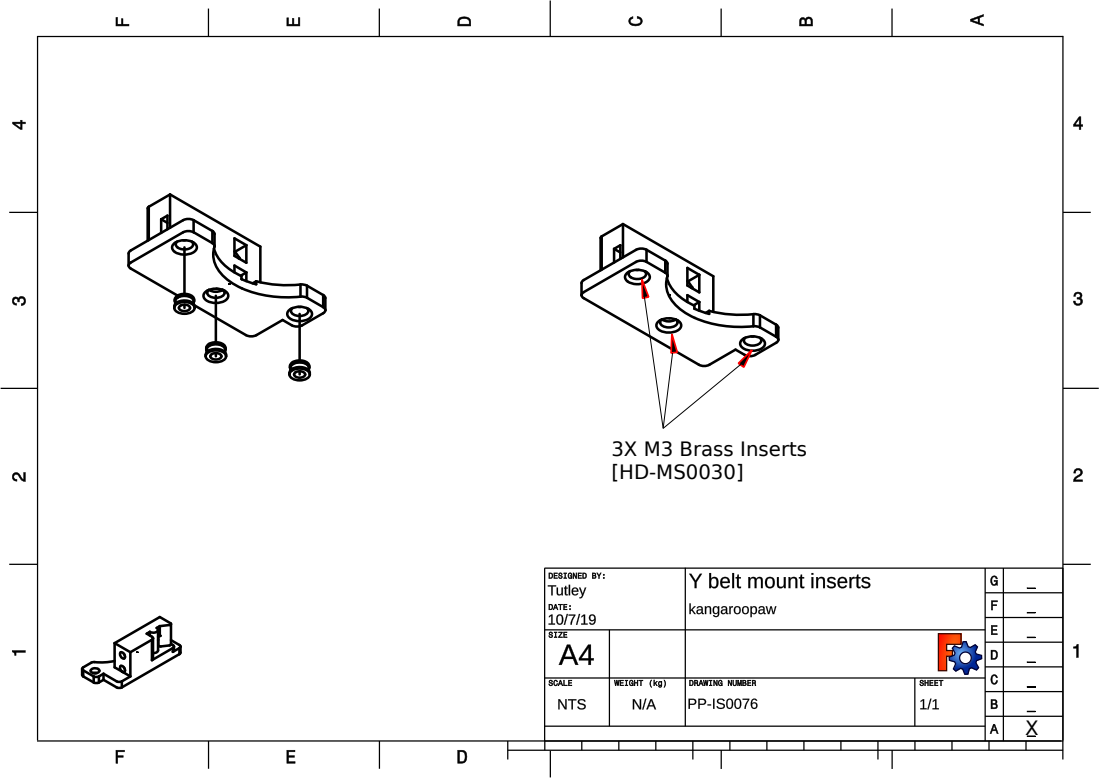
[picture p132: page 1]
3X M3 Brass Inserts [HD-MS0030]
