reprapperMC/kangaroopaw/production_parts/machined_parts/electronics_case/electronics-case-mini-white_PP-FP0167_revD.pdf

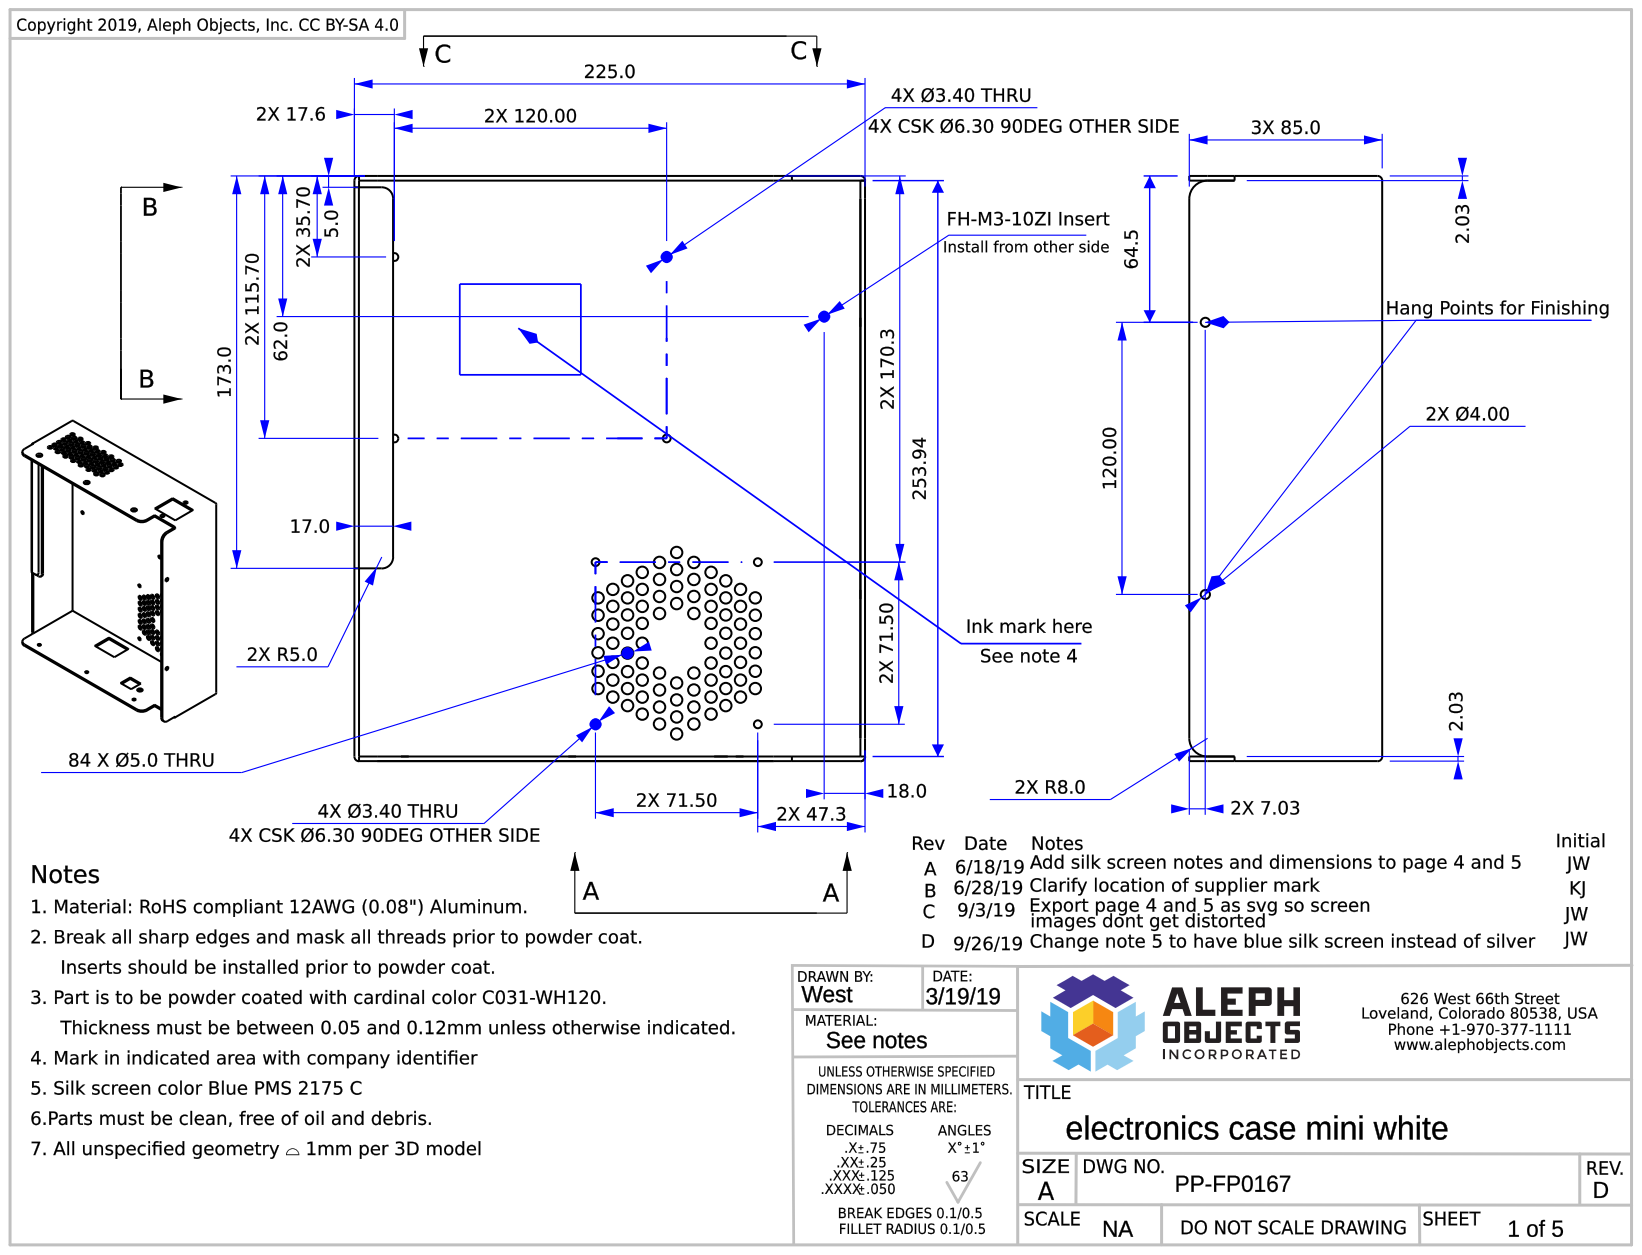
[picture p133: page 1]

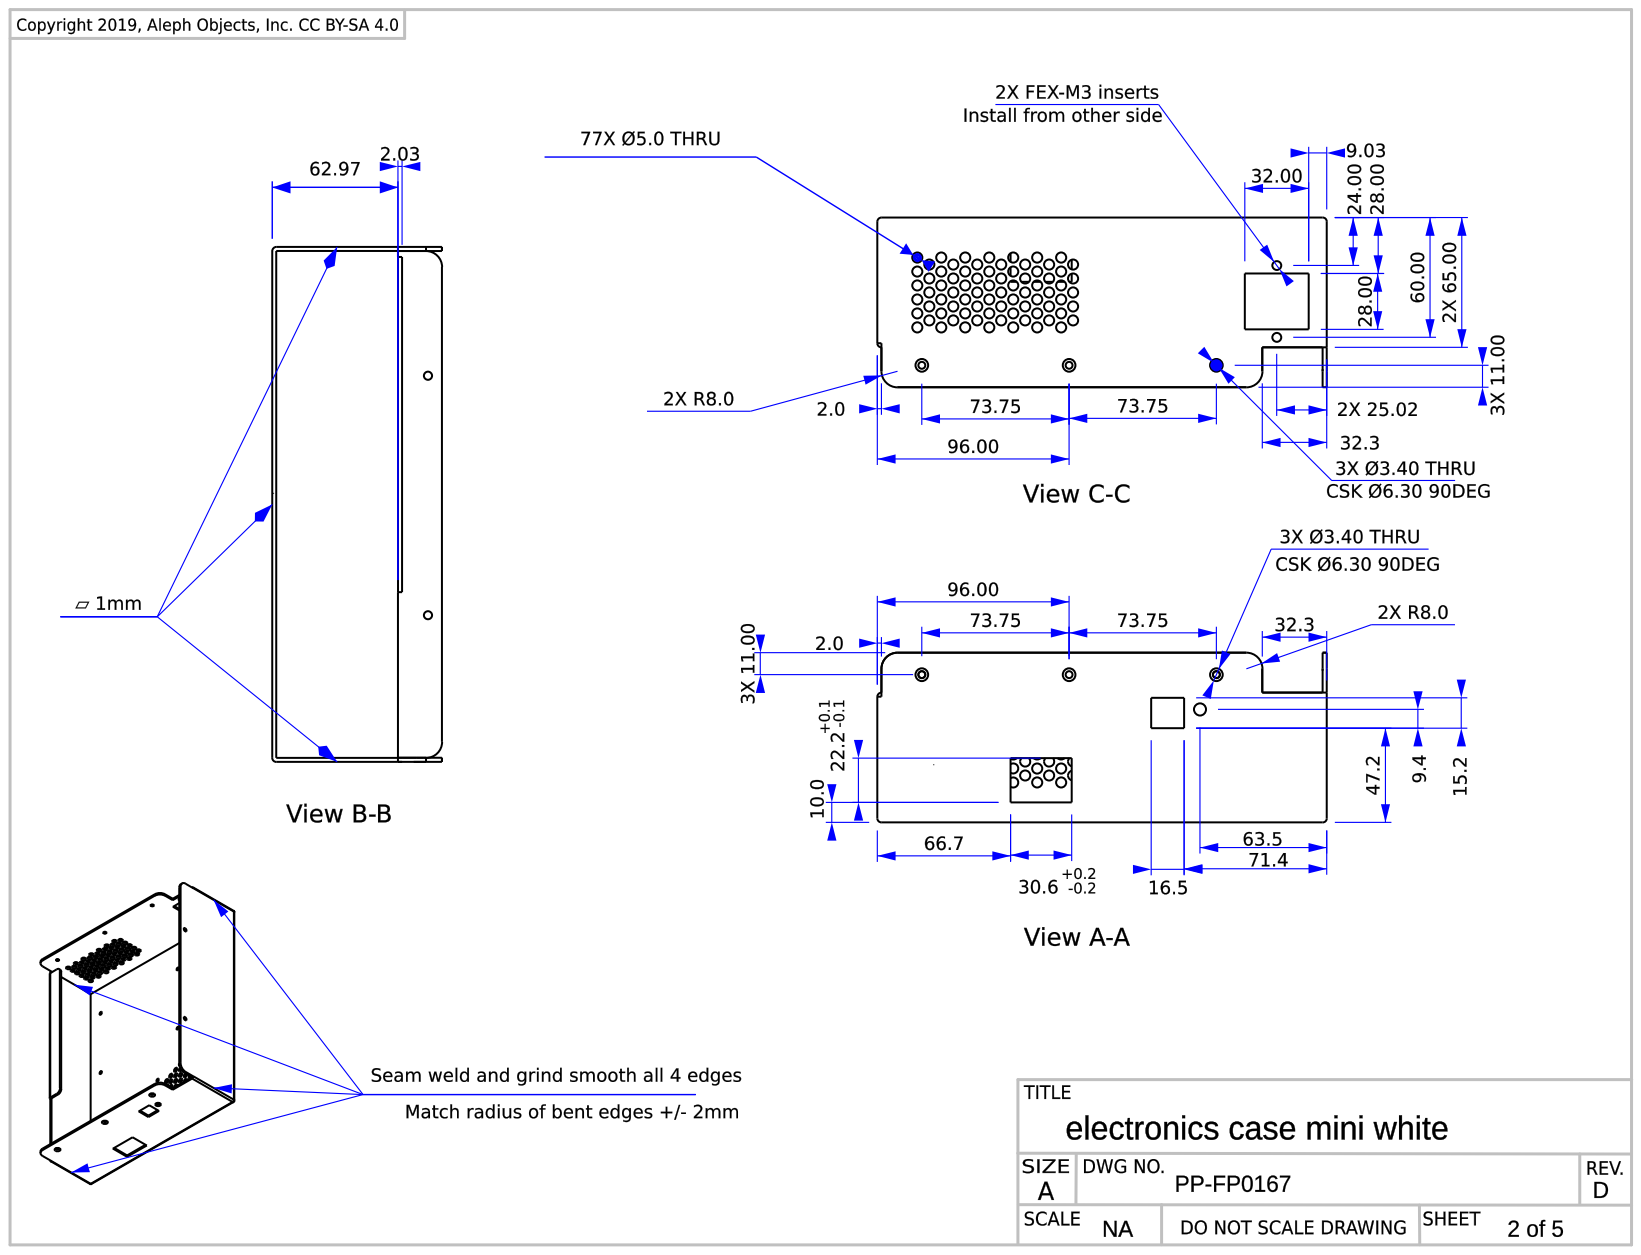
[picture p134: page 2]

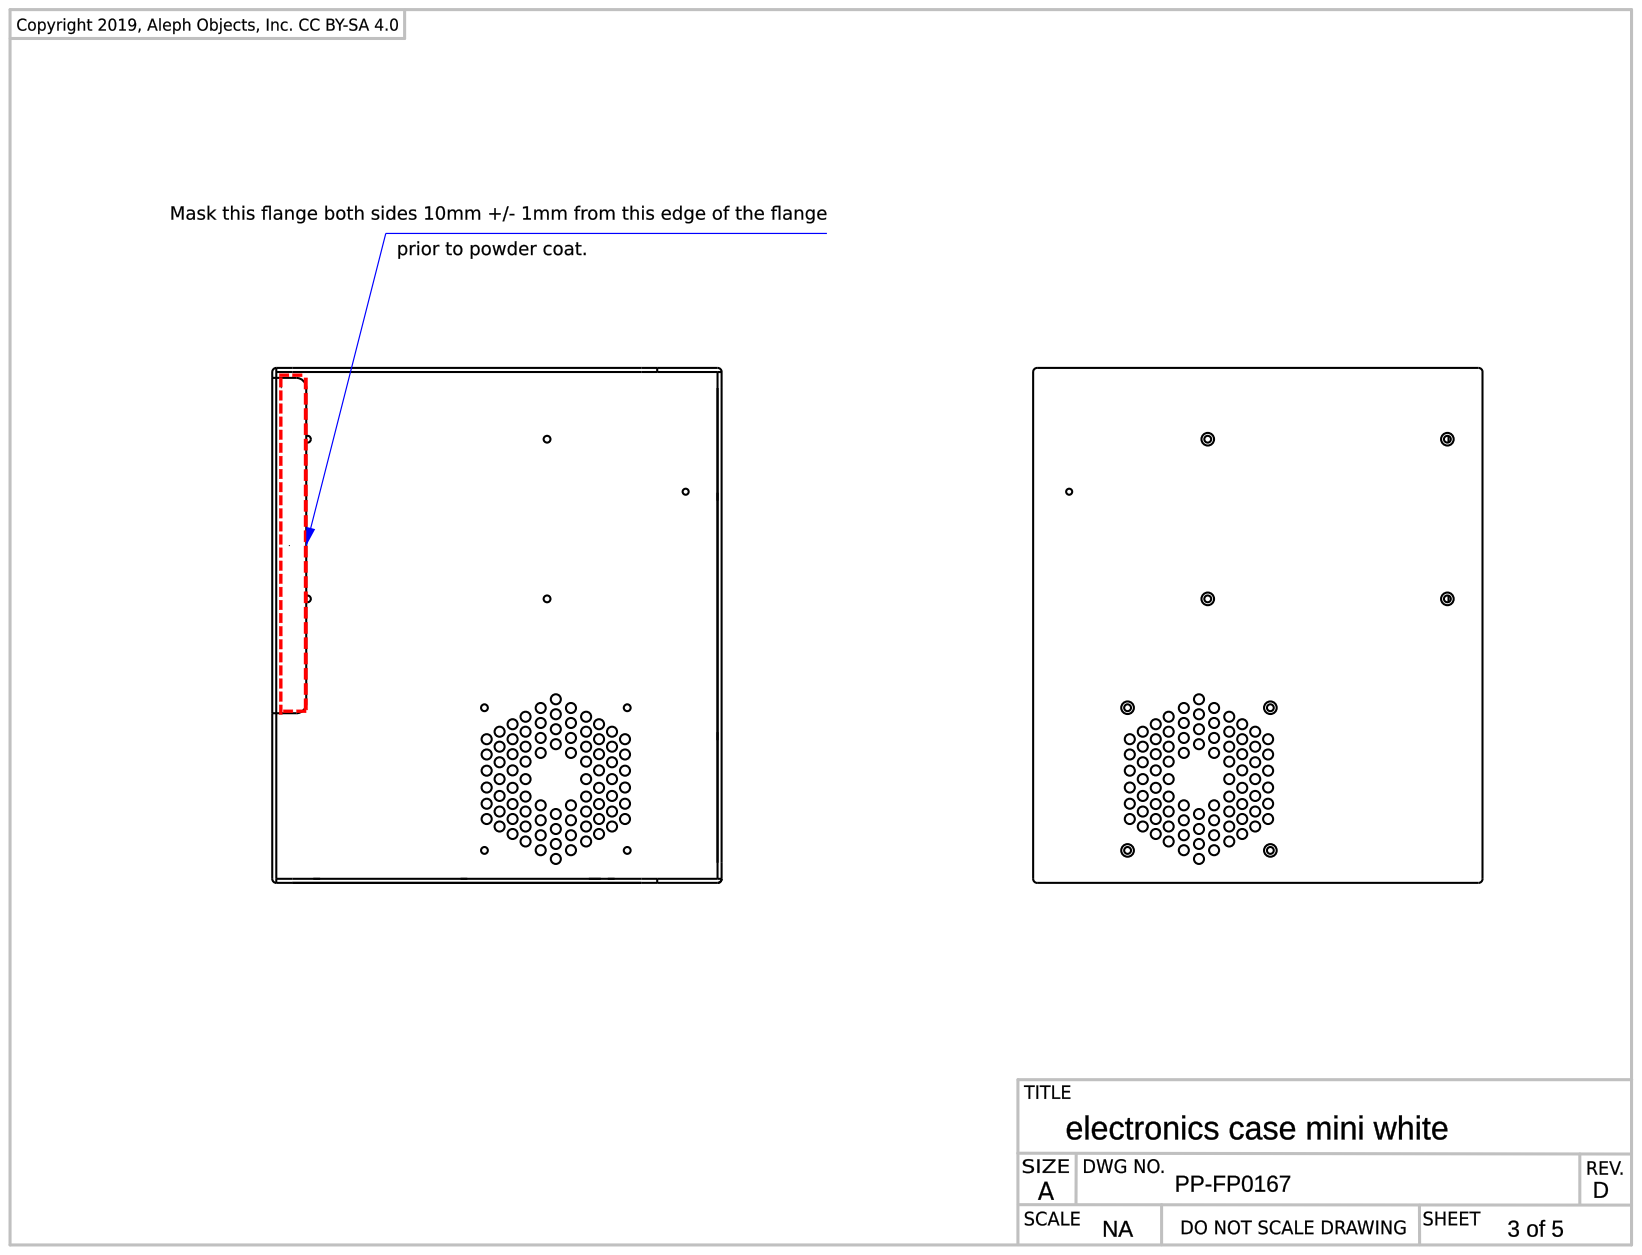
[picture p135: page 3]

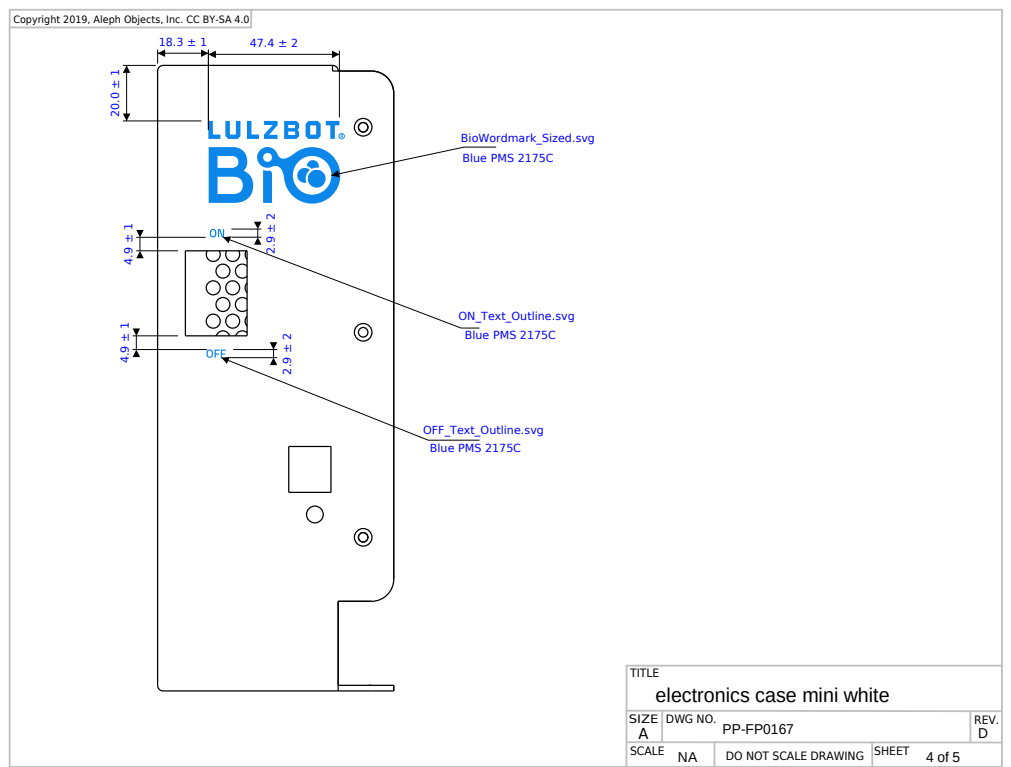
[picture p136: page 4]
BioWordmark_Sized.svg; Blue PMS 2175C; OFF_Text_Outline.svg; ON_Text_Outline.svg

Copyright 2019, Aleph Objects, Inc. CC BY-SA 4.0

TITLE
electronics case mini white

SIZE A | DWG NO. PP-FP0167 | REV. D

SCALE NA | DO NOT SCALE DRAWING | SHEET

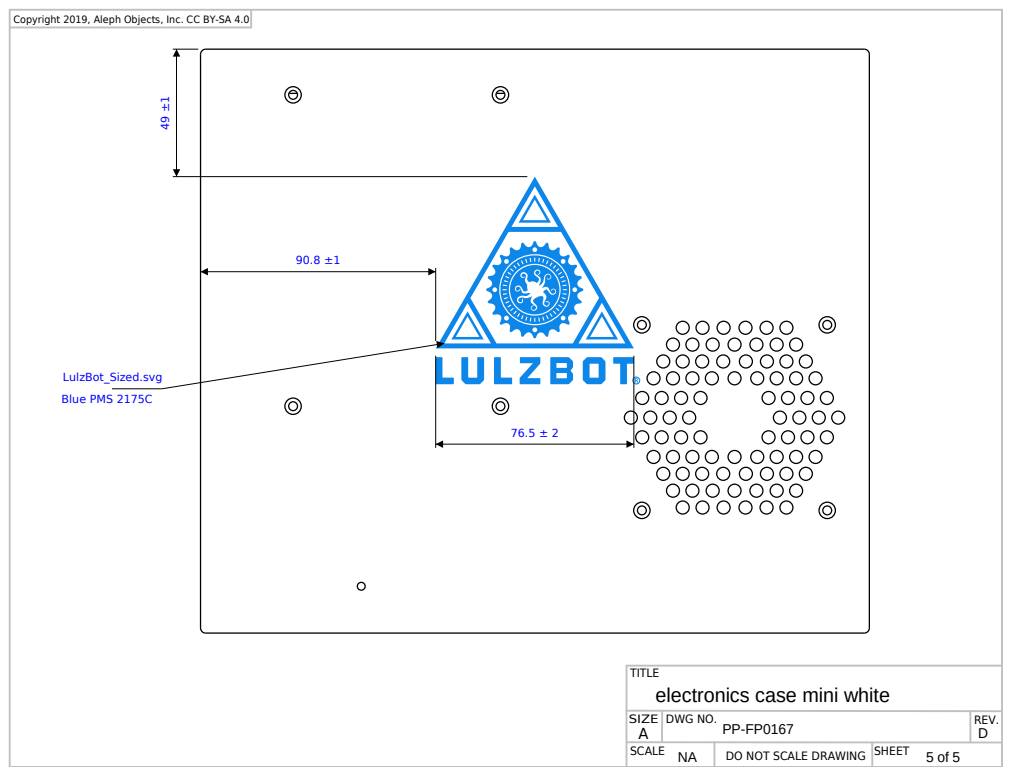
[picture p137: page 5]
LulzBot_Sized.svg; Blue PMS 2175C

Copyright 2019, Aleph Objects, Inc. CC BY-SA 4.0

TITLE
electronics case mini white

SIZE A | DWG NO. PP-FP0167 | REV. D

SCALE NA | DO NOT SCALE DRAWING | SHEET
