reprapperMC/kangaroopaw/production_parts/assembly/inserts_assemblies/Syringe_plunger_coupler_10mL_BD_inserts.pdf

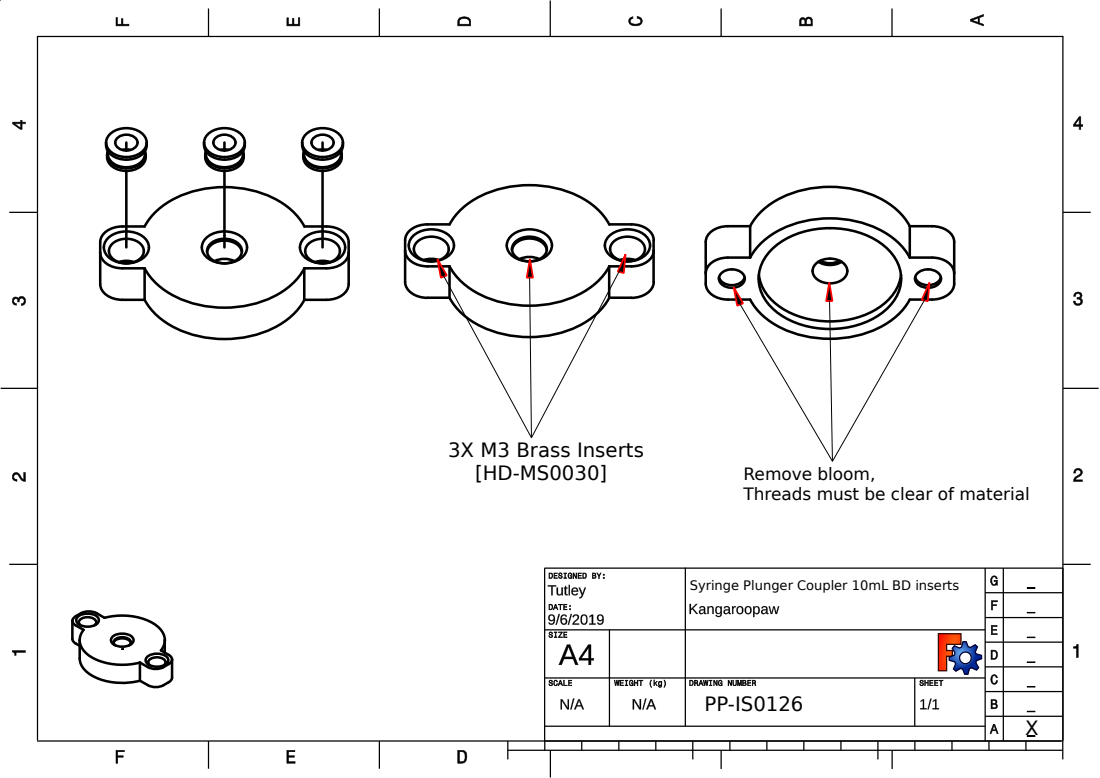
[picture p138: page 1]
3X M3 Brass Inserts; Remove bloom,

Threads must be clear of material

Syringe Plunger Coupler 10mL BD inserts
