reprapperMC/kangaroopaw/production_parts/electronics/chassis_assembly/AS-CB0073_Mini_Plug_to_SW_Extension_Harness_Assembly.pdf

## Cut Length= 560mm

## Strip 7mm

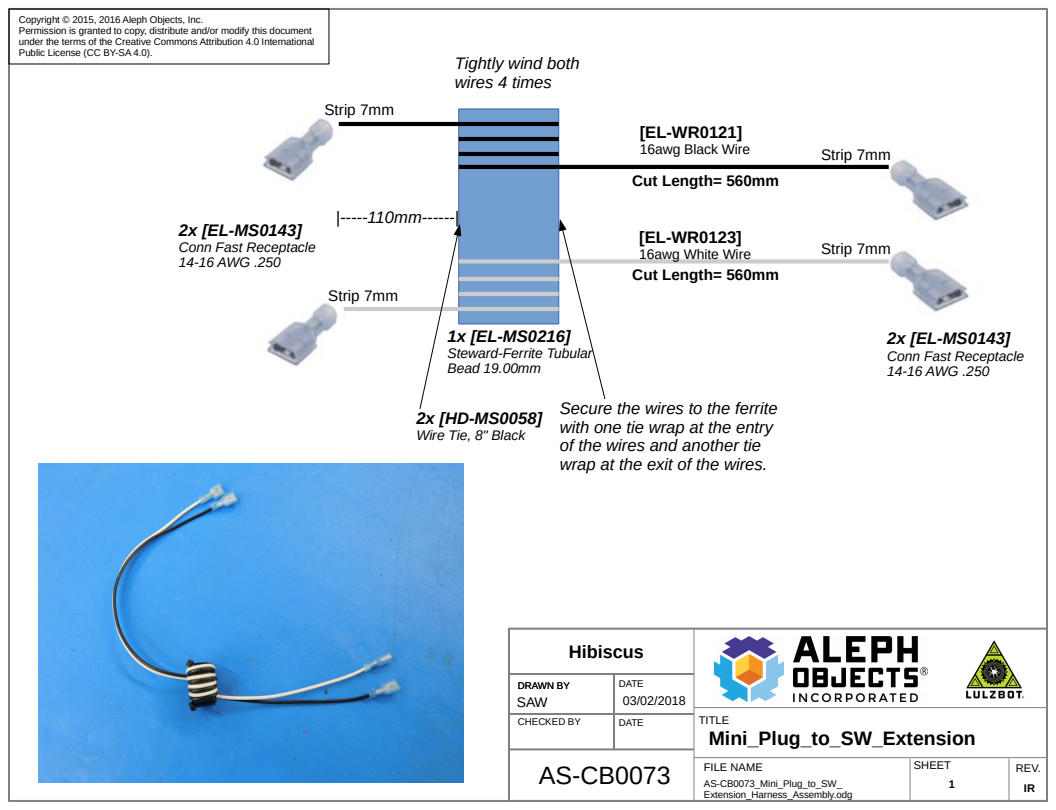
[picture p139: page 1]
TITLE; FILE NAME; SHEET; REV.; Mini_Plug_to_SW_Extension; Strip 7mm; AS-CB0073_Mini_Plug_to_SW_ Extension_Harness_Assembly.odg; [EL-WR0121] 16awg Black Wire; Cut Length= 560mm; [EL-WR0123] 16awg White Wire

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

Tightly wind both
wires 4 times

Conn Fast Receptacle
14-16 AWG .250

Steward-Ferrite Tubular
Bead 19.00mm

Secure the wires to the ferrite
with one tie wrap at the entry
of the wires and another tie
wrap at the exit of the wires.

Wire Tie, 8" Black

Hibiscus

DRAWN BY DRAWN BY SAW | DATE 03/02/2018

CHECKED BY | DATE
