reprapperMC/kangaroopaw/production_parts/electronics/chassis_assembly/AS-CB0078_case_fan_harness_revA.pdf

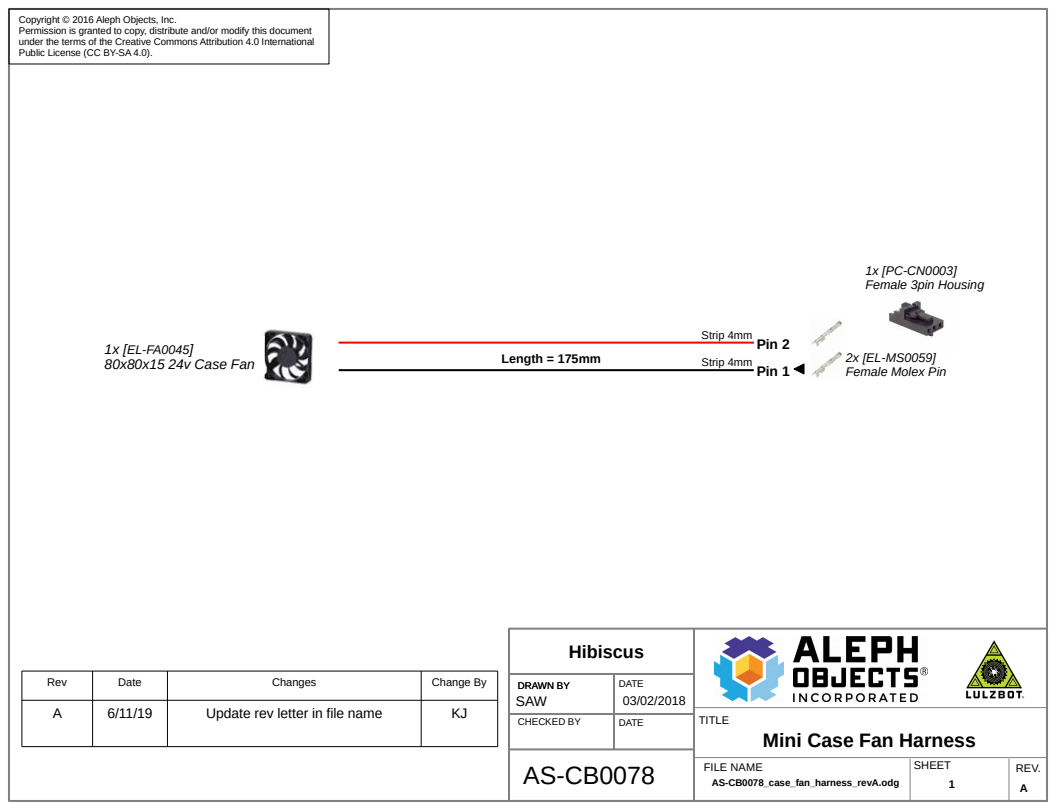
[picture p140: page 1]
FILE NAME; SHEET; REV.; AS-CB0078_case_fan_harness_revA.odg; Length = 175mm; 1x [EL-FA0045] 80x80x15 24v Case Fan; Strip 4mm; 1x [PC-CN0003] Female 3pin Housing; Strip 4mm Pin 1; Pin 2

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

Female Molex Pin

Hibiscus

Rev | Date | Changes | Change By
A | 6/11/19 | Update rev letter in file name | KJ

DRAWN BY DRAWN BY SAW | DATE 03/02/2018

TITLE
Mini Case Fan Harness

CHECKED BY | DATE
