reprapperMC/kangaroopaw/production_parts/assembly/inserts_assemblies/syringe_pump_cover_inserts.pdf

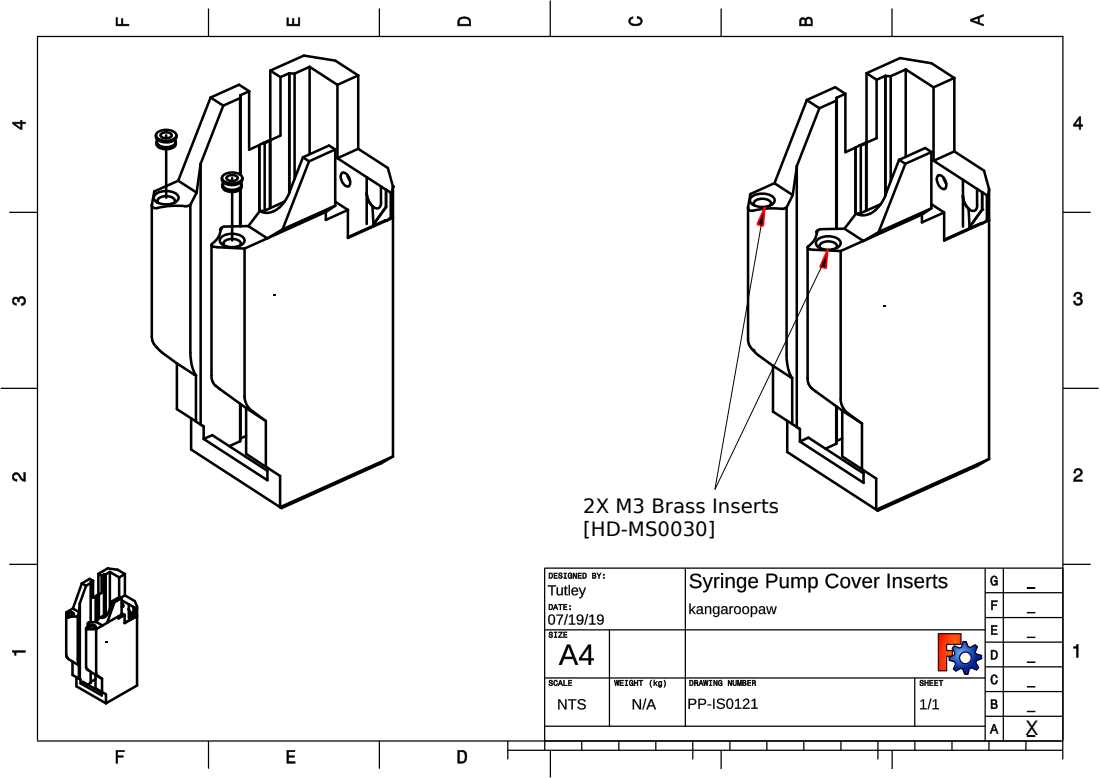
[picture p141: page 1]
2X M3 Brass Inserts [HD-MS0030]
