reprapperMC/kangaroopaw/production_parts/assembly/inserts_assemblies/syringe_pump_mount_inserts.pdf

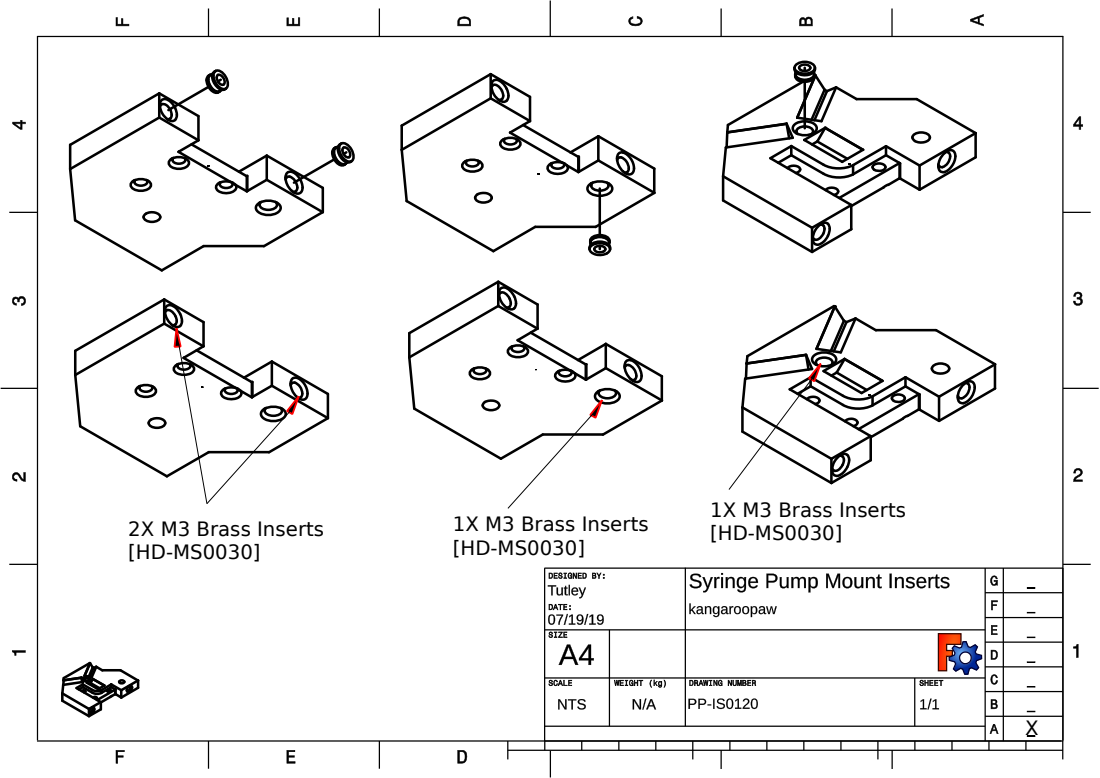
[picture p142: page 1]
2X M3 Brass Inserts [HD-MS0030]; 1X M3 Brass Inserts [HD-MS0030]
