reprapperMC/kangaroopaw/production_parts/assembly/inserts_assemblies/touchscreen_case_inserts.pdf

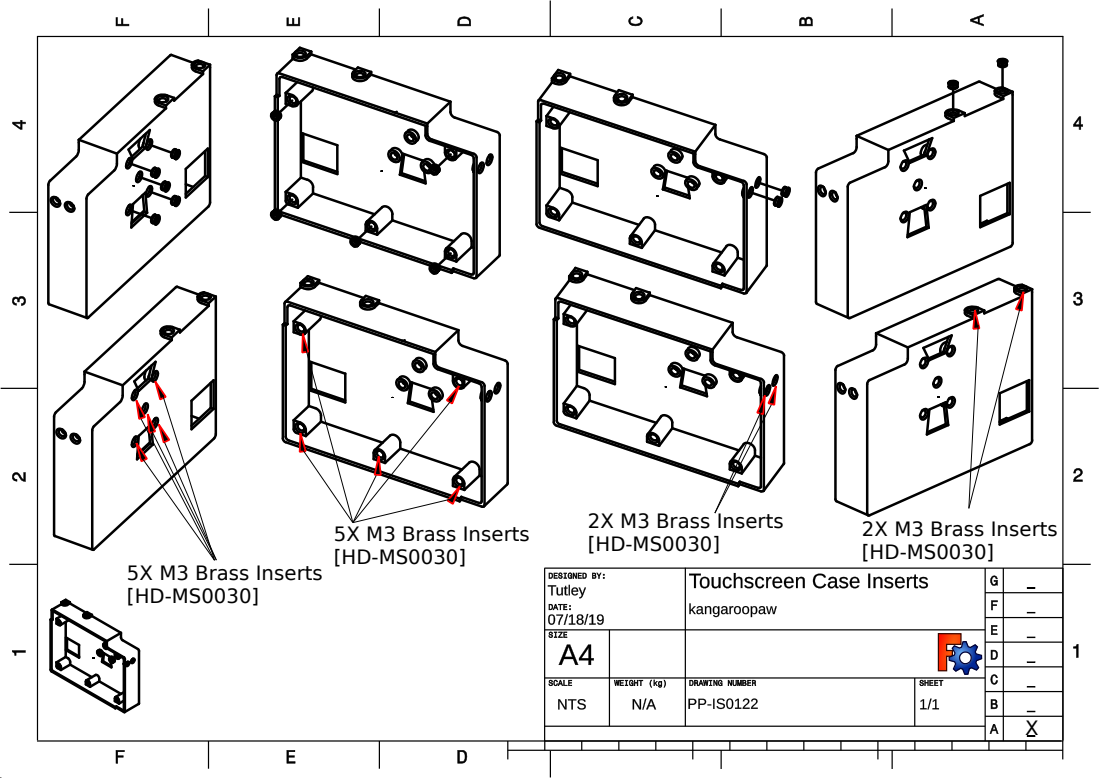
[picture p143: page 1]
5X M3 Brass Inserts [HD-MS0030]; 2X M3 Brass Inserts
