reprapperMC/kangaroopaw/production_parts/assembly/inserts_assemblies/touchscreen_center_inserts.pdf

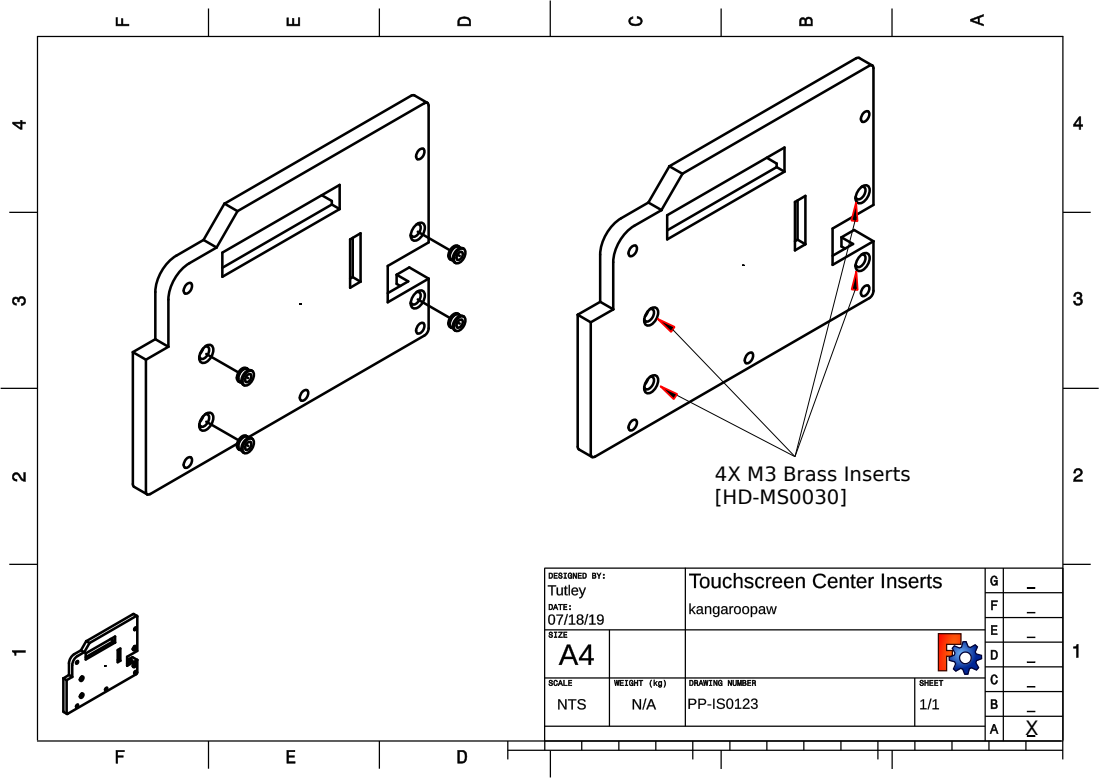
[picture p144: page 1]
4X M3 Brass Inserts [HD-MS0030]
