reprapperMC/kangaroopaw/production_parts/assembly/inserts_assemblies/double_bearing_holder_inserts_nonswitch_side.pdf

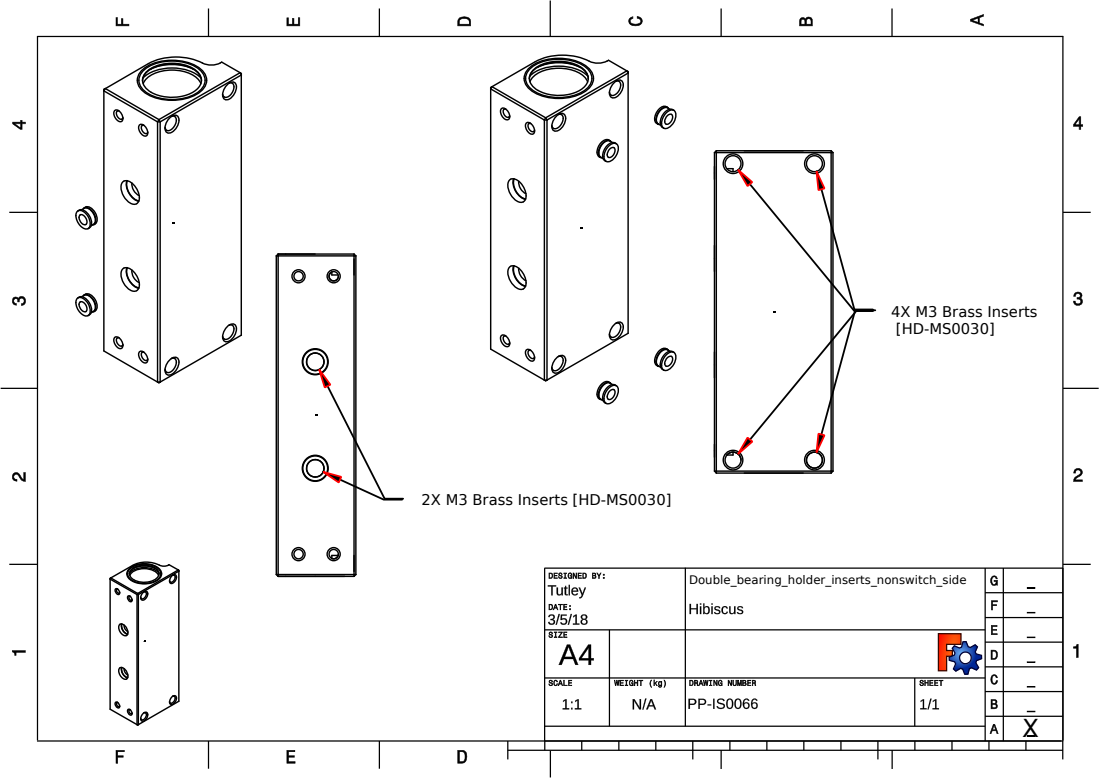
[picture p145: page 1]
Double_bearing_holder_inserts_nonswitch_side; 4X M3 Brass Inserts [HD-MS0030]

2X M3 Brass Inserts [HD-MS0030]
