reprapperMC/kangaroopaw/production_parts/assembly/inserts_assemblies/handle_bar_inserts.pdf

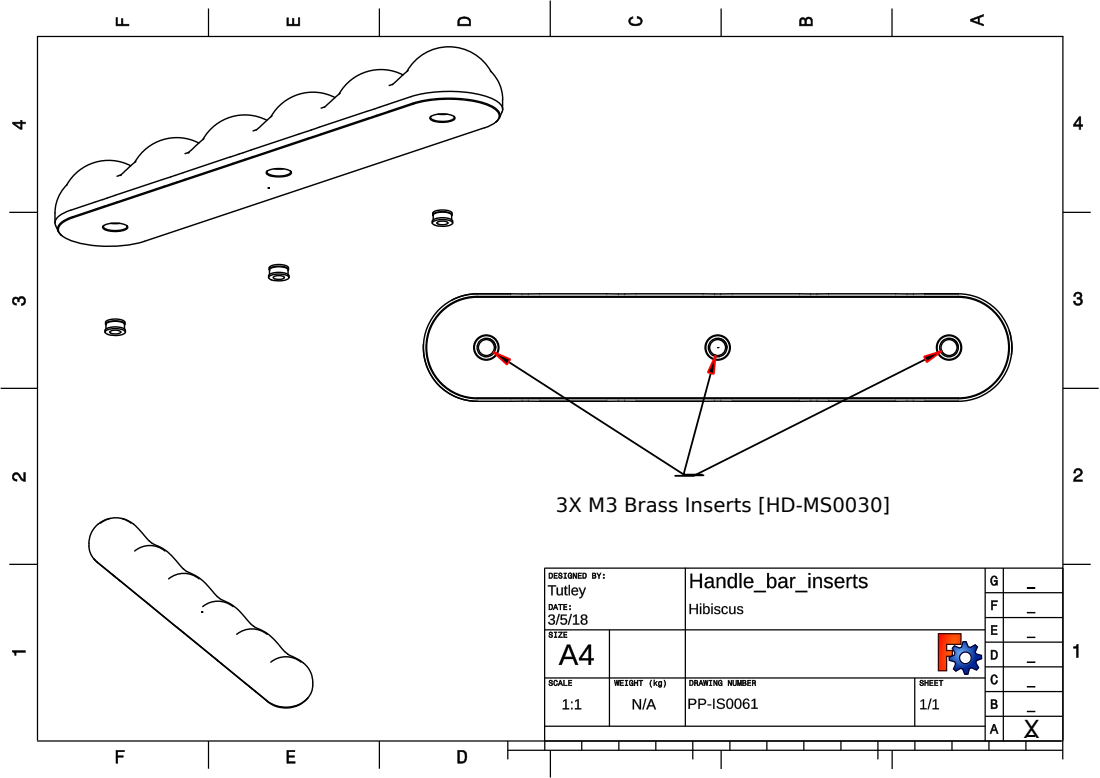
[picture p147: page 1]

3X M3 Brass Inserts [HD-MS0030]
