reprapperMC/kangaroopaw/production_parts/assembly/inserts_assemblies/upper_strain_relief_inserts.pdf

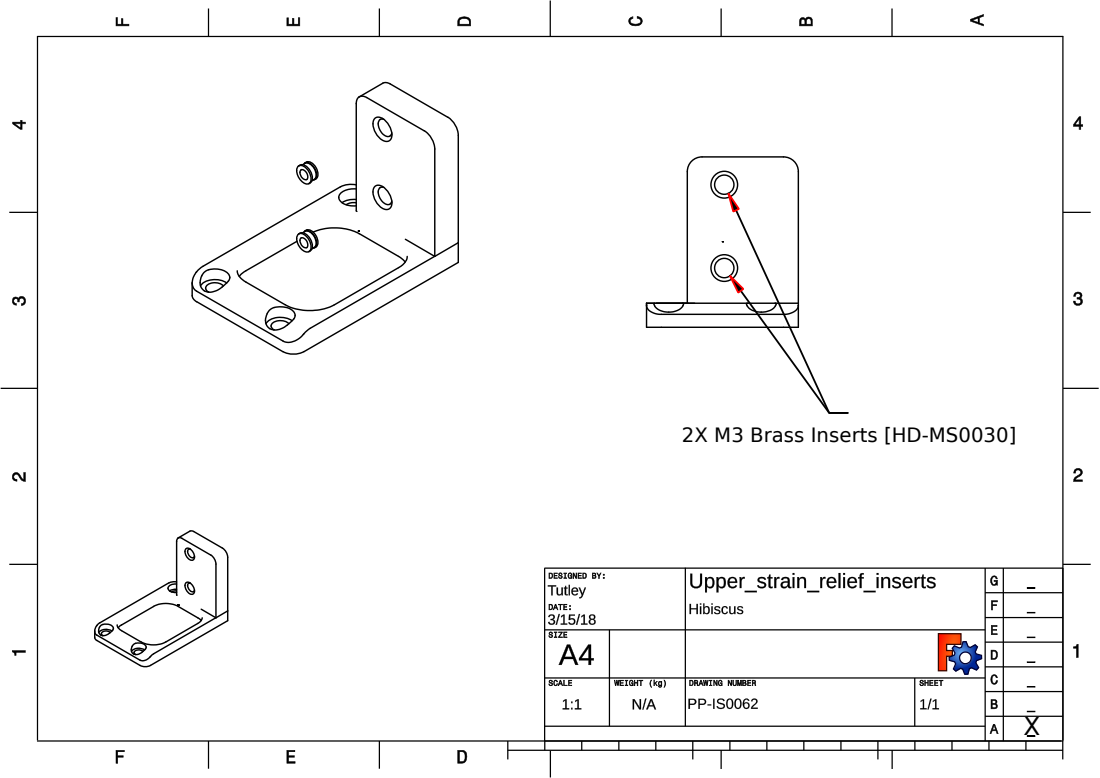
[picture p148: page 1]

2X M3 Brass Inserts [HD-MS0030]
