reprapperMC/kangaroopaw/production_parts/assembly/inserts_assemblies/x_carriage_inserts.pdf

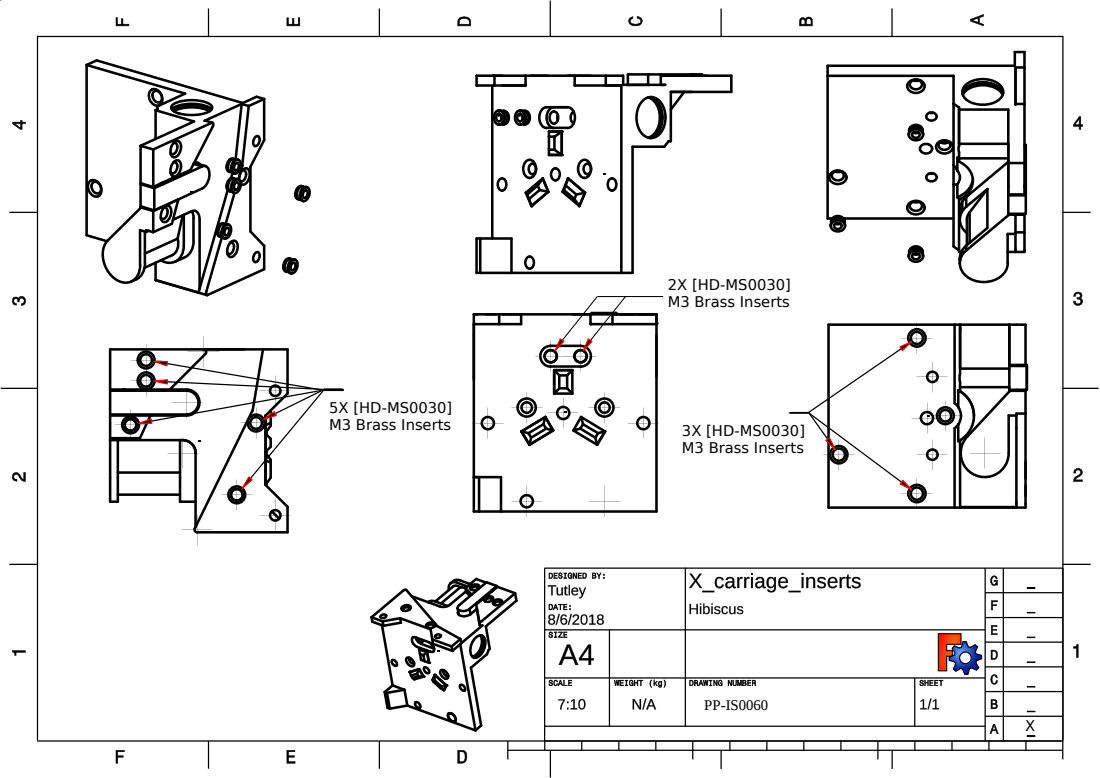
[picture p149: page 1]
2X [HD-MS0030] M3 Brass Inserts; M3 Brass Inserts
