reprapperMC/kangaroopaw/production_parts/assembly/inserts_assemblies/x_end_idler_inserts.pdf

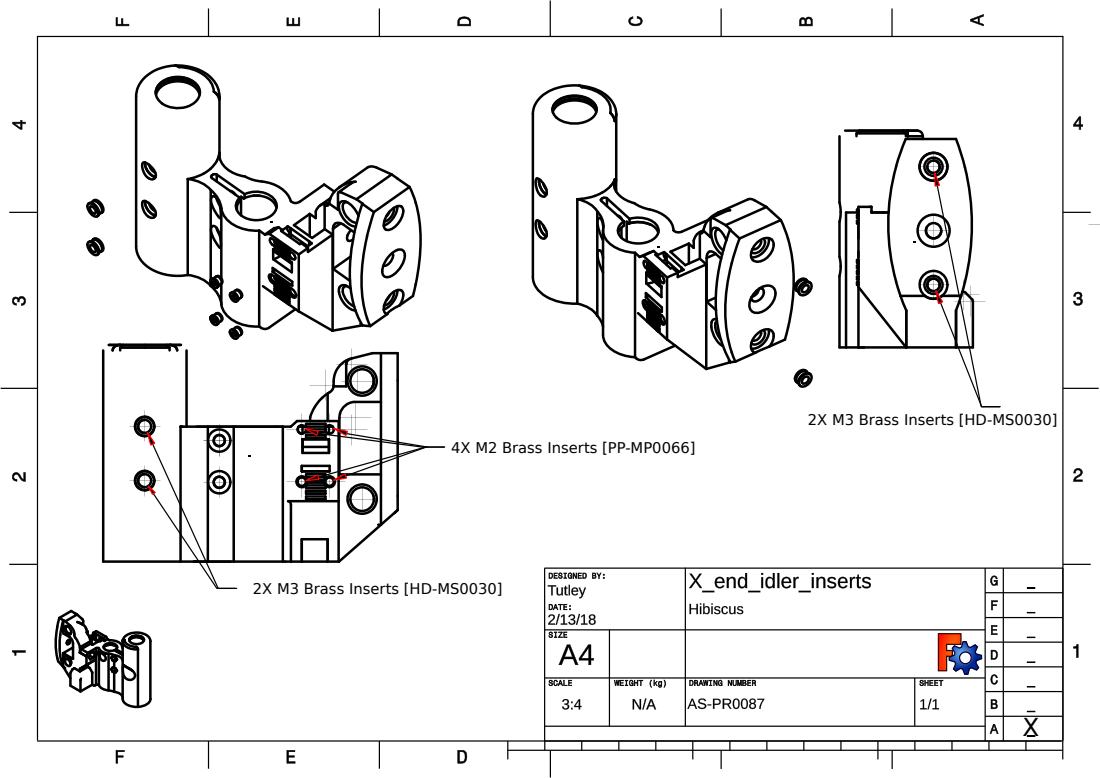
[picture p150: page 1]

2X M3 Brass Inserts [HD-MS0030]

4X M2 Brass Inserts [PP-MP0066]
