reprapperMC/kangaroopaw/production_parts/assembly/inserts_assemblies/x_end_motor_inserts.pdf

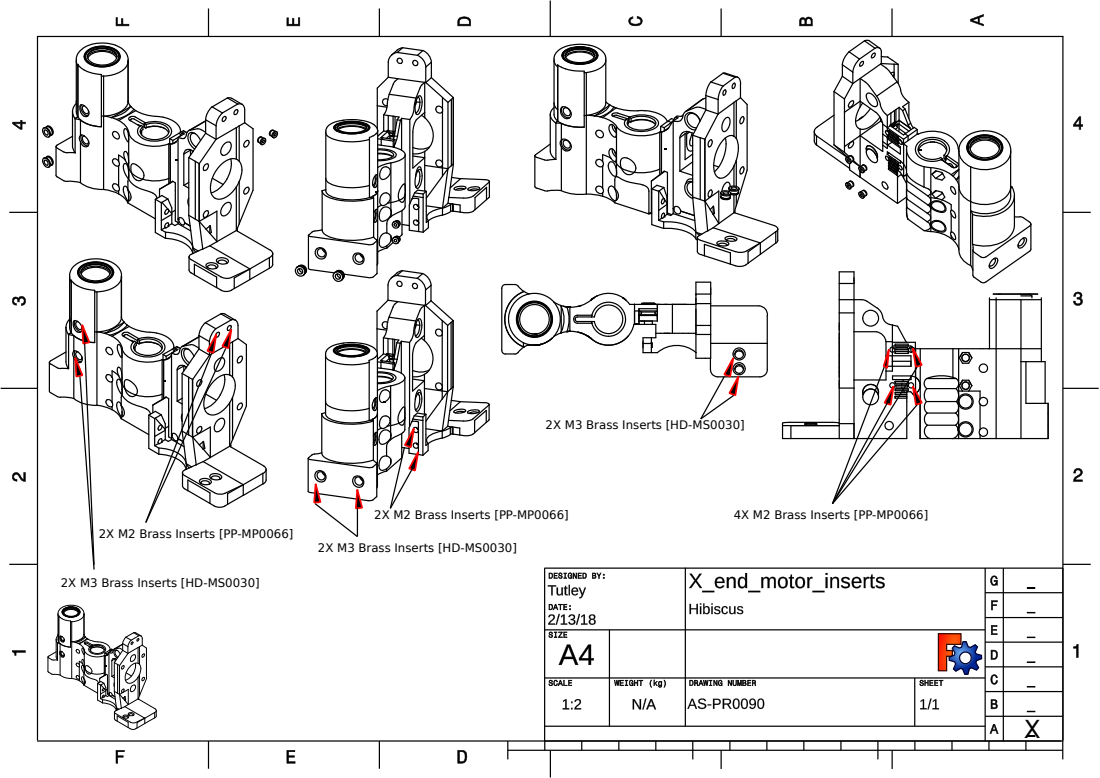
[picture p151: page 1]

2X M3 Brass Inserts [HD-MS0030]

2X M2 Brass Inserts [PP-MP0066]

4X M2 Brass Inserts [PP-MP0066]
