reprapperMC/kangaroopaw/production_parts/assembly/inserts_assemblies/y_axis_rod_mount_inserts.pdf

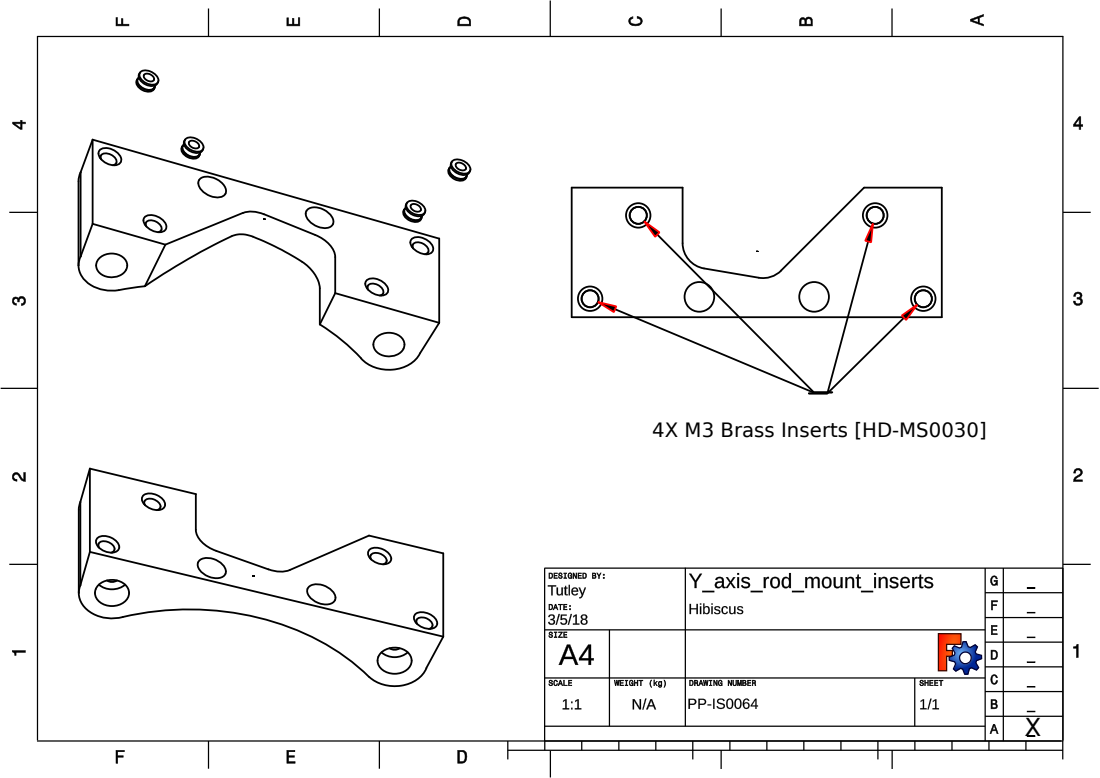
[picture p152: page 1]

4X M3 Brass Inserts [HD-MS0030]
