reprapperMC/kangaroopaw/production_parts/assembly/inserts_assemblies/y_idler_inserts.pdf

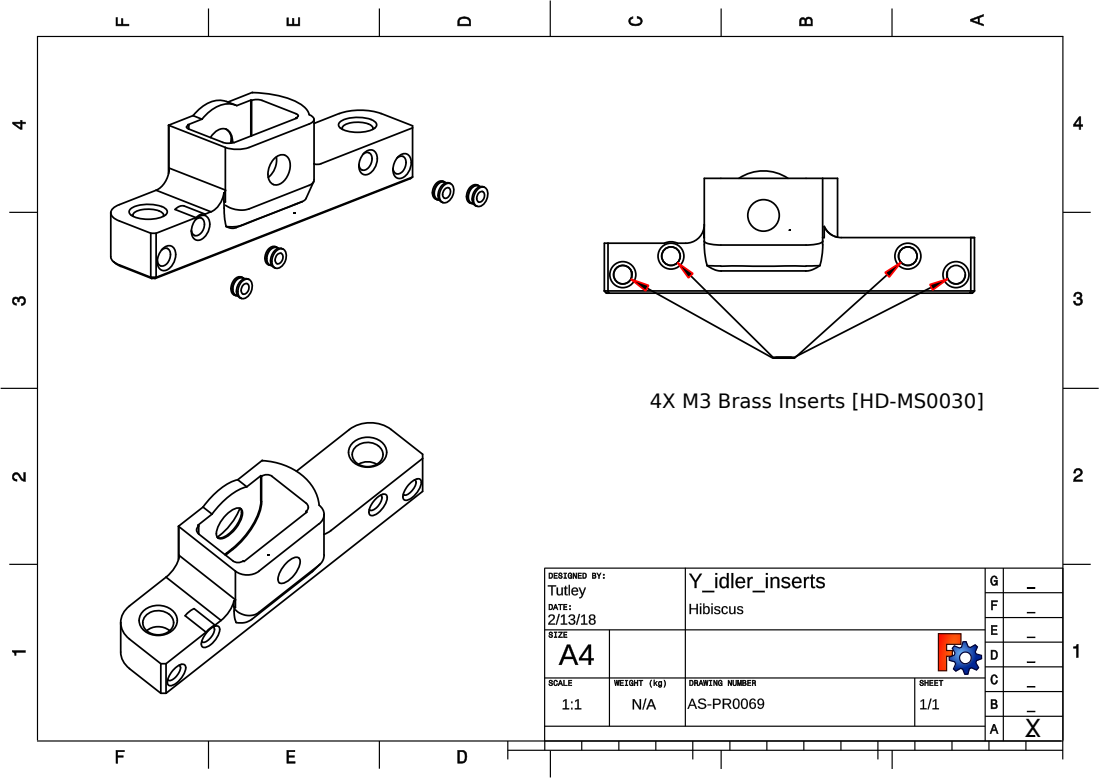
[picture p153: page 1]

4X M3 Brass Inserts [HD-MS0030]
