reprapperMC/kangaroopaw/production_parts/assembly/inserts_assemblies/Y_single_bearing_holder_inserts.pdf

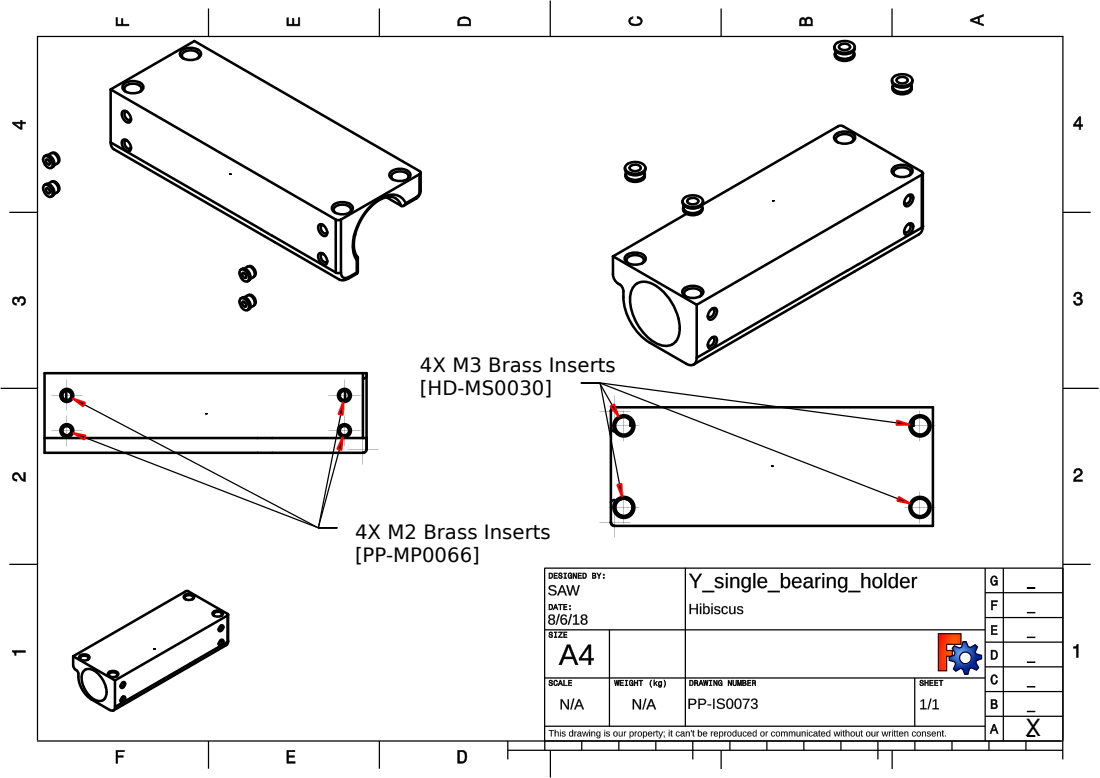
[picture p154: page 1]
4X M3 Brass Inserts [HD-MS0030]; 4X M2 Brass Inserts [PP-MP0066]
