reprapperMC/kangaroopaw/production_parts/assembly/inserts_assemblies/z_brake_mount_inserts.pdf

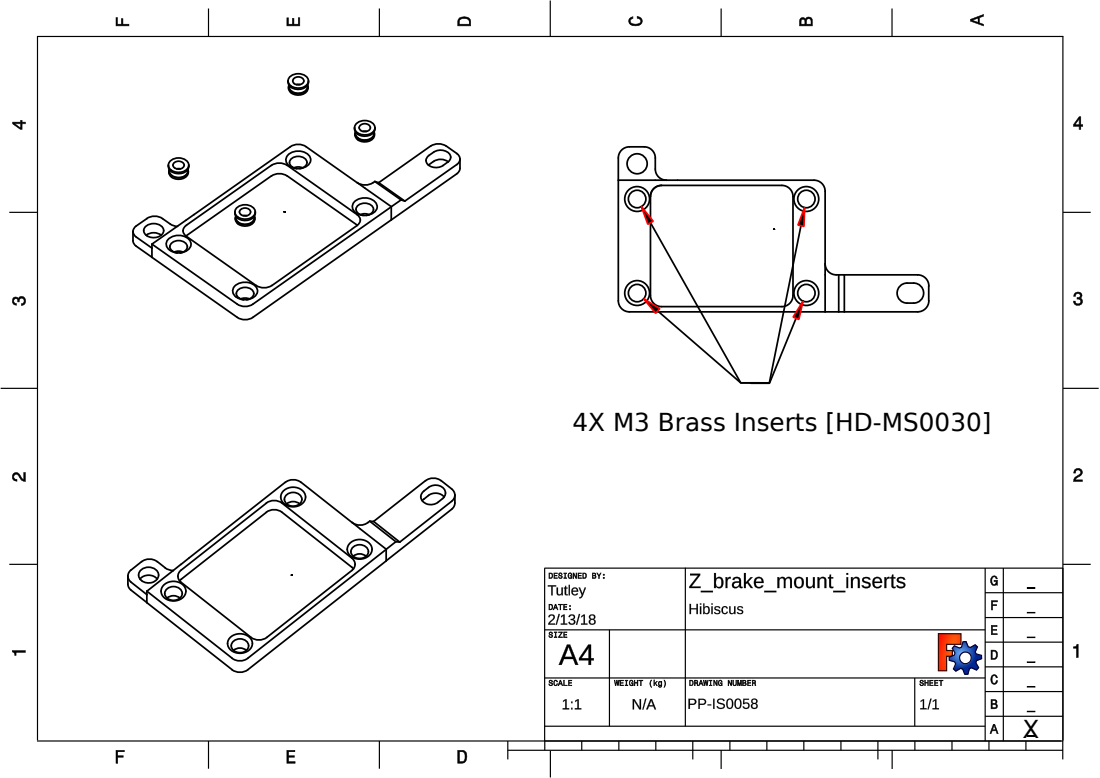
[picture p155: page 1]

4X M3 Brass Inserts [HD-MS0030]
