reprapperMC/kangaroopaw/production_parts/assembly/inserts_assemblies/z_lower_left_inserts.pdf

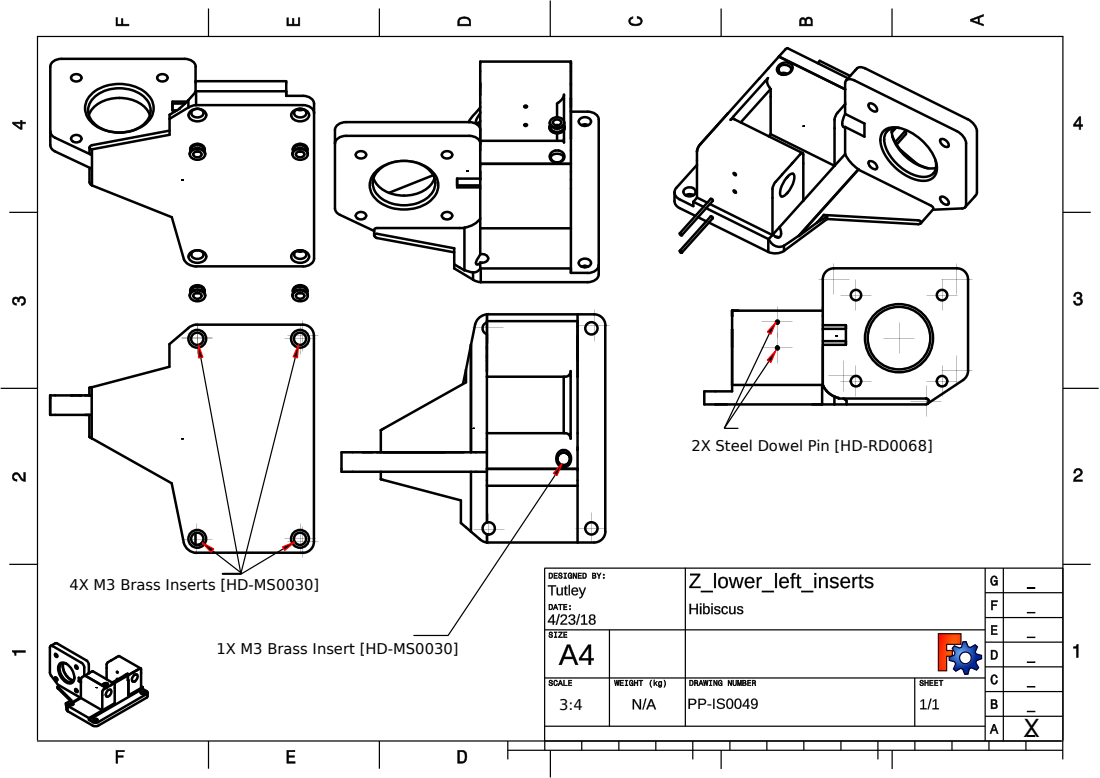
[picture p156: page 1]

2X Steel Dowel Pin [HD-RD0068]

4X M3 Brass Inserts [HD-MS0030]

1X M3 Brass Insert [HD-MS0030]
