reprapperMC/kangaroopaw/production_parts/assembly/inserts_assemblies/z_upper_left_inserts.pdf

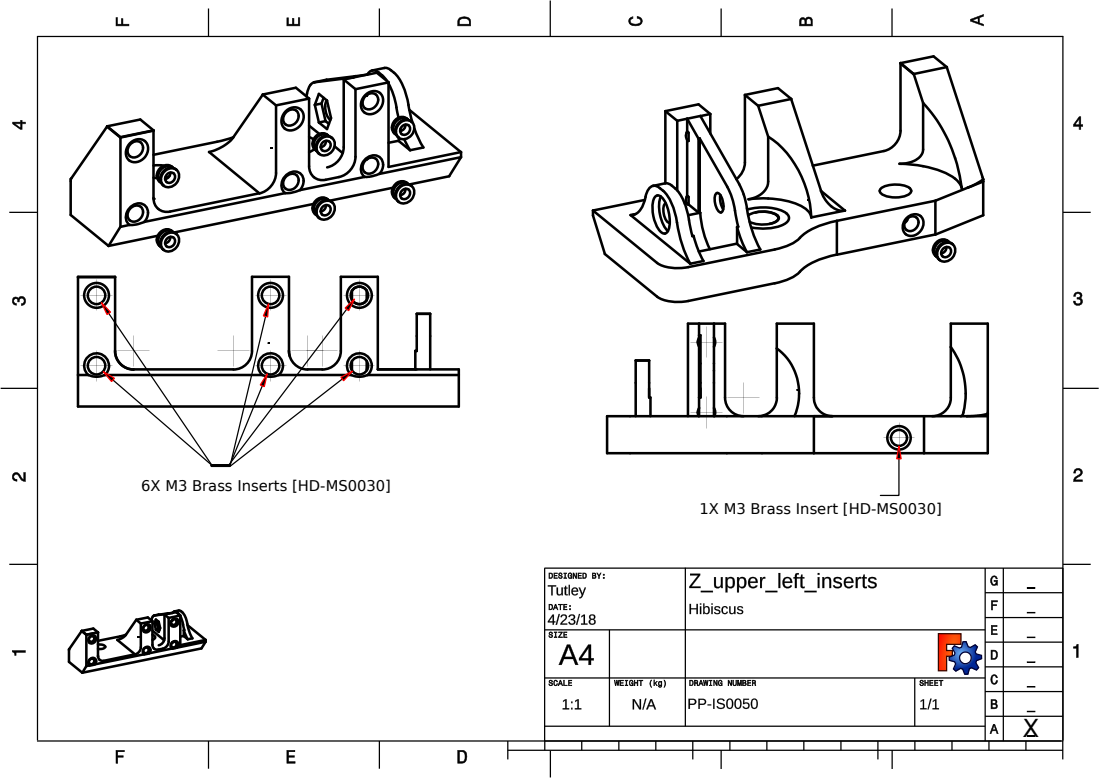
[picture p157: page 1]

6X M3 Brass Inserts [HD-MS0030]

1X M3 Brass Insert [HD-MS0030]
