reprapperMC/kangaroopaw/production_parts/assembly/inserts_assemblies/z_upper_right_inserts.pdf

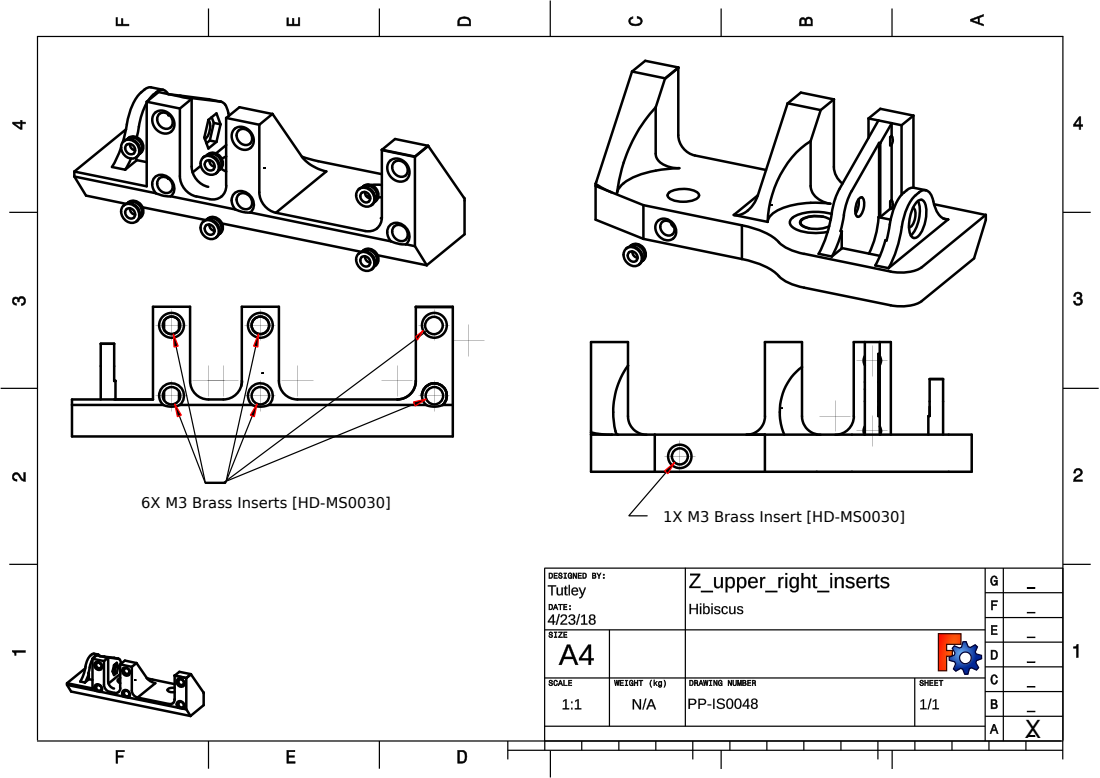
[picture p158: page 1]

6X M3 Brass Inserts [HD-MS0030]

1X M3 Brass Insert [HD-MS0030]
