reprapperMC/kangaroopaw/production_parts/machined_parts/55mmx4_dish_plate/PP-FP0184_55mmx4_dish_plate.pdf

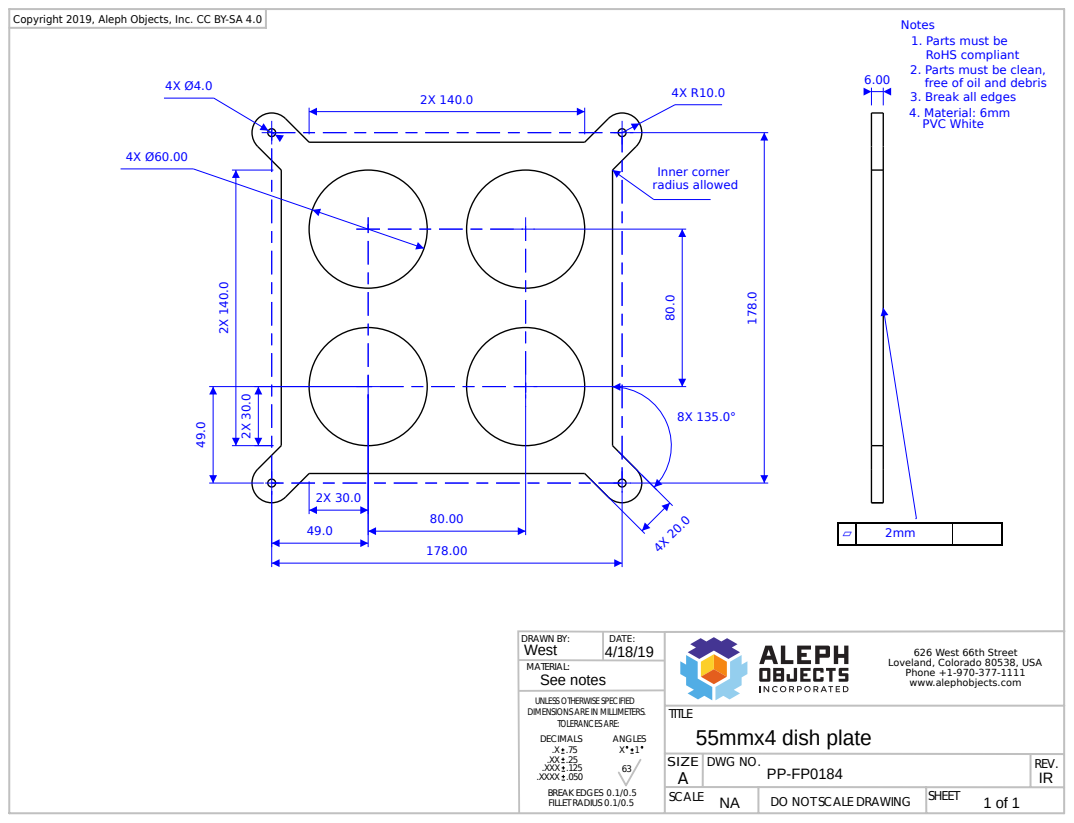
[picture p159: page 1]
Inner corner radius allowed; ANGLES; MATERIAL:; DRAWN BY:; TITLE; West; 55mmx4 dish plate; DATE:; See notes

Copyright 2019, Aleph Objects, Inc. CC BY-SA 4.0

Notes
1. Parts must be
RoHS compliant
2. Parts must be clean,
free of oil and debris
3. Break all edges
4. Material: 6mm
PVC White

626 West 66th Street
Loveland, Colorado 80538, USA
Phone +1-970-377-1111
www.alephobjects.com

UNLESS OTHERWISE SPECIFIED
DIMENSIONS ARE IN MILLIMETERS.
TOLERANCES ARE:
DECIMALS
.XXX .125
.XXXX .050
BREAK EDGES 0.1/0.5
FILLET RADIUS 0.1/0.5

SIZE A | DWG NO. PP-FP0184 | REV. IR

SCALE NA | DO NOT SCALE DRAWING | SHEET
