reprapperMC/kangaroopaw/production_parts/machined_parts/polycarb_LCD_cover/PP-FP0183_polycarb_LCD_cover_revA.pdf

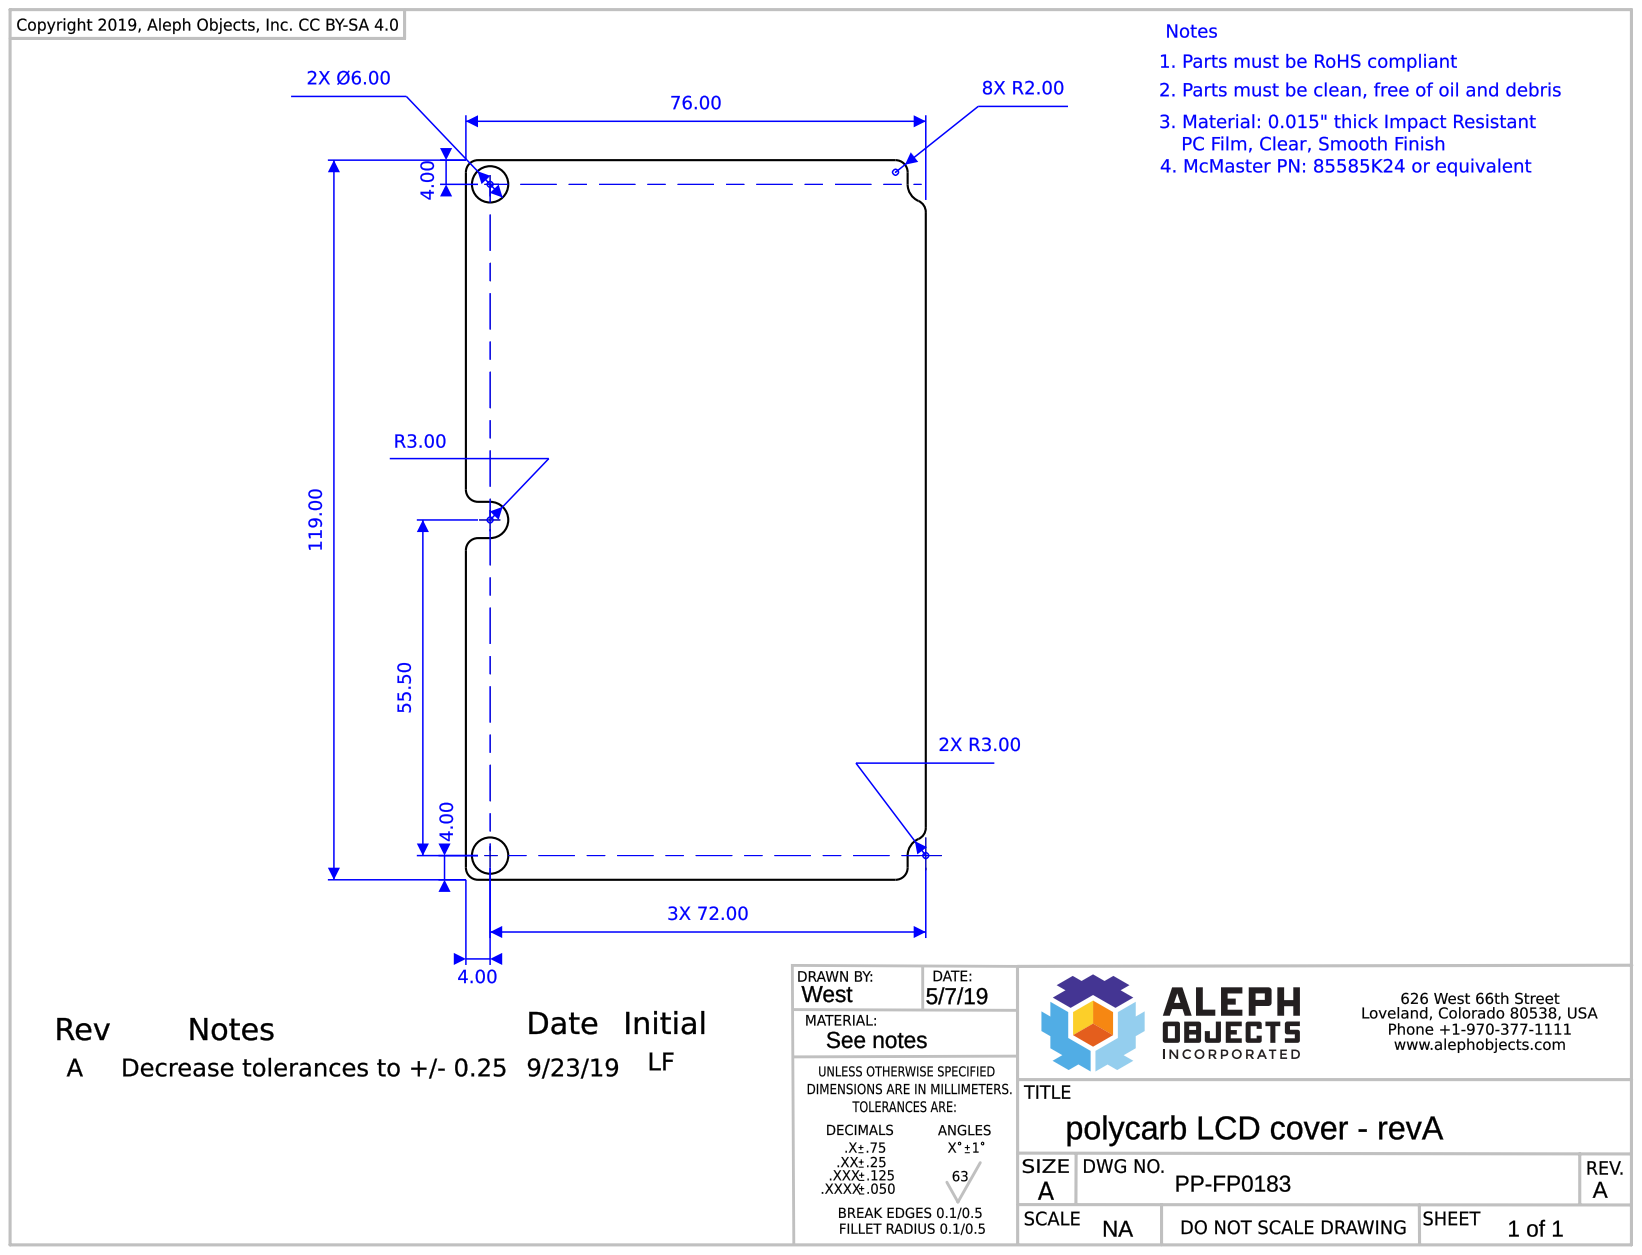
[picture p160: page 1]
