reprapperMC/kangaroopaw/production_parts/tool_head/machined_parts/PP-MP0281_carriage_revE.pdf

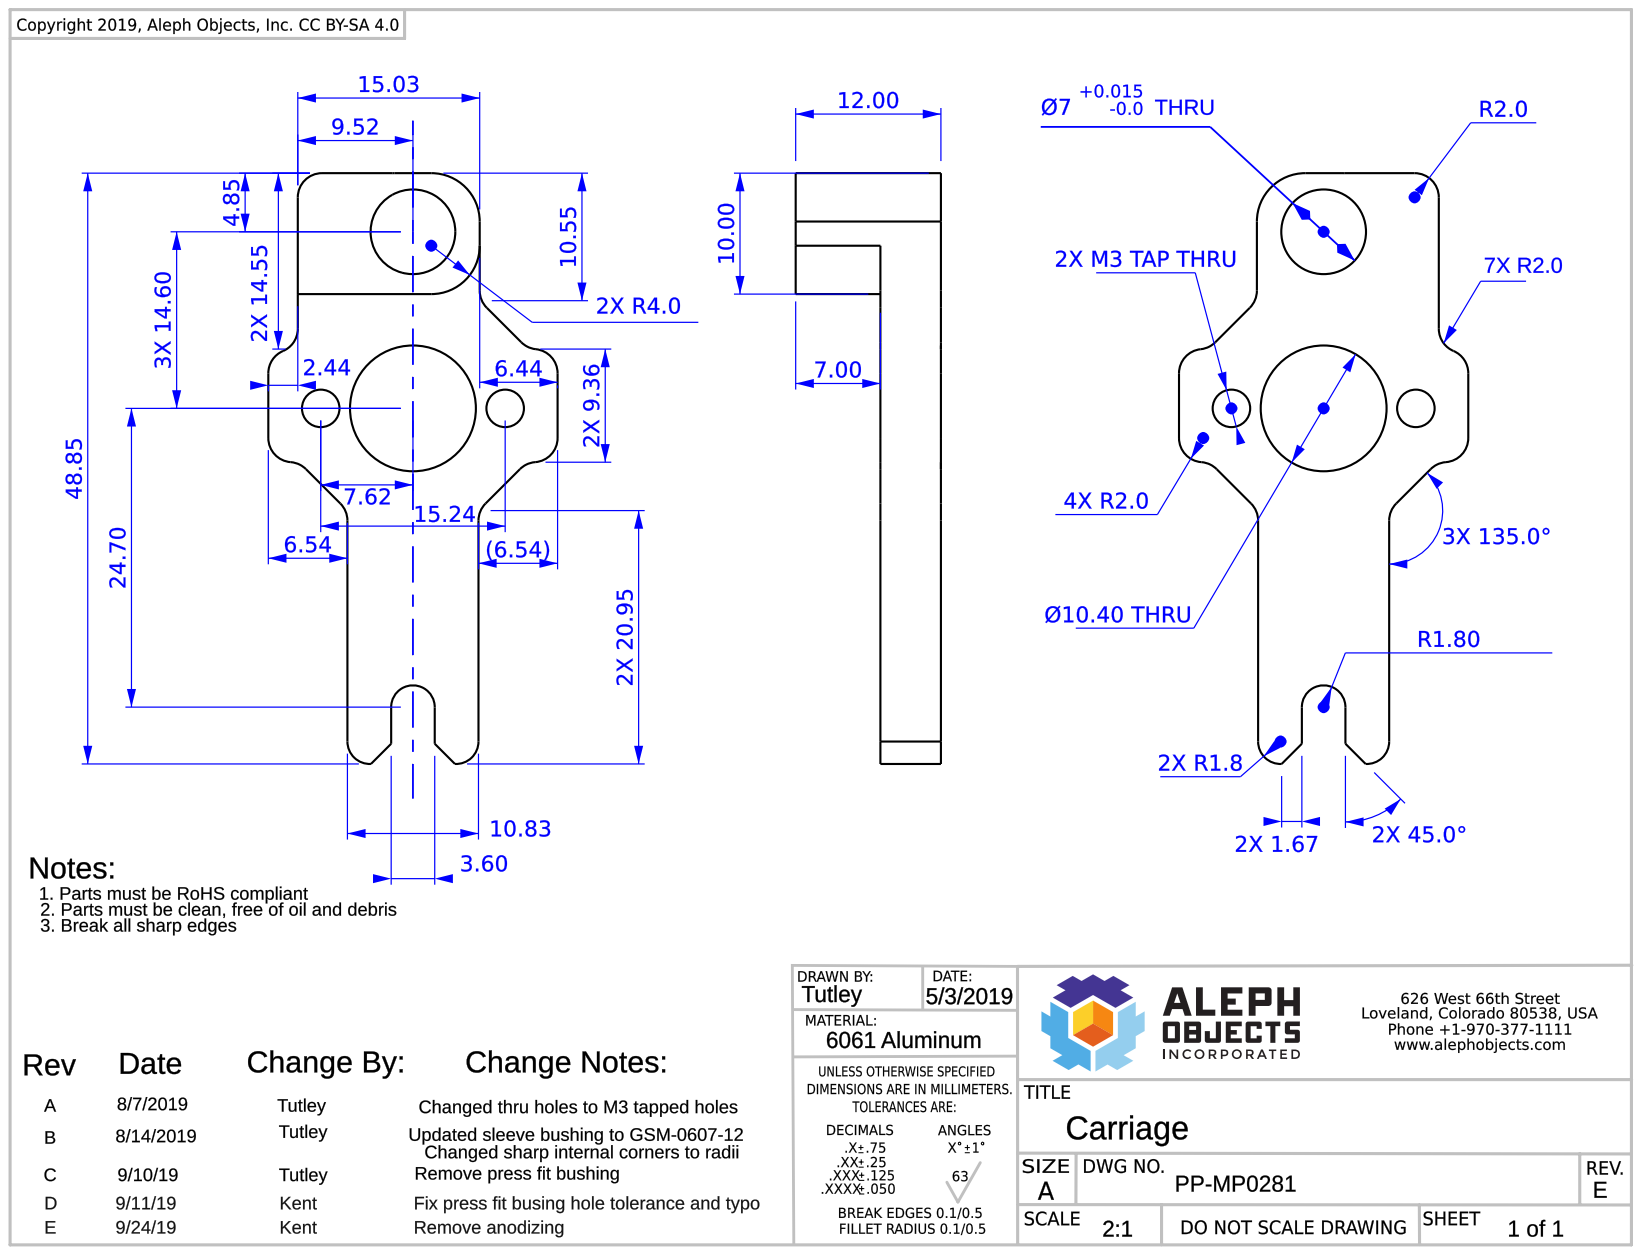
[picture p161: page 1]
