reprapperMC/kangaroopaw/production_parts/tool_head/machined_parts/PP-MP0279_motor_mount_revB.pdf

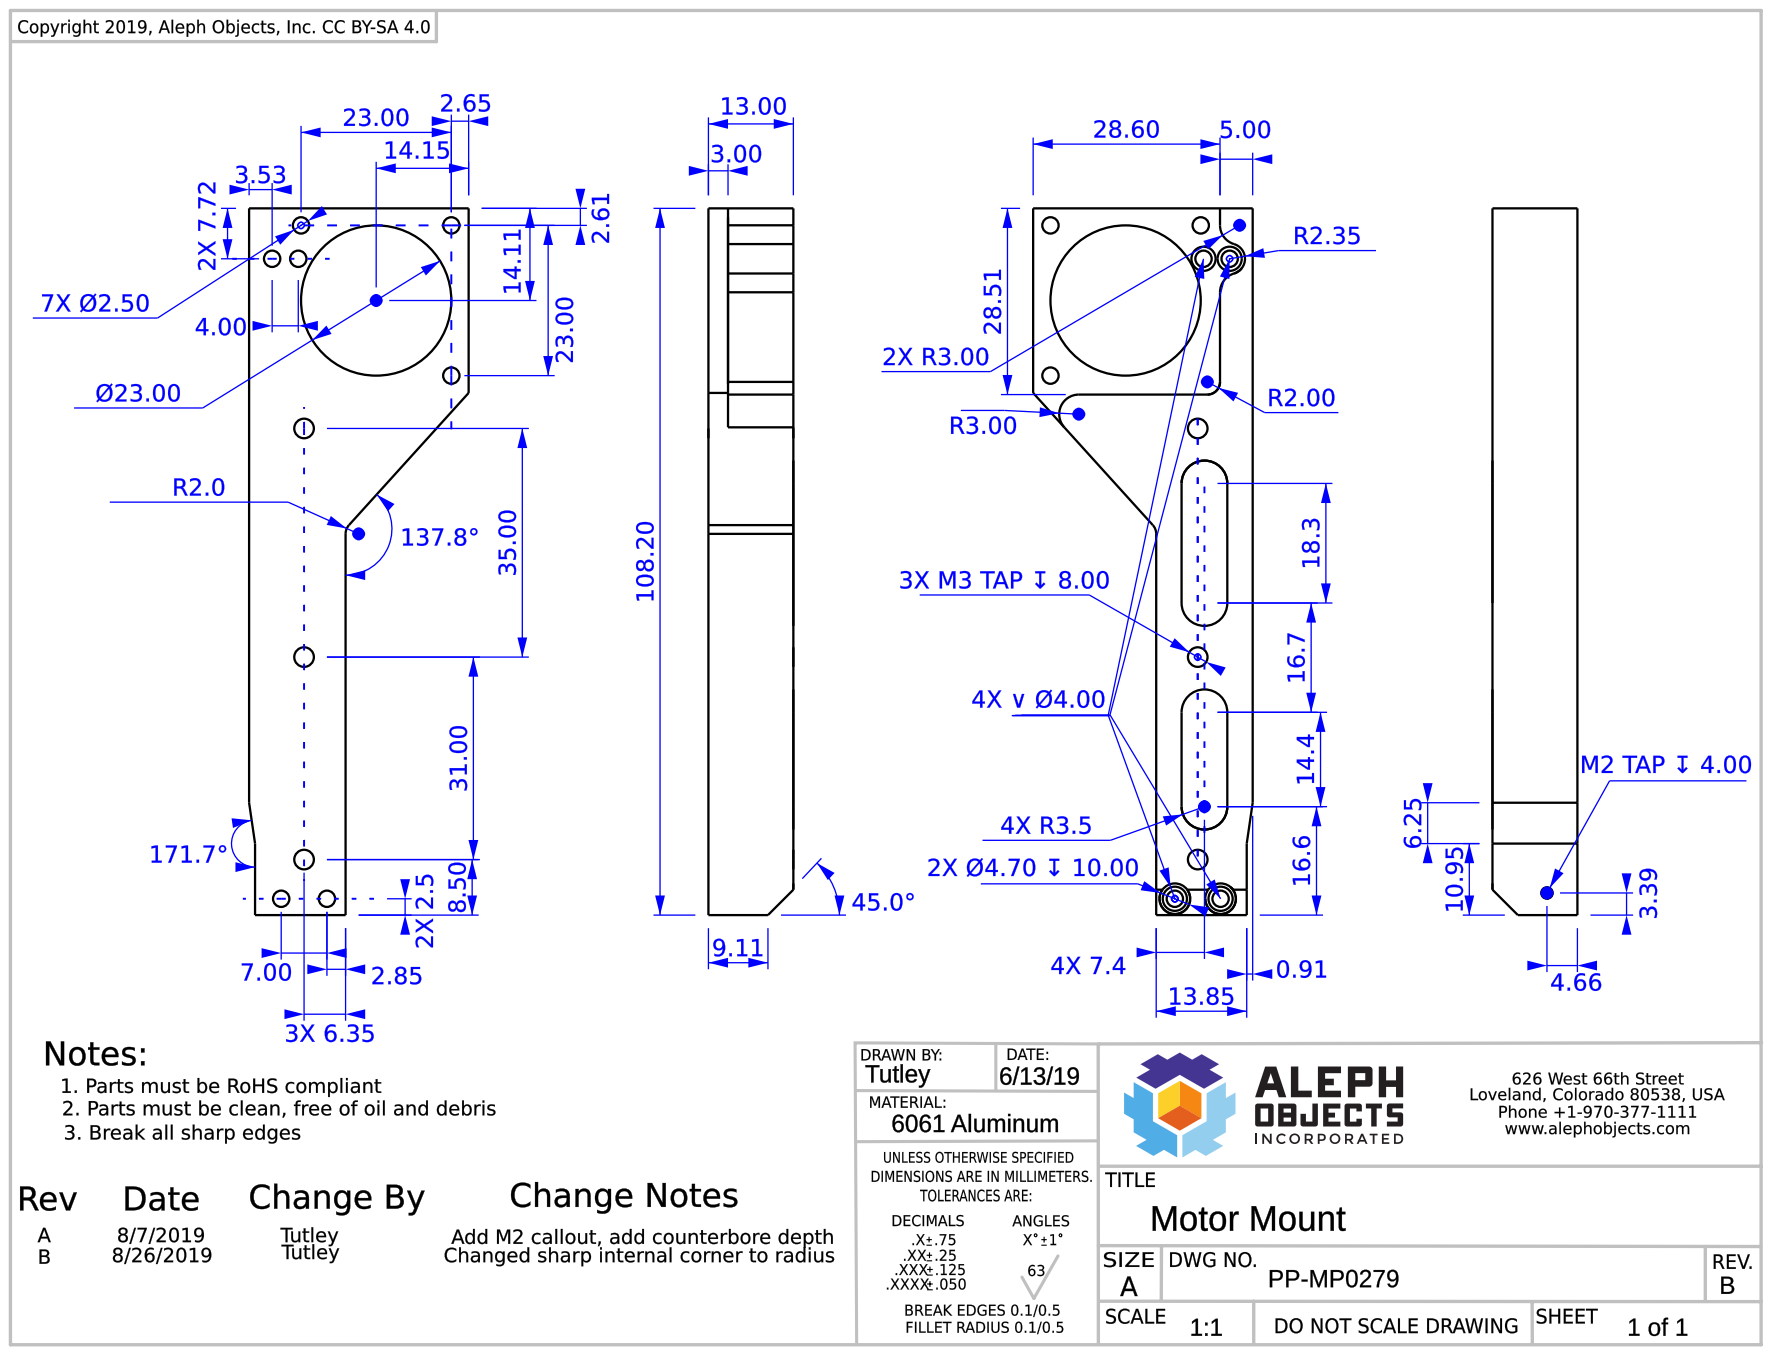
[picture p162: page 1]
