reprapperMC/kangaroopaw/production_parts/tool_head/machined_parts/PP-MP0280_collar_mount_flange_revA.pdf

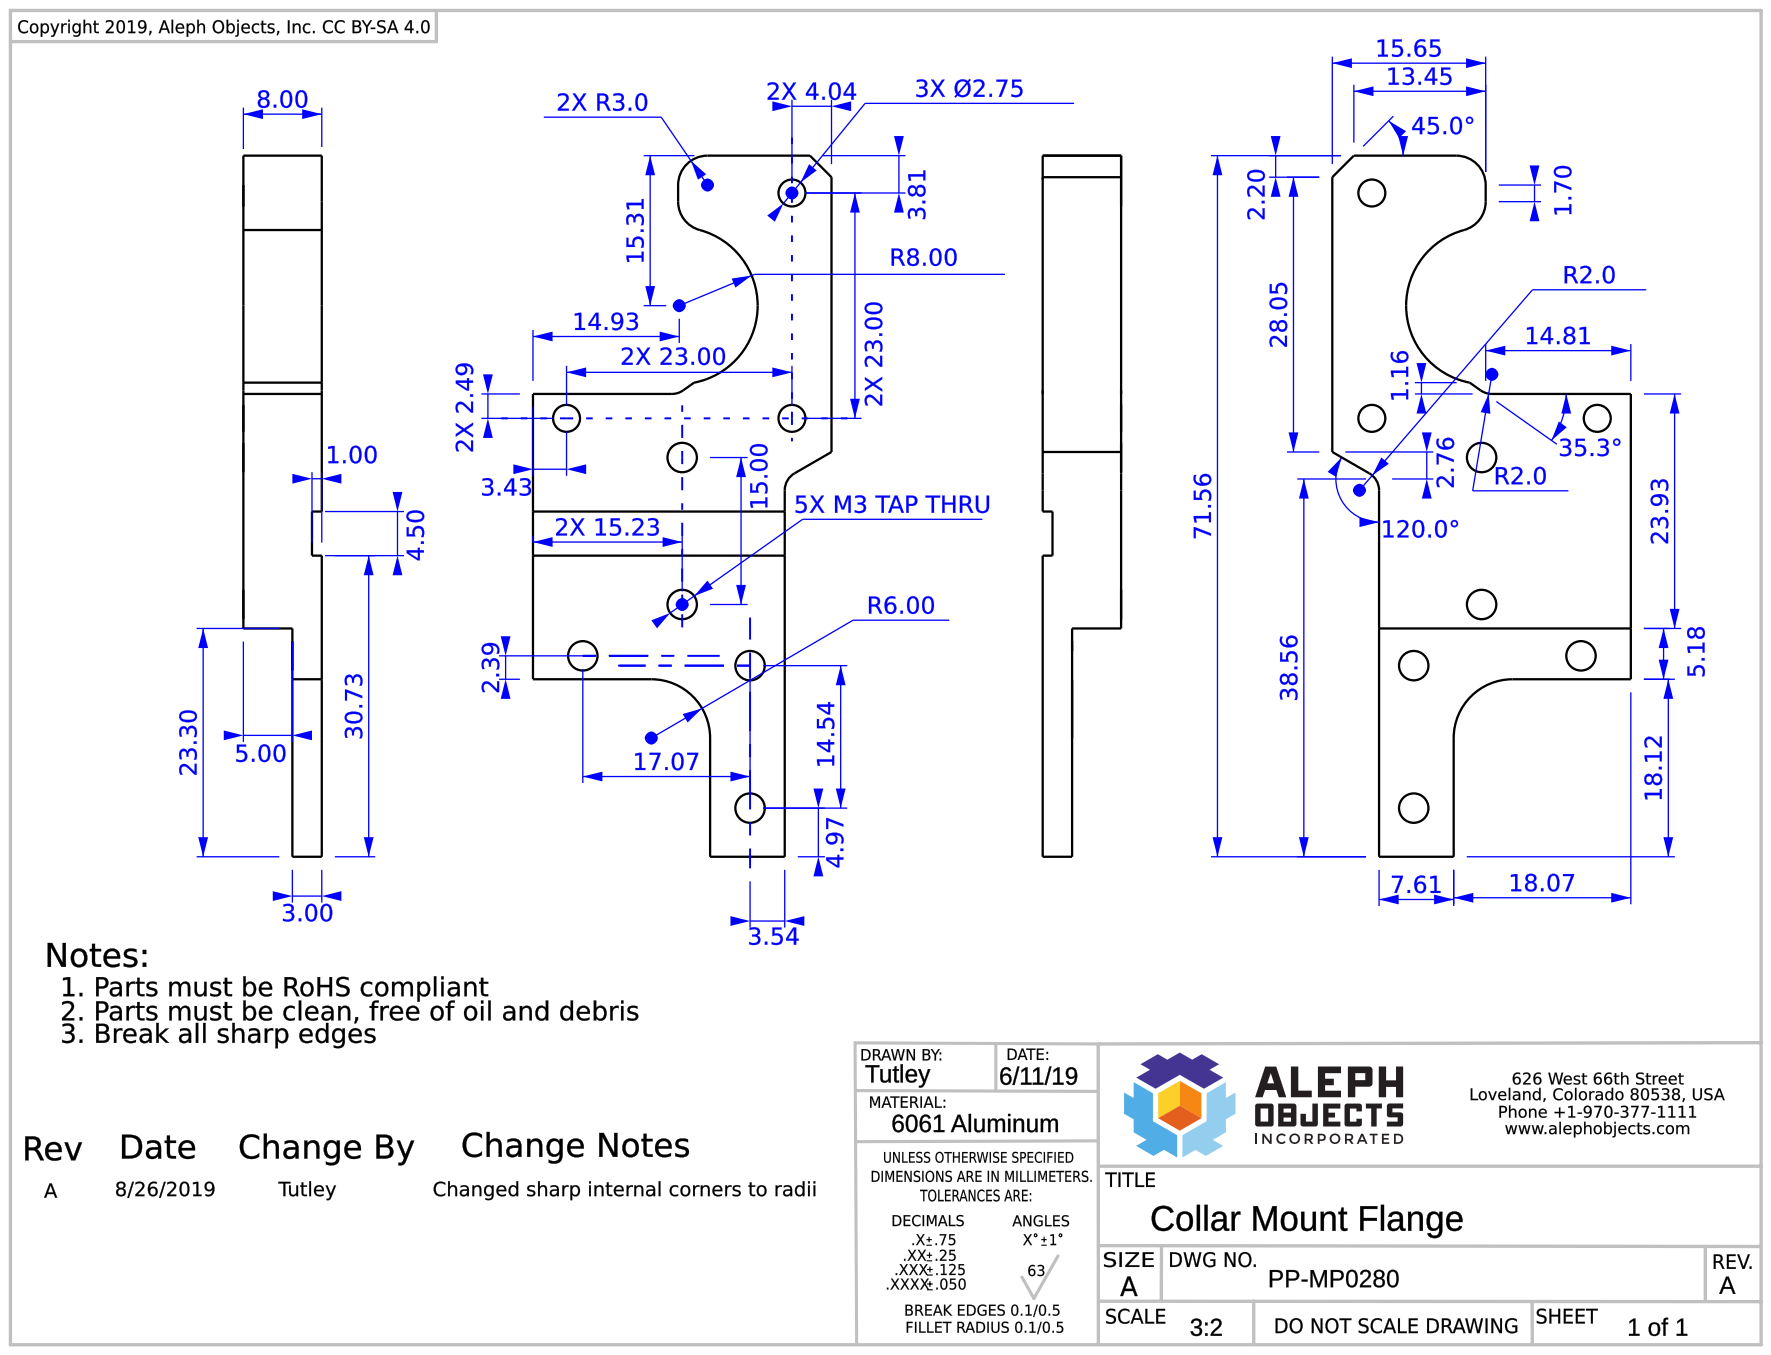
[picture p163: page 1]
