reprapperMC/kangaroopaw/production_parts/printed_parts/unthreaded_spacer/HD-MS0427_unthreaded_spacer.pdf

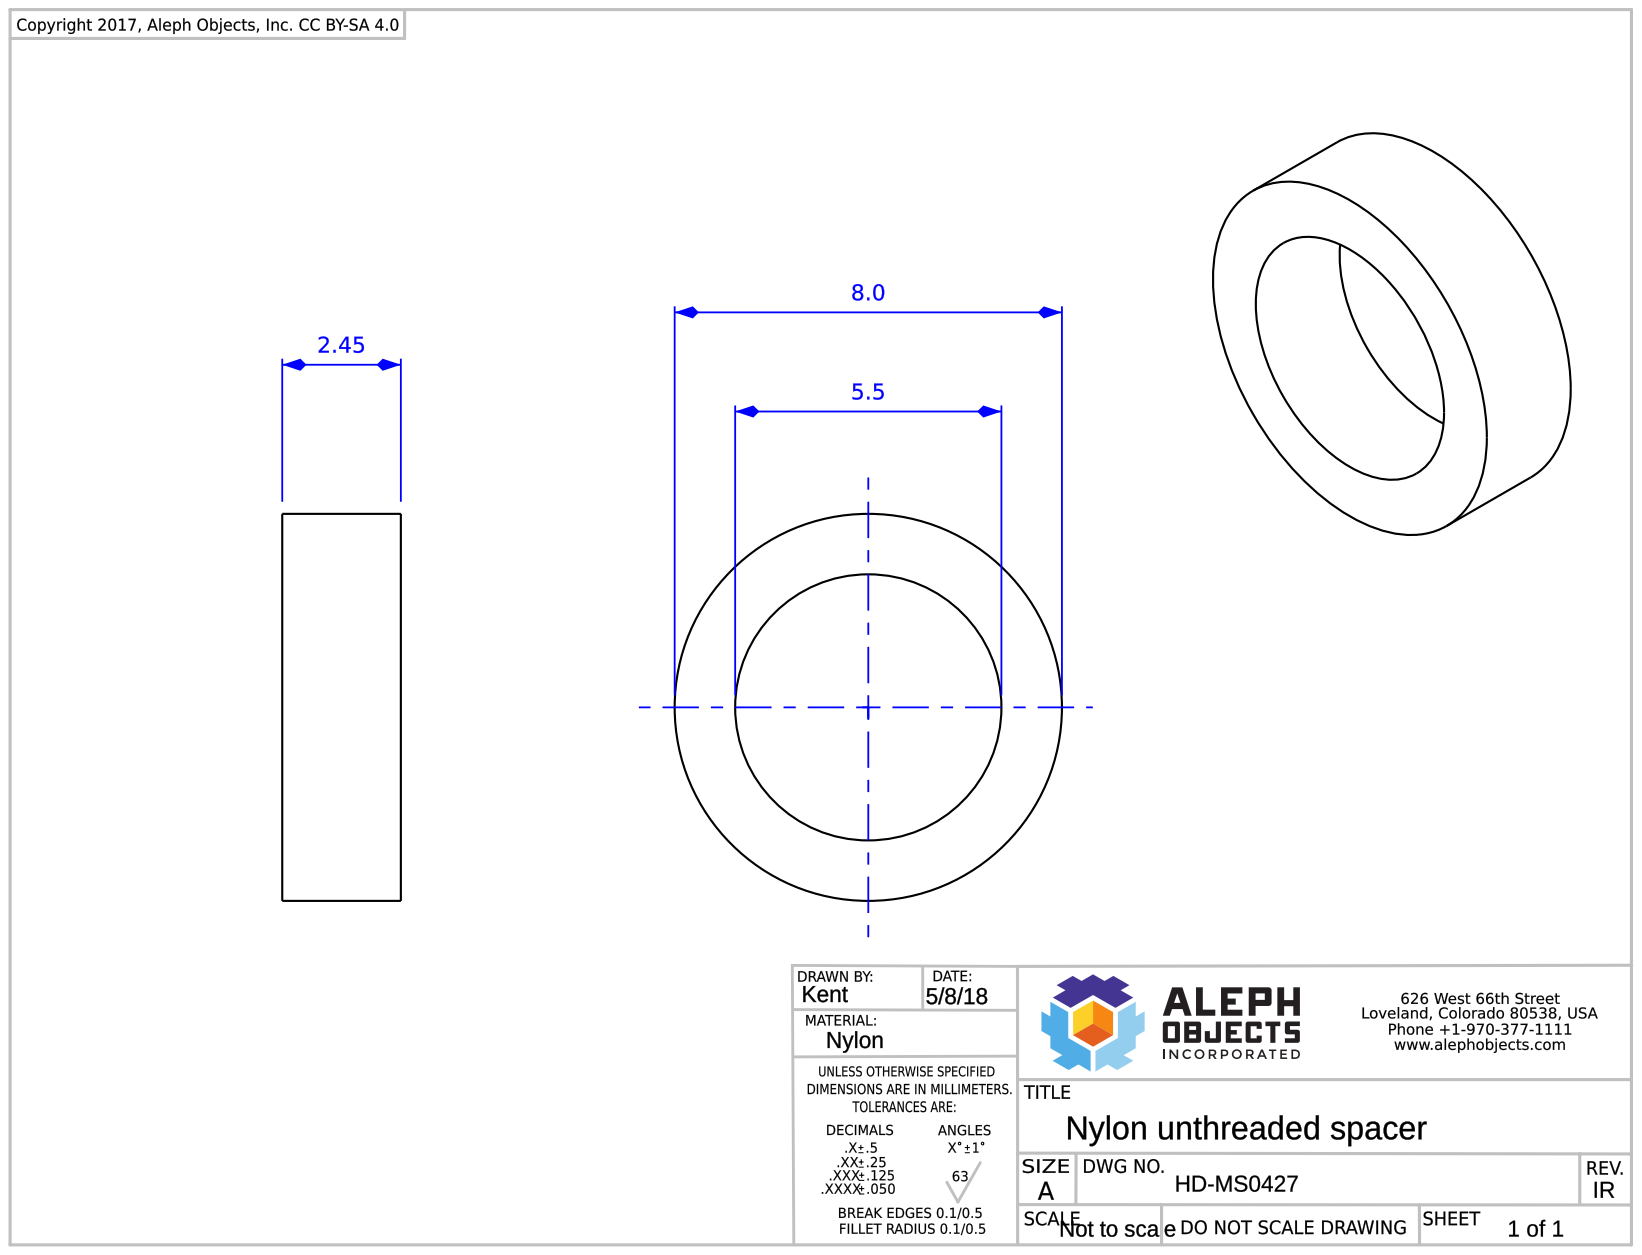
[picture p165: page 1]
