reprapperMC/kangaroopaw/production_parts/machined_parts/left_side/left-side-mini-white_PP-FP0170_revA.pdf

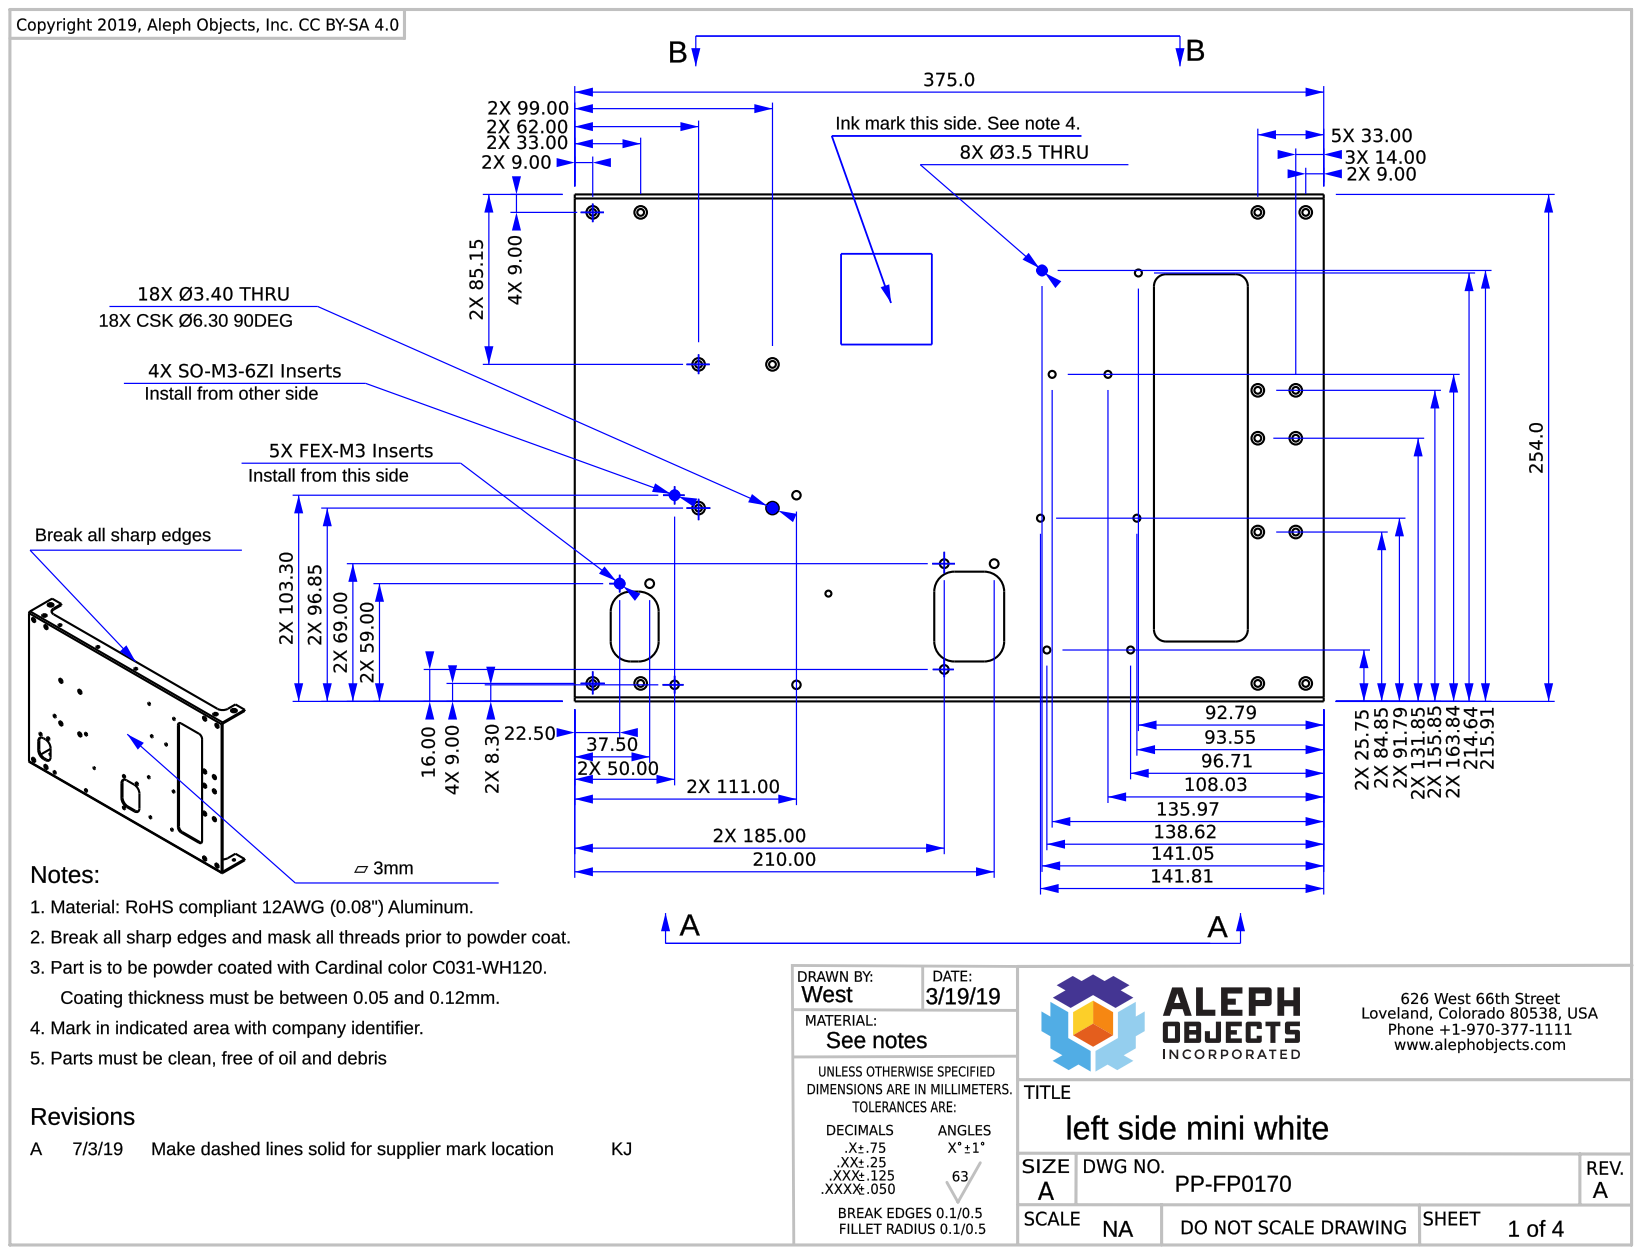
[picture p166: page 1]

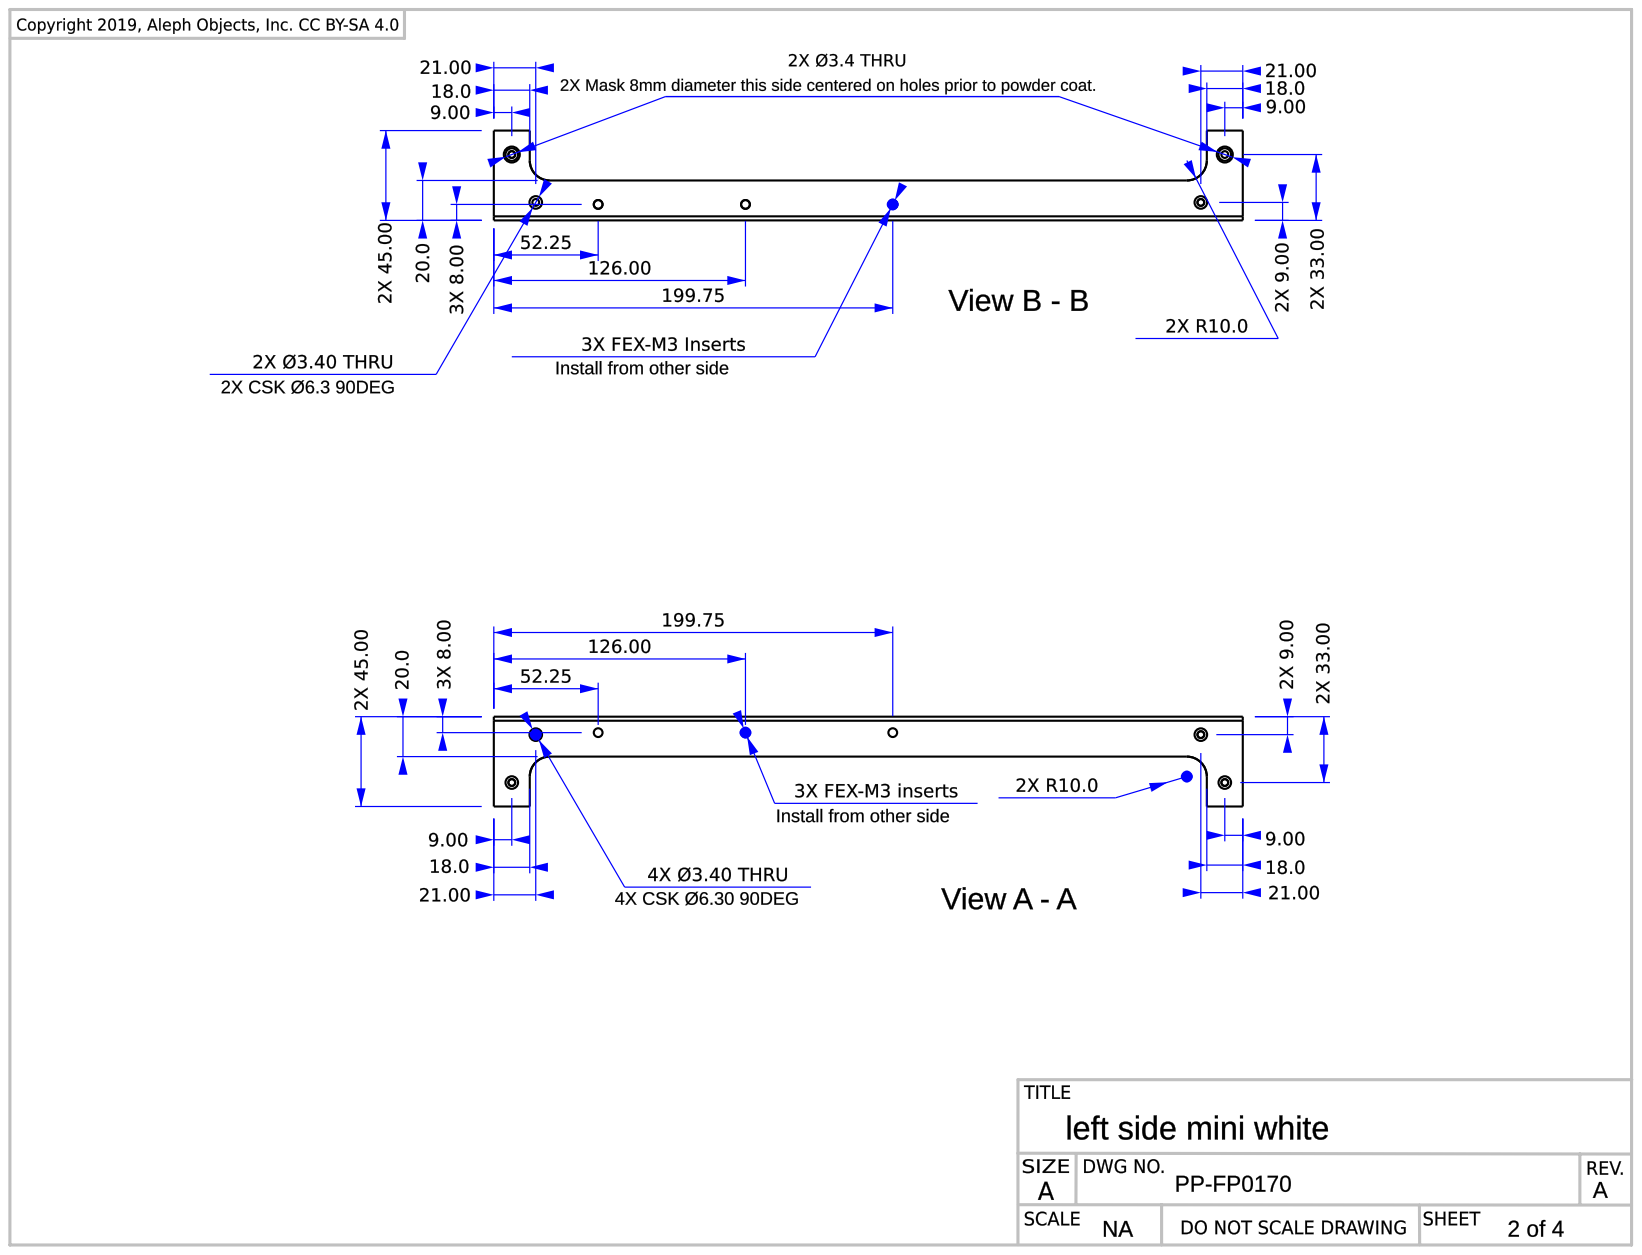
[picture p167: page 2]

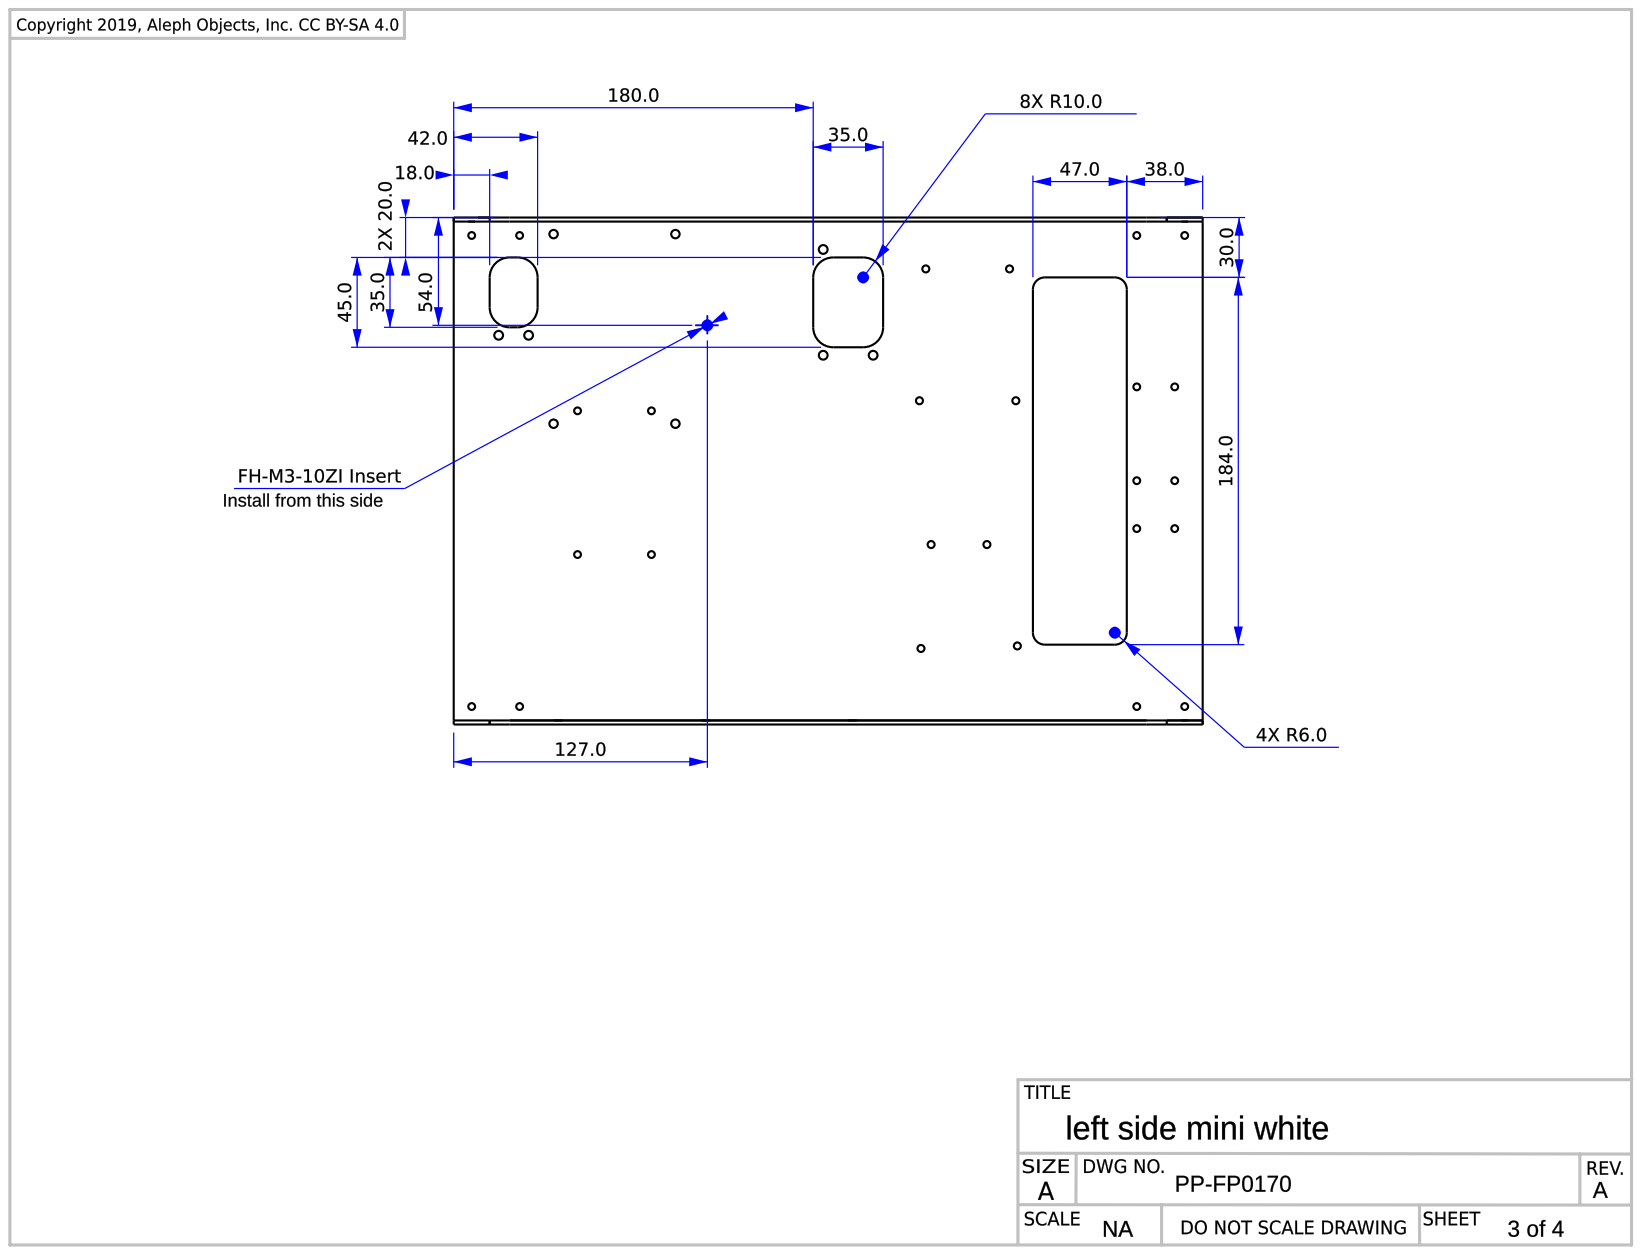
[picture p168: page 3]

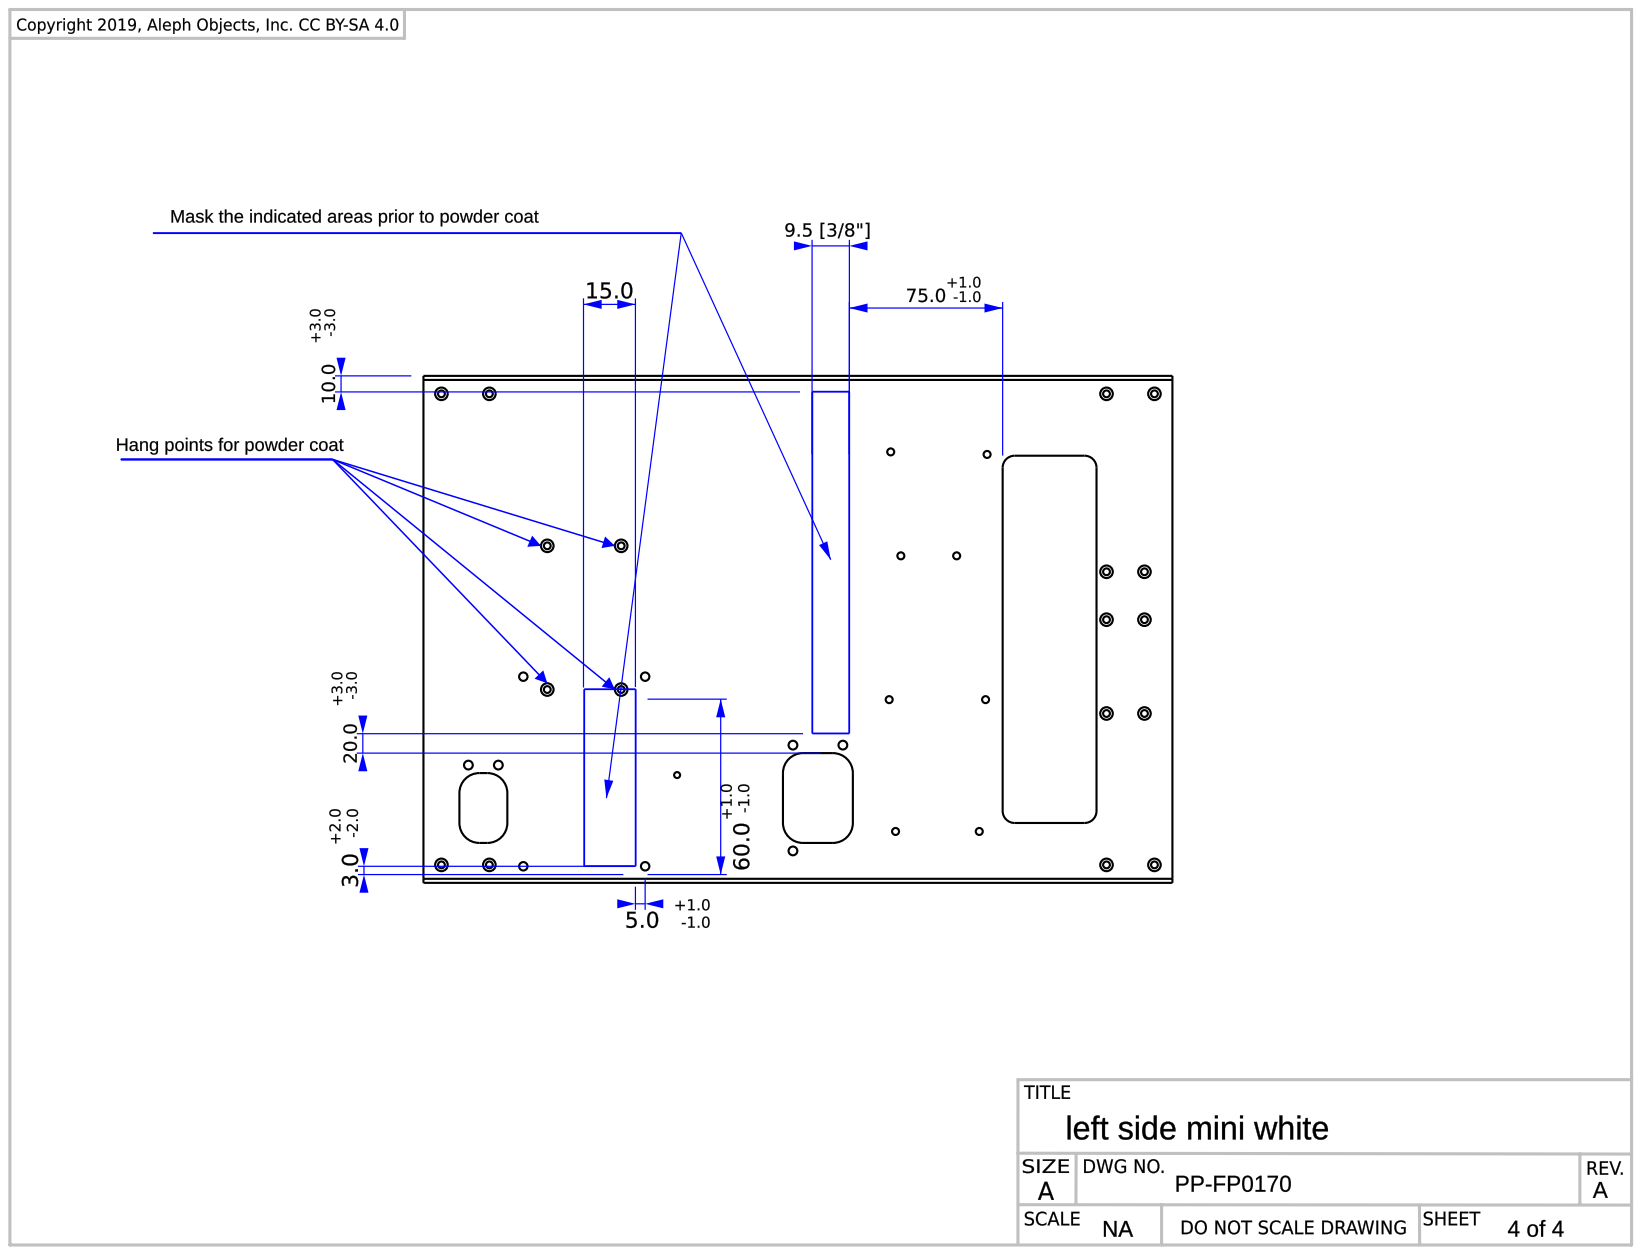
[picture p169: page 4]
