reprapperMC/kangaroopaw/production_parts/machined_parts/bed_mount_plate/bed-mount-plate-mini-white_PP-FP0171_revB.pdf

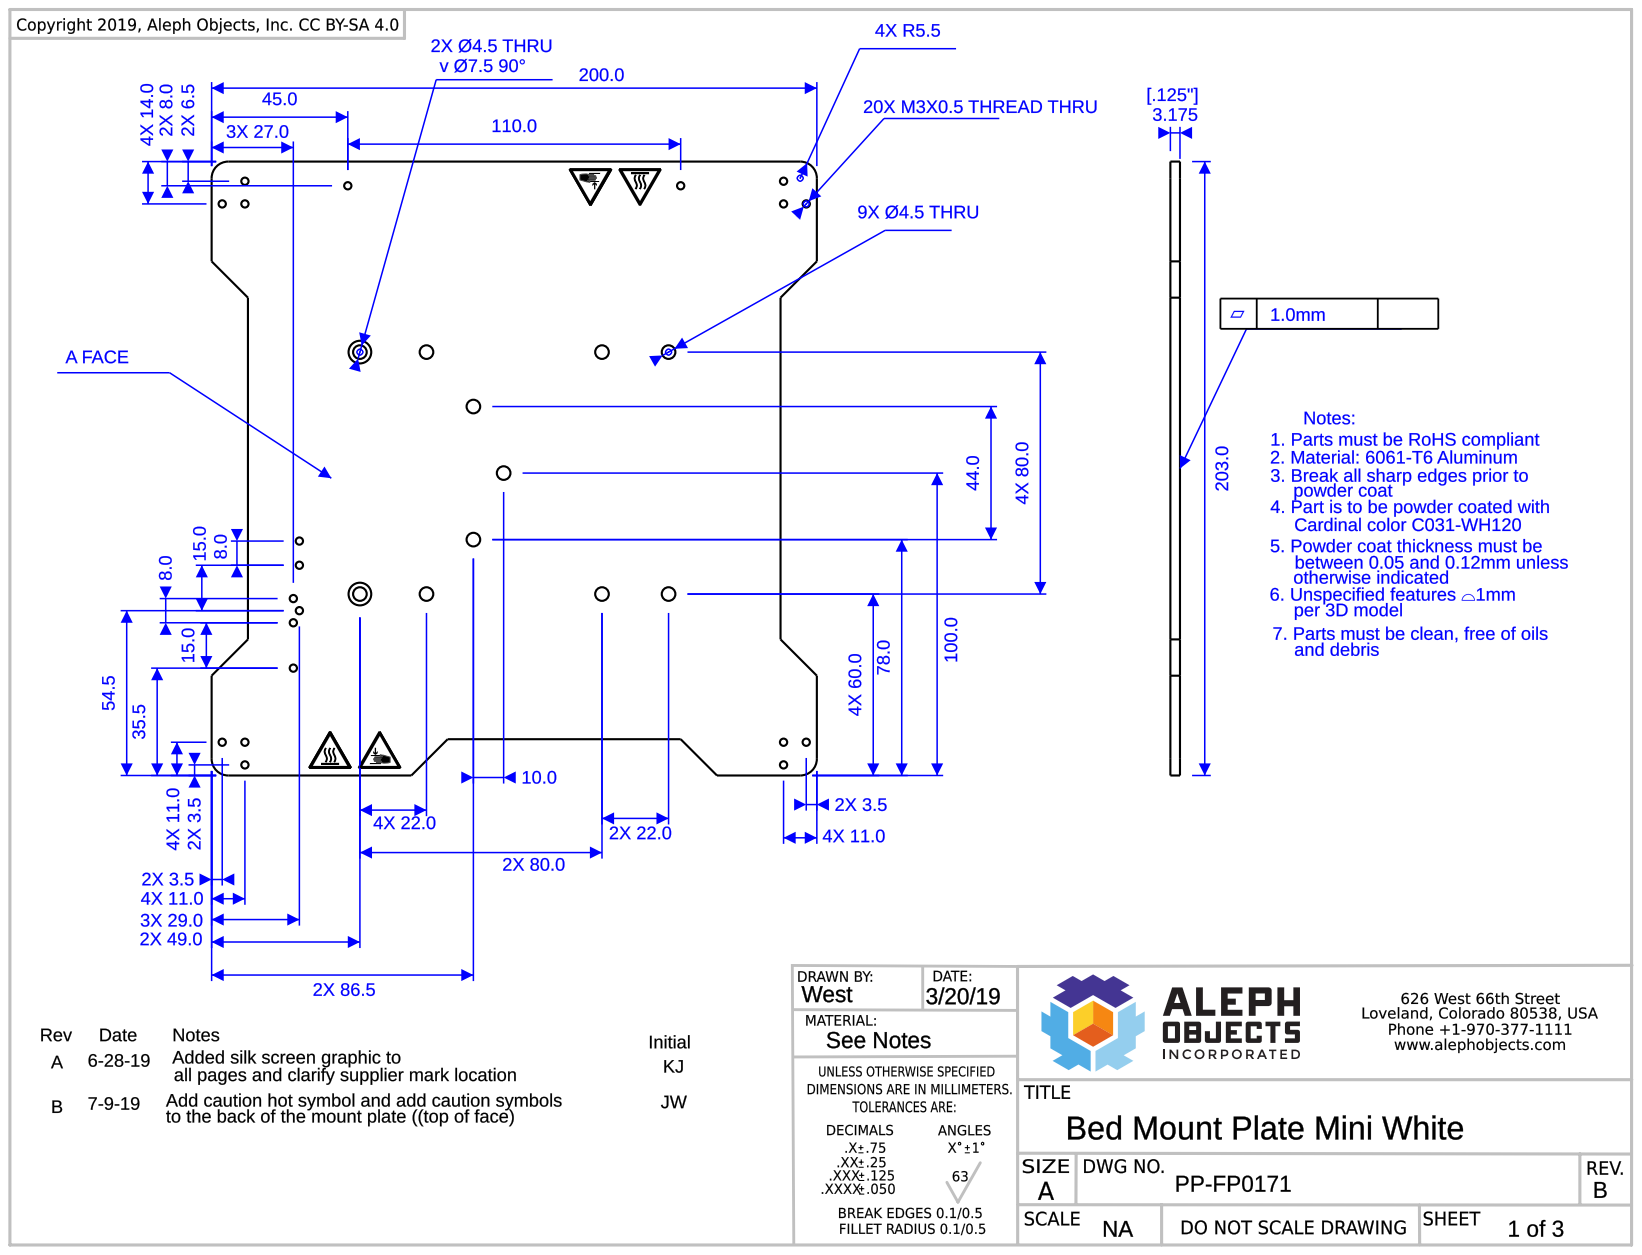
[picture p170: page 1]

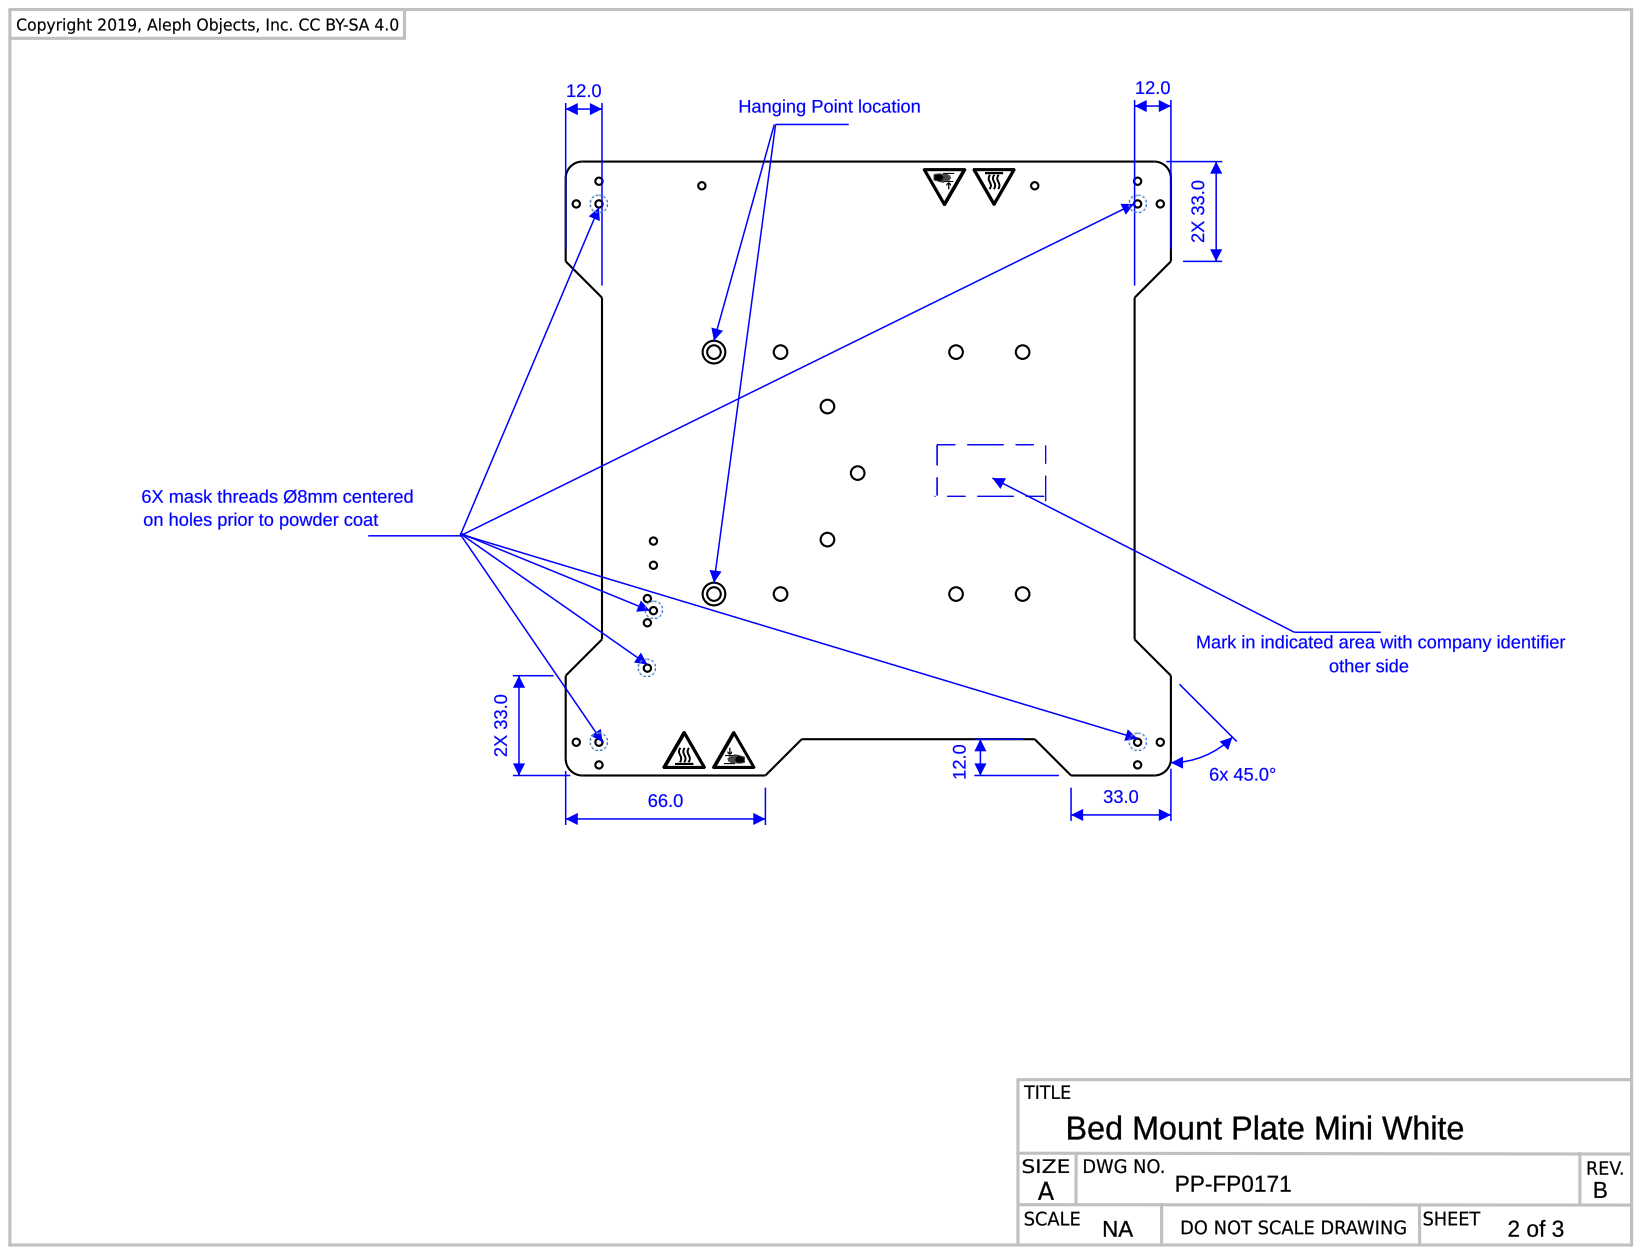
[picture p171: page 2]

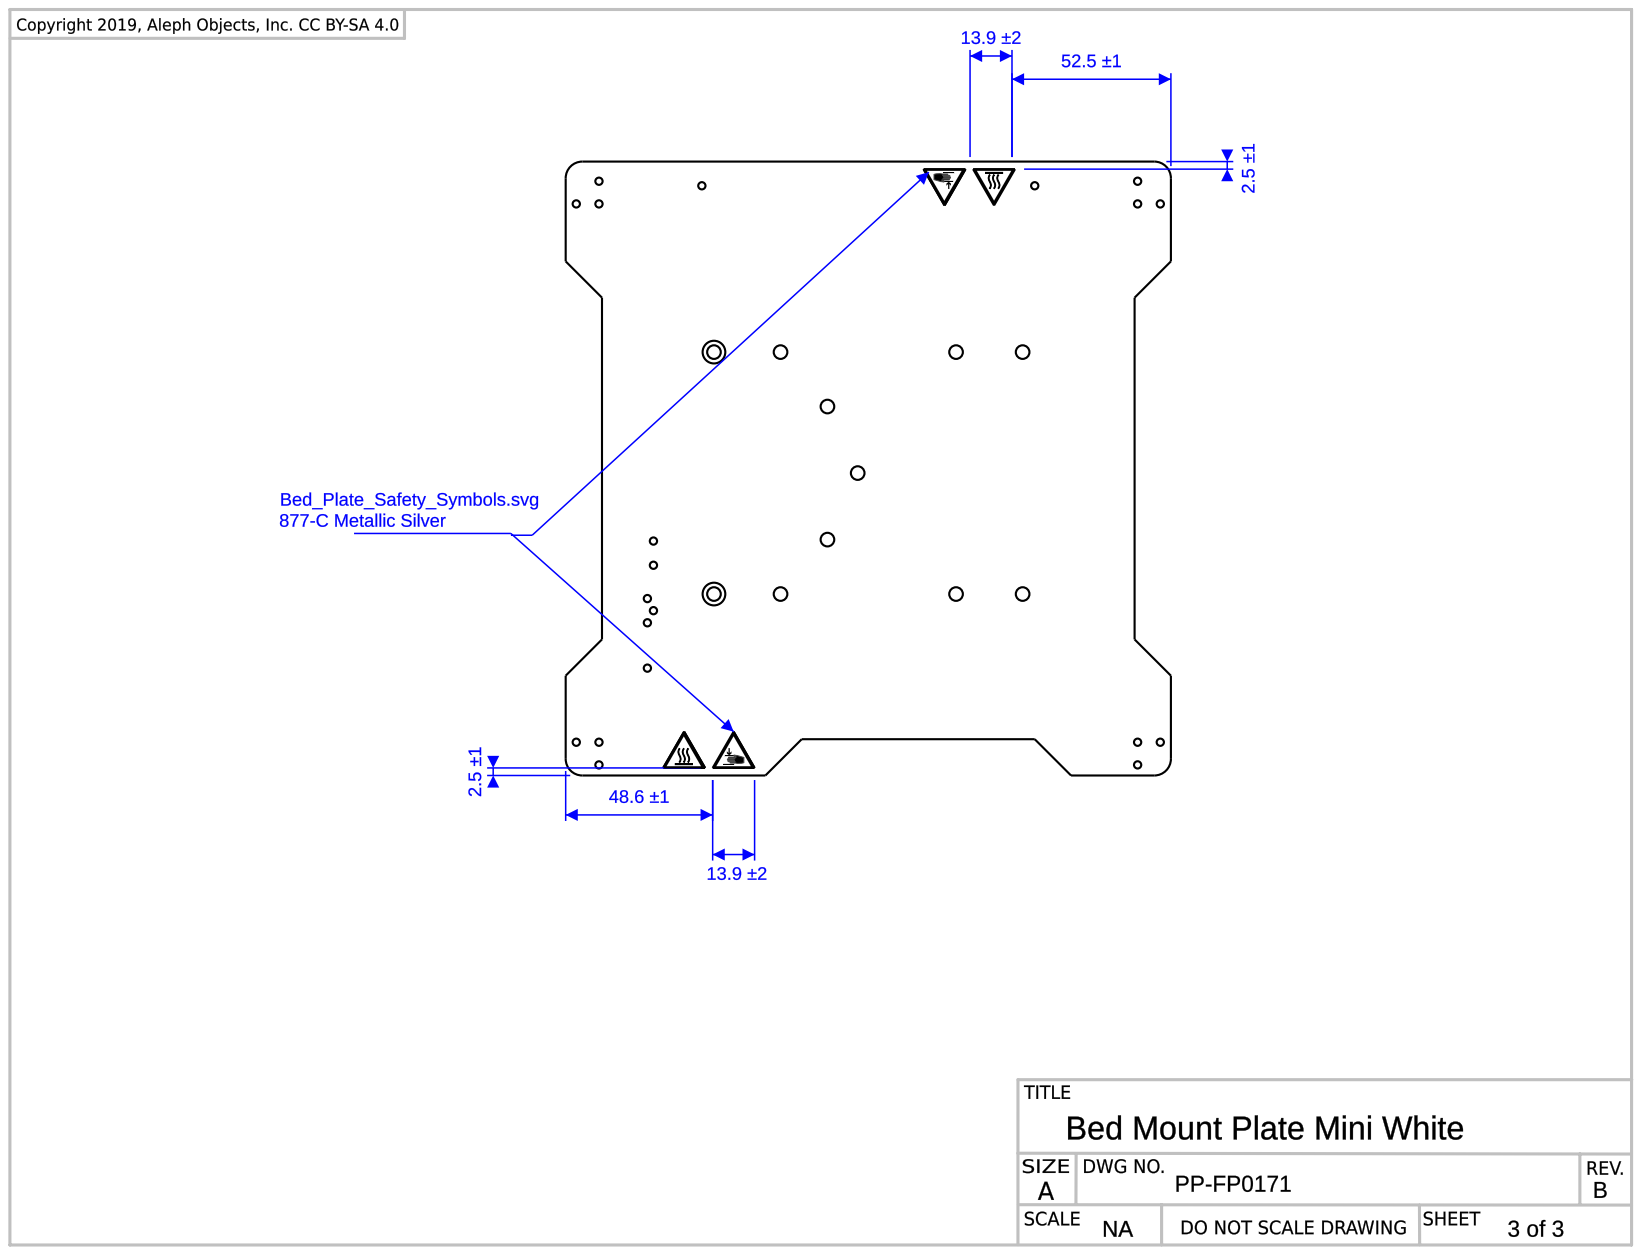
[picture p172: page 3]
