reprapperMC/kangaroopaw/production_parts/machined_parts/bottom_plate_mini/bottom-plate-mini-white_PP-MP0258_revA.pdf

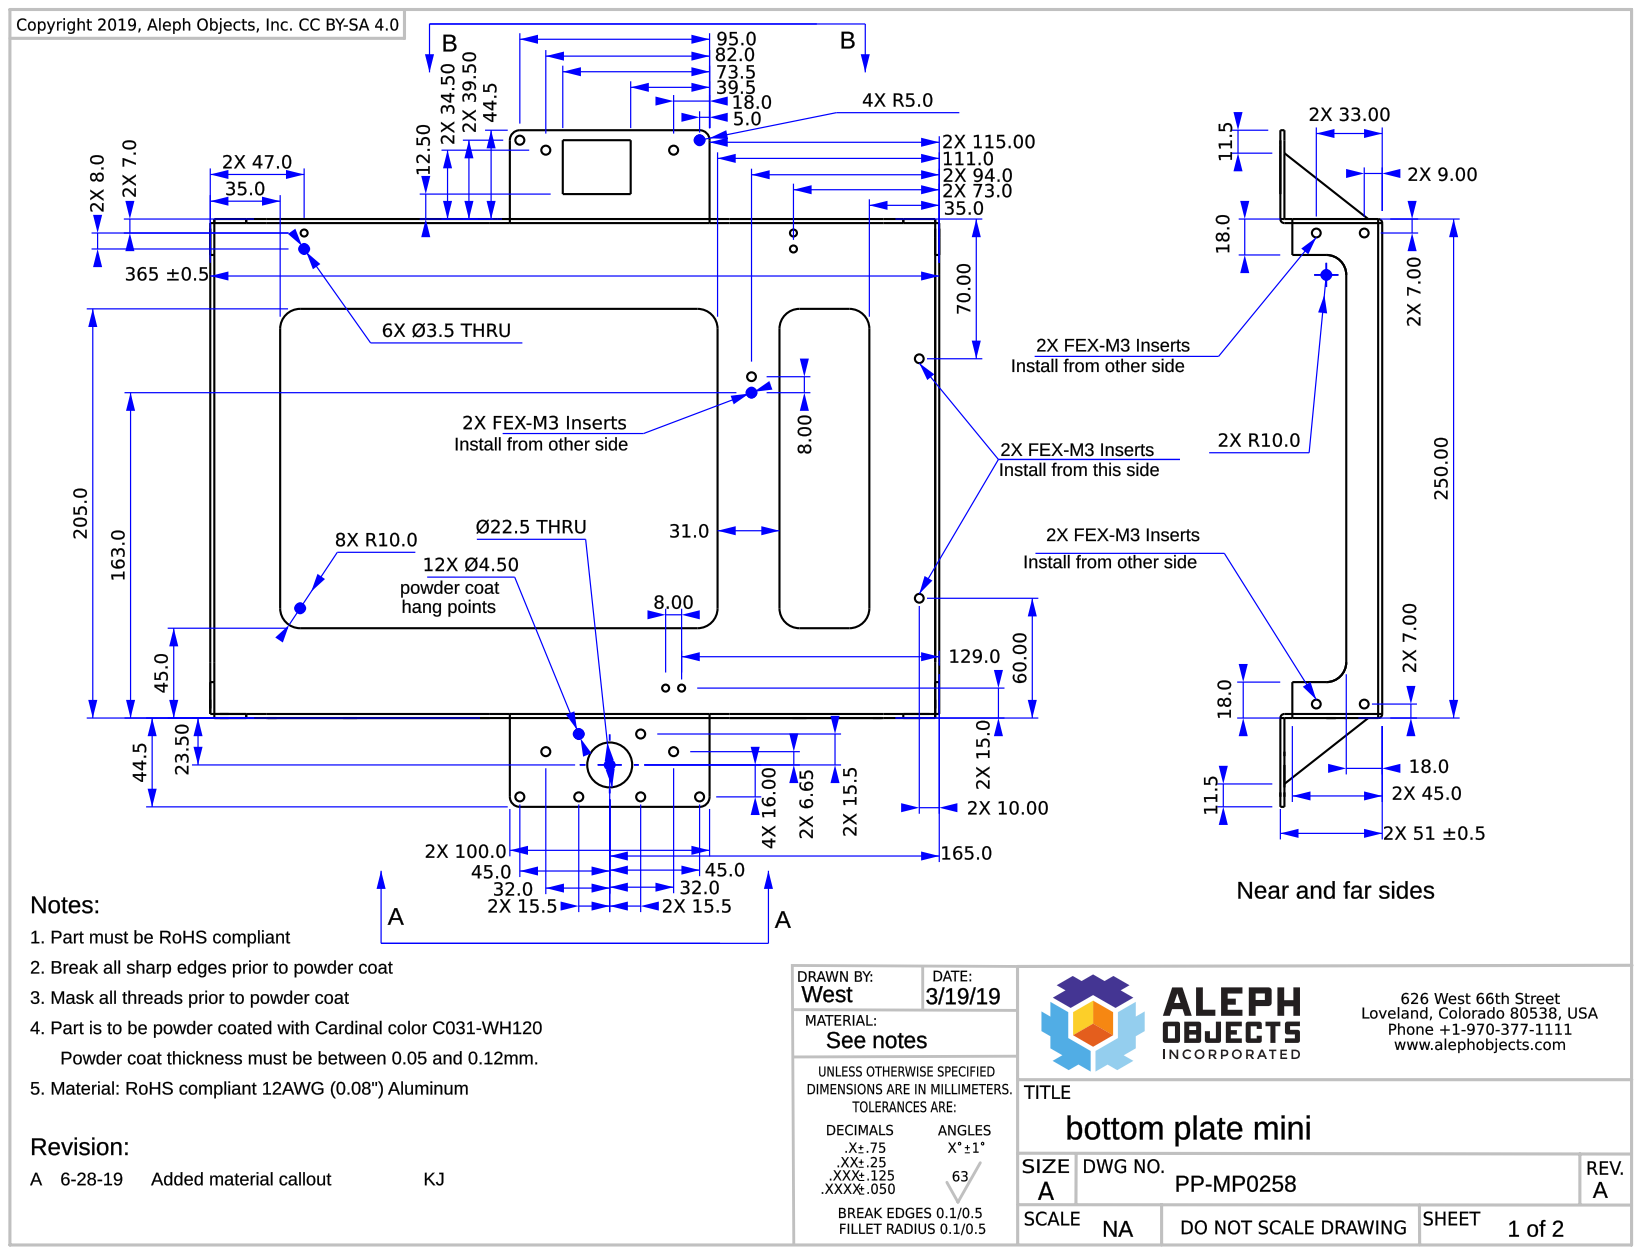
[picture p173: page 1]

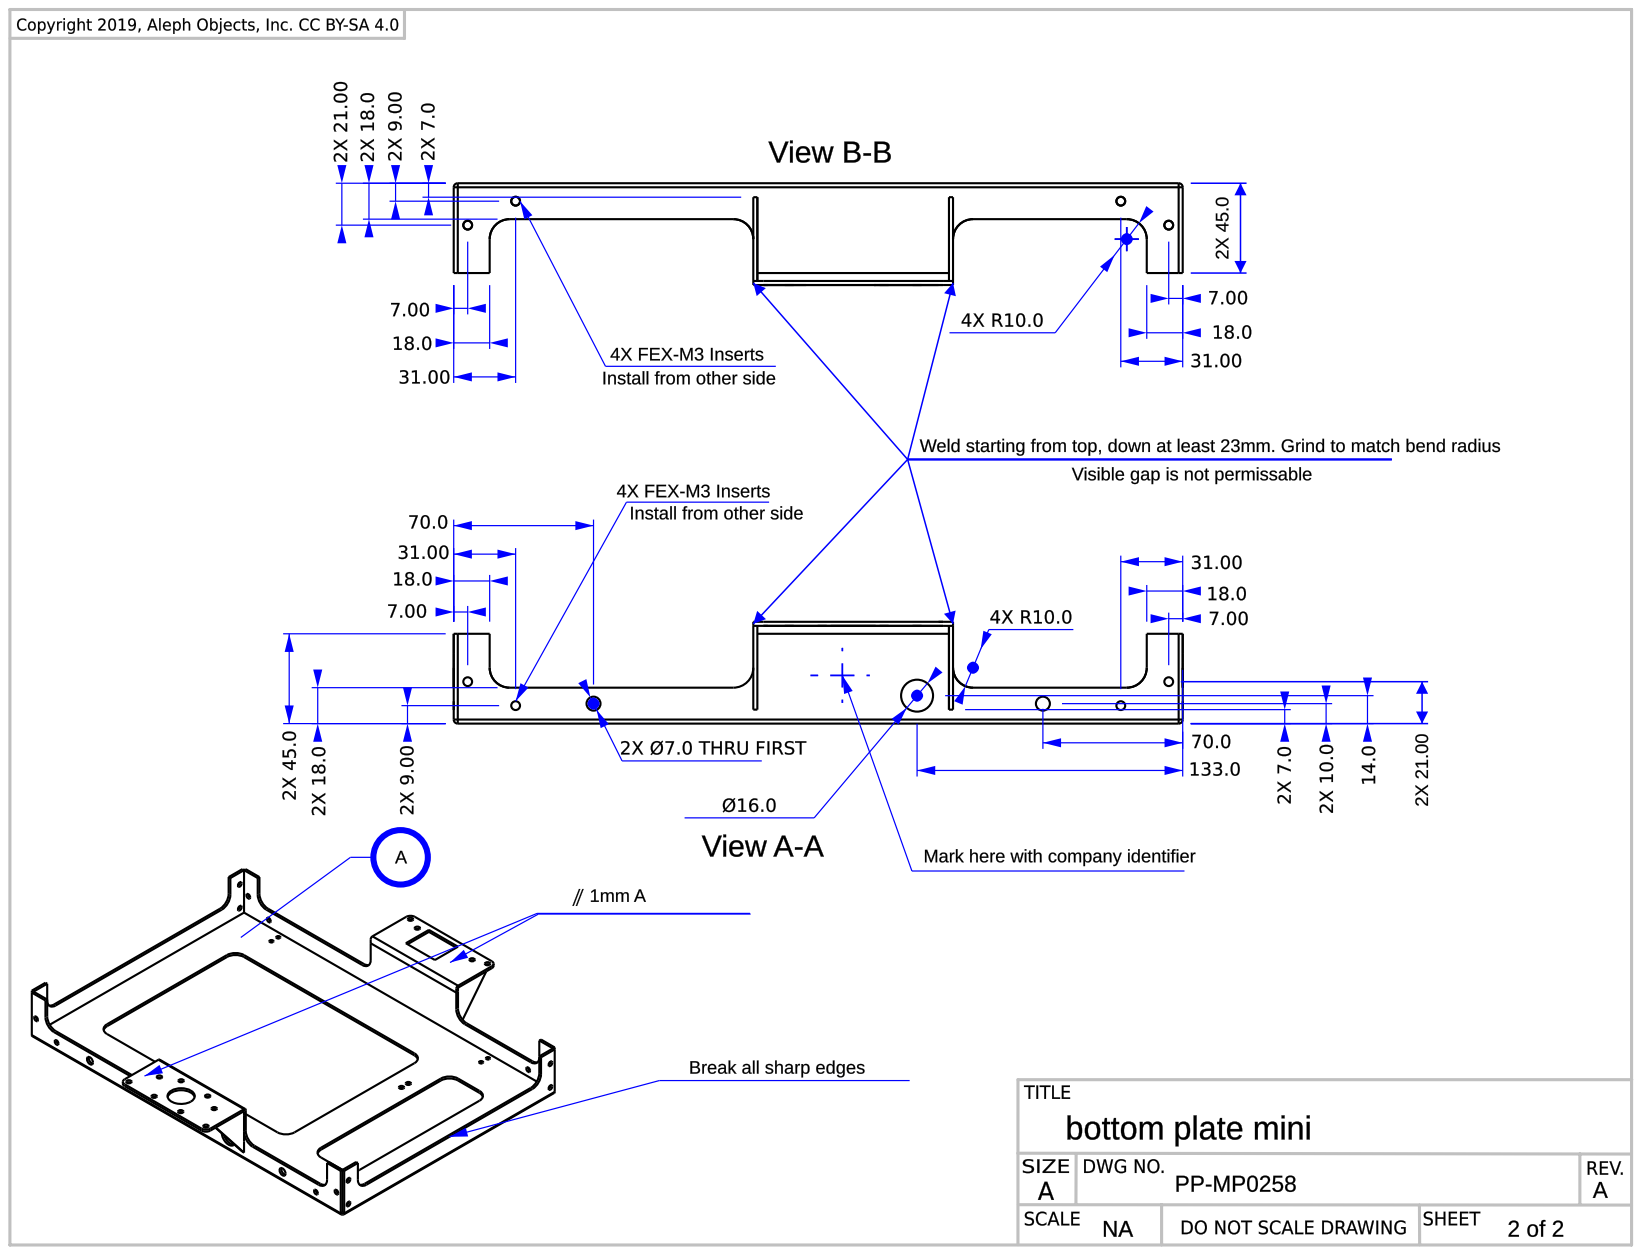
[picture p174: page 2]
