reprapperMC/kangaroopaw/production_parts/tool_head/machined_parts/PP-MP0277_upper_bearing_holder.pdf

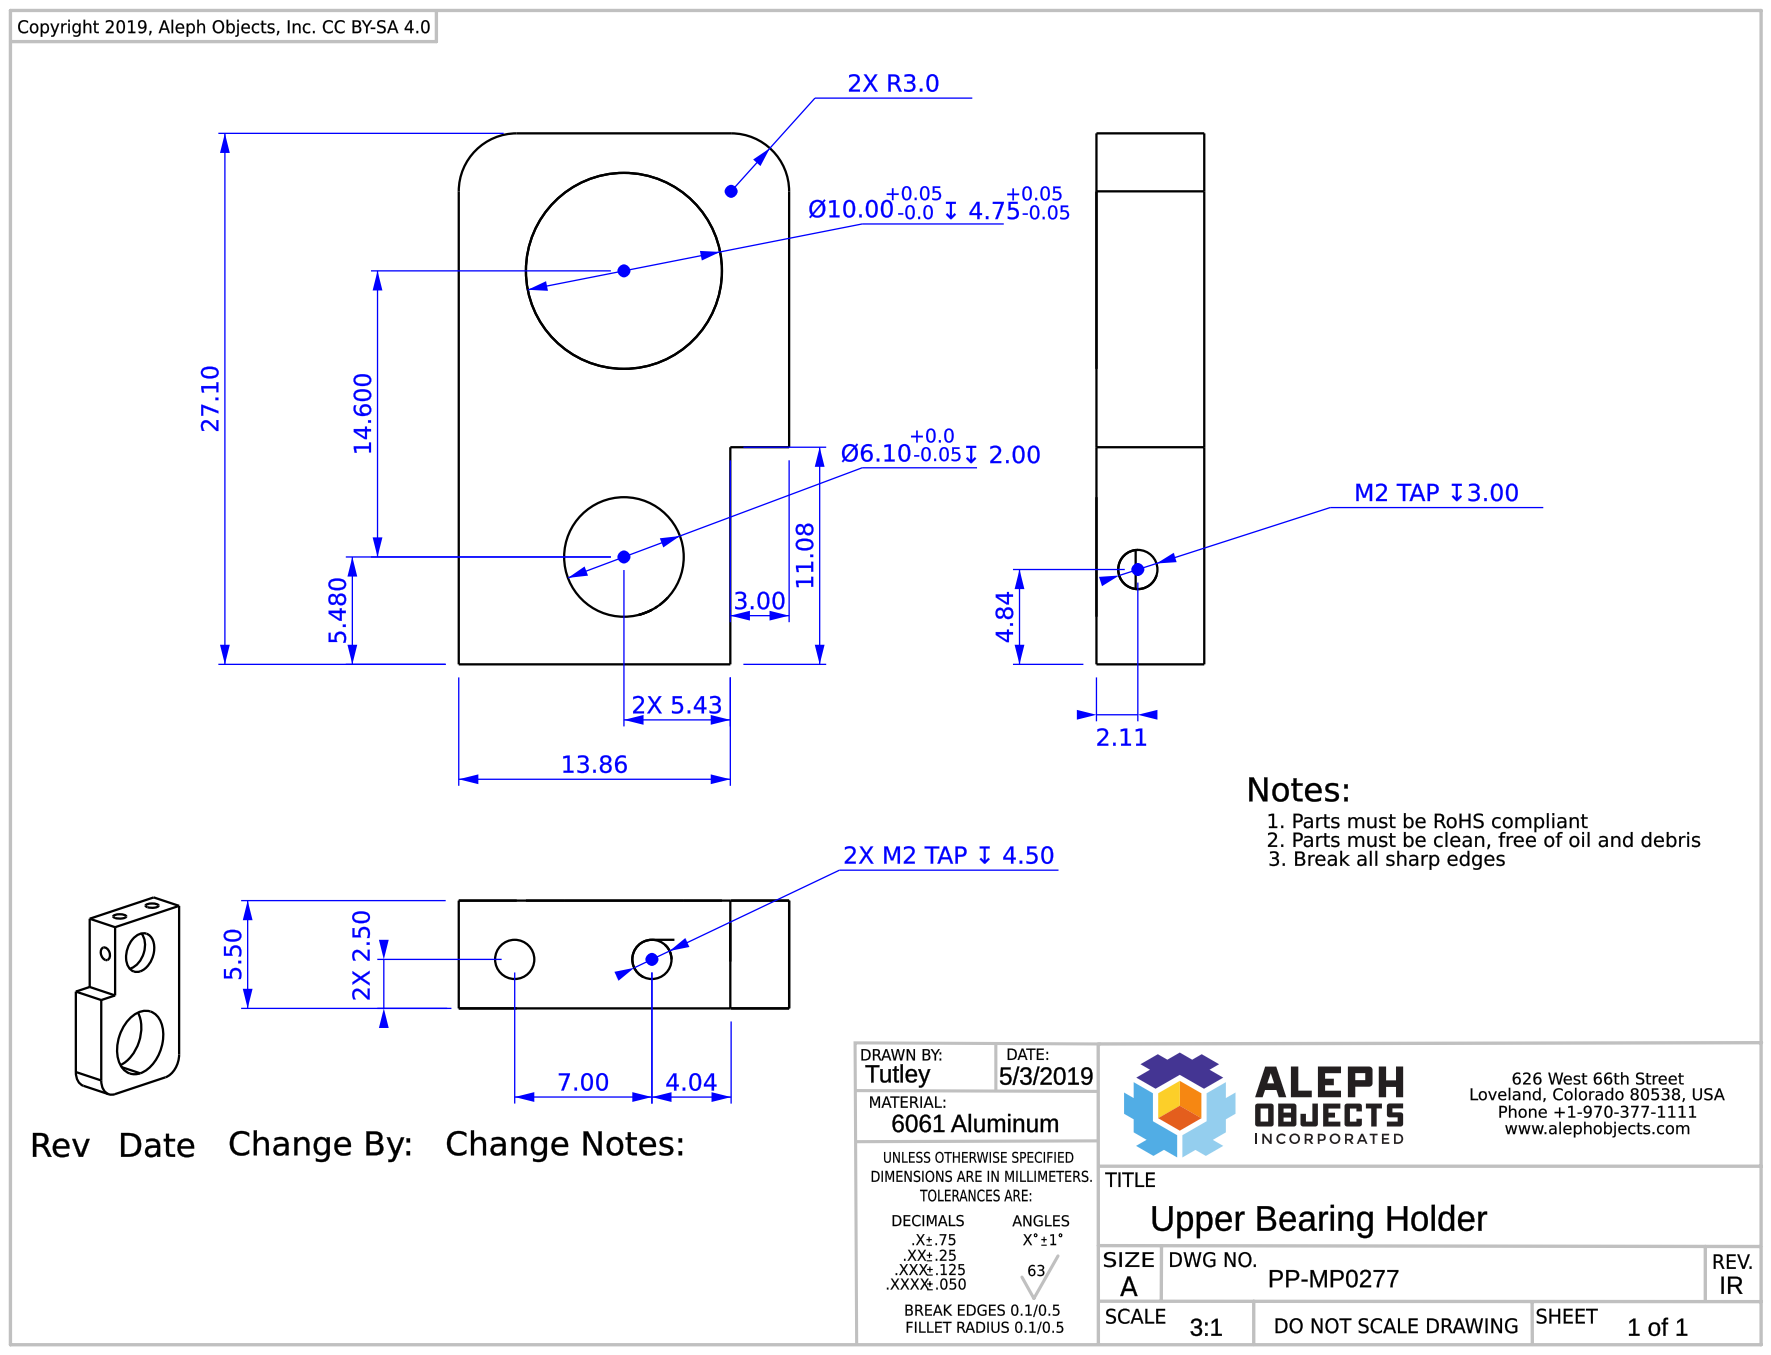
[picture p175: page 1]
