reprapperMC/kangaroopaw/production_parts/tool_head/machined_parts/PP-MP0278_lower_bearing_holder.pdf

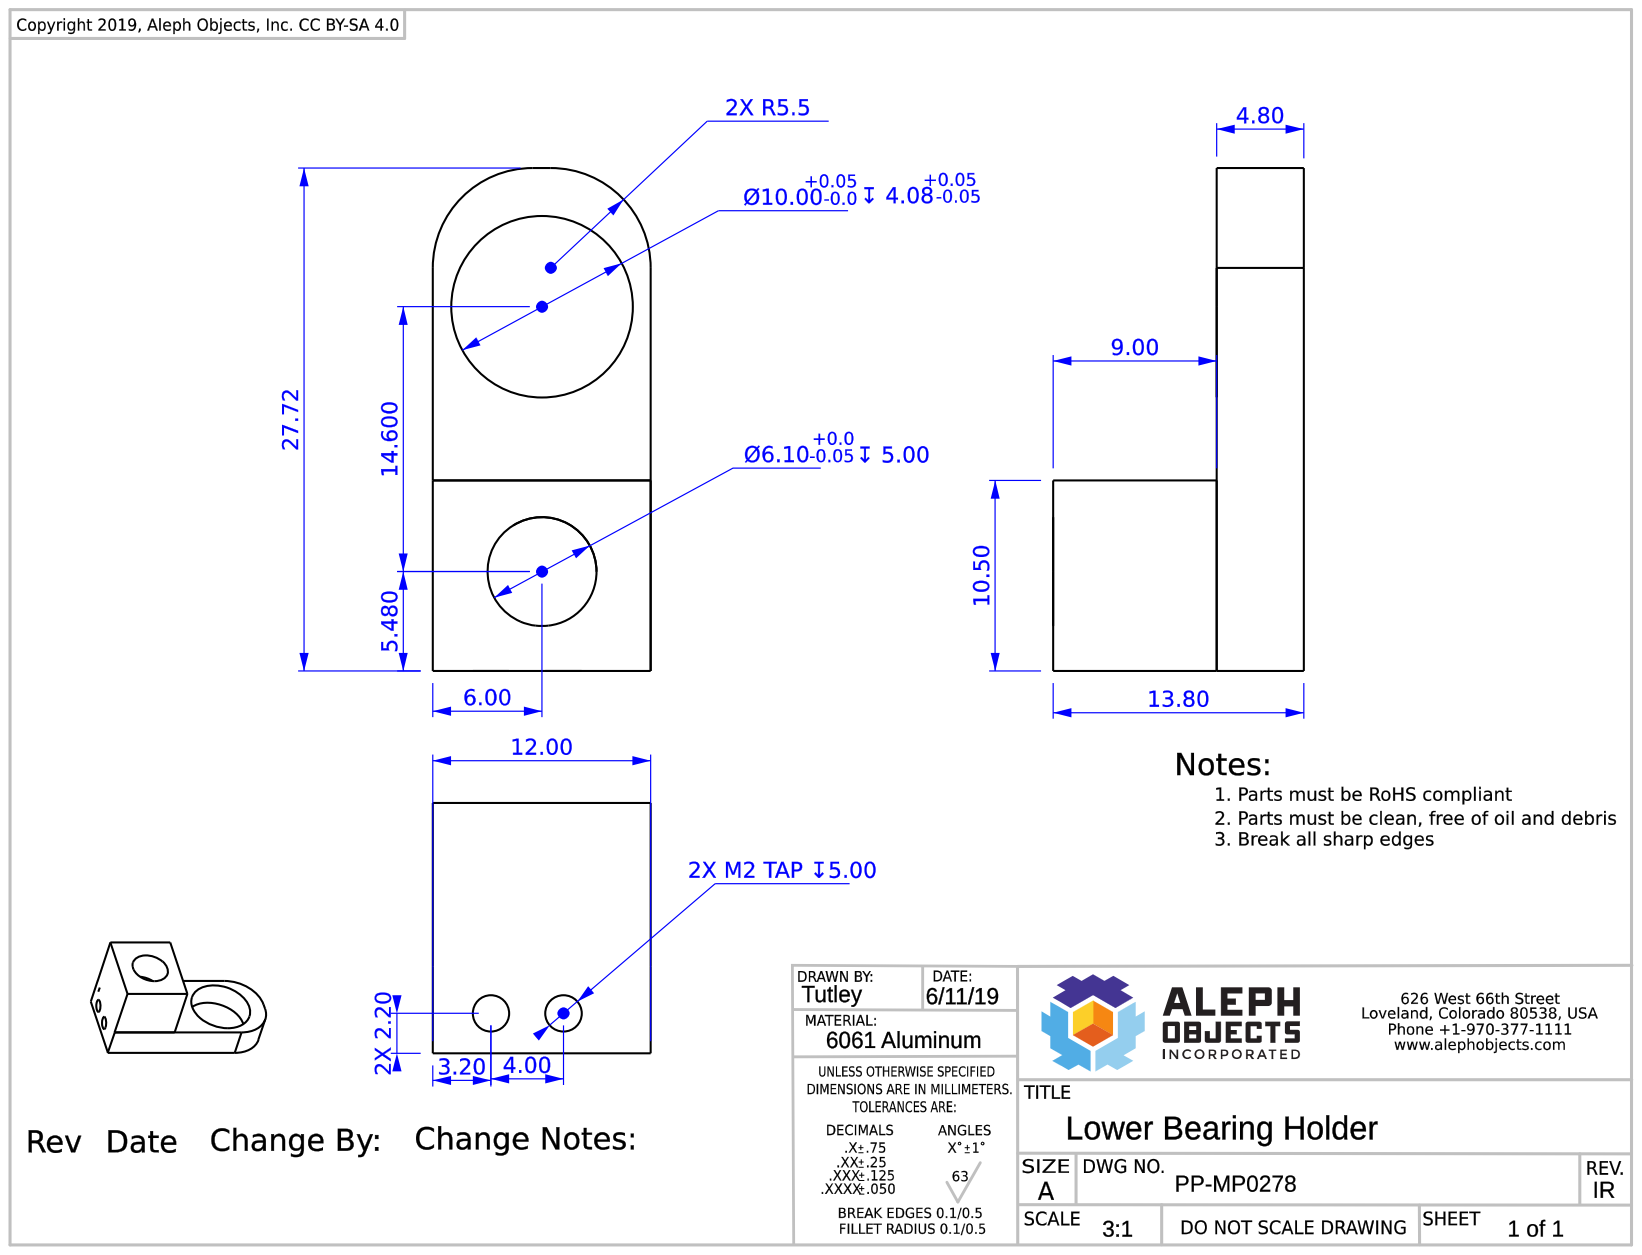
[picture p176: page 1]
