reprapperMC/kangaroopaw/production_parts/machined_parts/blank_dish_plate/PP-FP0185_blank_dish_plate.pdf

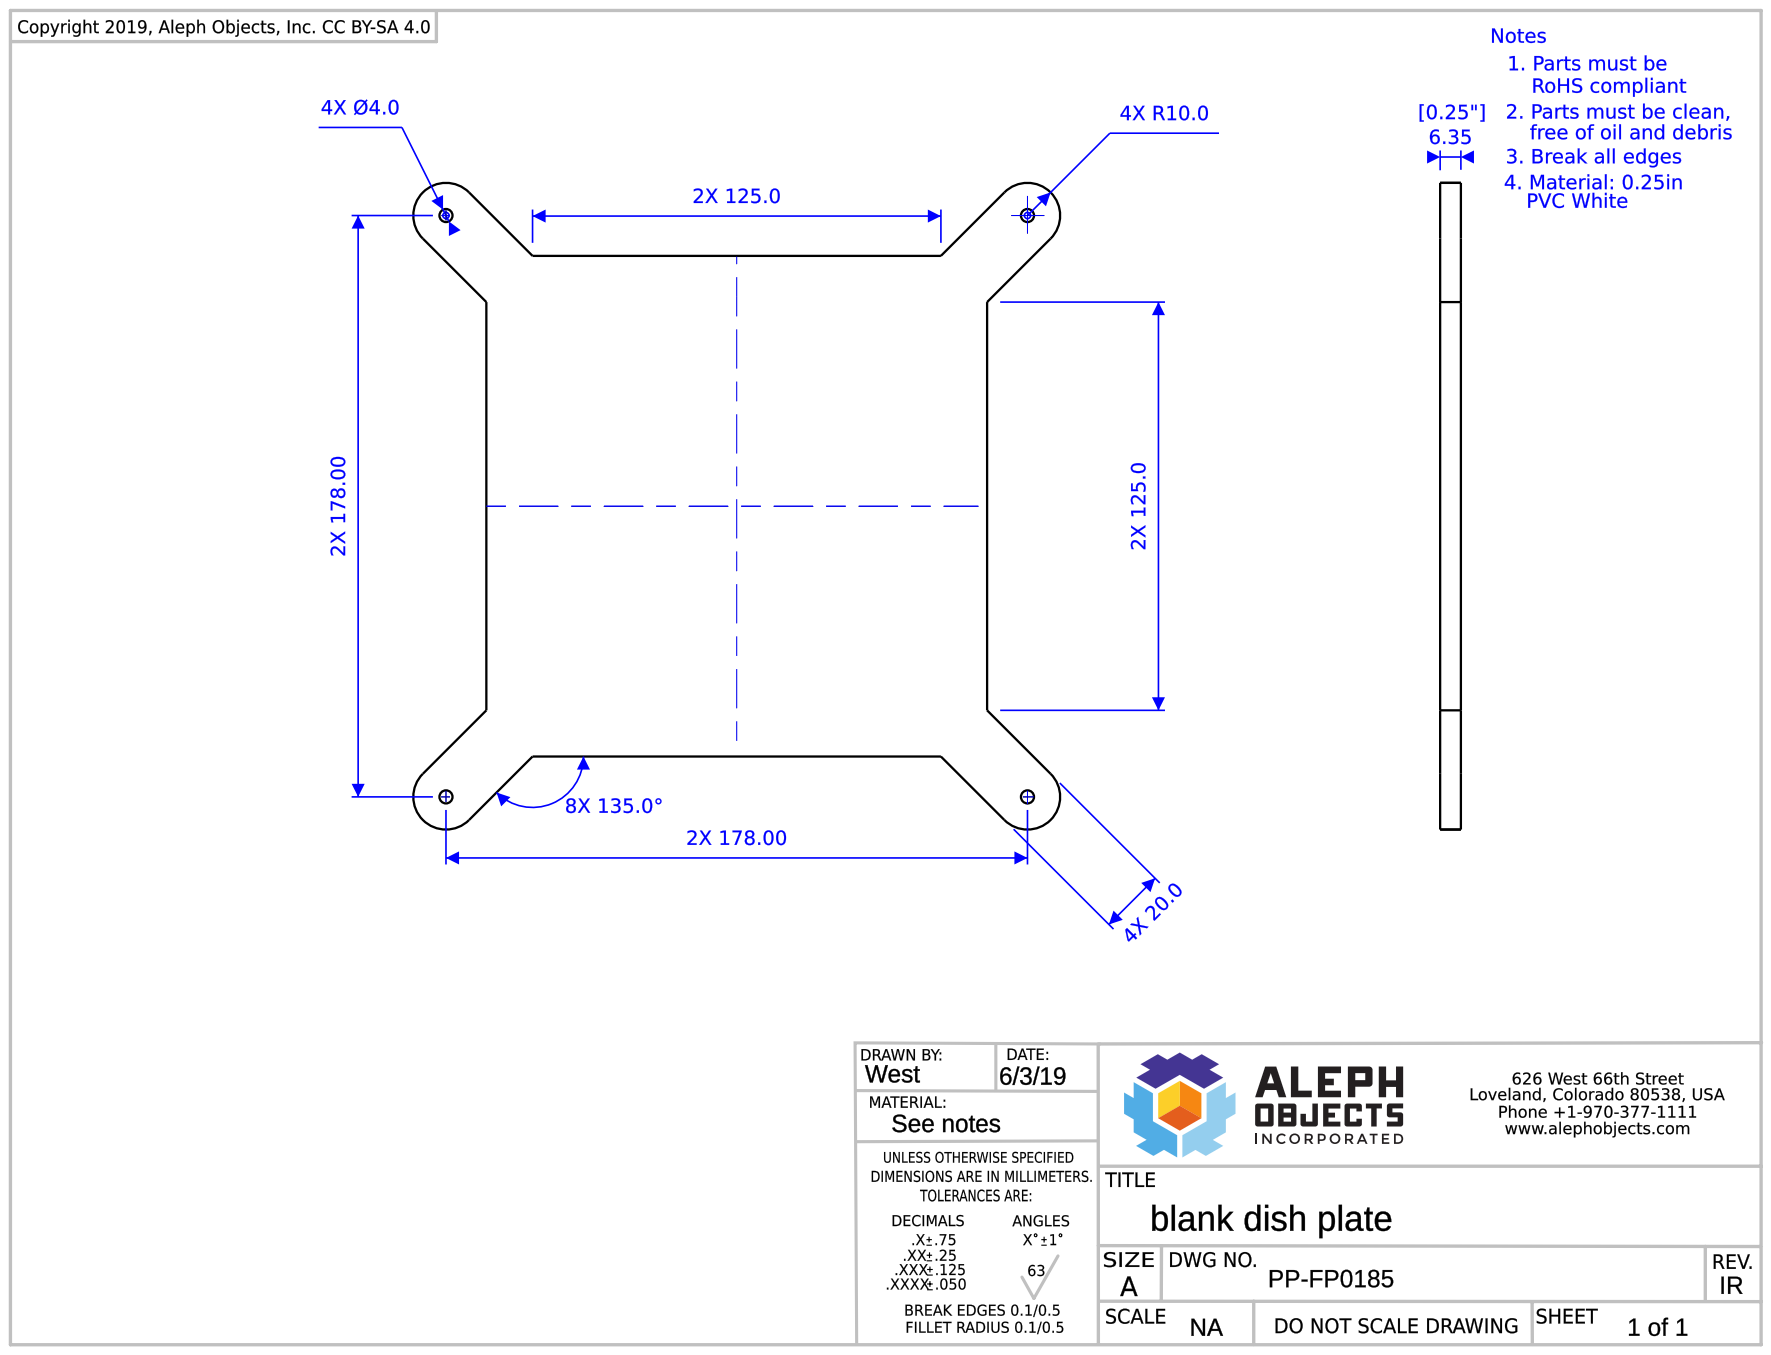
[picture p177: page 1]
