reprapperMC/kangaroopaw/production_parts/tool_head/machined_parts/HD-RD0077_90mm_guide_rod.pdf

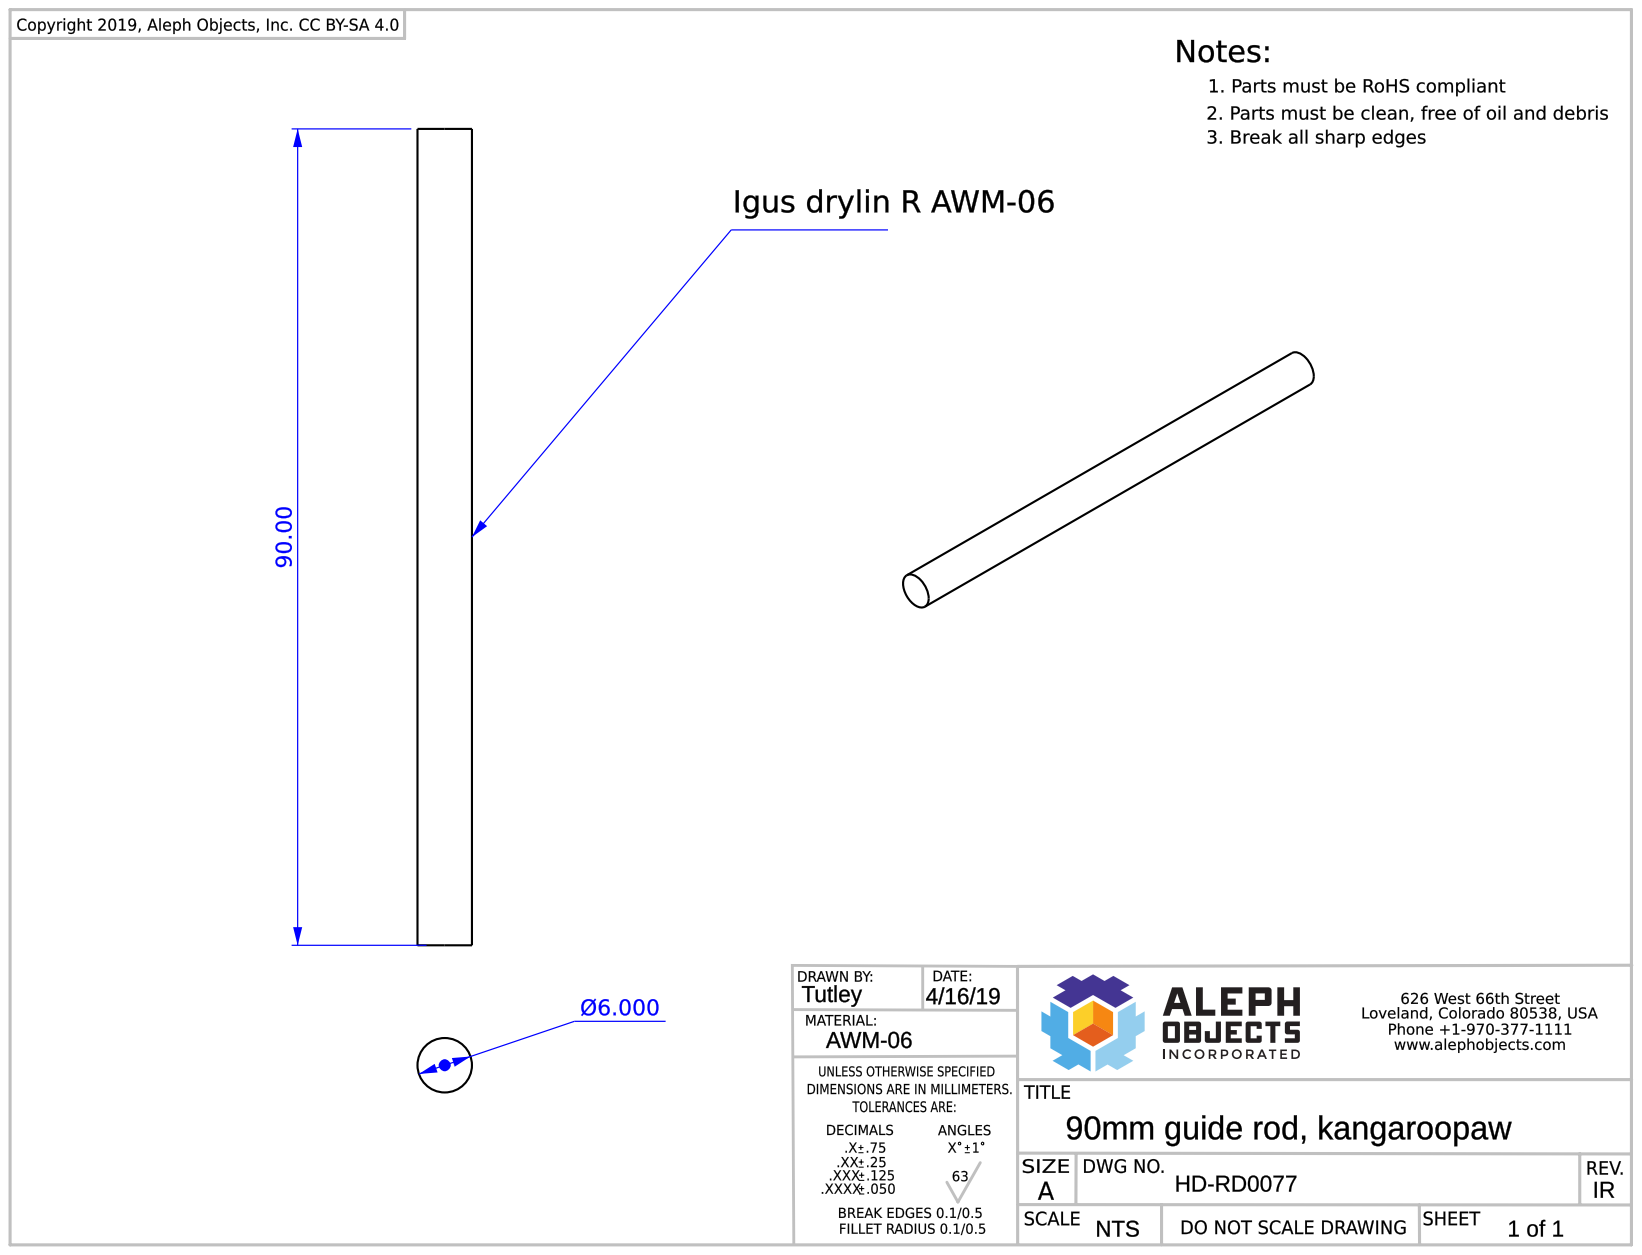
[picture p178: page 1]
