reprapperMC/kangaroopaw/production_parts/machined_parts/35mmx6_dish_plate/35mmx6_dish_plate.pdf

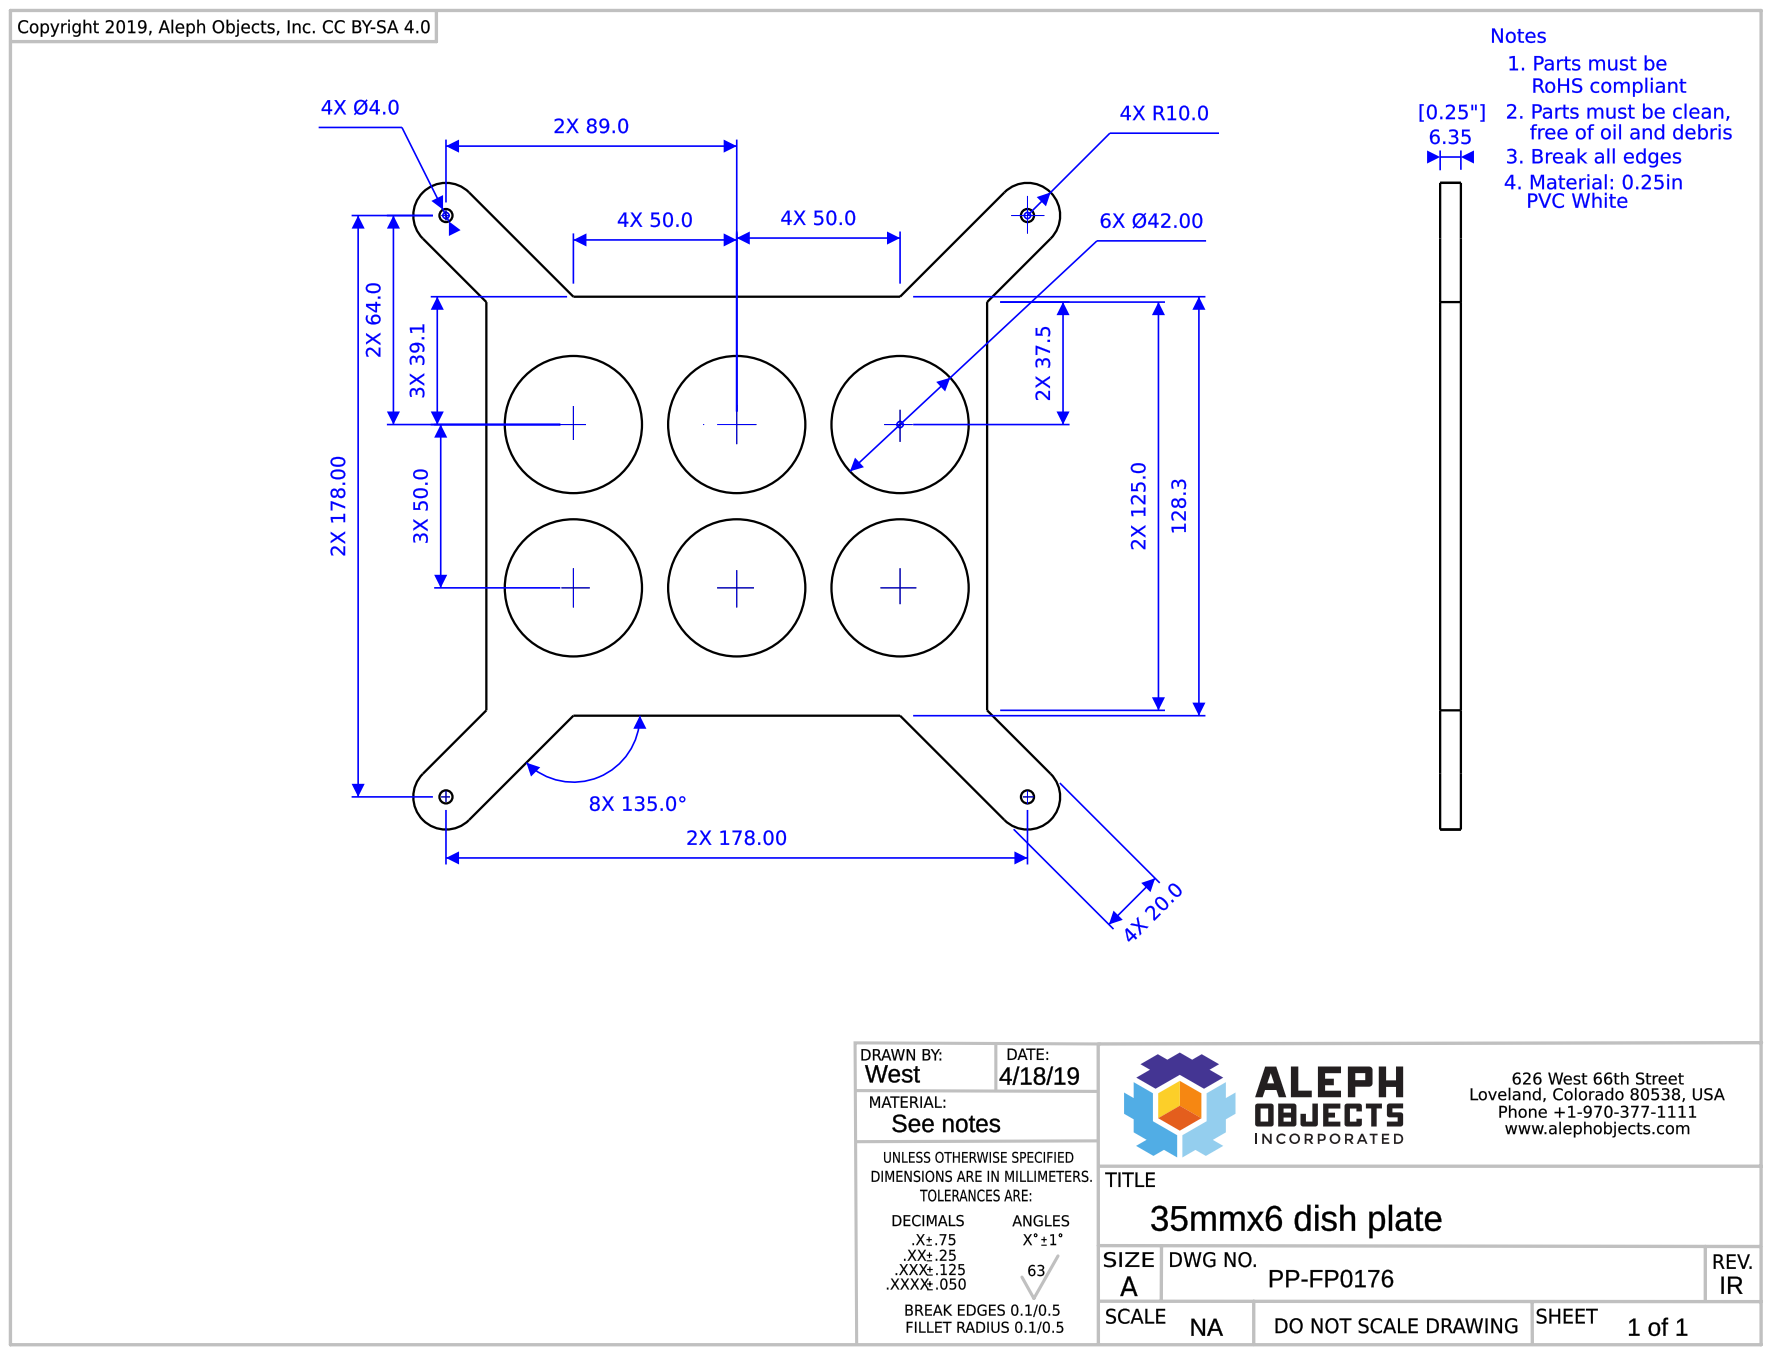
[picture p179: page 1]
