reprapperMC/kangaroopaw/production_parts/machined_parts/touchscreen_pad/touchscreen_pad.pdf

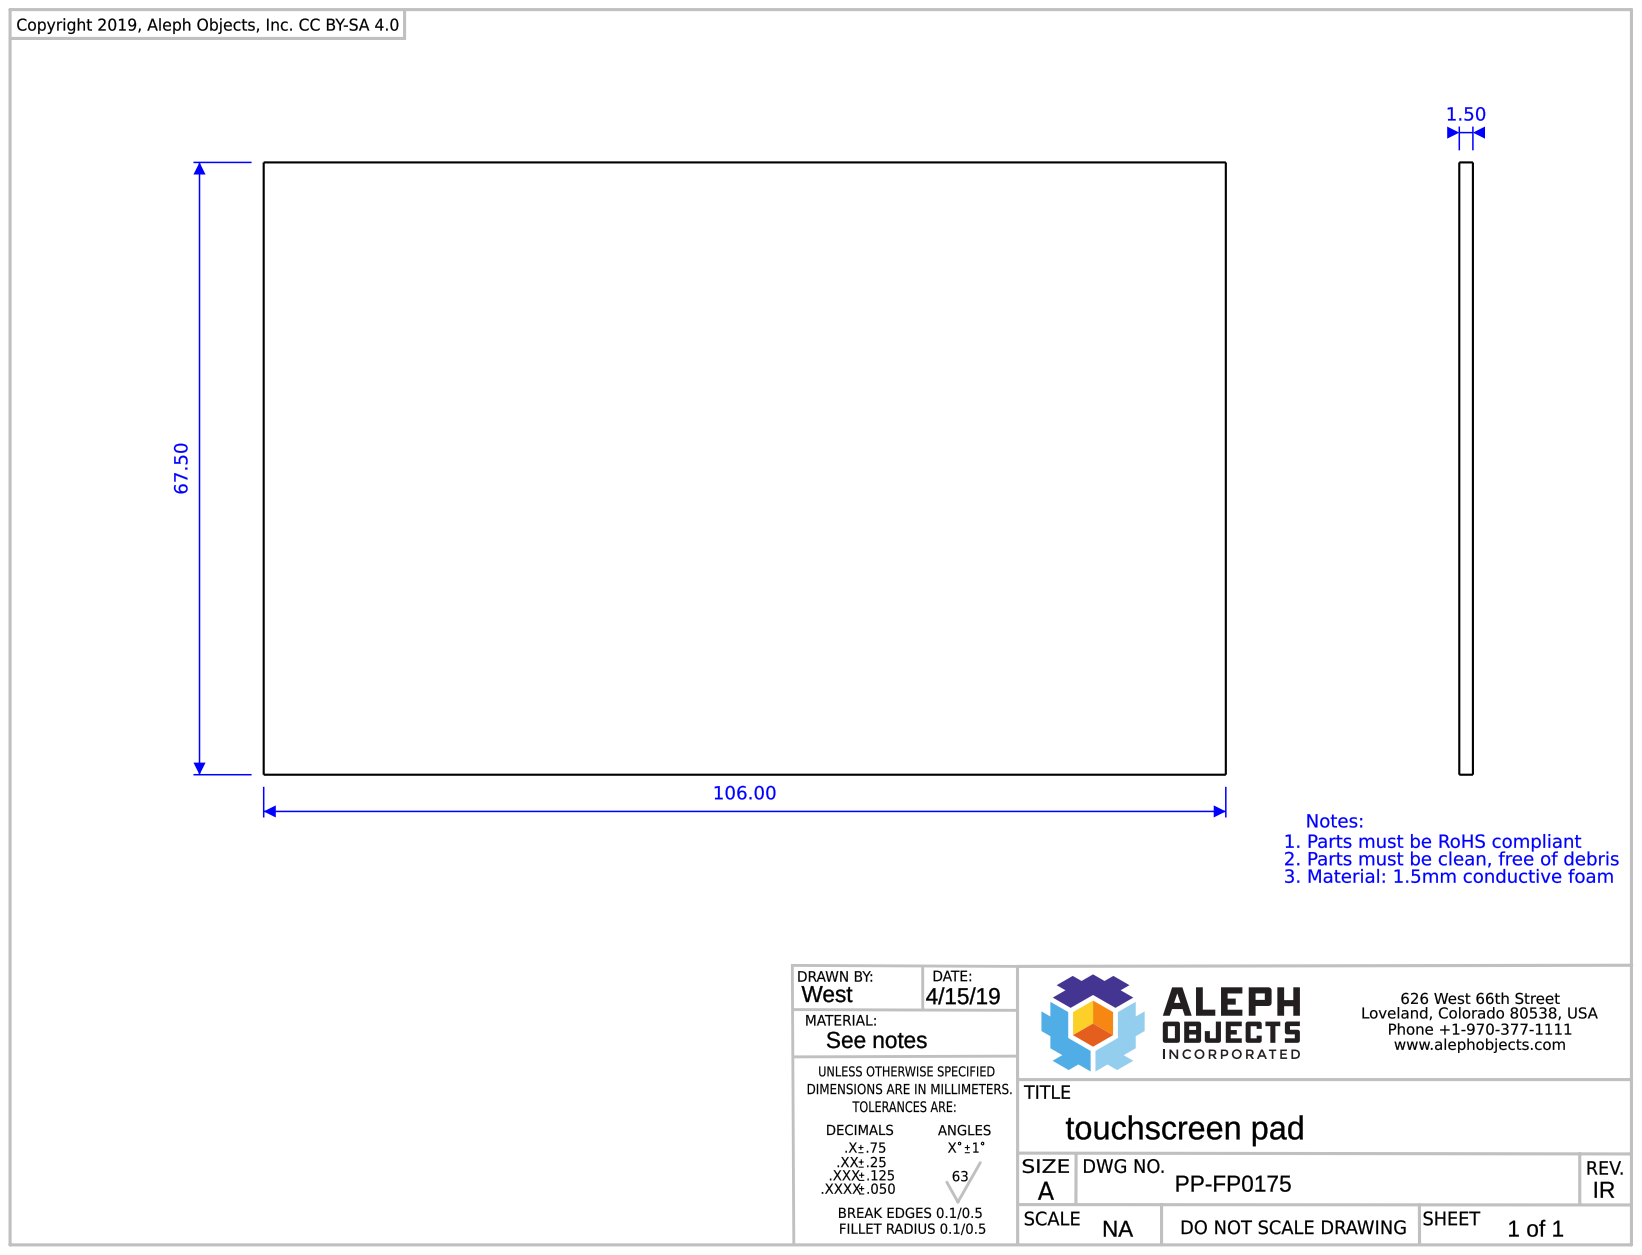
[picture p180: page 1]
