reprapperMC/kangaroopaw/production_parts/tool_head/machined_parts/HD-RD0076_99mm_leadscrew.pdf

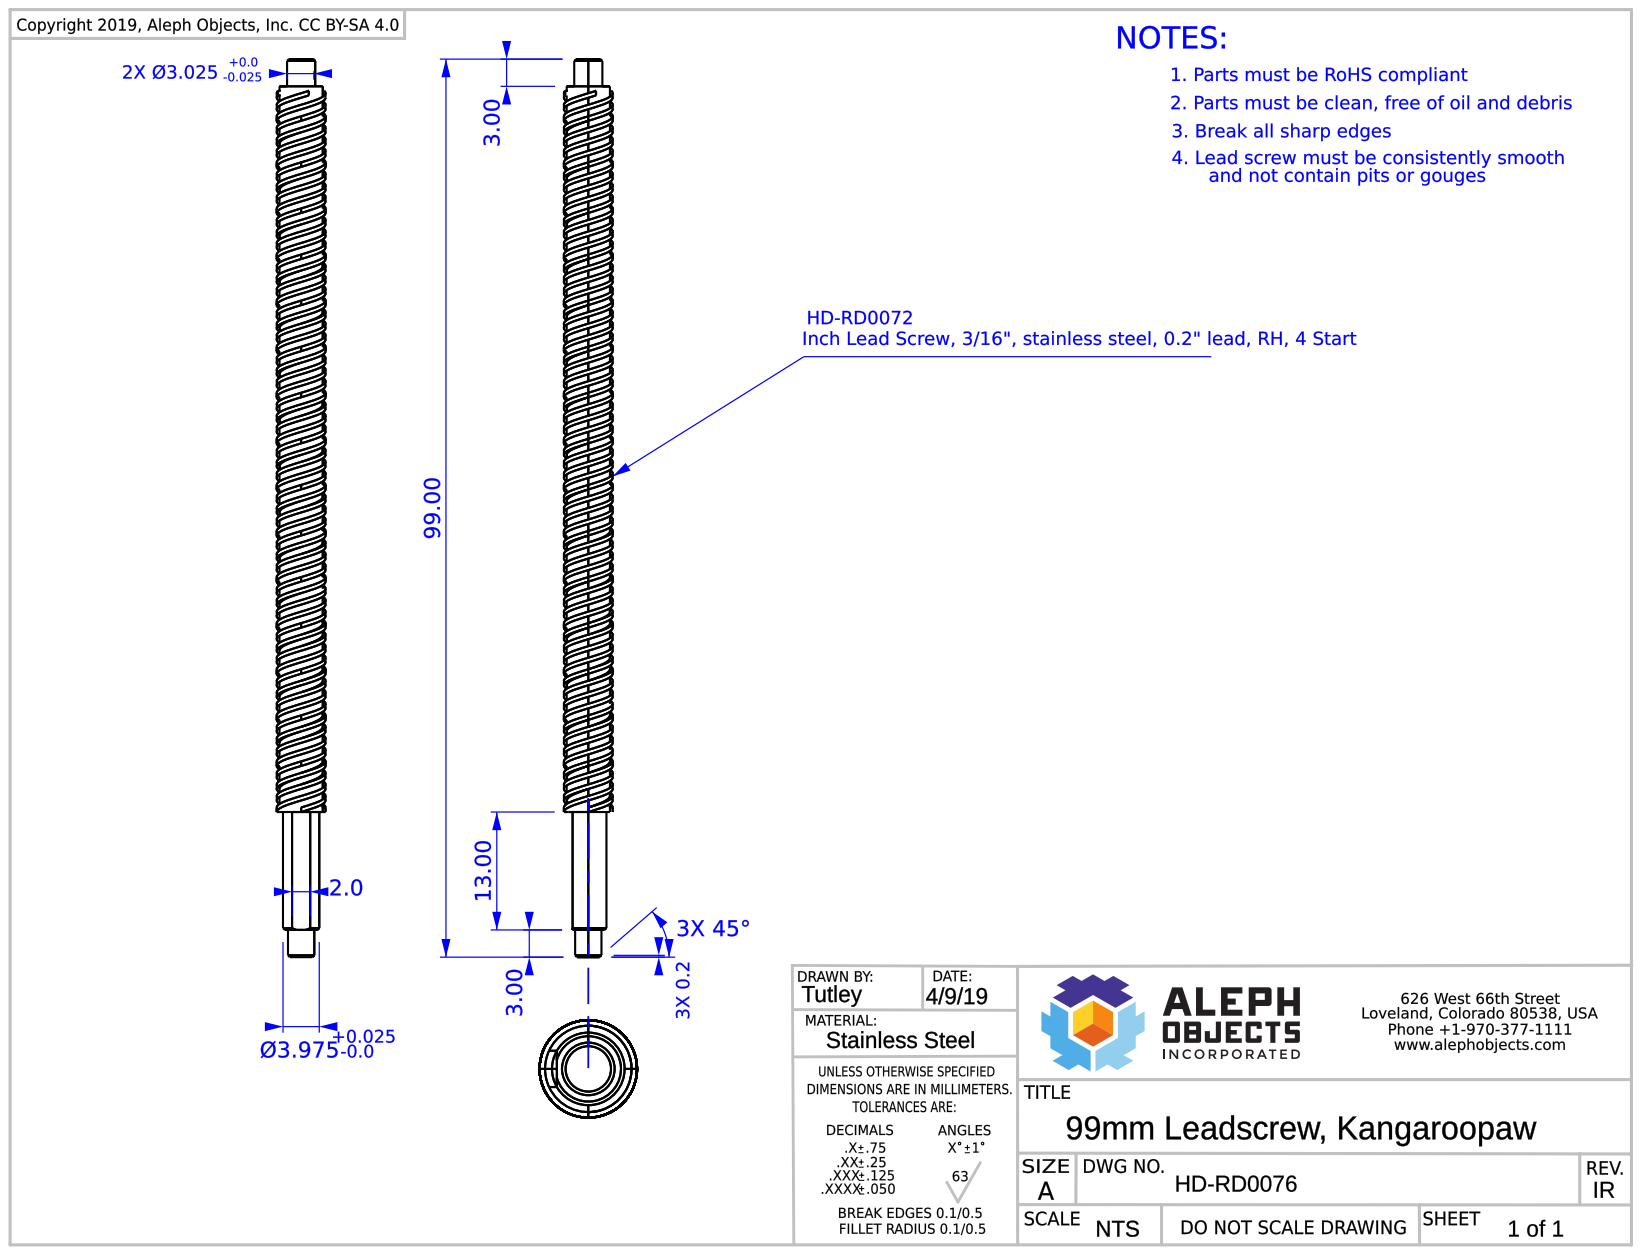
[picture p181: page 1]
