reprapperMC/kangaroopaw/production_parts/machined_parts/heatsink_einsy/heatsink_einsy_PP-MP0210.pdf

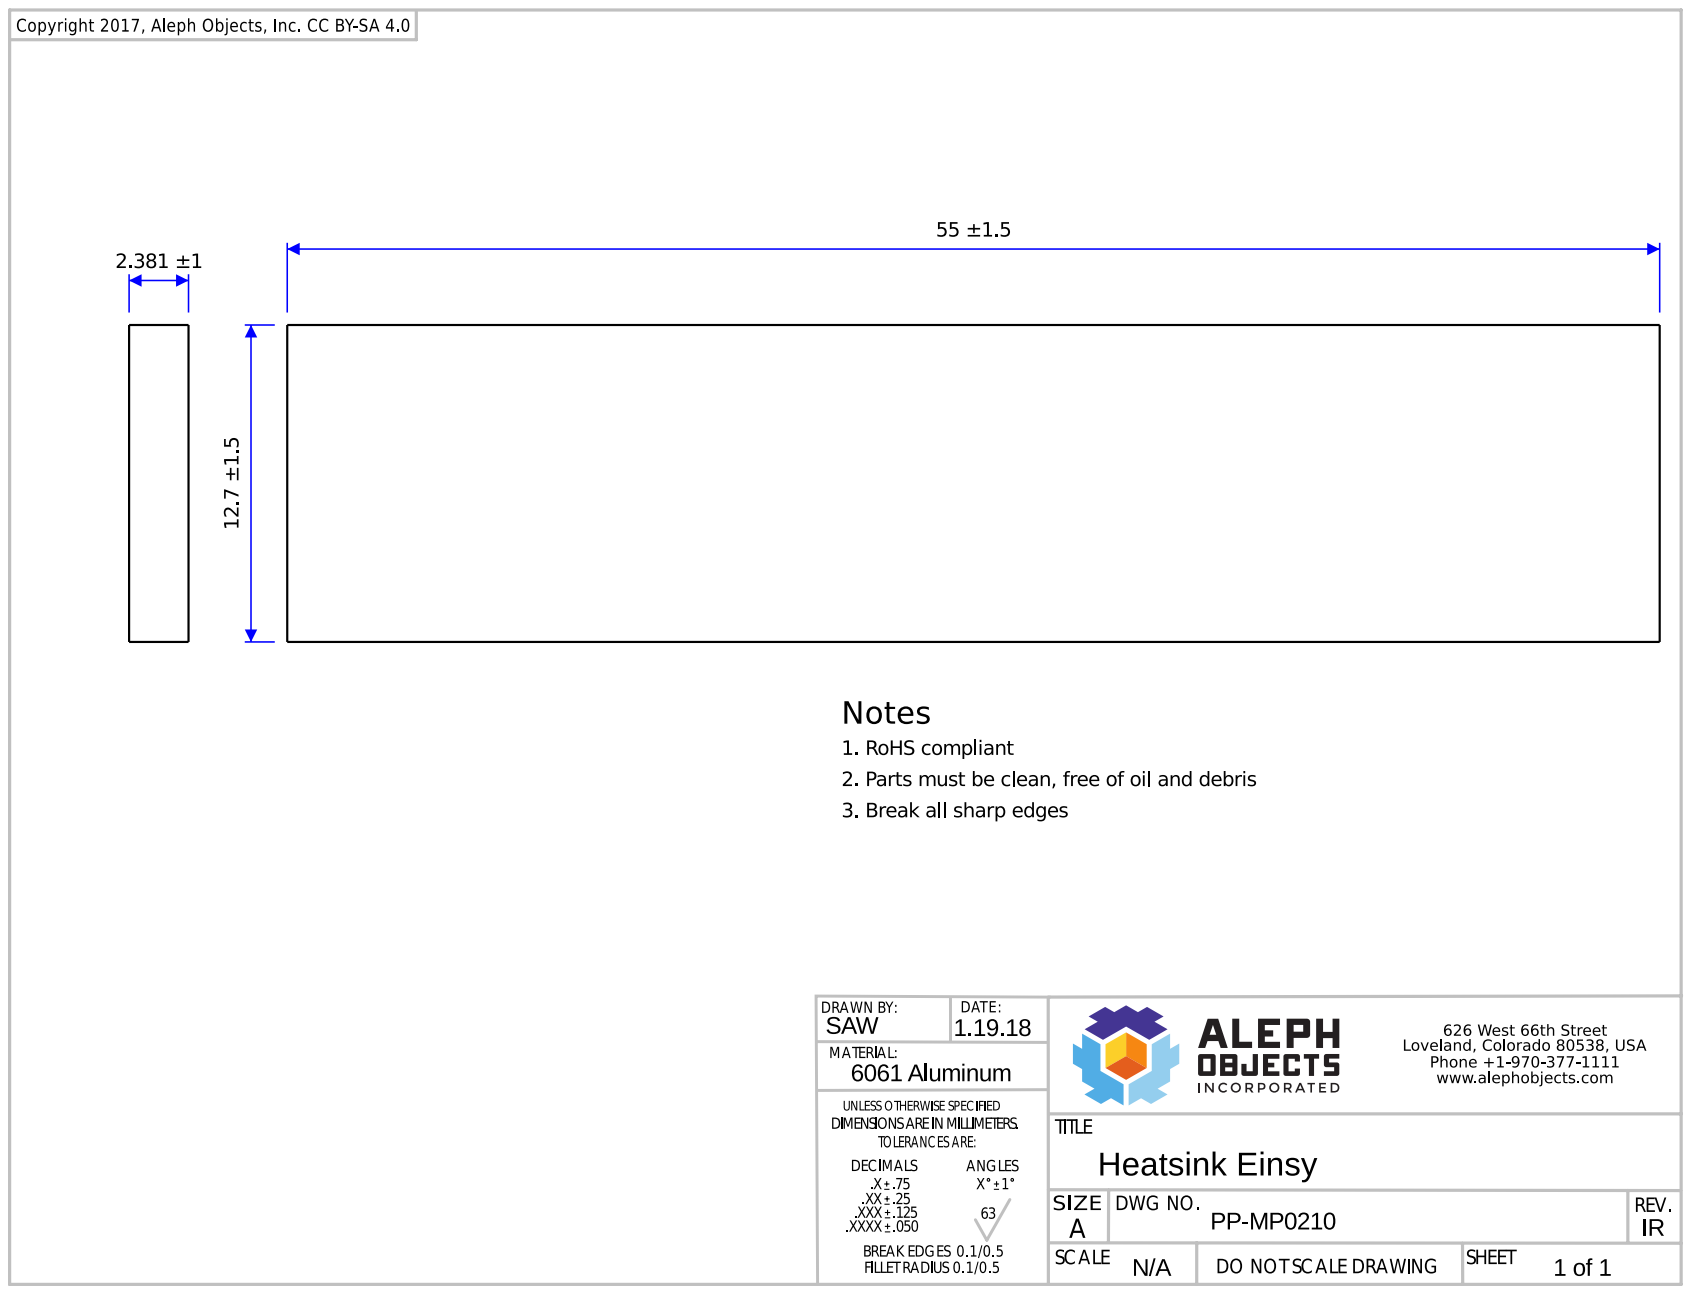
[picture p182: page 1]
