reprapperMC/kangaroopaw/production_parts/machined_parts/right_side/right-side-mini-white_PP-FP0169.pdf

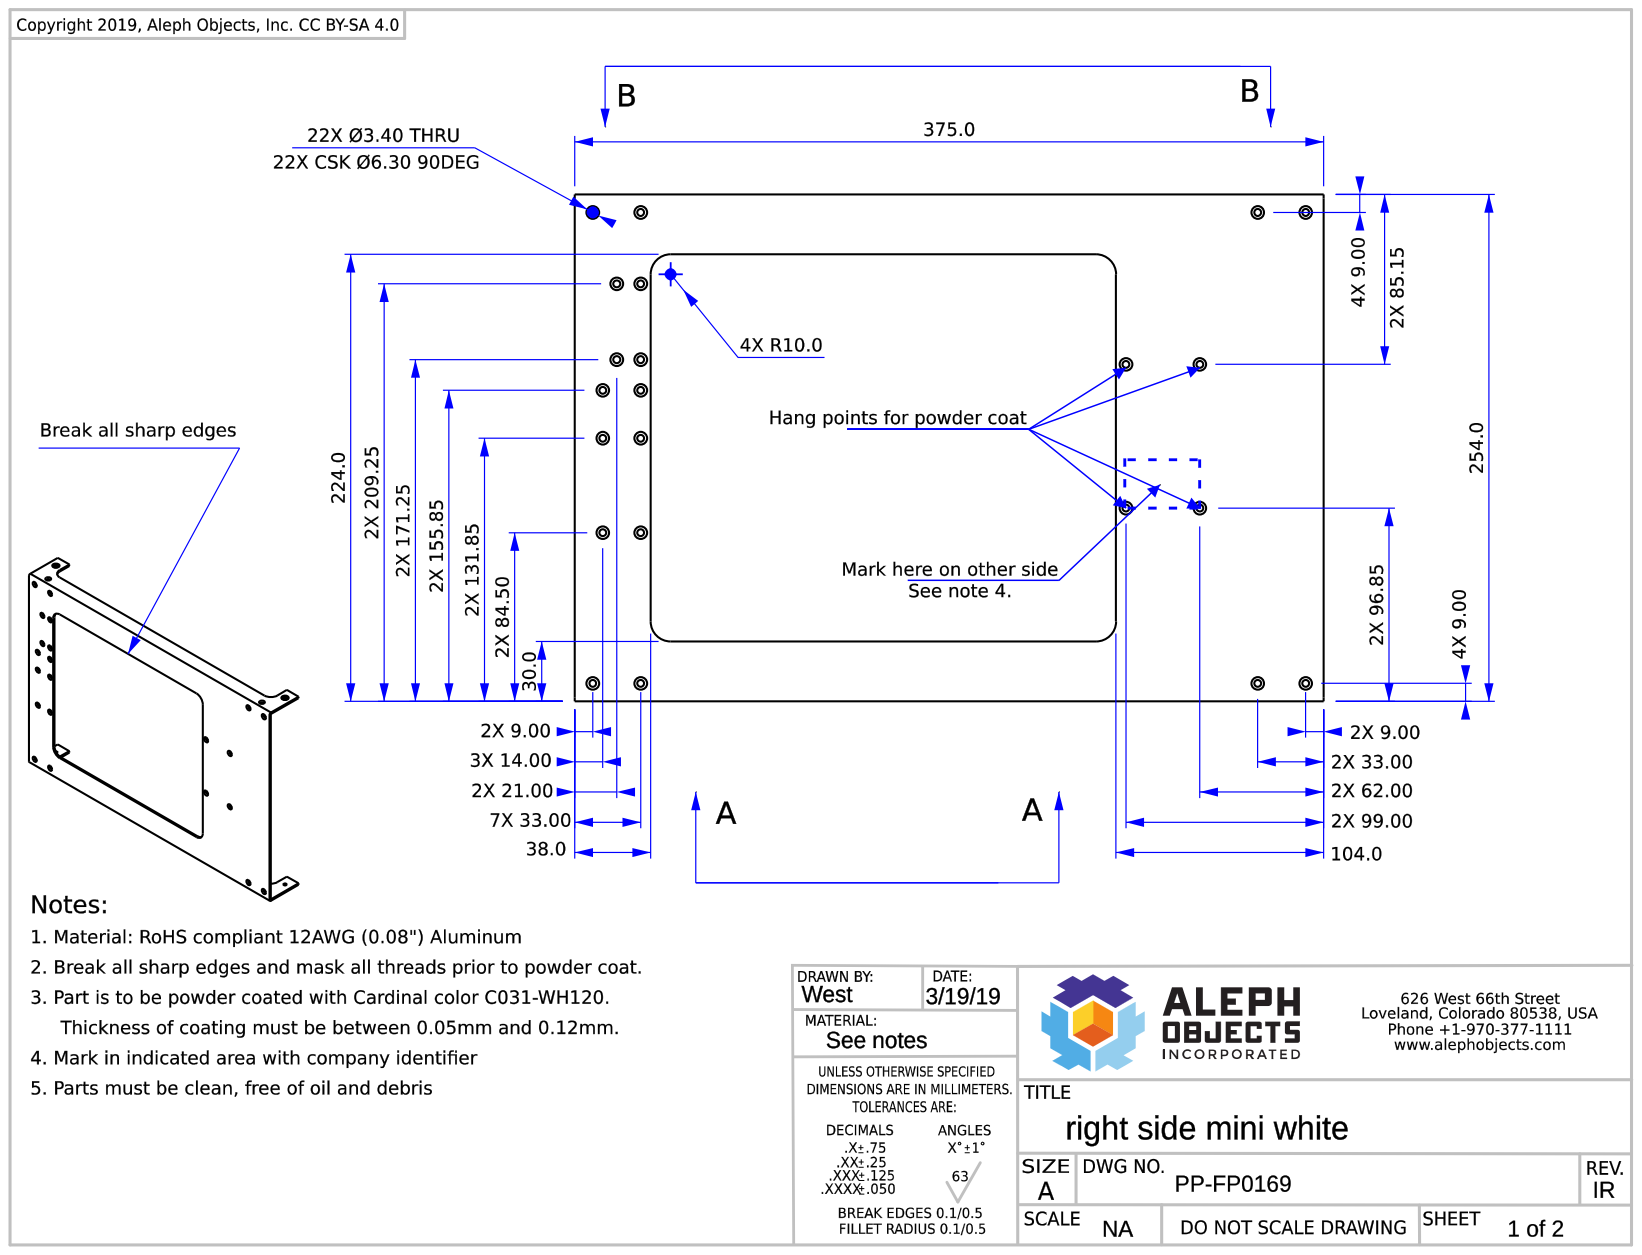
[picture p183: page 1]

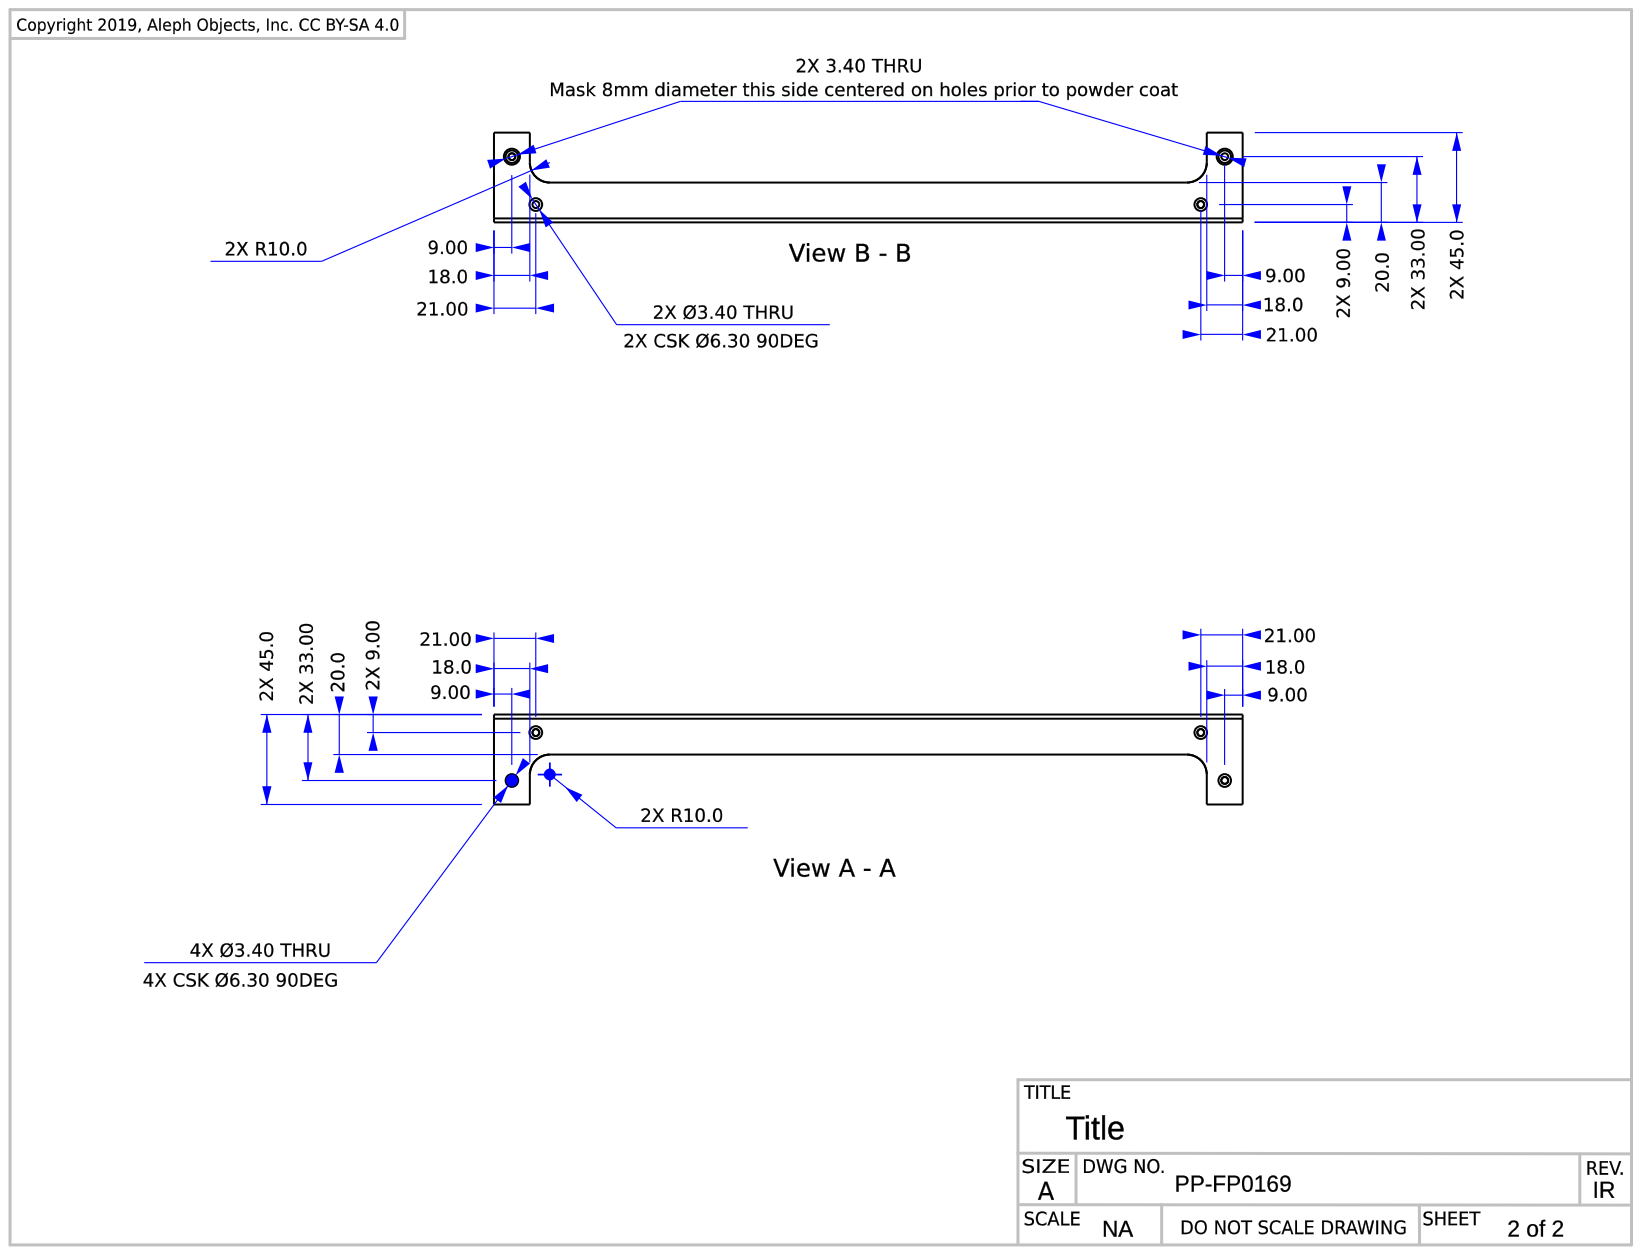
[picture p184: page 2]
