reprapperMC/kangaroopaw/production_parts/machined_parts/smooth_idler_pully_wheel/smooth_idler_pully_wheel_HD-MS0412.pdf

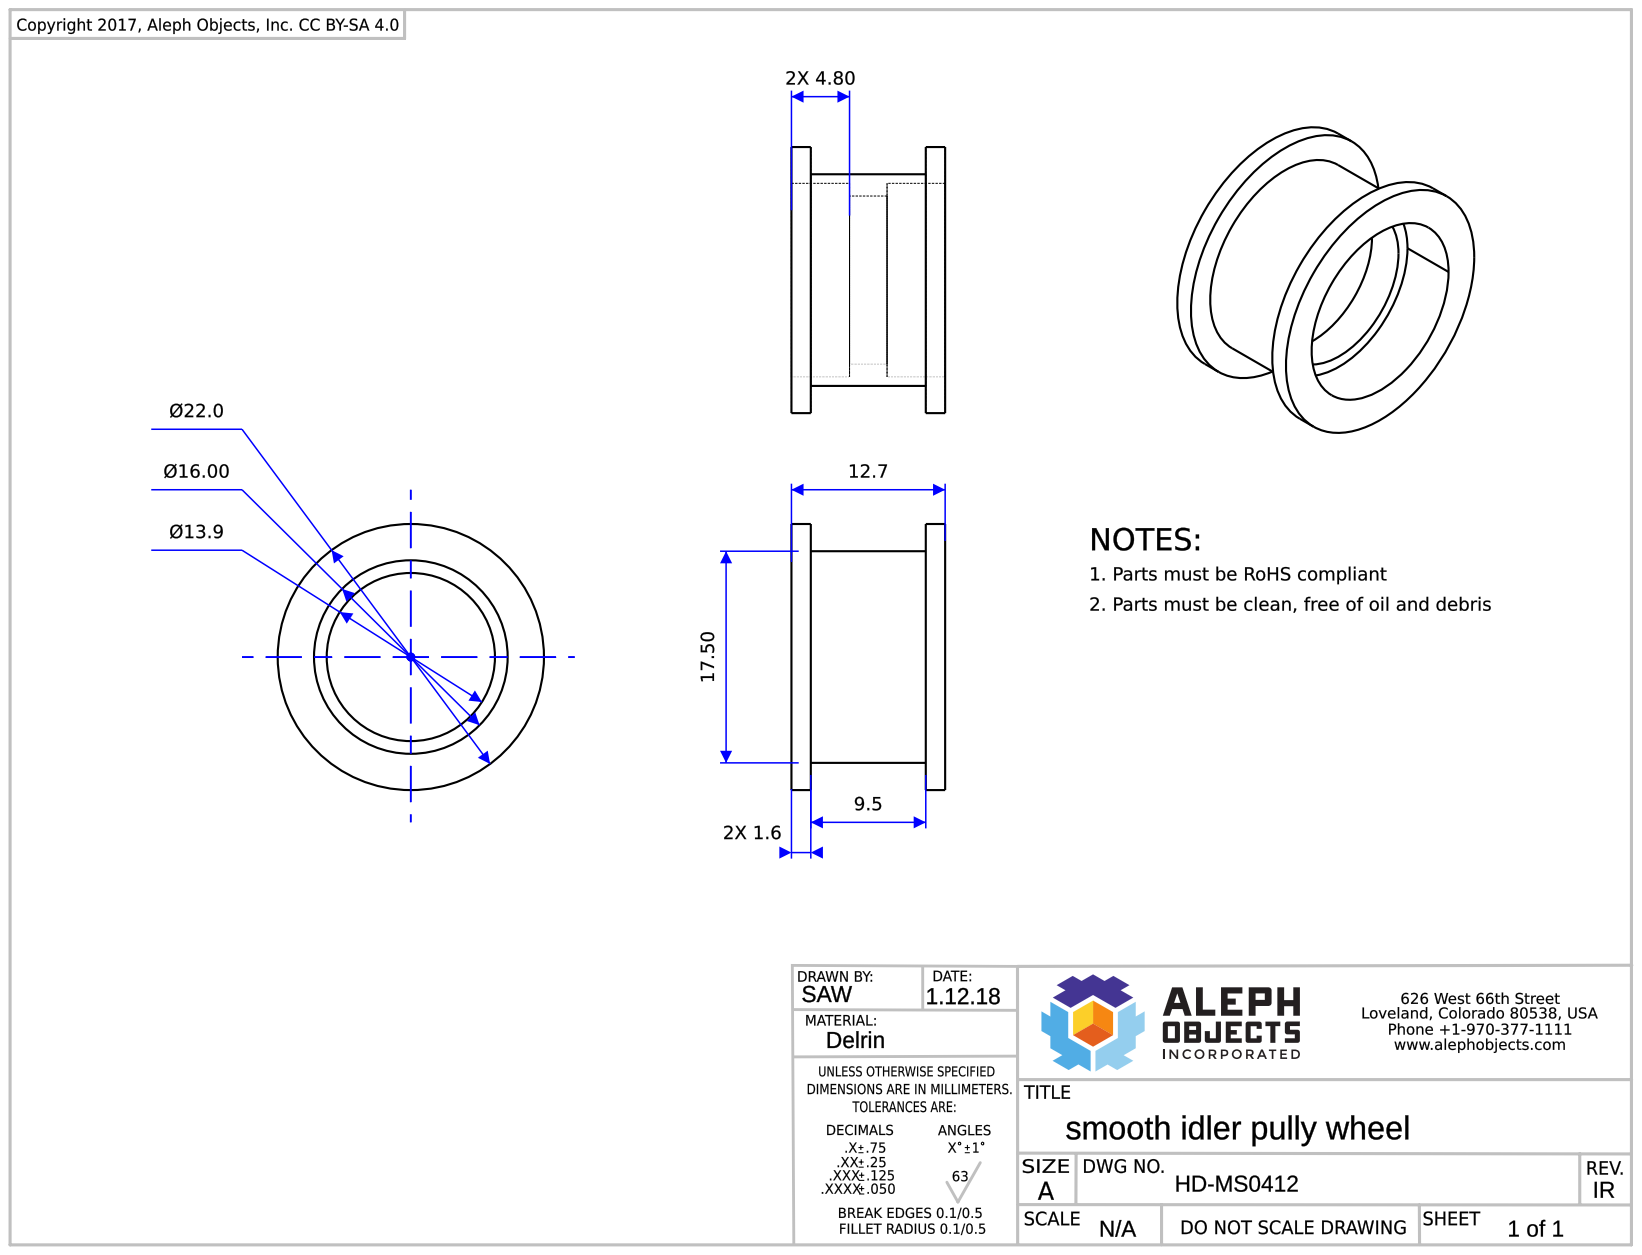
[picture p185: page 1]
