reprapperMC/kangaroopaw/production_parts/machined_parts/smooth_rod_mini/8mmx315_rod_v1.0_revA.pdf

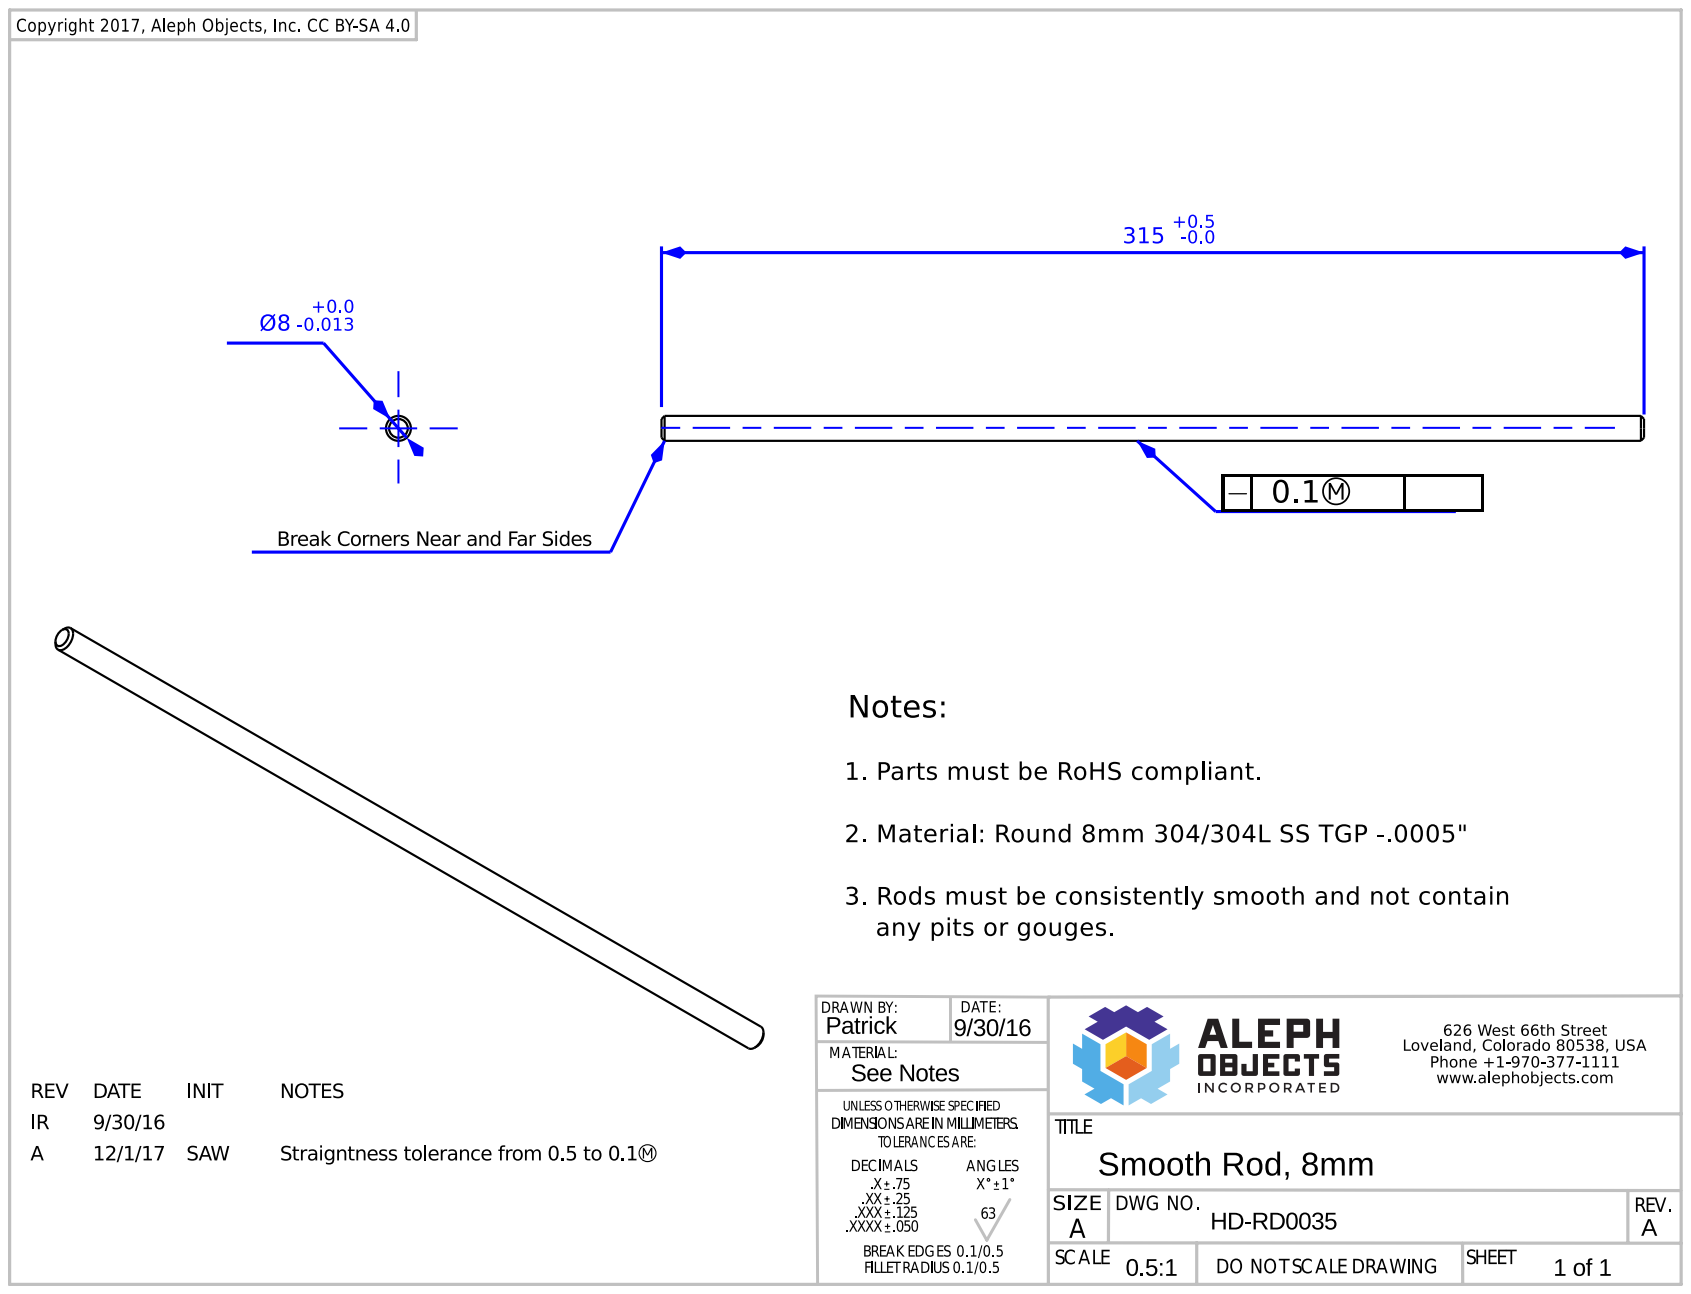
[picture p186: page 1]
