reprapperMC/kangaroopaw/production_parts/machined_parts/top_plate_mini/top-plate-mini-white_PP-FP0168.pdf

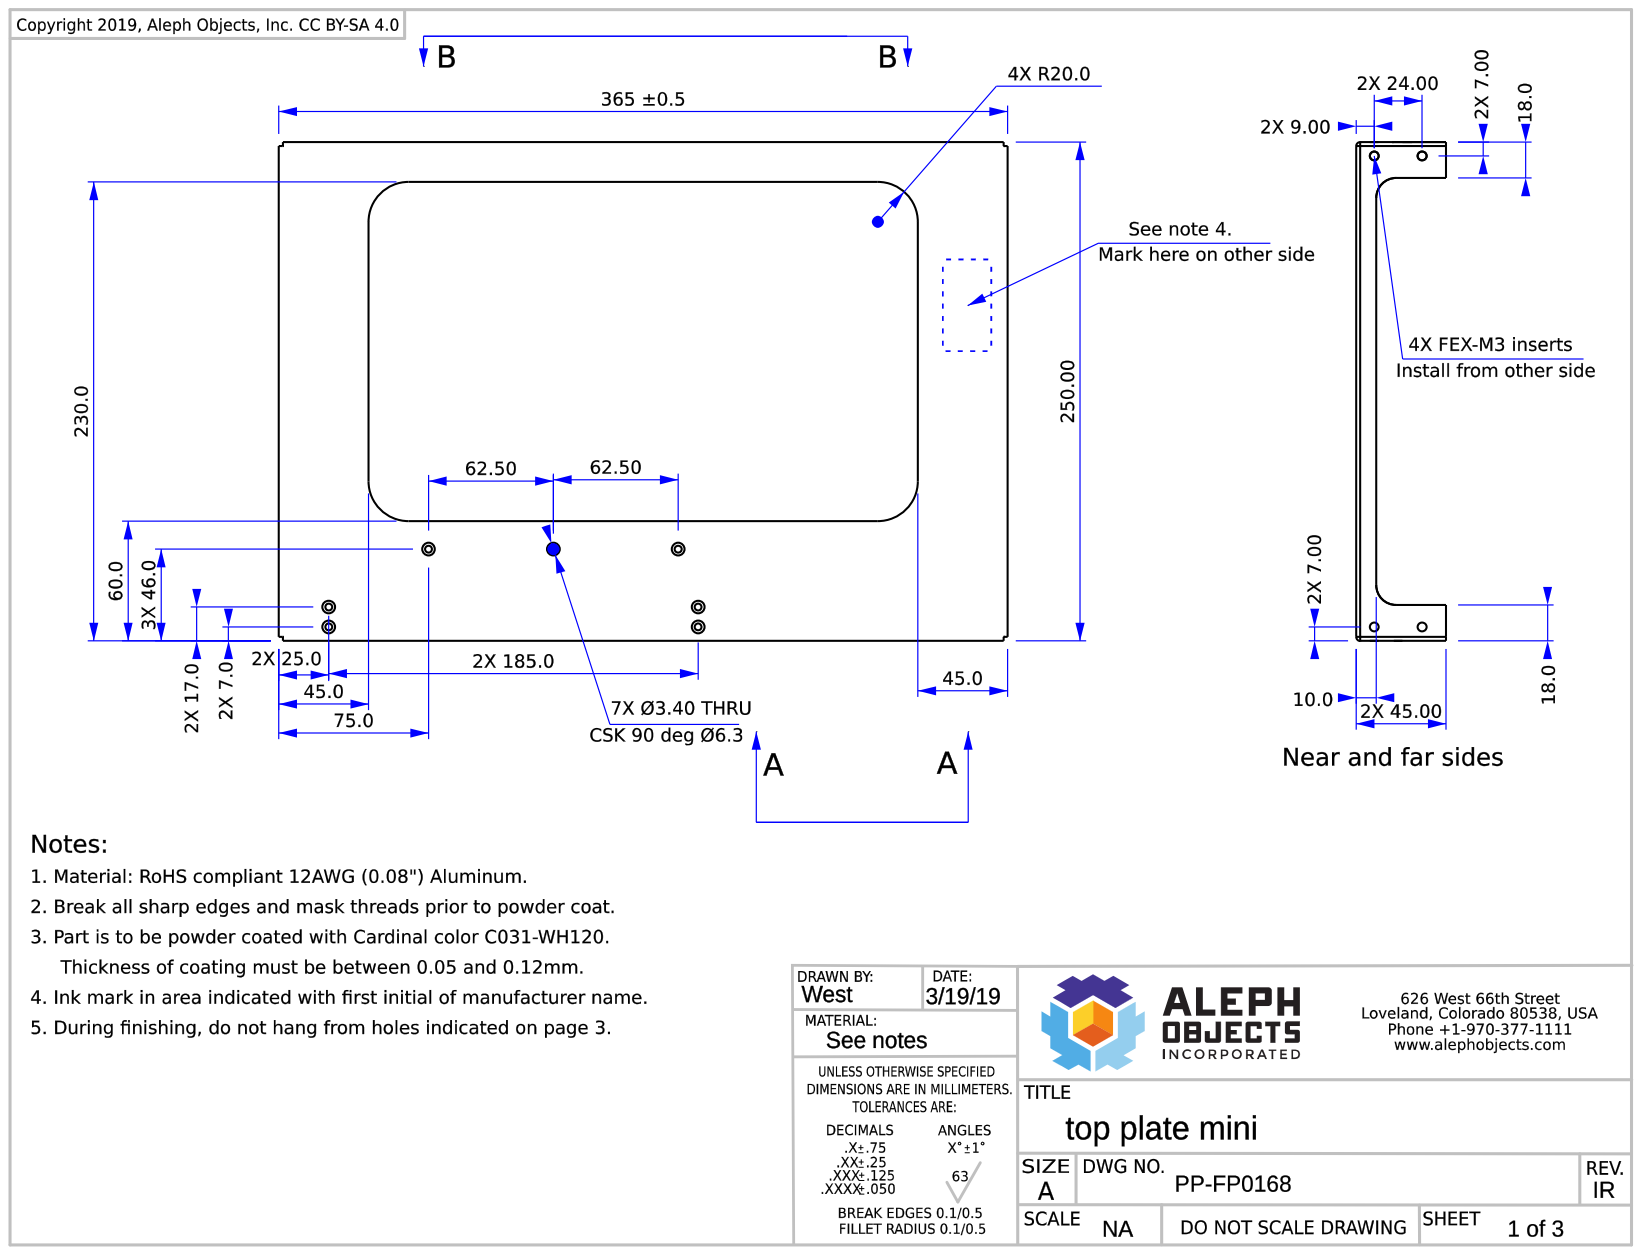
[picture p187: page 1]

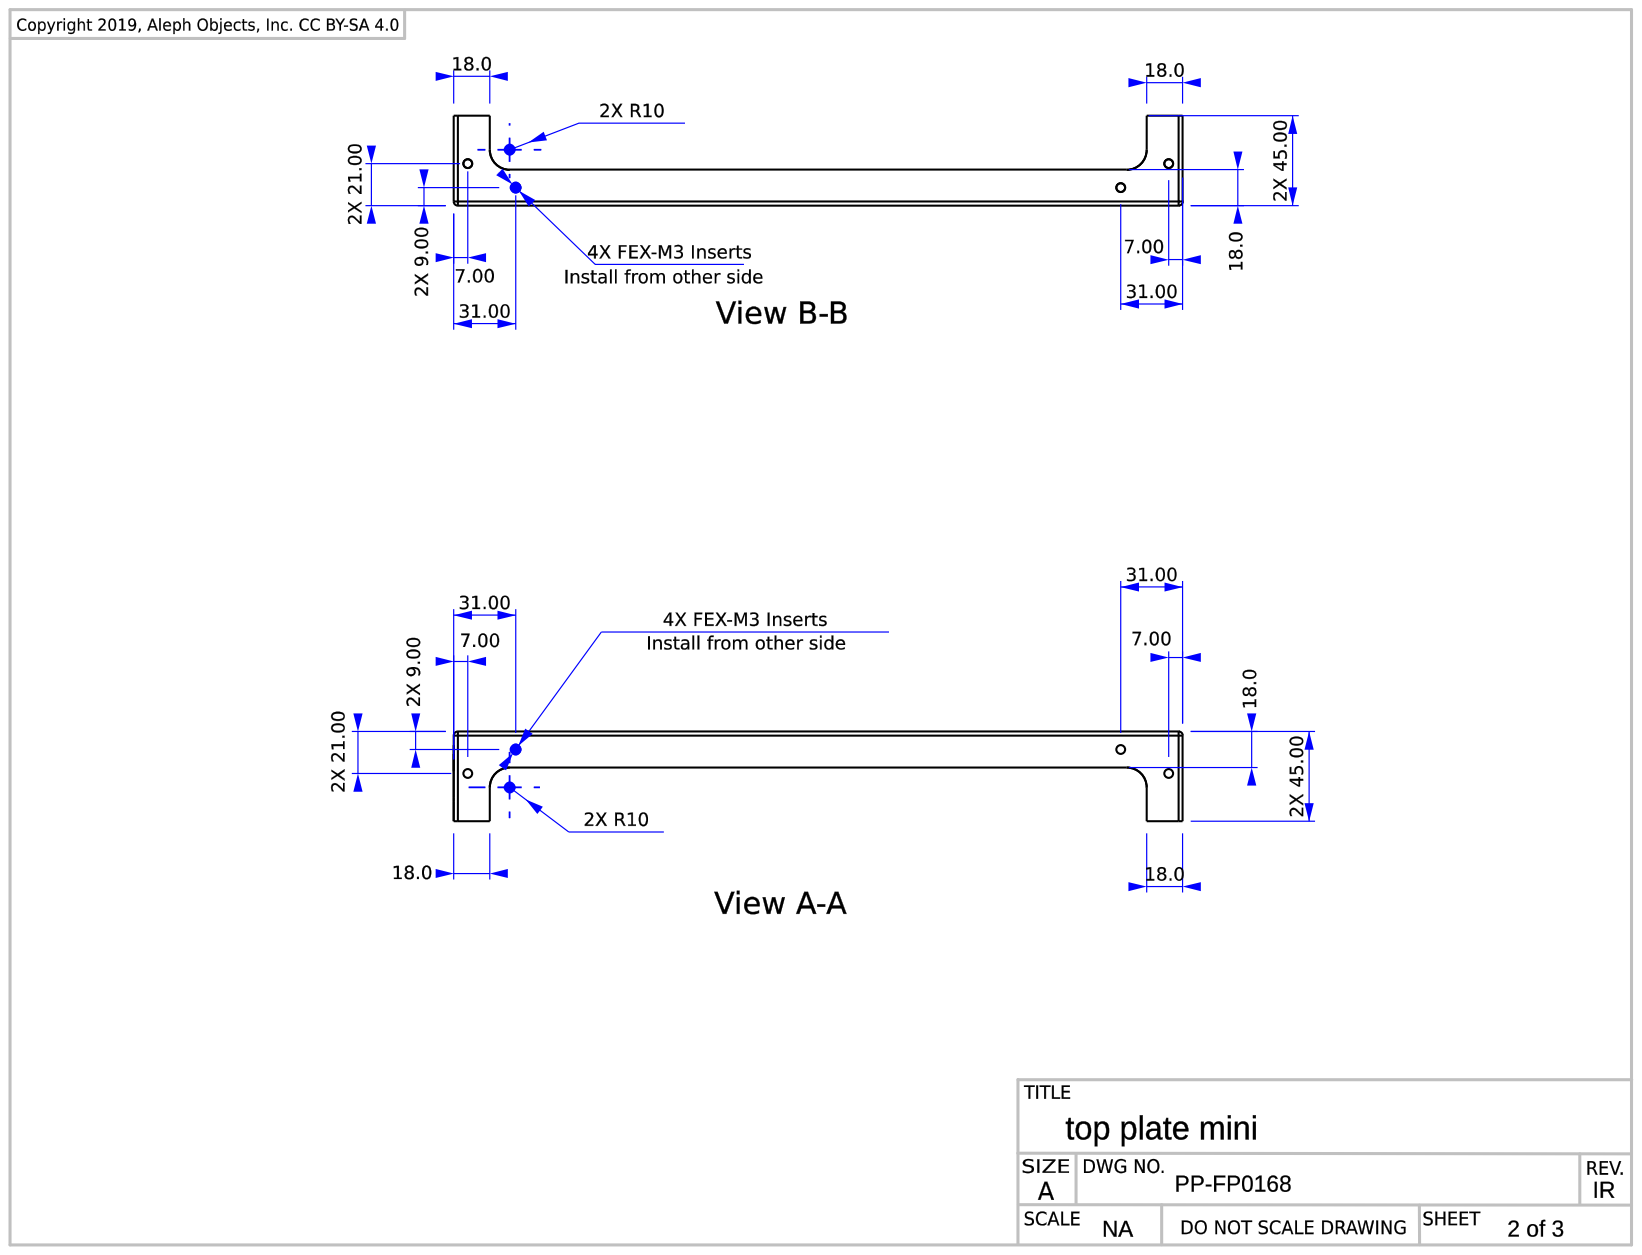
[picture p188: page 2]

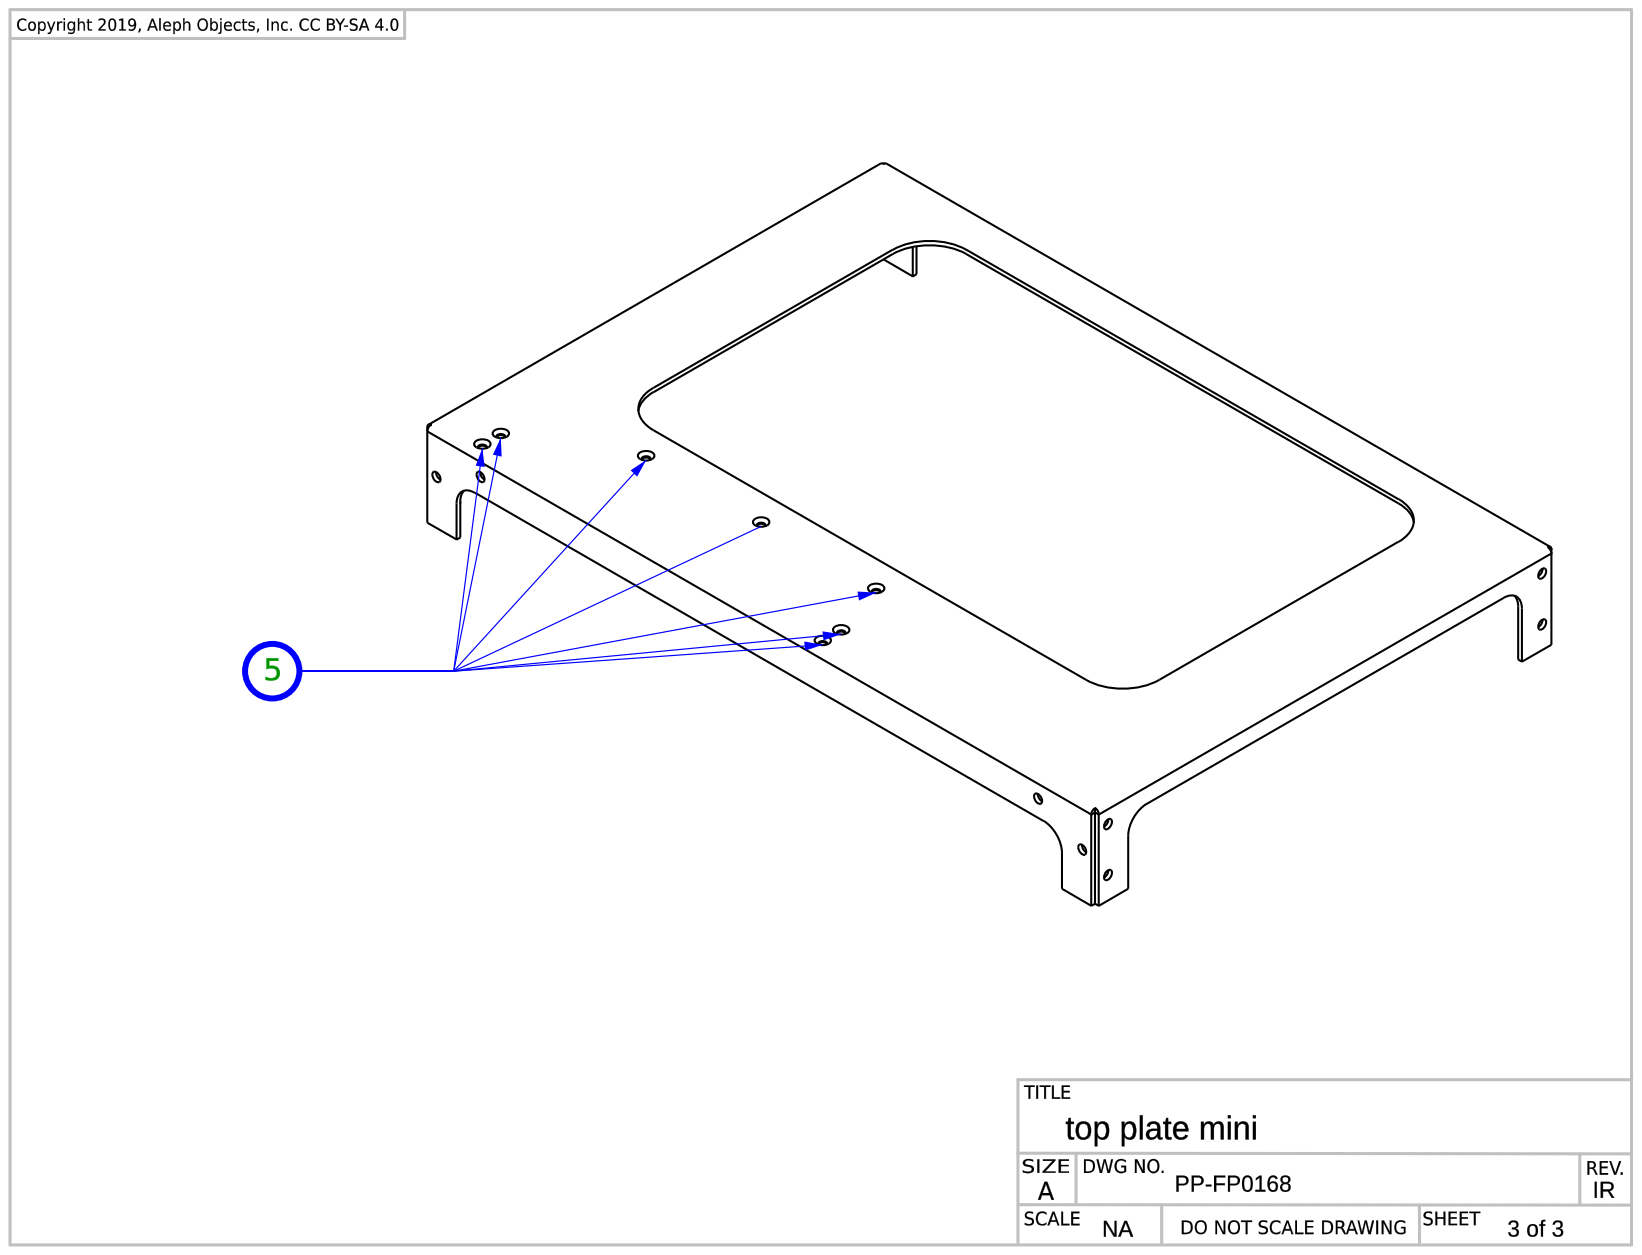
[picture p189: page 3]
