reprapperMC/kangaroopaw/(commit log)

2019-02-06 Add initial equipment and supplies list
    [equipment_supplies_list.csv]
2019-02-09 Add more items to the supplies list
    [equipment_supplies_list.csv]
2019-02-11 Add pitri dish to equipment supplies document
    [equipment_supplies_list.csv]
2019-02-11 Add additional dispensing needle to equipment document
    [equipment_supplies_list.csv]
2019-02-11 Add initial bill of materials for Replistruder
    This is not complete as it still needs the motor, cables, and connector
    [BOM.csv]
2019-02-11 Update product url for 15ml centrifuge tube
    [equipment_supplies_list.csv]
2019-02-12 Moved equipment list to documentation dir
    [equipment_supplies_list.csv]
2019-03-11 Add prototype petri dish tray design and model
    [35mmx6_dish_plate.fcstd, 35mmx6_dish_plate.stl]
2019-03-19 Add machined parts and sheet metal
    [8mmx315_rod_v1.0_revA.fcstd, 8mmx315_rod_v1.0_revA.step, bed-mount-plate-mini_PP-FP0138_revH.fcstd, bed-mount-plate-mini_PP-FP0138_revH.step, bed_standoff.fcstd, bed_standoff.step, bottom-plate-mini-white_PP-MP0258.fcstd, bottom-plate-mini-white_PP-MP0258.step]
2019-03-20 Remove old bed mount plate add new bed mount plate with white powder coat
    [bed-mount-plate-mini-white_PP-FP0171.fcstd, bed-mount-plate-mini-white_PP-FP0171.step, bed-mount-plate-mini_PP-FP0138_revH.fcstd, bed-mount-plate-mini_PP-FP0138_revH.step]
2019-03-20 Add newest freecad file
    [bed-mount-plate-mini-white_PP-FP0171.fcstd]
2019-03-20 Update drawing to address redlines
    [bed-mount-plate-mini-white_PP-FP0171.fcstd]
2019-03-25 Add model for hamilton 2.5ml syringe
    [hamilton_2.5ml_81420.fcstd]
2019-04-02 Added toolhead assembly
    [623_bearing.fcstd, 6mm_rod.fcstd, KHK_US-BG0_5-30R2.stp, KHK_US-SW0_5-R2.stp, Lower_bearing_holder.fcstd, Minii_x_carriage_V2.1.fcstd, Syringe_insert_mount.fcstd, carriage.fcstd]
2019-04-09 Add printed parts for lcd assembly
    [touchscreen_case.fcstd, touchscreen_case.stl, touchscreen_center.fcstd, touchscreen_center.stl, touchscreen_cover.fcstd, touchscreen_cover.step, touchscreen_cover.stl, usb_mount.fcstd]
2019-04-10 Add part number to drawing
    [PP-FP0174_touchscreen_cover.fcstd, PP-FP0174_touchscreen_cover.step, PP-FP0174touchscreen_cover.stl, touchscreen_cover.fcstd]
2019-04-11 updated toolhead assembly,added leadscrew drawing
    [HD-RD0076_99mm_leadscrew.fcstd, HD-RD0076_99mm_leadscrew_drawing.fcstd, Syringe_collar_mount.fcstd, Syringe_insert_mount.fcstd, cover.fcstd, cover.stl, extruder_mount.fcstd, extruder_mount.stl]
2019-04-11 updated extruder mount and assembly to make room for cable connector
    [Syringe_collar_mount.fcstd, extruder_mount.fcstd, extruder_mount.stl, syringe_collar_mount.stl, toolhead_assem.fcstd]
2019-04-11 Edit drawing to show A face edit center to allow ground wre
    [PP-FP0174_touchscreen_cover.fcstd, touchscreen_center.fcstd, touchscreen_center.stl]
2019-04-11 Updated toohead assem, added cable cover
    [Lower_bearing_holder.fcstd, Syringe_collar_mount.fcstd, cable_cover.fcstd, cable_cover.stl, rear_flange_mount.fcstd, rear_flange_mount.stl, syringe_collar_mount.stl, toolhead_assem.fcstd]
2019-04-15 Add esd pad to machined parts for touchscreen
    [touchscreen_pad.fcstd]
2019-04-16 Add x extruder harness drawing
2019-04-22 Add dish plate machined part
    [35mmx6_dish_plate.fcstd, 35mmx6_dish_plate.step]
2019-04-22 Add part number to dish plate
    [35mmx6_dish_plate.fcstd]
2019-05-03 Updated file paths
    [6mm_rod.fcstd, HD-RD0076_99mm_leadscrew.fcstd, HD-RD0076_99mm_leadscrew_drawing.fcstd, Lower_bearing_holder.fcstd, Minii_x_carriage_V2.1.fcstd, Syringe_collar_mount.fcstd, cable_cover.fcstd, cable_cover.stl]
2019-05-03 Added tool head BOM
2019-05-03 renamed motor flange to motor mount
    [motor_flange.fcstd, motor_mount.fcstd]
2019-05-03 added milled parts drawings, updated tool head BOM
    [Lower_bearing_holder.fcstd, carriage.fcstd, upper_bearing.fcstd]
2019-05-06 Update touchscreen parts to have extra mounting hole to prevent bowing
    [PP-FP0174_touchscreen_cover.fcstd, PP-FP0174_touchscreen_cover_v1.fcstd, touchscreen_case_v1.fcstd, touchscreen_case_v1.stl, touchscreen_center.fcstd, touchscreen_center.stl, touchscreen_center_v1.fcstd]
2019-05-09 Add 55m dish plate edit lcd case to assemble easier
    [35mm_dish.fcstd, 35mm_dish.stl, 35mm_dish_v1.fcstd, 35mm_dish_v1.stl, 55mm_dish.fcstd, 55mm_dish.stl, 55mmx4_dish_plate.fcstd, 55mmx4_dish_plate.step]
2019-05-15 Modify lcd case to be assembled easier add pdf for 55mm dish plate
    [touchscreen_case_v1.2.fcstd, touchscreen_case_v1.2.stl]
2019-05-16 Add dish models for printing area add step of fsr cover and mount
    [fsr_cover_05.fcstd, fsr_cover_05.step, fsr_mount_05.step, large_dish.fcstd, large_dish.stl, small_dish.fcstd, small_dish.stl]
2019-05-16 Add step of fsr cover 05
    [fsr_cover_05.step]
2019-05-20 added screw holes to syringe collar mount/cover for increased rigidity
    [Syringe_collar_mount.fcstd, cover.fcstd, cover.stl, syringe_collar_mount.stl]
2019-05-21 Update 35mm dish holder for easier removal
    [35mm_dish_v1.fcstd, 35mm_dish_v1.stl]
2019-05-21 Update fsr cover and mount to allow a female connector to connect
    [fsr_cover_05.fcstd, fsr_cover_05.step, fsr_mount_05.fcstd, fsr_mount_05.step]
2019-05-24 updated LCD case for use w/ SD reader, added SD mount
    [sd_mount.fcstd, sd_mount.stl, touchscreen_case_v1.3.fcstd, touchscreen_case_v1.3.stl]
2019-06-05 Add extruder x harness from hibiscus repo, add blank dish plate, add multiplier callout to touchscreen cover
    [PP-FP0174_touchscreen_cover_v1.fcstd, PP-FP0174touchscreen_cover_v1.stl, blank_dish_plate.fcstd, blank_dish_plate.step, touchscreen_center_v1.1.fcstd, touchscreen_center_v1.1.stl]
2019-06-07 updated tool head for rigidity
    [carriage.step, carriage_path1.fcstd, collar_mount_flange.fcstd, collar_mount_flange.step, collar_mount_flange_path1.fcstd, collar_mount_flange_path2.fcstd, cover_v2.fcstd, cover_v2.stl]
2019-06-10 Remove multiple versions of parts fix blank dish plate pdf update usb harness to use new libraries
    [35mm_dish.fcstd, 35mm_dish.stl, PP-FP0174_touchscreen_cover.fcstd, PP-FP0174_touchscreen_cover.step, PP-FP0174touchscreen_cover.stl, PP-FP0174touchscreen_cover_v1.stl, PP-MP0272_touchscreen_cover_machined.fcstd, PP-MP0272_touchscreen_cover_machined.step]
2019-06-13 updated tool head for rigity, updated tool head BOM, updated assem
    [Lower_bearing_holder.fcstd, carriage.fcstd, collar_mount_flange.fcstd, cover.fcstd, cover.stl, extruder_mount.fcstd, extruder_mount.stl, motor_mount_v2.fcstd]
2019-06-13 updated tool head milled part drawings w/ part numbers
    [HD-RD0077_90mm_guide_rod.fcstd, Lower_bearing_holder.fcstd, PP-MP0277_upper_bearing_holder.fcstd, PP-MP0278_lower_bearing_holder.fcstd, PP-MP0279_motor_mount.fcstd, PP-MP0280_collar_mount_flange.fcstd, PP-MP0281_carriage.fcstd, carriage.fcstd]
2019-06-13 added step files for tool head milled parts
    [PP-MP0277_upper_bearing_holder.step, PP-MP0278_lower_bearing_holder.step, PP-MP0279_motor_mount.step, PP-MP0280_collar_mount_flange.step, PP-MP0281_carriage.step]
2019-06-17 Add preliminary BOM
    [BoM.ods]
2019-06-18 Add blank dish plate and svg files for artwork
    [PP-FP00185_blank_dish_plate.step, PP-FP0185_blank_dish_plate.fcstd, blank_dish_plate.fcstd]
2019-06-18 Add pdf and silk screen for electronics chassis to directory
    [electronics-case-mini-white_PP-FP0167.fcstd]
2019-06-28 Add material callout T8380
    [bottom-plate-mini-white_PP-MP0258.fcstd, bottom-plate-mini-white_PP-MP0258_revA.fcstd]
2019-06-28 Clarify location of supplier mark callout on electronics case T8379
    [electronics-case-mini-white_PP-FP0167.fcstd, electronics-case-mini-white_PP-FP0167_revB.fcstd]
2019-06-28 Add silk graphic to all pages and clarify supplier mark location T8379
    [bed-mount-plate-mini-white_PP-FP0171.fcstd, bed-mount-plate-mini-white_PP-FP0171_revA.fcstd]
2019-07-01 updated cable cover
    [cable_cover.fcstd, cable_cover.stl]
2019-07-01 updated bom
    [BoM.ods]
2019-07-02 Change touchscreen cover from v1 to rev a add rev notes to drawing
    [PP-FP0174_touchscreen_cover_revA.fcstd, PP-FP0174_touchscreen_cover_v1.fcstd]
2019-07-02 Remove old initial bill of materials
    [BOM.csv]
2019-07-02 remove kpaw2 extruder harness
2019-07-03 added syringe pump cable harness drawing, updated BOM
    [BoM.ods]
2019-07-03 Make dashed lines solid on left side T8379
    [left-side-mini-white_PP-FP0170.fcstd, left-side-mini-white_PP-FP0170_revA.fcstd]
2019-07-03 updated bom P/N's, updated syringe pump harness P/N's, removed old bom
    [BoM.ods]
2019-07-08 Updated bed plate to have hot symbol per T8503
    [bed-mount-plate-mini-white_PP-FP0171.fcstd, bed-mount-plate-mini-white_PP-FP0171.step]
2019-07-08 Add flat bom for purchasing review T8465
    [BoM_7.8.19_purchasing_review.ods]
2019-07-09 Add caution hot symbol to bed mount plate, add caution symbols to the rear of the plate T8379
    [bed-mount-plate-mini-white_PP-FP0171.step, bed-mount-plate-mini-white_PP-FP0171_revA.fcstd, bed-mount-plate-mini-white_PP-FP0171_revB.fcstd]
2019-07-09 Switch gdt box to table reposition graphic fix titleblock typo for pdf export T8379
    [bed-mount-plate-mini-white_PP-FP0171_revB.fcstd]
2019-07-09 Shift supplier mark off masking location and make dashed lines solid T8379
    [left-side-mini-white_PP-FP0170_revA.fcstd]
2019-07-16 Generates initial production slice for PP-GP0453 Syringe Collar Mount T8459
    [Syringe_collar_mount.fcstd, syringe_collar_mount.stl]
2019-07-16 Generates initial production slice for PP-GP0459 USB mount T8463
2019-07-16 Generates initial production slice for PP-GP0457 Cable Cover T8461
    [cable_cover.fcstd, cable_cover.stl]
2019-07-16 Generates initial production slice for PP-GP0451 Extruder Mount T8457
    [extruder_mount_v2.fcstd, extruder_mount_v2.stl]
2019-07-16 Added printed parts, added machine assembly
    [1mmx20mm_dowel_pin.fcstd, 35mm_dish_v1.fcstd, 35mm_dish_v1.stl, 35mmx6_dish_plate.fcstd, 35mmx6_dish_plate.stl, 40mm_fan.fcstd, 40mm_fan.step, 50mm_blower.fcstd]
2019-07-17 Generates initial production slice for PP-GP0458 LCD touchscreen case T8462
2019-07-17 Generates initial production slice for PP-GP0452 Cover T8458
    [cover_v2.fcstd, cover_v2.stl]
2019-07-19 deleted unused insert assemblies
    [LCD_bracket_inserts.fcstd, LCD_case_inserts.fcstd, LCD_side_cable_bracket_inserts.fcstd, LCD_top_cable_bracket_inserts.fcstd, extruder_mount_inserts.fcstd]
2019-07-19 renamed extruder mount to syringe mount
    [extruder_mount_v2.fcstd, extruder_mount_v2.stl, syringe_pump_cover_v2.fcstd, syringe_pump_cover_v2.stl]
2019-07-19 renamed syringe pump parts, added insert assemblies, removed rear flange mount
    [Syringe_pump_mount_v2.fcstd, cover_v2.fcstd, cover_v2.stl, rear_flange_mount.fcstd, rear_flange_mount.stl, syringe_pump_cover_inserts.fcstd, syringe_pump_cover_v2.fcstd, syringe_pump_cover_v2.stl]
2019-07-19 Updated kangaroopaw assembly
2019-07-19 renamed cover directory to syringe pump cover
    [syringe_pump_cover_v2.fcstd, syringe_pump_cover_v2.stl]
2019-07-19 updated bed plate in full assembly to be white instead of black
    [kpaw_y_axis.fcstd]
2019-07-24 Generates initial production slice for PP-GP0454-455-456 Syringe Collar T8460
    [syringe_collar81420.stl, syringe_collar81520.stl, syringe_collar81620.stl, syringe_collar_81420.fcstd, syringe_collar_81520.fcstd, syringe_collar_81620.fcstd]
2019-07-25 Remove usb_mount printed part files T8790
    [usb_mount_v1.fcstd, usb_mount_v1.stl]
2019-07-29 Add sd harness update lcd harness with BoM
2019-08-07 Changed syringe pump carriage lead nut mount holes to M3 tapped
    [PP-MP0281_carriage.fcstd, PP-MP0281_carriage_revA.fcstd]
2019-08-07 thickened M3 insert side of syringe pump mount per T9463
    [Syringe_pump_mount_v2.1.fcstd, Syringe_pump_mount_v2.fcstd, syringe_pump_mount_v2.1.stl, syringe_pump_mount_v2.stl]
2019-08-07 updated motor mount drawing for T9473
    [PP-MP0279_motor_mount.fcstd, PP-MP0279_motor_mount_revA.fcstd]
2019-08-07 added PDF of syringe pump harness
2019-08-07 Add slots to first layer of PP-GP0451 Syringe pump mount v2.2 T8953 T9463
    [Syringe_pump_mount_v2.1.fcstd, Syringe_pump_mount_v2.2.fcstd, syringe_pump_mount_v2.1.stl, syringe_pump_mount_v2.2.stl]
2019-08-07 updated syringe pump harness drawing to include BOM
2019-08-07 Updates production slice for PP-GP0451 Syringe Pump Mount v2.2 T9463 T8953
2019-08-09 Added printability slits on PP-GP0460 for ticket T8953
    [touchscreen_center_v1.1.fcstd, touchscreen_center_v1.1.stl, touchscreen_center_v1.2.fcstd, touchscreen_center_v1.2.stl]
2019-08-09 Added printability slits to PP-GP0458_touchscreen_case_v1.4 T8953
    [touchscreen_case_v1.3.fcstd, touchscreen_case_v1.3.stl, touchscreen_case_v1.4.fcstd, touchscreen_case_v1.4.stl]
2019-08-12 Change name to touchscreen bezel update material to pvc
    [PP-FP0174_touchscreen_bezel.step, PP-FP0174_touchscreen_bezel_revB.fcstd, PP-FP0174_touchscreen_cover_revA.fcstd]
2019-08-12 Remove lcd ground harness
2019-08-13 Add dxf of touchscreen bezel
    [PP-FP0174_touchscreen_bezel.dxf]
2019-08-15 updated syringe pump carriage drawing to remove sharp internal corners
    [PP-MP0281_carriage.step, PP-MP0281_carriage_revA.fcstd, PP-MP0281_carriage_revB.fcstd, PP-MP0281_carriage_revB.step]
2019-08-15 Updated X/Y steps/mm to 100.6 per T9664 also updated step file with v1.4 T8953
    [touchscreen_case.step]
2019-08-19 Add printability features to sd card and created new slice T9692
    [sd_mount.fcstd, sd_mount.stl]
2019-08-20 Corrected sd mount gcode with new part number T9692
2019-08-26 updated ebom with part number for the M2.5x14mm SHCS T9472
    [BoM.ods]
2019-08-26 Added spacer for the pump motor T9827
    [pump-motor.fcstd, pump-motor.stl]
2019-08-26 Updated syringe pump milled parts internal sharp corners to radii
    [PP-MP0279_motor_mount.step, PP-MP0279_motor_mount_revA.fcstd, PP-MP0279_motor_mount_revB.fcstd, PP-MP0280_collar_mount_flange.fcstd, PP-MP0280_collar_mount_flange.step, PP-MP0280_collar_mount_flange_revA.fcstd]
2019-08-27 Updated bom with HD-BT0258 thumbscrew part number
    [BoM.ods]
2019-08-28 Added files for the x-belt adjustable tensioner T8767
    [adjustable-Belt_tensioner_v2.1.fcstd, adjustable-Belt_tensioner_v2.1.stl, adjustable-Belt_tensioner_v2.2.fcstd, adjustable-Belt_tensioner_v2.2.stl, adjustable-belt_tensioner_v3.fcstd, adjustable-belt_tensioner_v3.stl, mini2_x-belt_mount_v0.6.fcstd, mini2_x-belt_mount_v0.6.stl]
2019-08-29 Added alpha testing print files
    [Elliptical_calibration_window.STL, Perfusion_Tube.stl]
2019-09-03 Clean up old files for X/Y belt tensioners update T8767
    [adjustable-Belt_tensioner_v2.1.fcstd, adjustable-Belt_tensioner_v2.1.stl, adjustable-belt_tensioner_v3.fcstd, adjustable-belt_tensioner_v3.stl, belt-clamp-mini_black_v1.2.fcstd, belt-clamp-mini_black_v1.2.stl, belt-mount_black_v1.2.fcstd, belt-mount_black_v1.2.stl]
2019-09-03 Added 30 micrometres to bottom face of PP-GP0351 adjustable belt tensioner for printability and add test slice for v2.3 T8767
    [adjustable-Belt_tensioner_v2.2.fcstd, adjustable-Belt_tensioner_v2.2.stl, adjustable-belt-tensioner_v2.3.fcstd, adjustable-belt-tensioner_v2.3.stl]
2019-09-03 Add test slice for PP-GP0349 x-belt-mount v0.6 T8767 T9933
2019-09-03 Added 10ml BD disposable syringe adapter printed parts
    [Syringe_Collar_10ml_BD.fcstd, Syringe_Collar_10ml_BD.stl, syringe_plunger_coupler_10ml_BD.fcstd, syringe_plunger_coupler_10ml_BD.stl, syringe_plunger_coupler_lock_10ml_BD.fcstd, syringe_plunger_coupler_lock_10ml_BD.stl]
2019-09-03 Add test slice for PP-GP0350 y-belt-mount v6.1 T8767 T9934
2019-09-03 Updated sd mount gcode with correct part number T9683
2019-09-04 Remove rev B add rev c with page 4 and 5 exported as svg then to pdf to prevent screen image distortion T9938
    [electronics-case-mini-white_PP-FP0167_revB.fcstd, electronics-case-mini-white_PP-FP0167_revC.fcstd]
2019-09-04 Added source files for Syringe Pump Test Stand T9855
    [225mm-extrusion.fcstd, assembly.fcstd, bottom-left-corner.fcstd, bottom-left-corner.stl, bottom-right-corner.fcstd, bottom-right-corner.stl, electronics-case.fcstd, left-side-mini.fcstd]
2019-09-06 added disposable syringe coupler insert drawing
    [Syringe_plunger_coupler_10mL_BD_inserts.fcstd]
2019-09-06 Adds production gcode for PP-GP0474 Syringe plunger coupler 10ml BD T9935 T9962
2019-09-06 Adds production gcode for PP-GP0475 Syringe plunger coupler lock 10ml BD T9935 T9962
2019-09-06 Added missed part of gcode naming structure for PP-GP0474 Sryinge plunger coupler 10ml BD T9935 T9962
2019-09-09 Added new bed corner for new SAE standoffs
    [bed_corner_mini_2pb_v2.fcstd, bed_corner_mini_2pb_v2.stl, bed_corner_v2.2.4.fcstd, bed_corner_v2.2.4.stl]
2019-09-09 Adds production gcode for PP-GP0476 Syringe Collar 10ml BD with support T9935 T9962
2019-09-09 Added missed machine designation in gcode naming structure for PP-GP0476 Syringe Collar 10ml BD w/ Support T9935 T9962
2019-09-10 updated PP-MP0281 carriage drawing to remove press fit bushing
    [PP-MP0281_carriage_revB.fcstd, PP-MP0281_carriage_revC.fcstd, PP-MP0281_carriage_revC.step]
2019-09-10 Added missing pdf's of cable drawings
2019-09-10 Revert "updated PP-MP0281 carriage drawing to remove press fit bushing" T9479
    This reverts commit 5a380e12ba1d902afc38efe82e8293afc23062e2.
    [PP-MP0281_carriage_revB.fcstd, PP-MP0281_carriage_revB.step, PP-MP0281_carriage_revC.fcstd]
2019-09-11 Make press fit tolerance reasonable and fix typo TRHU to THRU T9479
    [PP-MP0281_carriage_revC.fcstd, PP-MP0281_carriage_revD.fcstd, PP-MP0281_carriage_revD.step]
2019-09-13 Removes TEST prefix from gcode for PP-GP0351 Adjustable Belt Tensioner v2.3 T8767 T9932
2019-09-13 Removes TEST prefix from PP-GP0350 Y Belt Mount v6.1 T8767 T9934
2019-09-13 Removes TEST prefix from gcode file for PP-GP0349 X Belt Mount v0.6 T8767 T9933
2019-09-13 Adds production gcode for PP-GP0477 Bed Corner v2.2.4 T9997 T9909 T9947 T9962
2019-09-16 T10076: Change depth of lcd pocket from 5.5 to 5.85 on touchscreen center
    [touchscreen_center_v1.2.fcstd, touchscreen_center_v1.2.stl, touchscreen_center_v1.3.fcstd, touchscreen_center_v1.3.stl]
2019-09-16 T10076: Change overall thickness from 9 to 8.6mm touchscreen center
    [touchscreen_center_v1.3.1.fcstd, touchscreen_center_v1.3.1.stl, touchscreen_center_v1.3.fcstd, touchscreen_center_v1.3.stl]
2019-09-19 Make standoffs on touchscreen case shorted to allow thicker touchscreen center
    [touchscreen_case.step, touchscreen_case_v1.4.fcstd, touchscreen_case_v1.4.stl, touchscreen_case_v1.5.fcstd, touchscreen_case_v1.5.stl, touchscreen_center_v1.3.1.fcstd, touchscreen_center_v1.3.1.stl, touchscreen_center_v1.3.2.fcstd]
2019-09-19 Adds jig for assembling syringe pump lead screw with arbor press T10005
    [lead-screw-assembly-jig.stl]
2019-09-20 Adds Touchscreen Center v1.3.4; has cut out for polycarb cover with tolerance all around for proper fit T10076
    [touchscreen_center_v1.3.2.fcstd, touchscreen_center_v1.3.2.stl, touchscreen_center_v1.3.4.fcstd, touchscreen_center_v1.3.4.stl]
2019-09-23 Remove TEST prefix from production gcode for PP-GP0458 Touchscreen Case v1.5 T10076 T10123
2019-09-23 T10076: Update polycarb LCD cover PP-FP0183 to revA; tolerances decreased to 0.25mm
    [PP-FP0183_polycarb_LCD_cover.fcstd, PP-FP0183_polycarb_LCD_cover_revA.fcstd]
2019-09-24 Remove anodizing callout T10170
    [PP-MP0281_carriage_revD.fcstd, PP-MP0281_carriage_revE.fcstd, PP-MP0281_carriage_revE.step]
2019-09-26 Updates production gcodes for PP-GP0454-455-456 Syringe Collar 81420,81520,81620 T8460 T10114
    [syringe_collar81620.stl, syringe_collar_81620.fcstd]
2019-09-26 added syringe collar and collar mount go no-go gauges
    [81420_flange.FCStd, 81420_flange.step, 81420_flange_path1.FCStd, 81420_flange_path2.FCStd, 81520_flange.FCStd, 81520_flange.step, 81520_flange_path1.FCStd, 81520_flange_path2.FCStd]
2019-09-27 Add perfusion test print models
    [artery_small_perfusion_test.stl]
2019-09-27 T10224: Change note 5 to specify blue silk screen not silver
    [electronics-case-mini-white_PP-FP0167_revC.fcstd, electronics-case-mini-white_PP-FP0167_revD.fcstd]
2019-10-07 added x and y belt tensioner inserts
    [belt_mount_inserts.fcstd, x_belt_mount_inserts.fcstd, x_belt_tensioner_inserts.fcstd, y_belt_mount_inserts.fcstd]
2019-10-07 T10293: added updated syringe collars for 2.5mL and 5mL syringes
    [81420_collar.stl, 81420_lock.FCStd, 81420_lock.stl, 81520_collar.stl, 81520_lock.FCStd, 81520_lock.stl, syringe_collar81420.stl, syringe_collar81520.stl]
